Niccc8/rvbl2-riscv-cpu-core/chipinventor/NETLIST.md

# Wiring checklist - Stage 3

GENERATED by `scripts/gen_docs.py` from `ci_top.v` and `blocks/*.v` - do not hand-edit.

Two canvas projects. `rvbl2_soc` is the core, data memory and peripherals, built on a **copy** of the graded Phase 2 project and then placed as IP inside `top`, the chip. `scripts/check_export.py` audits the export of `top` against this document's source, wire by wire.

## Before you start

- **Copy the graded Phase 2 project first** and make every change on the copy. The platform keeps no version history.
- Name the SoC project exactly **`rvbl2_soc`**: the export names its module after the project, and both the checker and the FPGA wrapper expect that name.
- The canvas **cannot slice a bus** and **cannot draw a constant**. That is why `address_decoder` has `periph_chain_o` (a constant zero to start the read-back chain) and why `gpio_bits` exists.
- **Inout Pins: C is the data, D is the enable.** The platform writes `assign pin = D ? C : 1'bZ;`. Wire `gpio_bits.cN_o` to **C**, `gpio_bits.dN_o` to **D**, and the pin's right-hand terminal to `gpio_bits.pN_i`. A swap still compiles, so the checker tests it explicitly.
- `lsu`'s port names still read backwards: `mem_data_o` is an input, `core_data_i` an output.
- `rx_i` must idle high on the real chip; the testbench holds it high.

# Project 1: `rvbl2_soc`

## From the Phase 2 copy, in order

1. Delete the `imem` instance (its 3 wires go with it).
2. Create the new `address_decoder` block (BLOCK_METADATA.md: the Stage 3 Code and all 14 ports, 4 of them new), delete the old `u_decoder` instance (its wires go with it) and place the new block as `u_decoder`. Every wire on it is in the list below.
3. Create the blocks `gpio` and `uart` (BLOCK_METADATA.md) and place one of each. On the `uart` instance set **`CLK_FREQ_HZ = 30303030`**; leave every other parameter blank.
4. Add the pins: `imem_addr_o[31:0]` (output), `imem_oe_o` (output), `imem_rdata_i[31:0]` (input), `gpio_o[7:0]` (output), `gpio_oe[7:0]` (output), `gpio_i[7:0]` (input), `tx_o` (output), `rx_i` (input).
5. Draw the 33 connections below: the Stage 3 wires and every wire on `u_decoder`. Everything else stays as it was.

### The 33 connections to draw

| # | Net | Width | From | To |
|---:|---|---|---|---|
| 1 | `clk_i` | 1 bit | pin `clk_i` | `u_gpio.clk_i` |
| 2 | `clk_i` | 1 bit | pin `clk_i` | `u_uart.clk_i` |
| 3 | `core_address` | [31:0] | `u_muxaddr.z` | pin `imem_addr_o` |
| 4 | `core_address` | [31:0] | `u_muxaddr.z` | `u_decoder.address_i` |
| 5 | `core_address` | [31:0] | `u_muxaddr.z` | `u_gpio.bus_addr_i` |
| 6 | `core_address` | [31:0] | `u_muxaddr.z` | `u_uart.bus_addr_i` |
| 7 | `core_bw` | [3:0] | `u_lsu.byte_write_o` | `u_decoder.bw_i` |
| 8 | `core_oe` | 1 bit | `u_ctrl.oe_o` | `u_decoder.oe_i` |
| 9 | `core_store_data` | [31:0] | `u_lsu.store_data_o` | `u_gpio.bus_wdata_i` |
| 10 | `core_store_data` | [31:0] | `u_lsu.store_data_o` | `u_uart.bus_wdata_i` |
| 11 | `core_we` | 1 bit | `u_ctrl.we_o` | `u_decoder.we_i` |
| 12 | `dmem_bw` | [3:0] | `u_decoder.dmem_bw_o` | `u_dmem.bw_i` |
| 13 | `dmem_oe` | 1 bit | `u_decoder.dmem_oe_o` | `u_dmem.oe_i` |
| 14 | `dmem_rdata` | [31:0] | `u_dmem.data_o` | `u_decoder.dmem_rdata` |
| 15 | `dmem_we` | 1 bit | `u_decoder.dmem_we_o` | `u_dmem.we_i` |
| 16 | `gpio_i` | [7:0] | pin `gpio_i` | `u_gpio.gpio_i` |
| 17 | `gpio_o` | [7:0] | `u_gpio.gpio_o` | pin `gpio_o` |
| 18 | `gpio_oe` | [7:0] | `u_gpio.gpio_oe` | pin `gpio_oe` |
| 19 | `gpio_rdata` | [31:0] | `u_gpio.bus_rdata_o` | `u_uart.bus_rdata_i` |
| 20 | `imem_oe_o` | 1 bit | `u_decoder.imem_oe_o` | pin `imem_oe_o` |
| 21 | `imem_rdata_i` | [31:0] | pin `imem_rdata_i` | `u_decoder.imem_rdata` |
| 22 | `mem_rdata_muxed` | [31:0] | `u_decoder.data_o` | `u_ir.imem_data` |
| 23 | `mem_rdata_muxed` | [31:0] | `u_decoder.data_o` | `u_lsu.mem_data_o` |
| 24 | `periph_bw` | [3:0] | `u_decoder.periph_bw_o` | `u_gpio.bus_bw_i` |
| 25 | `periph_bw` | [3:0] | `u_decoder.periph_bw_o` | `u_uart.bus_bw_i` |
| 26 | `periph_chain_head` | [31:0] | `u_decoder.periph_chain_o` | `u_gpio.bus_rdata_i` |
| 27 | `periph_we` | 1 bit | `u_decoder.periph_we_o` | `u_gpio.bus_we_i` |
| 28 | `periph_we` | 1 bit | `u_decoder.periph_we_o` | `u_uart.bus_we_i` |
| 29 | `rst_i` | 1 bit | pin `rst_i` | `u_gpio.rst_i` |
| 30 | `rst_i` | 1 bit | pin `rst_i` | `u_uart.rst_i` |
| 31 | `rx_i` | 1 bit | pin `rx_i` | `u_uart.rx_i` |
| 32 | `tx_o` | 1 bit | `u_uart.tx_o` | pin `tx_o` |
| 33 | `uart_rdata` | [31:0] | `u_uart.bus_rdata_o` | `u_decoder.periph_rdata_i` |

### The whole project, for checking

## Block instances (21)

| Instance | Block | Parameters on the instance | Role |
|---|---|---|---|
| `u_ctrl` | `control_unit` | - | control FSM |
| `u_pc` | `pc_reg` | - | program counter |
| `u_pcinc` | `pc_incrementer` | - | PC+4 adder |
| `u_ir` | `ir_reg` | - | instruction register |
| `u_irf` | `ir_fields` | - | instruction field extractor |
| `u_imm` | `immediate_generator` | - | immediate generator |
| `u_rf` | `register_file` | - | register file |
| `u_muxa` | `mux2_32` | - | ALU operand A select (rs1 vs PC) |
| `u_muxb` | `mux2_32` | - | ALU operand B select (rs2 vs immediate) |
| `u_alu` | `alu` | - | arithmetic/logic unit |
| `u_bc` | `branch_comparator` | - | branch comparator |
| `u_mul` | `multiplier` | - | multiplier |
| `u_crc` | `crc_unit` | - | CRC unit |
| `u_lsu` | `lsu` | - | load/store unit |
| `u_wbmux` | `wb_mux_32` | - | writeback source select |
| `u_muxaddr` | `mux2_32` | - | memory address select (PC vs ALU result) |
| `u_muxpc` | `mux2_32` | - | next-PC select (PC+4 vs branch/jump target) |
| `u_decoder` | `address_decoder` | - | address decoder |
| `u_dmem` | `dmem` | DMEM_WORDS = 2048 | data memory |
| `u_gpio` | `gpio` (new) | - | GPIO controller, slot 0 (0xF0000000) |
| `u_uart` | `uart` (new) | CLK_FREQ_HZ = 30303030 | UART controller, slot 1 (0xF1000000) |

## Pins (10)

| Pin | Direction | Width |
|---|---|---|
| `clk_i` | input | 1 bit |
| `rst_i` | input | 1 bit |
| `imem_addr_o` | output | [31:0] |
| `imem_oe_o` | output | 1 bit |
| `imem_rdata_i` | input | [31:0] |
| `gpio_o` | output | [7:0] |
| `gpio_oe` | output | [7:0] |
| `gpio_i` | input | [7:0] |
| `tx_o` | output | 1 bit |
| `rx_i` | input | 1 bit |

## Wires (92 connections)

One row per connection: drag from the source to the destination.

| # | Net | Width | From | To |
|---:|---|---|---|---|
| 1 | `addr_src_sel` | 1 bit | `u_ctrl.addr_src_sel` | `u_muxaddr.s` |
| 2 | `alu_a` | [31:0] | `u_muxa.z` | `u_alu.a` |
| 3 | `alu_b` | [31:0] | `u_muxb.z` | `u_alu.b` |
| 4 | `alu_op` | [3:0] | `u_ctrl.alu_op` | `u_alu.alu_op` |
| 5 | `alu_result` | [31:0] | `u_alu.result` | `u_lsu.alu_result` |
| 6 | `alu_result` | [31:0] | `u_alu.result` | `u_muxaddr.b` |
| 7 | `alu_result` | [31:0] | `u_alu.result` | `u_muxpc.b` |
| 8 | `alu_result` | [31:0] | `u_alu.result` | `u_wbmux.alu_result` |
| 9 | `alu_src_a_sel` | 1 bit | `u_ctrl.alu_src_a_sel` | `u_muxa.s` |
| 10 | `alu_src_b_sel` | 1 bit | `u_ctrl.alu_src_b_sel` | `u_muxb.s` |
| 11 | `branch_taken` | 1 bit | `u_bc.branch_taken` | `u_ctrl.branch_taken` |
| 12 | `clk_i` | 1 bit | pin `clk_i` | `u_ctrl.clk_i` |
| 13 | `clk_i` | 1 bit | pin `clk_i` | `u_dmem.clk_i` |
| 14 | `clk_i` | 1 bit | pin `clk_i` | `u_gpio.clk_i` |
| 15 | `clk_i` | 1 bit | pin `clk_i` | `u_ir.clk_i` |
| 16 | `clk_i` | 1 bit | pin `clk_i` | `u_pc.clk_i` |
| 17 | `clk_i` | 1 bit | pin `clk_i` | `u_rf.clk_i` |
| 18 | `clk_i` | 1 bit | pin `clk_i` | `u_uart.clk_i` |
| 19 | `core_address` | [31:0] | `u_muxaddr.z` | pin `imem_addr_o` |
| 20 | `core_address` | [31:0] | `u_muxaddr.z` | `u_decoder.address_i` |
| 21 | `core_address` | [31:0] | `u_muxaddr.z` | `u_dmem.address_i` |
| 22 | `core_address` | [31:0] | `u_muxaddr.z` | `u_gpio.bus_addr_i` |
| 23 | `core_address` | [31:0] | `u_muxaddr.z` | `u_uart.bus_addr_i` |
| 24 | `core_bw` | [3:0] | `u_lsu.byte_write_o` | `u_decoder.bw_i` |
| 25 | `core_oe` | 1 bit | `u_ctrl.oe_o` | `u_decoder.oe_i` |
| 26 | `core_store_data` | [31:0] | `u_lsu.store_data_o` | `u_dmem.data_i` |
| 27 | `core_store_data` | [31:0] | `u_lsu.store_data_o` | `u_gpio.bus_wdata_i` |
| 28 | `core_store_data` | [31:0] | `u_lsu.store_data_o` | `u_uart.bus_wdata_i` |
| 29 | `core_we` | 1 bit | `u_ctrl.we_o` | `u_decoder.we_i` |
| 30 | `crc_result` | [31:0] | `u_crc.result` | `u_wbmux.crc_result` |
| 31 | `dmem_bw` | [3:0] | `u_decoder.dmem_bw_o` | `u_dmem.bw_i` |
| 32 | `dmem_oe` | 1 bit | `u_decoder.dmem_oe_o` | `u_dmem.oe_i` |
| 33 | `dmem_rdata` | [31:0] | `u_dmem.data_o` | `u_decoder.dmem_rdata` |
| 34 | `dmem_we` | 1 bit | `u_decoder.dmem_we_o` | `u_dmem.we_i` |
| 35 | `gpio_i` | [7:0] | pin `gpio_i` | `u_gpio.gpio_i` |
| 36 | `gpio_o` | [7:0] | `u_gpio.gpio_o` | pin `gpio_o` |
| 37 | `gpio_oe` | [7:0] | `u_gpio.gpio_oe` | pin `gpio_oe` |
| 38 | `gpio_rdata` | [31:0] | `u_gpio.bus_rdata_o` | `u_uart.bus_rdata_i` |
| 39 | `imem_oe_o` | 1 bit | `u_decoder.imem_oe_o` | pin `imem_oe_o` |
| 40 | `imem_rdata_i` | [31:0] | pin `imem_rdata_i` | `u_decoder.imem_rdata` |
| 41 | `imm` | [31:0] | `u_imm.imm` | `u_muxb.b` |
| 42 | `ir` | [31:0] | `u_ir.ir` | `u_ctrl.ir` |
| 43 | `ir` | [31:0] | `u_ir.ir` | `u_imm.ir` |
| 44 | `ir` | [31:0] | `u_ir.ir` | `u_irf.ir` |
| 45 | `ir_write` | 1 bit | `u_ctrl.ir_write` | `u_ir.ir_write` |
| 46 | `is_valid_store` | 1 bit | `u_ctrl.is_valid_store` | `u_lsu.is_valid_store` |
| 47 | `lsu_load_data` | [31:0] | `u_lsu.core_data_i` | `u_wbmux.lsu_load_data` |
| 48 | `mem_rdata_muxed` | [31:0] | `u_decoder.data_o` | `u_ir.imem_data` |
| 49 | `mem_rdata_muxed` | [31:0] | `u_decoder.data_o` | `u_lsu.mem_data_o` |
| 50 | `mult_result` | [31:0] | `u_mul.result` | `u_wbmux.mult_result` |
| 51 | `op_size` | [2:0] | `u_ctrl.op_size` | `u_bc.funct3` |
| 52 | `op_size` | [2:0] | `u_ctrl.op_size` | `u_crc.funct3` |
| 53 | `op_size` | [2:0] | `u_ctrl.op_size` | `u_lsu.op_size` |
| 54 | `op_size` | [2:0] | `u_ctrl.op_size` | `u_mul.funct3` |
| 55 | `pc` | [31:0] | `u_pc.pc` | `u_muxa.b` |
| 56 | `pc` | [31:0] | `u_pc.pc` | `u_muxaddr.a` |
| 57 | `pc` | [31:0] | `u_pc.pc` | `u_pcinc.pc` |
| 58 | `pc_next` | [31:0] | `u_muxpc.z` | `u_pc.pc_next` |
| 59 | `pc_plus_4` | [31:0] | `u_pcinc.pc_plus_4` | `u_muxpc.a` |
| 60 | `pc_plus_4` | [31:0] | `u_pcinc.pc_plus_4` | `u_wbmux.pc_plus_4` |
| 61 | `pc_src_sel` | 1 bit | `u_ctrl.pc_src_sel` | `u_muxpc.s` |
| 62 | `pc_write` | 1 bit | `u_ctrl.pc_write` | `u_pc.pc_write` |
| 63 | `periph_bw` | [3:0] | `u_decoder.periph_bw_o` | `u_gpio.bus_bw_i` |
| 64 | `periph_bw` | [3:0] | `u_decoder.periph_bw_o` | `u_uart.bus_bw_i` |
| 65 | `periph_chain_head` | [31:0] | `u_decoder.periph_chain_o` | `u_gpio.bus_rdata_i` |
| 66 | `periph_we` | 1 bit | `u_decoder.periph_we_o` | `u_gpio.bus_we_i` |
| 67 | `periph_we` | 1 bit | `u_decoder.periph_we_o` | `u_uart.bus_we_i` |
| 68 | `rd_addr` | [4:0] | `u_irf.rd_addr` | `u_rf.rd_addr` |
| 69 | `reg_write` | 1 bit | `u_ctrl.reg_write` | `u_rf.reg_write` |
| 70 | `rs1_addr` | [4:0] | `u_irf.rs1_addr` | `u_rf.rs1_addr` |
| 71 | `rs1_data` | [31:0] | `u_rf.rs1_data` | `u_bc.rs1_data` |
| 72 | `rs1_data` | [31:0] | `u_rf.rs1_data` | `u_crc.rs1_data` |
| 73 | `rs1_data` | [31:0] | `u_rf.rs1_data` | `u_mul.rs1_data` |
| 74 | `rs1_data` | [31:0] | `u_rf.rs1_data` | `u_muxa.a` |
| 75 | `rs2_addr` | [4:0] | `u_irf.rs2_addr` | `u_rf.rs2_addr` |
| 76 | `rs2_data` | [31:0] | `u_rf.rs2_data` | `u_bc.rs2_data` |
| 77 | `rs2_data` | [31:0] | `u_rf.rs2_data` | `u_crc.rs2_data` |
| 78 | `rs2_data` | [31:0] | `u_rf.rs2_data` | `u_lsu.rs2_data` |
| 79 | `rs2_data` | [31:0] | `u_rf.rs2_data` | `u_mul.rs2_data` |
| 80 | `rs2_data` | [31:0] | `u_rf.rs2_data` | `u_muxb.a` |
| 81 | `rst_i` | 1 bit | pin `rst_i` | `u_ctrl.rst_i` |
| 82 | `rst_i` | 1 bit | pin `rst_i` | `u_dmem.rst_i` |
| 83 | `rst_i` | 1 bit | pin `rst_i` | `u_gpio.rst_i` |
| 84 | `rst_i` | 1 bit | pin `rst_i` | `u_ir.rst_i` |
| 85 | `rst_i` | 1 bit | pin `rst_i` | `u_pc.rst_i` |
| 86 | `rst_i` | 1 bit | pin `rst_i` | `u_rf.rst_i` |
| 87 | `rst_i` | 1 bit | pin `rst_i` | `u_uart.rst_i` |
| 88 | `rx_i` | 1 bit | pin `rx_i` | `u_uart.rx_i` |
| 89 | `tx_o` | 1 bit | `u_uart.tx_o` | pin `tx_o` |
| 90 | `uart_rdata` | [31:0] | `u_uart.bus_rdata_o` | `u_decoder.periph_rdata_i` |
| 91 | `wb_data` | [31:0] | `u_wbmux.wb_data` | `u_rf.rd_data` |
| 92 | `wb_src_sel` | [2:0] | `u_ctrl.wb_src_sel` | `u_wbmux.wb_src_sel` |

Left unconnected on purpose (read by the testbench through the hierarchy): `u_ctrl.state_o`, `u_ctrl.sys_event_o`.

# Project 2: `top` (the chip)

A new project. Place `rvbl2_soc` (from the IP list), `imem` and `gpio_bits`. Add the pins below; `pins_io_0`..`pins_io_7` are **Inout Pins**, one per GPIO bit.

## Block instances (3)

| Instance | Block | Parameters on the instance | Role |
|---|---|---|---|
| `u_soc` | `rvbl2_soc` | - | the SoC project, placed as IP |
| `u_imem` | `imem` | - | instruction ROM |
| `u_bits` | `gpio_bits` (new) | - | GPIO bus-to-pin splitter |

## Pins (12)

| Pin | Direction | Width |
|---|---|---|
| `clk_i` | input | 1 bit |
| `rst_i` | input | 1 bit |
| `pins_io_0` | inout | 1 bit |
| `pins_io_1` | inout | 1 bit |
| `pins_io_2` | inout | 1 bit |
| `pins_io_3` | inout | 1 bit |
| `pins_io_4` | inout | 1 bit |
| `pins_io_5` | inout | 1 bit |
| `pins_io_6` | inout | 1 bit |
| `pins_io_7` | inout | 1 bit |
| `tx_o` | output | 1 bit |
| `rx_i` | input | 1 bit |

## Wires (34 connections)

One row per connection: drag from the source to the destination.

| # | Net | Width | From | To |
|---:|---|---|---|---|
| 1 | `c0` | 1 bit | `u_bits.c0_o` | pin `pins_io_0` **C** (data) |
| 2 | `c1` | 1 bit | `u_bits.c1_o` | pin `pins_io_1` **C** (data) |
| 3 | `c2` | 1 bit | `u_bits.c2_o` | pin `pins_io_2` **C** (data) |
| 4 | `c3` | 1 bit | `u_bits.c3_o` | pin `pins_io_3` **C** (data) |
| 5 | `c4` | 1 bit | `u_bits.c4_o` | pin `pins_io_4` **C** (data) |
| 6 | `c5` | 1 bit | `u_bits.c5_o` | pin `pins_io_5` **C** (data) |
| 7 | `c6` | 1 bit | `u_bits.c6_o` | pin `pins_io_6` **C** (data) |
| 8 | `c7` | 1 bit | `u_bits.c7_o` | pin `pins_io_7` **C** (data) |
| 9 | `clk_i` | 1 bit | pin `clk_i` | `u_soc.clk_i` |
| 10 | `d0` | 1 bit | `u_bits.d0_o` | pin `pins_io_0` **D** (enable) |
| 11 | `d1` | 1 bit | `u_bits.d1_o` | pin `pins_io_1` **D** (enable) |
| 12 | `d2` | 1 bit | `u_bits.d2_o` | pin `pins_io_2` **D** (enable) |
| 13 | `d3` | 1 bit | `u_bits.d3_o` | pin `pins_io_3` **D** (enable) |
| 14 | `d4` | 1 bit | `u_bits.d4_o` | pin `pins_io_4` **D** (enable) |
| 15 | `d5` | 1 bit | `u_bits.d5_o` | pin `pins_io_5` **D** (enable) |
| 16 | `d6` | 1 bit | `u_bits.d6_o` | pin `pins_io_6` **D** (enable) |
| 17 | `d7` | 1 bit | `u_bits.d7_o` | pin `pins_io_7` **D** (enable) |
| 18 | `gpio_i` | [7:0] | `u_bits.gpio_i` | `u_soc.gpio_i` |
| 19 | `gpio_o` | [7:0] | `u_soc.gpio_o` | `u_bits.gpio_o` |
| 20 | `gpio_oe` | [7:0] | `u_soc.gpio_oe` | `u_bits.gpio_oe` |
| 21 | `imem_addr` | [31:0] | `u_soc.imem_addr_o` | `u_imem.address_i` |
| 22 | `imem_oe` | 1 bit | `u_soc.imem_oe_o` | `u_imem.oe_i` |
| 23 | `imem_rdata` | [31:0] | `u_imem.data_o` | `u_soc.imem_rdata_i` |
| 24 | `pins_io_0` | 1 bit | pin `pins_io_0` | `u_bits.p0_i` |
| 25 | `pins_io_1` | 1 bit | pin `pins_io_1` | `u_bits.p1_i` |
| 26 | `pins_io_2` | 1 bit | pin `pins_io_2` | `u_bits.p2_i` |
| 27 | `pins_io_3` | 1 bit | pin `pins_io_3` | `u_bits.p3_i` |
| 28 | `pins_io_4` | 1 bit | pin `pins_io_4` | `u_bits.p4_i` |
| 29 | `pins_io_5` | 1 bit | pin `pins_io_5` | `u_bits.p5_i` |
| 30 | `pins_io_6` | 1 bit | pin `pins_io_6` | `u_bits.p6_i` |
| 31 | `pins_io_7` | 1 bit | pin `pins_io_7` | `u_bits.p7_i` |
| 32 | `rst_i` | 1 bit | pin `rst_i` | `u_soc.rst_i` |
| 33 | `rx_i` | 1 bit | pin `rx_i` | `u_soc.rx_i` |
| 34 | `tx_o` | 1 bit | `u_soc.tx_o` | pin `tx_o` |

## Totals

| | `rvbl2_soc` | `top` |
|---|---:|---:|
| Block instances | 21 | 3 |
| Pins | 10 | 12 |
| Connections | 92 | 34 |
| To draw in Stage 3 | 33 | 34 |
