Niccc8/rvbl2-riscv-cpu-core/docs/stage4/HANDOFF.md

# Stage 4 state (read this first in a new session)

**Updated 2026-10-15.** Branch `stage4` (local, not pushed). Mission: harden LaneX, build the pitch
intelligence, ship a first-try-correct AWS F2 build. **GATE 1 and 2 passed; GATE 3 verdict GO (re-confirmed
after the 31.25 MHz change: pre-flight GO, full regression green).**
**AWS build done 2026-10-10: `afi-0732c3cb90c96019a` / `agfi-0c12a9e5d082dcac8`** (0 errors; setup WNS −0.112 ns on
the pin-synchroniser crossing only, hold met; `06` §1b). **On the board: bring-up ladder and all 12 emu lines
PASS on the first build (`06` §1c).** Claim earned: "FPGA-validated prototype".
**DE10-Lite desk lane (Tier 1) built 2026-10-11** (`stage4/de10lite/`, start at its README): one HC-SR04
ultrasonic sensor (rescoped from two IR beams: the sensor Nicholas has), USB-UART + LaneX Live dashboard.
Verified in simulation (`06` §1d) and compiled in Quartus 25.1std.0 on Nicholas's laptop (0 errors, timing
met +4.44 ns at 31.25 MHz). **On the board (11 Oct): `Id.56dE` and `PASS12` work**; his flicker report fixed and
the board hardened (`06` §1d round 2: 1,291 simulated checks). Next: his bench procedure,
`stage4/de10lite/lab_brief.html` E1–E10 (also published: https://claude.ai/artifact/1geGwAnsMETUvzNhbt8Chj).
**15 Oct, round 3 (`06` §1d round 3):** at E5 his empty lane made 1.6 cm phantom vehicles (`no tAG`
over and over): the floor ratchet took a stray far echo as the floor. The lane now filters (median of 3),
learns the floor by agreement, arms only after seeing it, ignores lost (farther) echoes; a noisy
HC-SR04 model in `tb_board.v` (`G 1 seed`) reproduces the fault on the old RTL (23 phantoms in 94 s)
and none on the new. Also: GPIO9 = header pin 10 plays a 2.4 kHz tone for a **passive** buzzer (his
unmarked one: green board visible underneath); his TMB12A05 is **active** (pin 8). His USB-UART is a
Cytron UC00C (CH340): switch at 3.3 V, TXO → pin 1, RXI → pin 2, GND → pin 12. The dashboard is
`stage4/de10lite/lanex_live.html`; `dashboard/lanex_live.src.html` is the template (now says so).
**Never run `gen_de10lite.py` without `--check`: it rewrites `lanex.qsf`, which his Quartus has edited**;
write single outputs from `gen_de10lite.outputs()` instead.
**On the board (15 Oct): the whole desk lane works** - vehicle detection with the HC-SR04, the four lamps, the buzzer, and the USB-UART link to LaneX Live, which verifies every record (Nicholas, after round 3).
**Pitch material is local only (git-ignored, never pushed: the repository is public):** the Grand Final
deck `presentation/stage4/LaneX_Final.pptx` (rebuild: `scripts/stage4/pitch/build_all.ps1`), the script and
demo-day plan `docs/stage4/pitch/`, the market and event research `docs/stage4/03_market.md`,
`docs/stage4/research/`, `docs/stage4/roi_model.py`.

## Where everything is

| What | Where |
| --- | --- |
| AWS ground truth (guide PDF, organisers' `top.sv`, `emu.c`) | `01_aws_reference.md` |
| Audit, its approved scope and outcome | `02_audit.md` (§J outcome) |
| Market, event, ROI (local only) | `03_market.md`, `research/A–D`, `roi_model.py` |
| FPGA design (as built) | `04_fpga_plan.md` |
| **Runbook for the AWS session** | **`05_RUNBOOK.md`** |
| Verification evidence | `06_verification.md` |
| DE10-Lite desk lane (Tier 1) | `07_max10_prototype.md` (as built); **`stage4/de10lite/README.md`** (your steps, demo, troubleshooting) |
| Quartus Prime Lite install + programming guide | `08_quartus_setup.md` (installed: `C:\altera_lite\25.1std`, 25.1std.0) |
| Desk-lane generator, checks | `scripts/stage4/gen_de10lite.py` (`--check`), `stage4/de10lite/sim/check_board.py`, `stage4/de10lite/dashboard/test_live.py` |
| Pitch kit (local only) | `pitch/01–05` (Stage 4 planning); **final: `pitch/06_final_script.md`, `pitch/07_demo_day.md`, deck generator `scripts/stage4/pitch/`** |
| AWS run screenshots + recording (for slides) | `stage4/evidence/` (index in its README; the 270 MB recording and the unredacted screenshot are local only, git-excluded) |
| Build files | `stage4/riscv.sv` (31.25 MHz, the build), `riscv_15mhz.sv`, `riscv_bufgce_div.sv` (backups) |
| Generator, gate | `scripts/stage4/gen_riscv_sv.py`, `scripts/stage4/preflight.sh` |
| Organisers' files (not in git) | `stage4/vendor/` (fetch: `stage4/README.md`) |

## Decisions (and why)

- GATE 1: approved B1, B2, C1, C2, C3, C5(a) + all P0 (`02_audit.md`).
- GATE 2: MMCM divider inside `RISCV`, `top.sv` unchanged; build before 13 Oct; the organisers'
  echo test line need not pass on our firmware.
- Clock 31.25 MHz (÷8), Nicholas's preference and the ASIC's own clock; estimated path 11–18 ns of
  32 ns; 15.625 MHz kept as a pre-verified backup.
- DE10-Lite: one ultrasonic sensor over the lane classifies by height (car/lorry, `TALL_MM` 60 in
  `lanex.qsf`); its 5 V Echo goes through a 1k/2k divider. The fabric is test equipment only; the chip is
  generated by the AWS generator's own code (`gen_riscv_sv.chip_modules`, target `de10lite`).
- Firmware: the vehicle detector arms once the lane is seen empty (emu's start-up window floats
  pin 0; without this a pin read as 1 made phantom vehicles).

## Working rules learned the hard way

- Sessions end without warning: keep tool calls < ~5 min; launch long jobs with `nohup … &` on the
  Windows side (they survive); WSL jobs started from a background Git Bash also survive.
- `wsl.exe -- bash -lc "…"` re-parses the command in a shell: pass absolute paths, no `$VARS` meant
  for the inner shell. Git Bash heredocs mangle backslashes: write patch scripts with the Write tool.
- Never edit a running bash script (bash reads it incrementally).
- Commits: author Nicholas only, no co-author line; explicit paths; never push without asking.
- Tools: Windows — iverilog 12, xPack RISC-V GCC 13.2 (`~/tools`, `python3` shim in `~/tools/bin`);
  WSL Ubuntu-24.04 — Verilator 5.020, Yosys 0.33, gcc. **Quartus Prime Lite 25.1std.0 at
  `C:\altera_lite\25.1std`** (compile in a copy under `build/`, never program the board yourself). No Vivado.
- Board simulation: Verilator via `check_board.py` (Icarus is ~370x slower). The testbench's stimulus
  waits for events: start waiting before the event can happen (a missed record = TIMEOUT).

## Key facts not to re-derive

- `top.sv` gives `RISCV` `clk_main_a0` = 250 MHz; wrapper UARTs 2,170 clocks/bit; `riscv_nreset`
  resets to 1. emu: 50 ms before every AXI access; each run sets `-d 0x01`, pulses RST 1/0/1;
  `-d` uninverted (1 = chip output); `-t` polls `0x0C` bit 8 (sticky `o_Tx_Done`); `o_Rx_Done` a
  one-cycle pulse; `-r` reads the circular 8-byte window (the last 8 bytes); exit status inverted.
- Firmware 2,793 words; `I` record CRC `0x56DE`; PC range `0x00400000–0x00402BA4`.
- The ChipInventor platform export still holds the Stage 3 (v3) ROM (`chipinventor/app/imem_app_stage3.v`);
  `run_ci.sh` swaps the v4 ROM in for its tests.
