Niccc8/rvbl2-riscv-cpu-core/chipinventor/BLOCK_METADATA.md

# Block form fields

GENERATED by `scripts/gen_docs.py` from `blocks/*.v` - do not hand-edit.

One section per block, giving exactly what goes in each field of ChipInventor's Add Block
dialog. Paste the matching file from `blocks/` into the Code field; nothing in those files
needs editing or trimming first. Blocks marked **new** or **changed** are the Stage 3 work;
every other block is exactly as in the Phase 2 project.

Author and Icon are yours to set. Leave Validate, Block Width, Block Technology and the
two HDL-Specific fields empty unless the platform asks for them.

## `address_decoder` (changed)

```
Name:               address_decoder
Description:        Routes the memory transaction to IMEM, DMEM or the peripherals
Code:               paste blocks/address_decoder.v
Number of Inputs:   7
Inputs:             address_i[31:0], we_i, oe_i, bw_i[3:0], imem_rdata[31:0], dmem_rdata[31:0], periph_rdata_i[31:0]
Number of Outputs:  8
Outputs:            imem_oe_o, dmem_we_o, dmem_oe_o, dmem_bw_o[3:0], periph_we_o, periph_bw_o[3:0], periph_chain_o[31:0], data_o[31:0]
Number of Inouts:   0
Inouts:             (none)
Parameters:         (none)
```

Placed 1 time.

> **Changed in Stage 3:** four new ports for the peripheral region 0xF0000000-0xFFFFFFFF.
> Make it as a new block with these fields, replace the `u_decoder` instance, and redraw
> all of its wires (NETLIST.md lists them).

## `alu`

```
Name:               alu
Description:        Purely combinational ALU, 11 operations (Table 9)
Code:               paste blocks/alu.v
Number of Inputs:   3
Inputs:             a[31:0], b[31:0], alu_op[3:0]
Number of Outputs:  1
Outputs:            result[31:0]
Number of Inouts:   0
Inouts:             (none)
Parameters:         (none)
```

Placed 1 time.

## `branch_comparator`

```
Name:               branch_comparator
Description:        Evaluates the 6 RV32I branch conditions
Code:               paste blocks/branch_comparator.v
Number of Inputs:   3
Inputs:             rs1_data[31:0], rs2_data[31:0], funct3[2:0]
Number of Outputs:  1
Outputs:            branch_taken
Number of Inouts:   0
Inouts:             (none)
Parameters:         (none)
```

Placed 1 time.

## `control_unit`

```
Name:               control_unit
Description:        6-state FSM and every datapath control signal
Code:               paste blocks/control_unit.v
Number of Inputs:   4
Inputs:             clk_i, rst_i, ir[31:0], branch_taken
Number of Outputs:  15
Outputs:            state_o[2:0], alu_src_a_sel, alu_src_b_sel, alu_op[3:0], addr_src_sel, wb_src_sel[2:0], pc_src_sel, pc_write, reg_write, we_o, oe_o, ir_write, sys_event_o, is_valid_store, op_size[2:0]
Number of Inouts:   0
Inouts:             (none)
Parameters:         (none)
```

Placed 1 time.

## `crc_unit`

```
Name:               crc_unit
Description:        CRC-16/CCITT-FALSE over 8/16/32 bits (Xicrc, Table 11)
Code:               paste blocks/crc_unit.v
Number of Inputs:   3
Inputs:             rs1_data[31:0], rs2_data[31:0], funct3[2:0]
Number of Outputs:  1
Outputs:            result[31:0]
Number of Inouts:   0
Inouts:             (none)
Parameters:         (none)
```

Placed 1 time.

> **Operand order:** `rs1_data` is the **data**, `rs2_data` the **running CRC** - the order
> the official firmware uses. Do not swap the two wires.

## `dmem`

```
Name:               dmem
Description:        Data SRAM, synchronous read and byte-writable write
Code:               paste blocks/dmem.v
Number of Inputs:   7
Inputs:             clk_i, rst_i, address_i[31:0], we_i, oe_i, bw_i[3:0], data_i[31:0]
Number of Outputs:  1
Outputs:            data_o[31:0]
Number of Inouts:   0
Inouts:             (none)
Parameters:         DMEM_WORDS = 2048
```

Placed 1 time.

> `DMEM_WORDS` is the resize knob: 2048 is the full 8 kB. 1024 or 512 work with no other
> change: the block reads 0 and writes nothing above the instantiated array.

## `gpio` (new)

```
Name:               gpio
Description:        GPIO PIN controller: DATAOUT, DATAIN, DATADIR at 0xF0000000
Code:               paste blocks/gpio.v
Number of Inputs:   8
Inputs:             clk_i, rst_i, bus_addr_i[31:0], bus_wdata_i[31:0], bus_we_i, bus_bw_i[3:0], bus_rdata_i[31:0], gpio_i[7:0]
Number of Outputs:  3
Outputs:            bus_rdata_o[31:0], gpio_o[7:0], gpio_oe[7:0]
Number of Inouts:   0
Inouts:             (none)
Parameters:         SLOT = 4'd0, N_PINS = 8
```

Placed 1 time.

> Ports are written `[N_PINS-1:0]` in the code; with the default `N_PINS = 8` they are the
> 8-bit ports listed above. Leave `SLOT` and `N_PINS` blank on the instance.

## `gpio_bits` (new)

```
Name:               gpio_bits
Description:        Splits the GPIO buses into the 8 Inout Pins' C, D and pad bits
Code:               paste blocks/gpio_bits.v
Number of Inputs:   10
Inputs:             gpio_o[7:0], gpio_oe[7:0], p0_i, p1_i, p2_i, p3_i, p4_i, p5_i, p6_i, p7_i
Number of Outputs:  17
Outputs:            gpio_i[7:0], c0_o, d0_o, c1_o, d1_o, c2_o, d2_o, c3_o, d3_o, c4_o, d4_o, c5_o, d5_o, c6_o, d6_o, c7_o, d7_o
Number of Inouts:   0
Inouts:             (none)
Parameters:         (none)
```

Placed 1 time.

> Wiring only. For each pin N: `cN_o` -> the Inout Pin's **C**, `dN_o` -> its **D**,
> and the pin's right-hand terminal -> `pN_i`.

## `imem`

```
Name:               imem
Description:        Instruction/constant ROM, combinational read
Code:               paste blocks/imem.v
Number of Inputs:   2
Inputs:             address_i[31:0], oe_i
Number of Outputs:  1
Outputs:            data_o[31:0]
Number of Inouts:   0
Inouts:             (none)
Parameters:         (none)
```

Placed 1 time.

> Placed in `top`, not in the SoC. **For the OpenLane / P&R run, paste `blocks/imem_mock.v`
> into this same block instead** - same module name and ports, so only the Code field changes.

## `immediate_generator`

```
Name:               immediate_generator
Description:        Extracts and sign-extends I/S/B/U/J immediates
Code:               paste blocks/immediate_generator.v
Number of Inputs:   1
Inputs:             ir[31:0]
Number of Outputs:  1
Outputs:            imm[31:0]
Number of Inouts:   0
Inouts:             (none)
Parameters:         (none)
```

Placed 1 time.

## `ir_fields`

```
Name:               ir_fields
Description:        Extracts rs1/rs2/rd register addresses from the instruction
Code:               paste blocks/ir_fields.v
Number of Inputs:   1
Inputs:             ir[31:0]
Number of Outputs:  3
Outputs:            rs1_addr[4:0], rs2_addr[4:0], rd_addr[4:0]
Number of Inouts:   0
Inouts:             (none)
Parameters:         (none)
```

Placed 1 time.

## `ir_reg`

```
Name:               ir_reg
Description:        Instruction register, loaded once per instruction
Code:               paste blocks/ir_reg.v
Number of Inputs:   4
Inputs:             clk_i, rst_i, ir_write, imem_data[31:0]
Number of Outputs:  1
Outputs:            ir[31:0]
Number of Inouts:   0
Inouts:             (none)
Parameters:         (none)
```

Placed 1 time.

## `lsu`

```
Name:               lsu
Description:        Load/store unit: byte lanes, sign extension, write strobes
Code:               paste blocks/lsu.v
Number of Inputs:   5
Inputs:             alu_result[31:0], rs2_data[31:0], op_size[2:0], is_valid_store, mem_data_o[31:0]
Number of Outputs:  3
Outputs:            core_data_i[31:0], byte_write_o[3:0], store_data_o[31:0]
Number of Inouts:   0
Inouts:             (none)
Parameters:         (none)
```

Placed 1 time.

> **Careful:** `mem_data_o` is an **input** and `core_data_i` is an **output**. The names
> read backwards; the directions above are correct.

## `multiplier`

```
Name:               multiplier
Description:        MUL/MULH/MULHSU/MULHU, combinational (Zmmul, Table 10)
Code:               paste blocks/multiplier.v
Number of Inputs:   3
Inputs:             rs1_data[31:0], rs2_data[31:0], funct3[2:0]
Number of Outputs:  1
Outputs:            result[31:0]
Number of Inouts:   0
Inouts:             (none)
Parameters:         (none)
```

Placed 1 time.

## `mux2_32`

```
Name:               mux2_32
Description:        Generic 2-to-1 32-bit multiplexer
Code:               paste blocks/mux2_32.v
Number of Inputs:   3
Inputs:             a[31:0], b[31:0], s
Number of Outputs:  1
Outputs:            z[31:0]
Number of Inouts:   0
Inouts:             (none)
Parameters:         (none)
```

Placed 4 times.

## `pc_incrementer`

```
Name:               pc_incrementer
Description:        Dedicated PC+4 adder, separate from the ALU
Code:               paste blocks/pc_incrementer.v
Number of Inputs:   1
Inputs:             pc[31:0]
Number of Outputs:  1
Outputs:            pc_plus_4[31:0]
Number of Inouts:   0
Inouts:             (none)
Parameters:         (none)
```

Placed 1 time.

## `pc_reg`

```
Name:               pc_reg
Description:        Program counter, reset vector 0x00400000
Code:               paste blocks/pc_reg.v
Number of Inputs:   4
Inputs:             clk_i, rst_i, pc_write, pc_next[31:0]
Number of Outputs:  1
Outputs:            pc[31:0]
Number of Inouts:   0
Inouts:             (none)
Parameters:         (none)
```

Placed 1 time.

## `register_file`

```
Name:               register_file
Description:        32 x 32-bit GPRs, x0 hardwired zero, async read
Code:               paste blocks/register_file.v
Number of Inputs:   7
Inputs:             clk_i, rst_i, rs1_addr[4:0], rs2_addr[4:0], rd_addr[4:0], rd_data[31:0], reg_write
Number of Outputs:  2
Outputs:            rs1_data[31:0], rs2_data[31:0]
Number of Inouts:   0
Inouts:             (none)
Parameters:         (none)
```

Placed 1 time.

## `uart` (new)

```
Name:               uart
Description:        UART serial controller, 8-N-1, 115200 bps, at 0xF1000000
Code:               paste blocks/uart.v
Number of Inputs:   8
Inputs:             clk_i, rst_i, bus_addr_i[31:0], bus_wdata_i[31:0], bus_we_i, bus_bw_i[3:0], bus_rdata_i[31:0], rx_i
Number of Outputs:  2
Outputs:            bus_rdata_o[31:0], tx_o
Number of Inouts:   0
Inouts:             (none)
Parameters:         SLOT = 4'd1, CLK_FREQ_HZ = 30303030, BAUD_RATE = 115200
```

Placed 1 time.

> Set **`CLK_FREQ_HZ = 30303030`** on the instance (the 33 ns clock); leave `SLOT` and
> `BAUD_RATE` blank. The divisor is round(30303030 / 115200) = 263 clocks per bit.

## `wb_mux_32`

```
Name:               wb_mux_32
Description:        Writeback source multiplexer, 5 inputs
Code:               paste blocks/wb_mux_32.v
Number of Inputs:   6
Inputs:             alu_result[31:0], mult_result[31:0], crc_result[31:0], lsu_load_data[31:0], pc_plus_4[31:0], wb_src_sel[2:0]
Number of Outputs:  1
Outputs:            wb_data[31:0]
Number of Inouts:   0
Inouts:             (none)
Parameters:         (none)
```

Placed 1 time.
