Niccc8/rvbl2-riscv-cpu-core/report-stage2/figures/ci_run.png

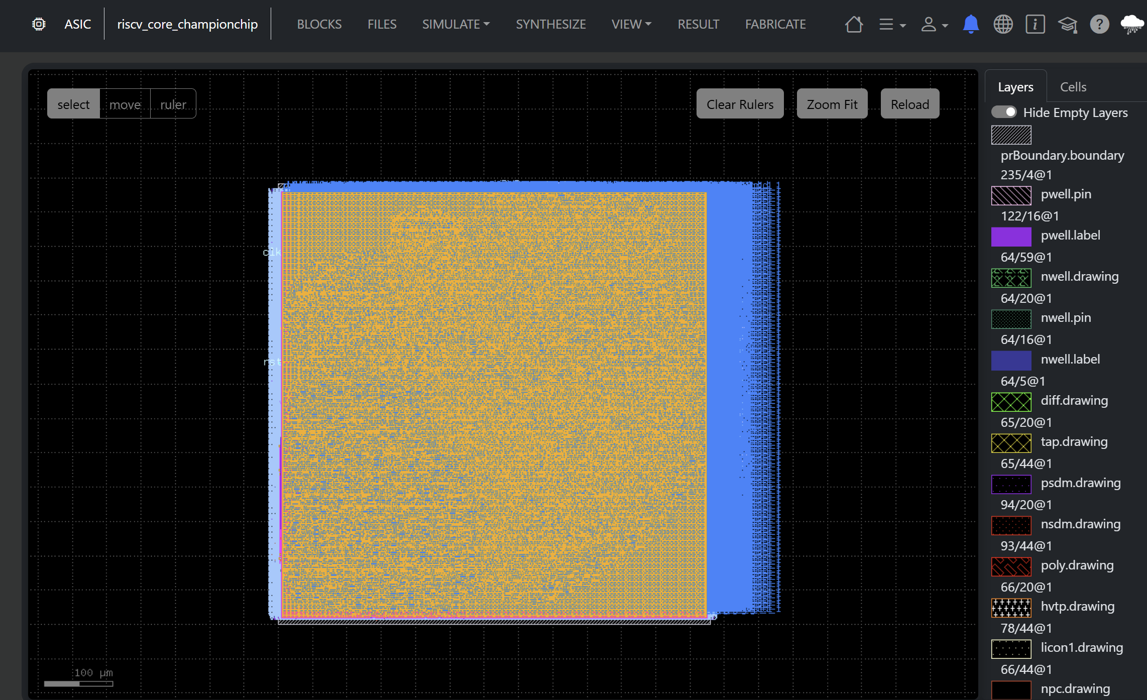
report-stage2/figures/ci_run.png
