Niccc8/rvbl2-riscv-cpu-core/report-stage2/figures/gds_layout.png

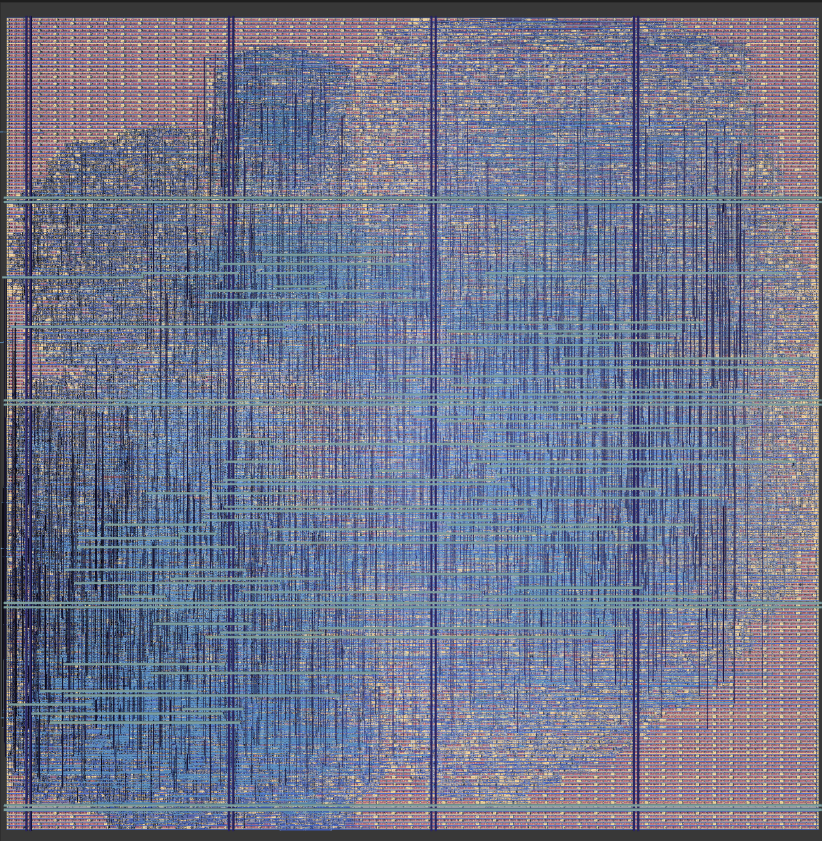
report-stage2/figures/gds_layout.png
