Niccc8/rvbl2-riscv-cpu-core/report-stage2/figures/openroad_heatmap.png

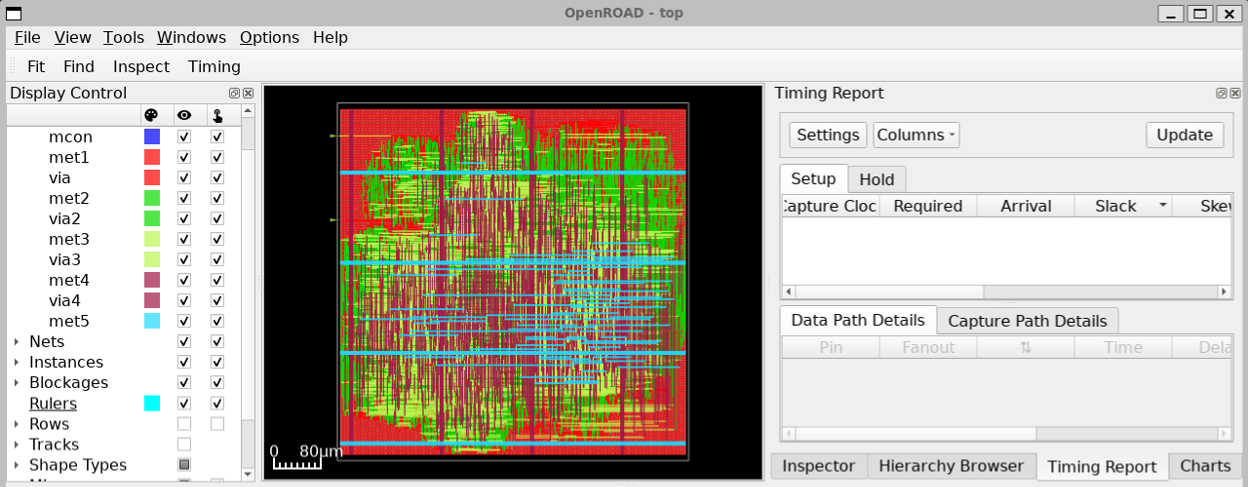
report-stage2/figures/openroad_heatmap.png
