Niccc8/rvbl2-riscv-cpu-core/report-stage2/figures/platform_tb_pass_log.png

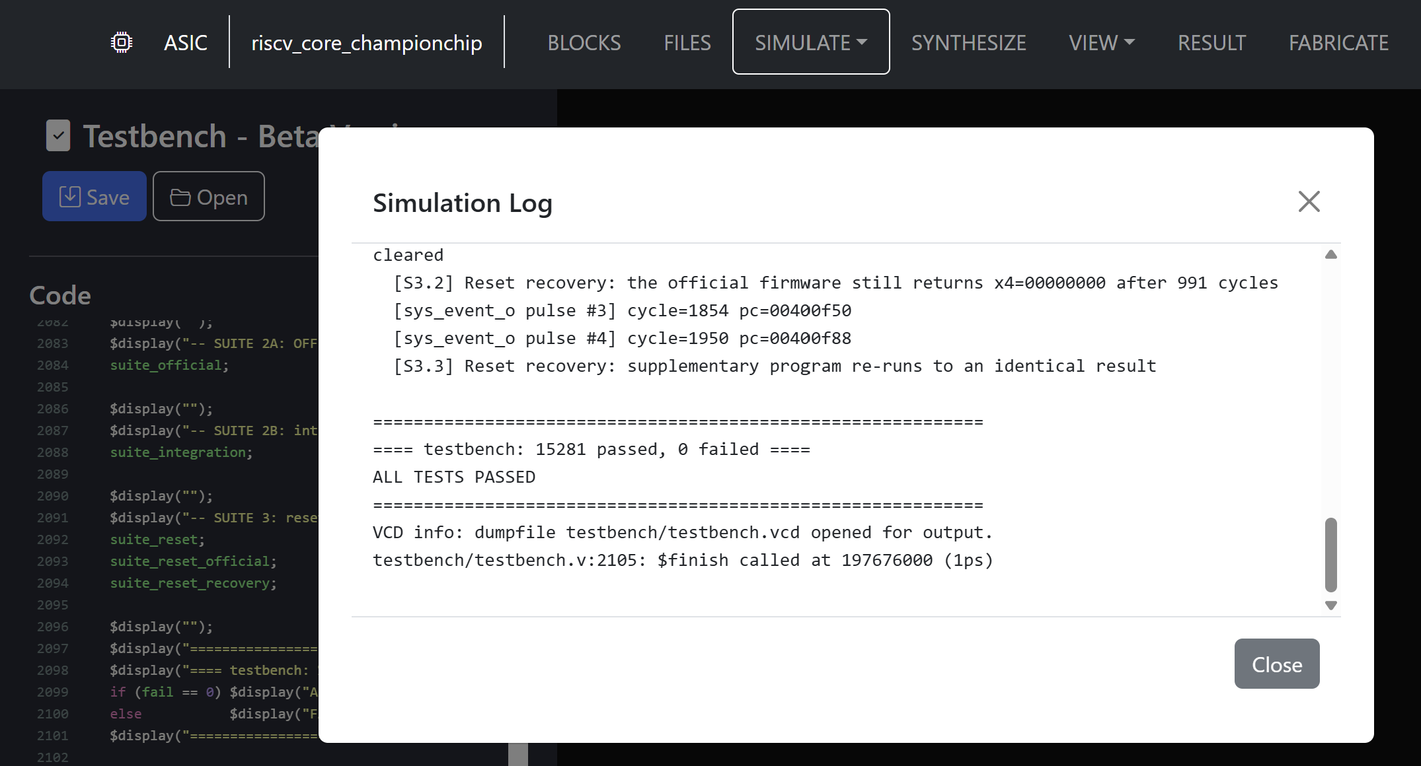
report-stage2/figures/platform_tb_pass_log.png
