Niccc8/rvbl2-riscv-cpu-core/report-stage2/figures/soc-architecture.png

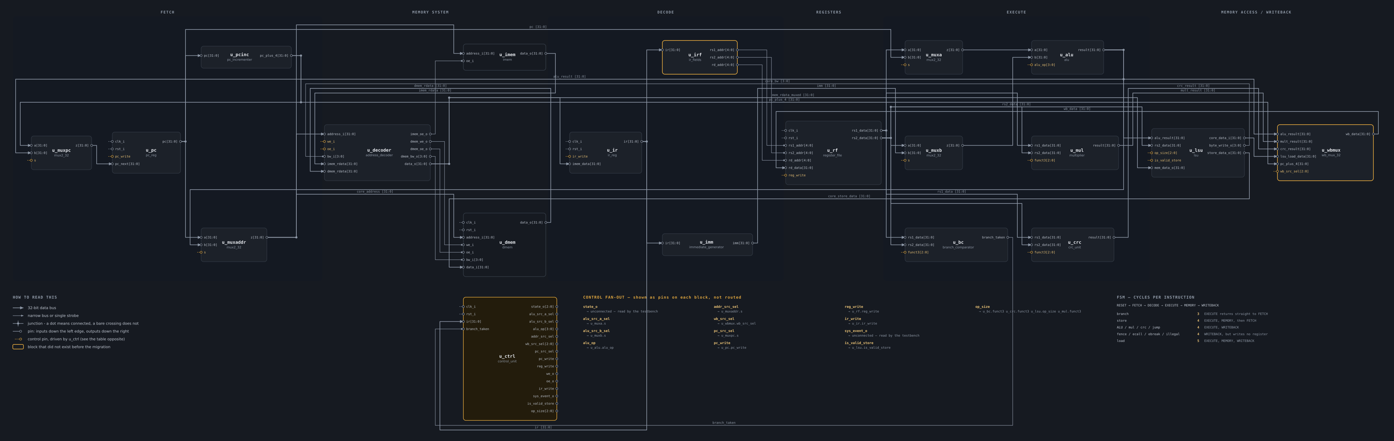
report-stage2/figures/soc-architecture.png
