Niccc8/rvbl2-riscv-cpu-core/report-stage2/figures/wave_firmware.png

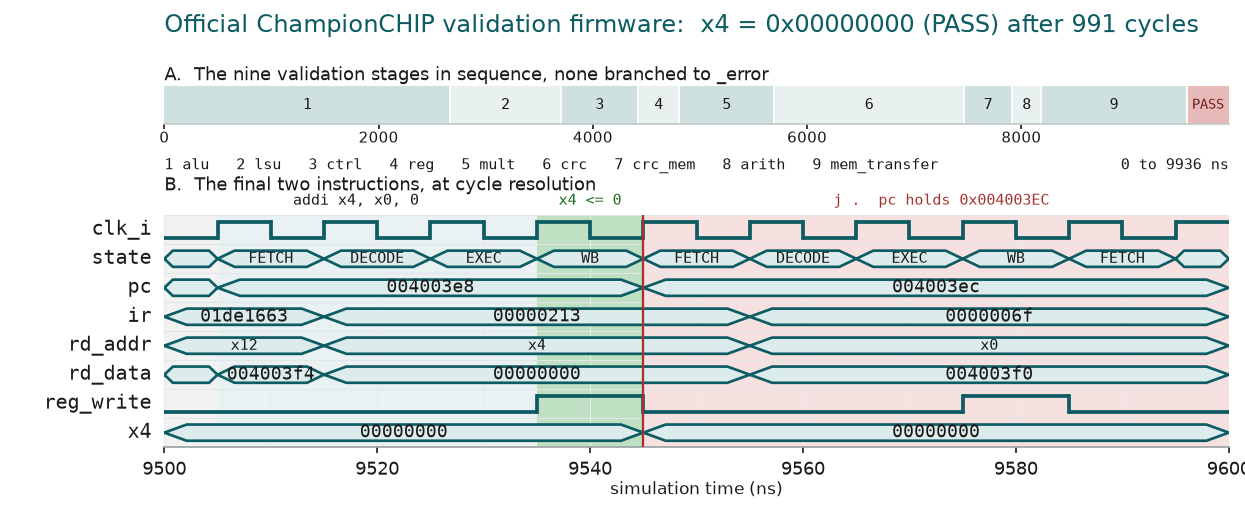
report-stage2/figures/wave_firmware.png
