Niccc8/rvbl2-riscv-cpu-core/report-stage3/figures/architecture/top_architecture.png

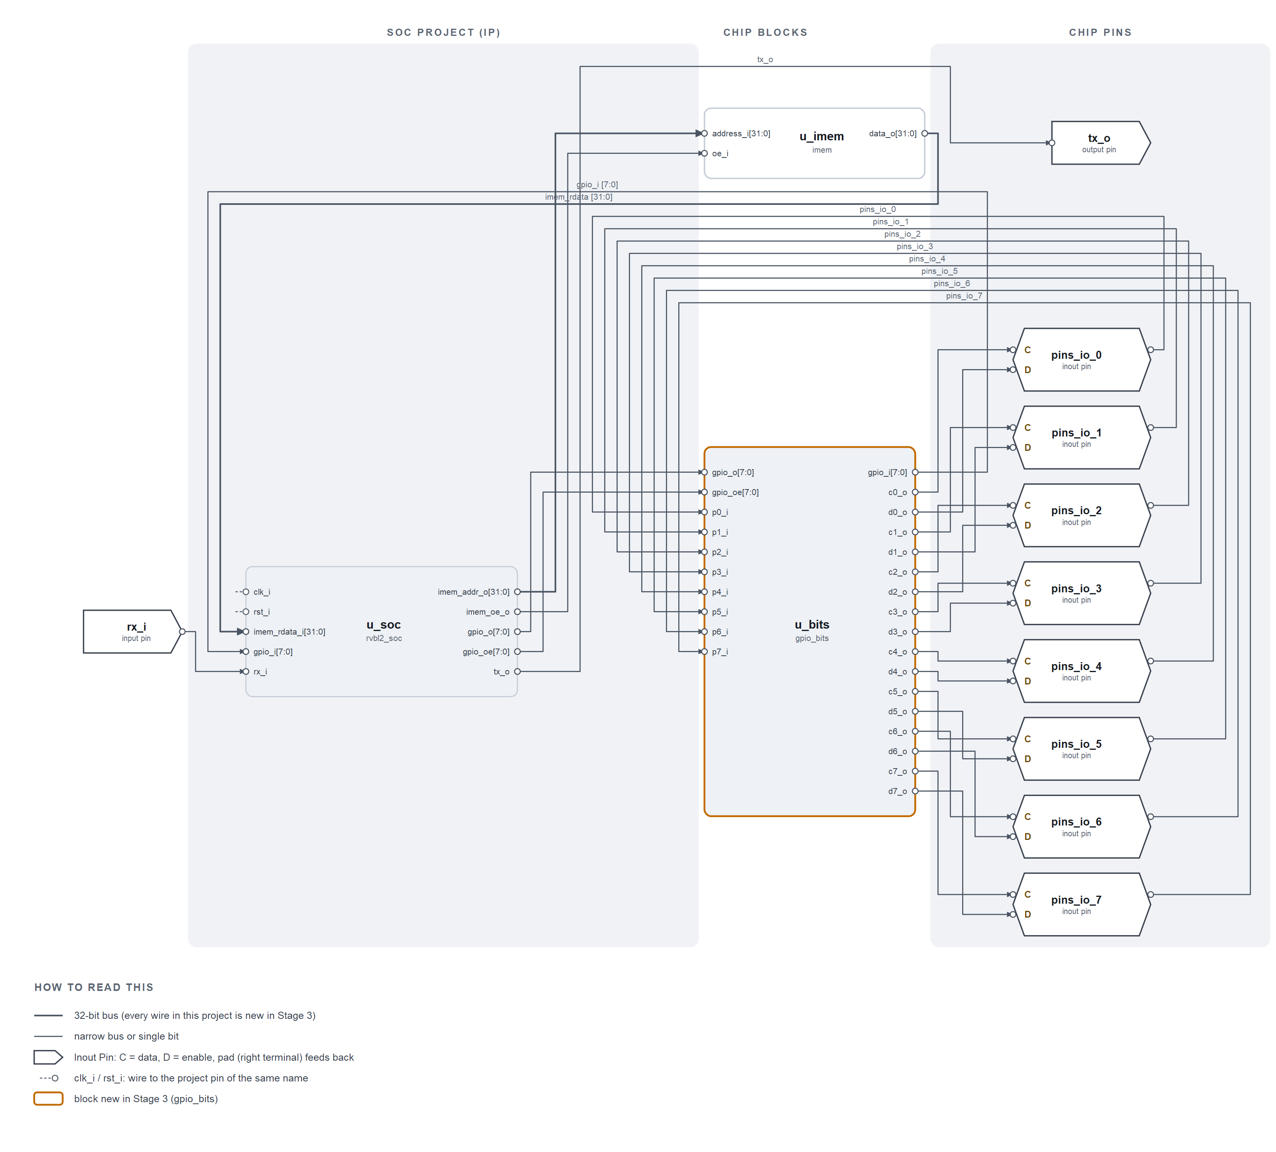
report-stage3/figures/architecture/top_architecture.png
