Niccc8/rvbl2-riscv-cpu-core/report-stage3/figures/ci_soc_blocks.png

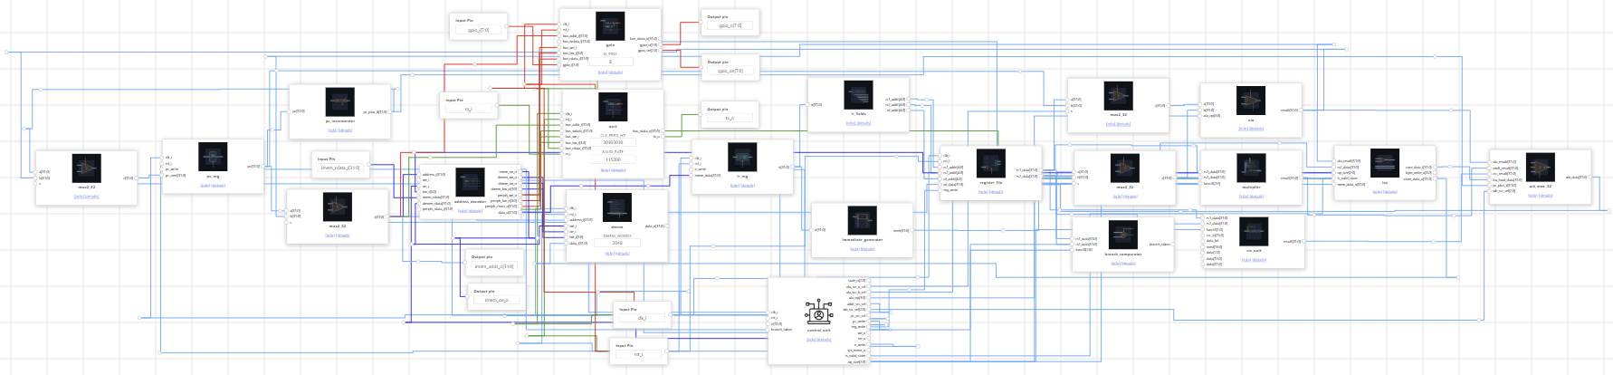
report-stage3/figures/ci_soc_blocks.png
