Niccc8/rvbl2-riscv-cpu-core/report-stage3/figures/ci_top_blocks.png

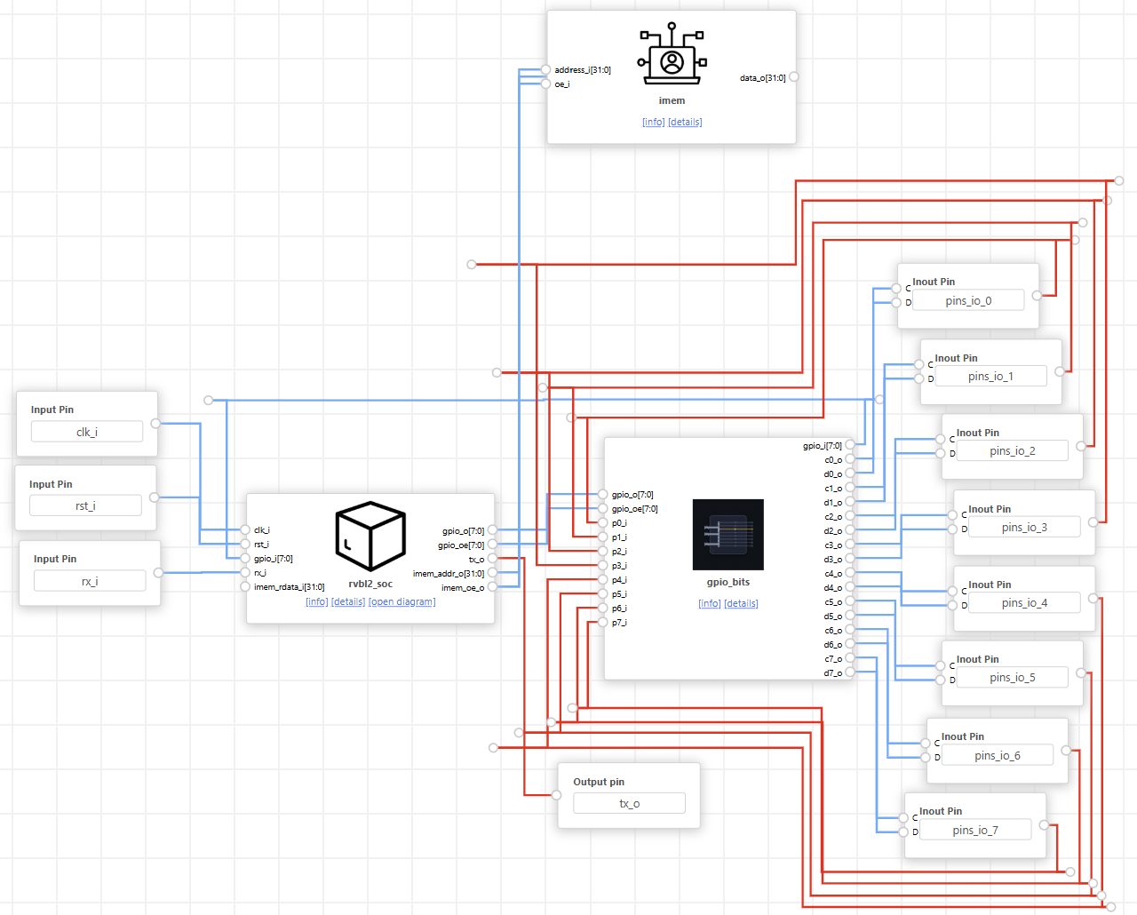
report-stage3/figures/ci_top_blocks.png
