Niccc8/rvbl2-riscv-cpu-core/report-stage3/figures/demo_qr.png

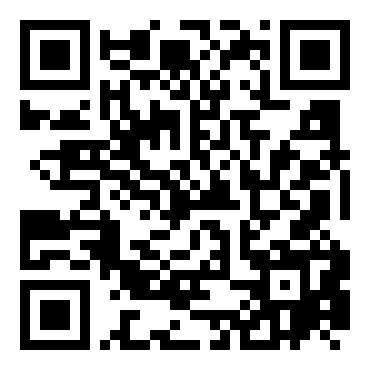
report-stage3/figures/demo_qr.png
