Niccc8/rvbl2-riscv-cpu-core/report-stage3/figures/platform_official_log.png

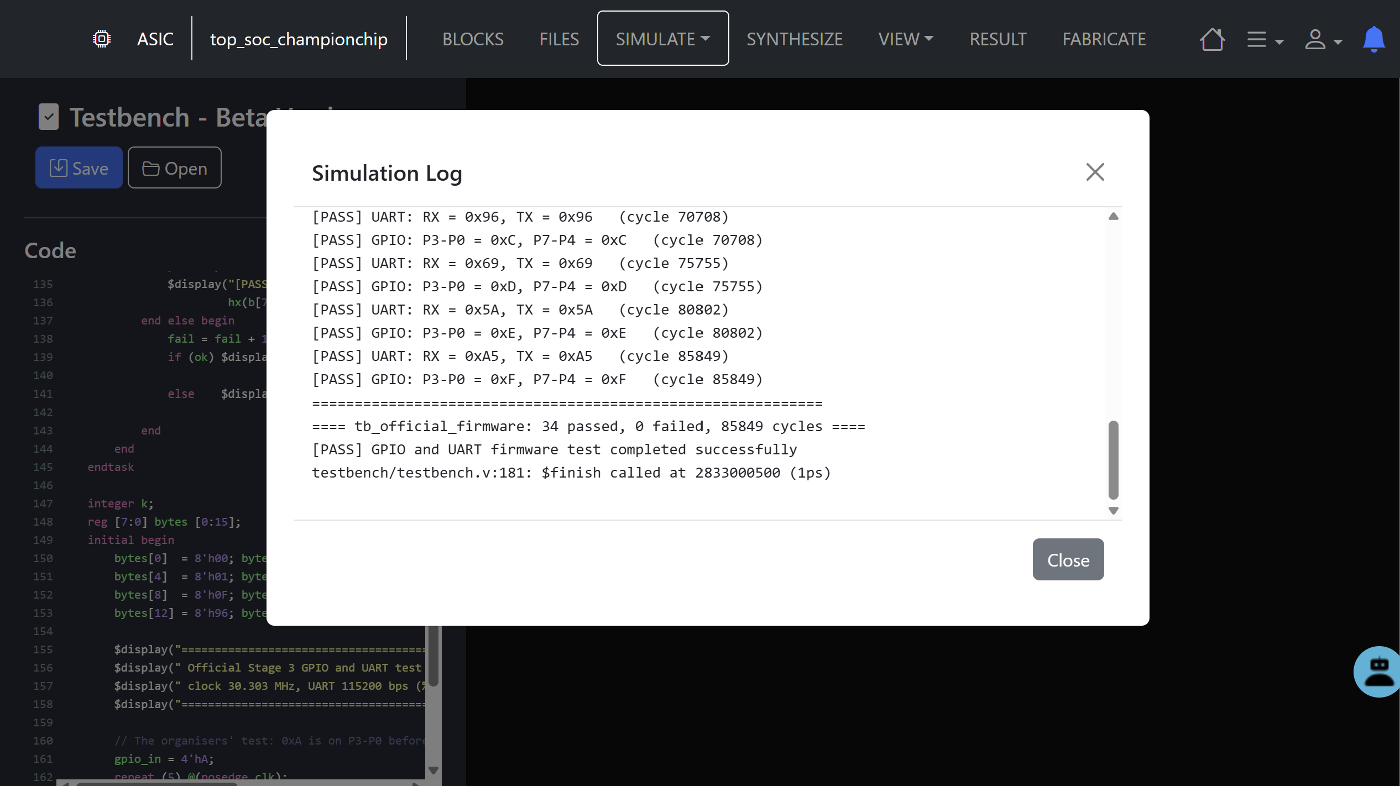
report-stage3/figures/platform_official_log.png
