Niccc8/rvbl2-riscv-cpu-core/report-stage3/figures/wave_app.png

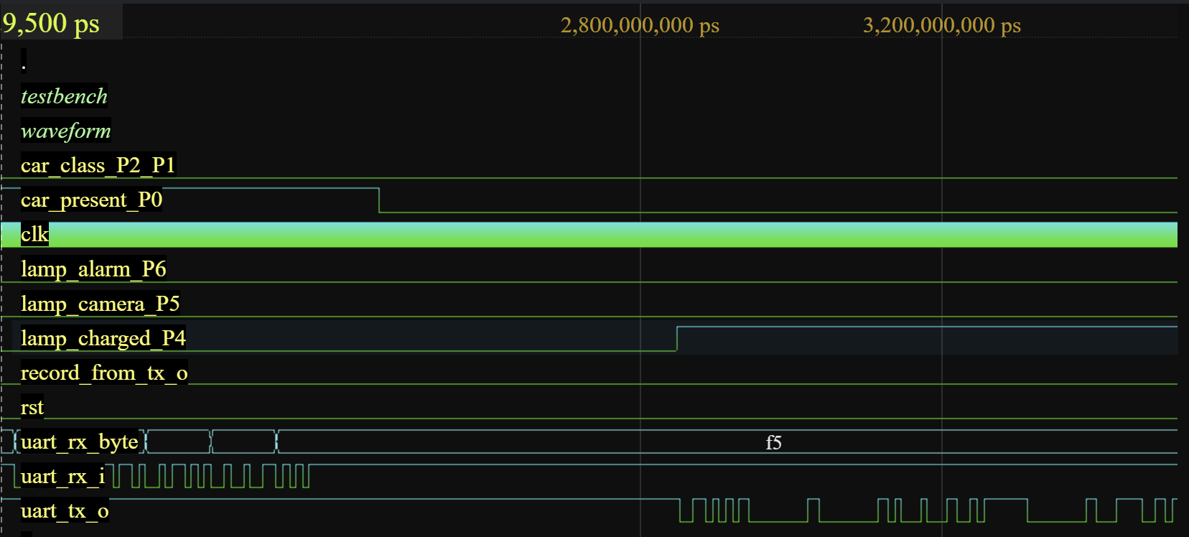
report-stage3/figures/wave_app.png
