Niccc8/rvbl2-riscv-cpu-core/report-stage3/figures/wave_official.png

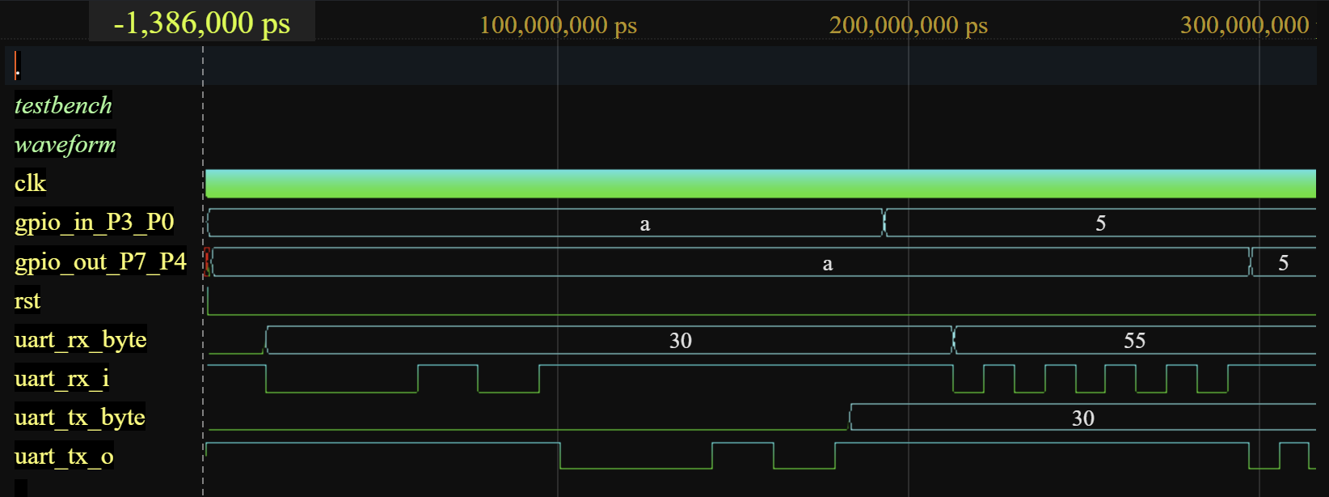
report-stage3/figures/wave_official.png
