Niccc8/rvbl2-riscv-cpu-core/stage4/evidence/Screenshot 2026-10-10 204622 (redacted).png

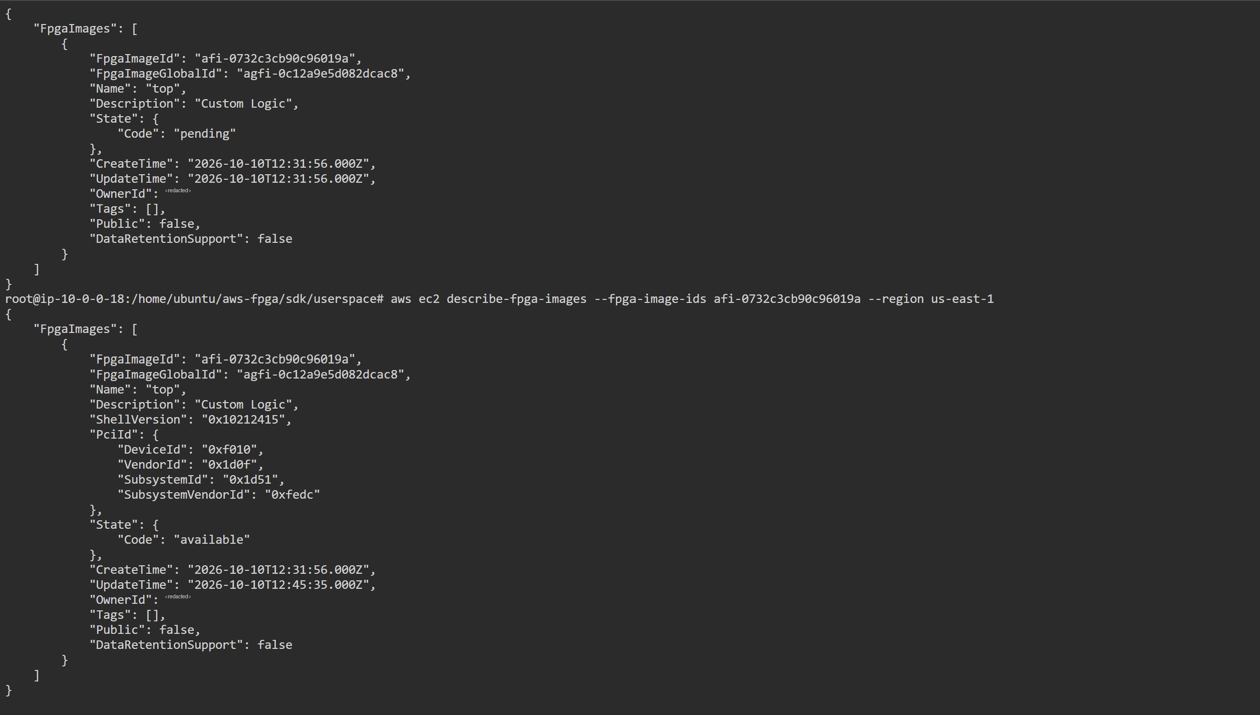
stage4/evidence/Screenshot 2026-10-10 204622 (redacted).png
