Niccc8/rvbl2-riscv-cpu-core/chipinventor/openlane/runs/platform_20260904/reports/metrics.csv

design | design_name | config | flow_status | total_runtime | routed_runtime | (Cell/mm^2)/Core_Util | DIEAREA_mm^2 | CellPer_mm^2 | OpenDP_Util | Final_Util | Peak_Memory_Usage_MB | synth_cell_count | tritonRoute_violations | Short_violations | MetSpc_violations | OffGrid_violations | MinHole_violations | Other_violations | Magic_violations | pin_antenna_violations | net_antenna_violations | lvs_total_errors | klayout_violations | wire_length | vias | wns | pl_wns | optimized_wns | fastroute_wns | spef_wns | tns | pl_tns | optimized_tns | fastroute_tns | spef_tns | HPWL | routing_layer1_pct | routing_layer2_pct | routing_layer3_pct | routing_layer4_pct | routing_layer5_pct | routing_layer6_pct | wires_count | wire_bits | public_wires_count | public_wire_bits | memories_count | memory_bits | processes_count | cells_pre_abc | AND | DFF | NAND | NOR | OR | XOR | XNOR | MUX | inputs
/chipinventor/OpenLane/designs/spm | top | RUN_2026.09.04_06.40.41 | flow completed | 0h54m53s0ms | 0h45m41s0ms | 95571.50278515616 | 0.4038442305 | 47785.75139257808 | -1 | 52.2781 | 1282.1 | 17708 | 0 | 0 | 0 | 0 | 0 | 0 | 0 | 86 | 60 | 0 | 0 | 869840 | 151445 | 0.0 | 0.0 | 0.0 | 0.0 | 0.0 | 0.0 | 0.0 | 0.0 | 0.0 | 0.0 | 643113918.0 | 0.0 | 52.1 | 57.98 | 30.82 | 37.61 | 20.46 | 17830 | 21635 | 302 | 4066 | 0 | 0 | 0 | 19080 | 436 | 9 | 383 | 998 | 2220 | 3064 | 1386 | 2788 | 1391
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
