Niccc8/rvbl2-riscv-cpu-core/chipinventor/openlane/runs/local_rvbl2_c/metrics.csv

design | design_name | config | flow_status | total_runtime | routed_runtime | (Cell/mm^2)/Core_Util | DIEAREA_mm^2 | CellPer_mm^2 | OpenDP_Util | Final_Util | Peak_Memory_Usage_MB | synth_cell_count | tritonRoute_violations | Short_violations | MetSpc_violations | OffGrid_violations | MinHole_violations | Other_violations | Magic_violations | pin_antenna_violations | net_antenna_violations | lvs_total_errors | klayout_violations | wire_length | vias | wns | pl_wns | optimized_wns | fastroute_wns | spef_wns | tns | pl_tns | optimized_tns | fastroute_tns | spef_tns | HPWL | routing_layer1_pct | routing_layer2_pct | routing_layer3_pct | routing_layer4_pct | routing_layer5_pct | routing_layer6_pct | wires_count | wire_bits | public_wires_count | public_wire_bits | memories_count | memory_bits | processes_count | cells_pre_abc | AND | DFF | NAND | NOR | OR | XOR | XNOR | MUX | inputs
/openlane/designs/rvbl2_c | top | rvbl2_c | flow completed | 0h40m39s0ms | 0h29m28s0ms | 94585.97578855672 | 0.362104421025 | 47292.98789427836 | -1 | 52.915800000000004 | 1197.5 | 15524 | 0 | 0 | 0 | 0 | 0 | 0 | 0 | 67 | 39 | 0 | 0 | 759224 | 134123 | 0.0 | 0.0 | 0.0 | 0.0 | 0.0 | 0.0 | 0.0 | 0.0 | 0.0 | 0.0 | 557422621.0 | 0.0 | 51.12 | 56.59 | 30.25 | 37.07 | 14.41 | 15823 | 19628 | 302 | 4066 | 0 | 0 | 0 | 17073 | 301 | 9 | 253 | 802 | 2174 | 2644 | 941 | 2788 | 1391
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
