Niccc8/rvbl2-riscv-cpu-core/stage4/de10lite/gantry/print/print_frame.stl

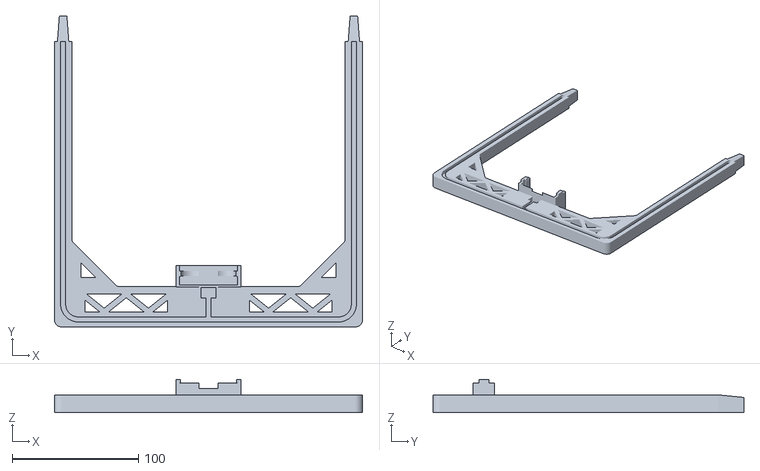
[picture p30: CAD file, 2026-10-12]
stage4/de10lite/gantry/print/print_frame.stl
244.0 x 246.0 x 26.3
