Niccc8/rvbl2-riscv-cpu-core/stage4/de10lite/gantry/print/LaneX_gantry_A1.gcode.3mf

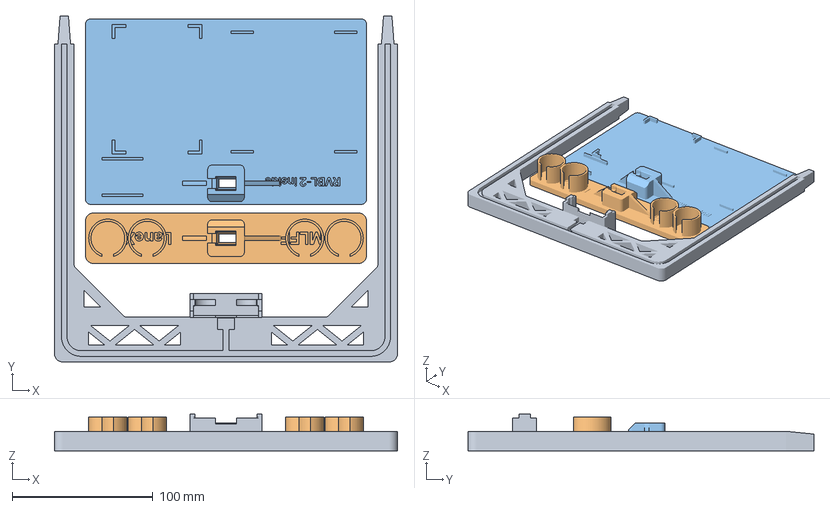
[picture p31: CAD file, 2026-10-12]
stage4/de10lite/gantry/print/LaneX_gantry_A1.gcode.3mf
244.0 x 246.0 x 26.3 mm
frame
footing
tray
