Niccc8/rvbl2-riscv-cpu-core/stage4/de10lite/gantry/print/print_tray.stl

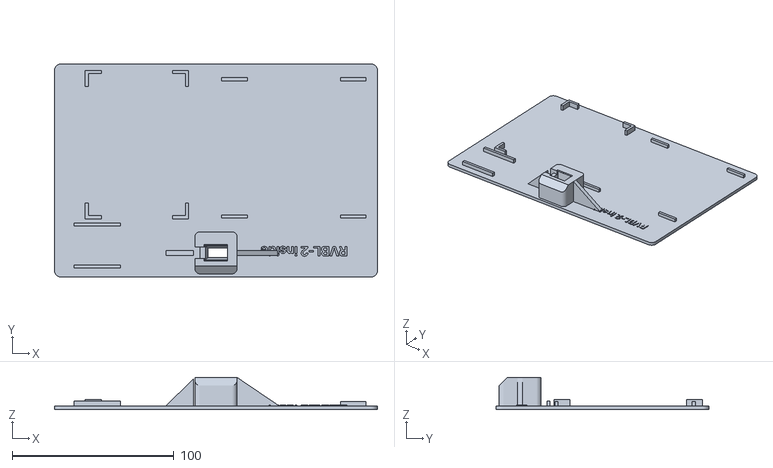
[picture p32: CAD file, 2026-10-12]
stage4/de10lite/gantry/print/print_tray.stl
200.0 x 132.0 x 20.0
