Niccc8/rvbl2-riscv-cpu-core/stage4/de10lite/gantry/print/print_footing.stl

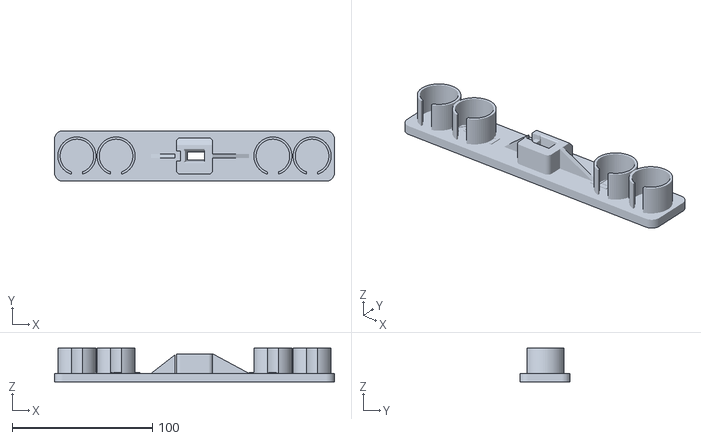
[picture p33: CAD file, 2026-10-12]
stage4/de10lite/gantry/print/print_footing.stl
200.0 x 36.0 x 24.0
