Niccc8/rvbl2-riscv-cpu-core/stage4/de10lite/gantry/print/LaneX_gantry_FIT_TEST_A1.gcode.3mf

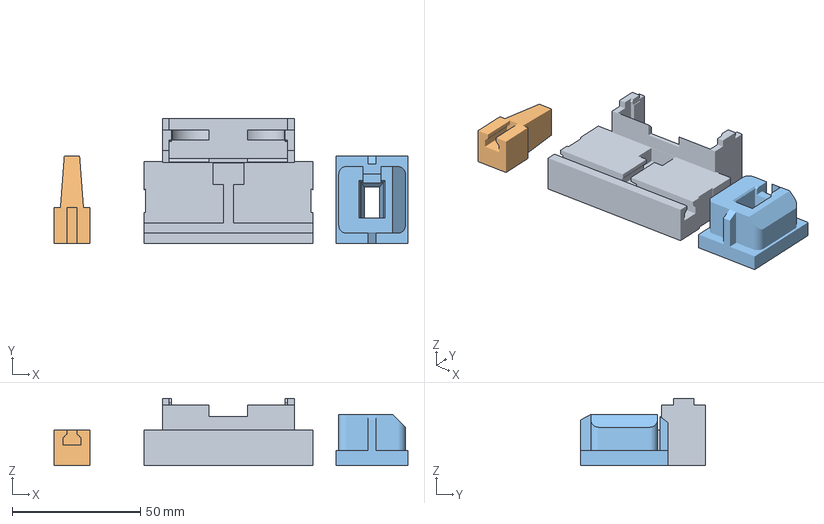
[picture p34: CAD file, 2026-10-12]
stage4/de10lite/gantry/print/LaneX_gantry_FIT_TEST_A1.gcode.3mf
138.0 x 48.7 x 26.3 mm
fit_pod
fit_foot
fit_socket
