Niccc8/rvbl2-riscv-cpu-core/(list of files, cad)

Other CAD files:
stage4/de10lite/gantry/print/LaneX_gantry_BambuStudio_project.3mf
