Niccc8/rvbl2-riscv-cpu-core/tools/rvbl-firmware-builder/src/README.md

Place the assembly source in this directory using the filename `main.s`.
