Niccc8/rvbl2-riscv-cpu-core/stage4/de10lite/wiring_card.html

# LaneX desk lane — wiring card

Terasic DE10-Lite (MAX 10 10M50DAF484C7G) · GPIO header JP1 · pins as in lanex.qsf

Print: A4 landscape. Generated from the same pin table as the FPGA project.

5 V never reaches an FPGA pin.The MAX 10 pins are not 5 V tolerant. Pin 11 (5 V) goes to the ultrasonic VCC only, and its Echo goes through the divider: Echo → 1 kΩ → pin 3, and pin 3 → 2 kΩ → GND.

Measure first.Board on, nothing plugged: multimeter pin 29 → pin 30 = 3.3 V, pin 11 → pin 12 = 5 V. That proves you hold the header the right way round.

Wire with the board unplugged.Then plug the USB in. With nothing wired the board still works: in manual mode (SW8) KEY1 is the vehicle, and the displays run the whole demo.

## Connections

Pin | Signal | FPGA | Dir | Function | Connect to
1 | GPIO_0 | V10 | in | Host link: laptop -> board (FPGA receives) | USB-UART TXD / TXO
2 | GPIO_1 | W10 | out | Host link: board -> laptop (the chip's records) | USB-UART RXD / RXI
3 | GPIO_2 | V9 | in | Ultrasonic Echo (5 V, through the divider) | HC-SR04 Echo via 1 kΩ; 2 kΩ to GND
4 | GPIO_3 | W9 | out | Ultrasonic Trig | HC-SR04 Trig
5 | GPIO_4 | V8 | out | Green lamp: charged | green LED + 330 Ω
6 | GPIO_5 | W8 | out | White lamp: camera flash | white LED + 100 Ω
7 | GPIO_6 | V7 | out | Red lamp: alarm | red LED + 330 Ω
8 | GPIO_7 | W7 | out | Buzzer, a level (active buzzer) | active buzzer + (e.g. TMB12A05), or a module's I/O
9 | GPIO_8 | W6 | out | Lane-closed lamp (optional) | yellow LED + 330 Ω
10 | GPIO_9 | V5 | out | Buzzer, a 2.4 kHz tone (passive buzzer) | 330 Ω, then the passive buzzer
11 | 5 V | – | – | Board 5 V | HC-SR04 VCC only (nothing else)
12 | GND | – | – | Ground | HC-SR04 GND and the USB-UART GND
29 | 3.3 V | – | – | 3.3 V supply | buzzer module VCC
30 | GND | – | – | Ground | breadboard − rail → the 2 kΩ, LEDs, buzzer −

## The gantry

One sensor, 15–25 cm above the table, looking straight down at the lane. At power-up the lane must be empty: the board learns the floor. Push each toy under it at walking pace for a toy: the display shows the height it measured (h 4.5 = 4.5 cm); LEDR1 lights for a lorry (from 6 cm; TALL_MM in lanex.qsf).

## Parts

Part | Qty | Note
Ultrasonic sensor HC-SR04 (4 pins: VCC Trig Echo GND) | 1 | Mounted above the lane, looking down: it measures each vehicle's height. VCC from pin 11 (5 V).
Resistors 1 kΩ and 2 kΩ (or 2 × 1 kΩ in series) | 1 each | The Echo divider: 5 V → 3.3 V. Never wire Echo straight to the board.
LED + resistor: green, red, yellow (330 Ω) and white (100 Ω) | 1 each | Long leg (anode) to the resistor, the resistor to the GPIO pin; short leg to GND. A 3-LED traffic-light module (resistors built in) also works.
Buzzer (one of these) | 1 | Active, sealed underneath (TMB12A05): + leg to pin 8, − to GND. Passive, green board visible underneath: pin 10 → 330 Ω → buzzer → GND, never without the 330 Ω and never on pin 8. A 3-pin module: VCC 29, GND, I/O pin 8; if it sounds while idle, flip SW6.
USB-UART 3.3 V: Cytron UC00C (CH340), or CP2102 / FT232 | 1 | Slide its switch to 3.3 V (it sets the signal level too). TXO/TXD → pin 1, RXI/RXD → pin 2, GND → pin 12. VCC, DTR and CTS stay unconnected.
Mini breadboard (170 points) + female-female and male-female jumpers | 1 + ~20 | The divider sits here; pin 30 (GND) is the rail for the LEDs, the buzzer and the divider.
Toy car, and a toy lorry clearly taller than the car | 1 each | The height difference is the classifier (default: lorry from 6 cm).

## Controls

SW0 | Lane closed (the chip lights P7)
SW2:SW1 | Class: 00 the sensor's height · 01 van · 10 lorry · 11 motorcycle
SW5:SW3 | Tag the next vehicle carries
SW6 | Buzzer module is low-level trigger (pin 8 only)
SW7 | Mute the buzzer
SW8 | Manual: KEY1 is the vehicle (no sensor needed)
SW9 | Tour: replay the 12 AWS tests → PASS12
KEY0 | Hold: reset (lamp test, banner, Id.56dE); the sensor relearns the floor
KEY1 | Manual vehicle (SW8 up), else: fingerprint the ROM

## Tag presets (SW5:SW3)

- 0 nonE
- 1 CAr
- 2 LorrY
- 3 CAb
- 4 StOLEn
- 5 CLOnE
- 6 bAd
- 7 FAr

## Lights

LEDR0 | Something is under the sensor (sensor check)
LEDR1 | That vehicle is tall: a lorry
LEDR2 | The chip sees a vehicle (P0)
LEDR3 | The laptop is sending
LEDR4–7 | The chip's lamps: charged, camera, alarm, closed
LEDR8 | The last record was signed
LEDR9 | Self-check: the ROM fingerprint matches (or PASS12)

## Bring-up

1. Program the .sof: lamp test, banner, Id.56dE, LEDR9.
2. SW9 up: PASS12. SW9 down.
3. SW8 up, tag CAr, press KEY1: CHArGE / 2.50.
4. Wire the sensor + divider (board unplugged); power up with the lane empty; a toy under it: LEDR0.
5. Wire the lamps and buzzer; push the car, then the lorry.
6. USB-UART + lanex_live.html in Chrome.
7. Program the .pof: it boots by itself.
