Niccc8/rvbl2-riscv-cpu-core/stage4/de10lite/gantry/print/preview_pod.png

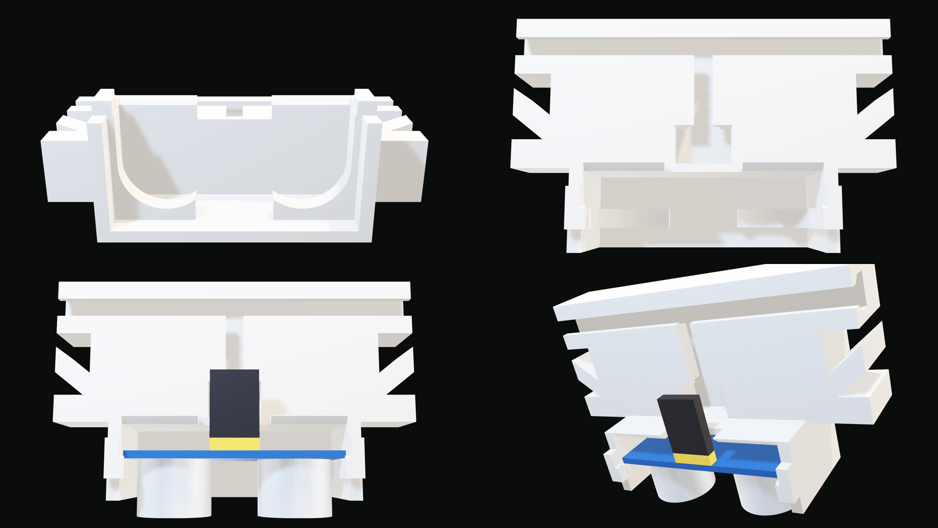
stage4/de10lite/gantry/print/preview_pod.png
