Niccc8/rvbl2-riscv-cpu-core/stage4/de10lite/wiring_card.png

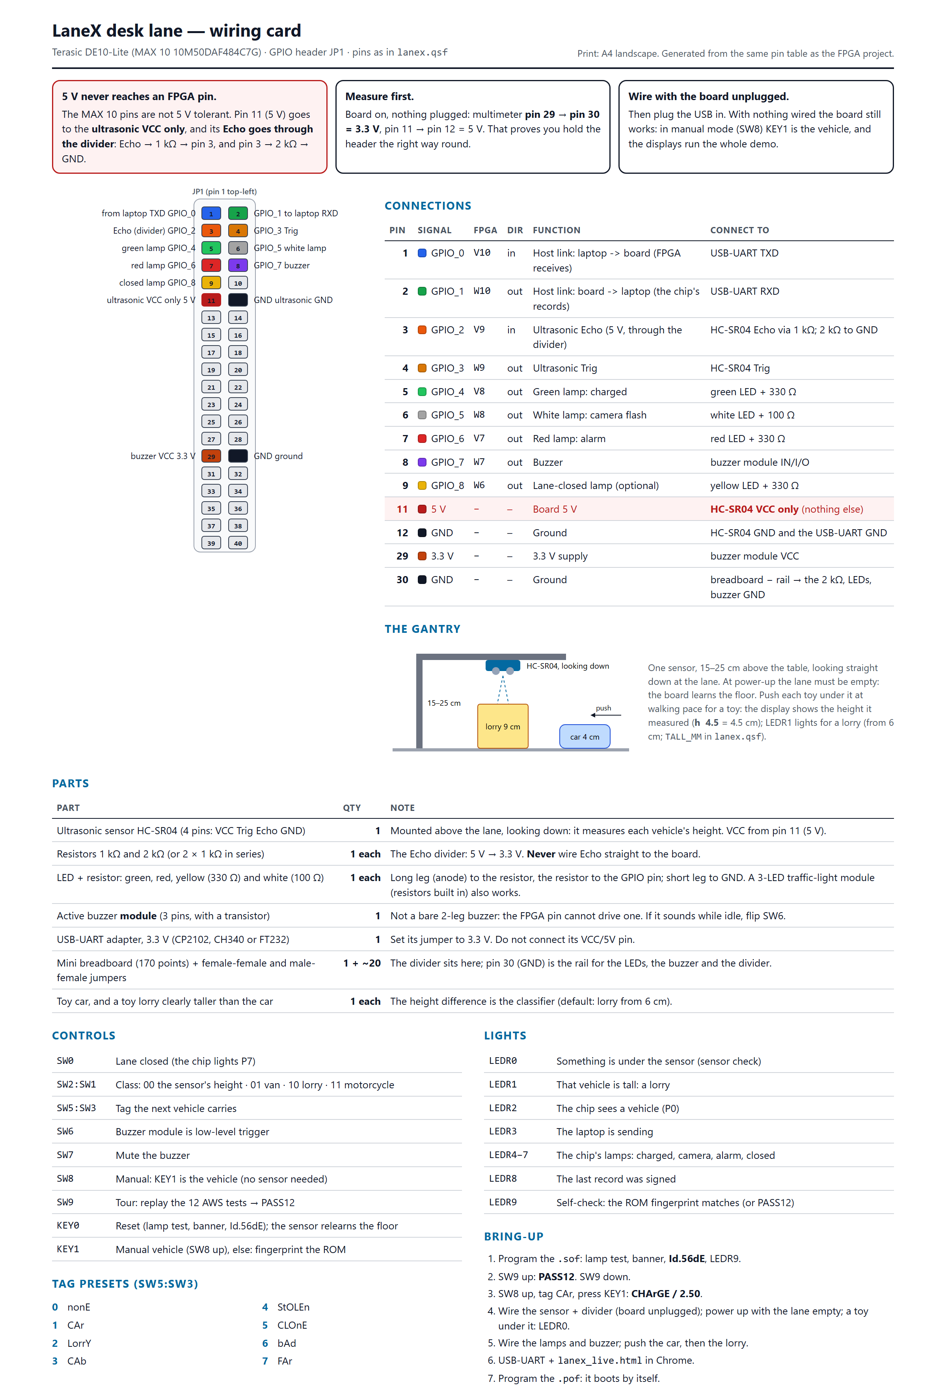
stage4/de10lite/wiring_card.png
