Niccc8/rvbl2-riscv-cpu-core/docs/stage4/evidence/aws_build_log.txt

#-----------------------------------------------------------
# Vivado v2024.1 (64-bit)
# SW Build 5076996 on Wed May 22 18:36:09 MDT 2024
# IP Build 5075265 on Wed May 22 21:45:21 MDT 2024
# SharedData Build 5076995 on Wed May 22 18:29:18 MDT 2024
# Start of session at: Sat Oct 10 12:10:27 2026
# Process ID: 3544
# Current directory: /home/ubuntu/src/aws-fpga/hdk/cl/examples/top/build/scripts
# Command line: vivado -mode batch -source build_all.tcl -log 2026_10_10-121021.vivado.log -tclargs SSI_SpreadLogic_high AggressiveExplore AggressiveExplore A1 B2 C0 H2
# Log file: /home/ubuntu/src/aws-fpga/hdk/cl/examples/top/build/scripts/2026_10_10-121021.vivado.log
# Journal file: /home/ubuntu/src/aws-fpga/hdk/cl/examples/top/build/scripts/vivado.jou
# Running On :ip-10-0-5-224
# Platform :Ubuntu
# Operating System :Ubuntu 20.04.6 LTS
# Processor Detail :Intel(R) Xeon(R) Platinum 8488C
# CPU Frequency :2400.000 MHz
# CPU Physical cores:8
# CPU Logical cores :16
# Host memory :132920 MB
# Swap memory :10737 MB
# Total Virtual :143657 MB
# Available Virtual :142997 MB
#-----------------------------------------------------------
source build_all.tcl
# proc print {message} {
# set prefix "\nAWS FPGA: ([clock format [clock seconds] -format %T]): "
# append output $prefix $message "\n"
# puts $output
# }
# proc check_timing_path { {verbose 1} } {
#
# set setupPaths [get_timing_paths -max_paths 1 -slack_lesser_than 0 -setup]
# set holdPaths [get_timing_paths -max_paths 1 -slack_lesser_than 0 -hold]
#
# if {$verbose>0} {
# print "Checking the negative slack path of the existing design"
# }
#
# if {[llength $setupPaths] == 0 && [llength $holdPaths] == 0} {
# if {$verbose>0} {
# print "SUCCESS: Design has no negative slack path"
# }
# return 0
# } else {
# if {$verbose>0} {
# print "CRITICAL WARNING: Found $setupPaths negative setup slack paths and $holdPaths negative hold slack hold paths"
# }
# return 1
# }
# }
# proc create_dir {name path {verbose 0}} {
#
# # Better to use absolute path
# set cur [pwd]
# # Check if the $path exists
# if {![file isdirectory $path]} {
# error "$path doesn't exist"
# }
# cd $path
# set path_abs [pwd]
#
# cd $cur
# # Check and create the directory if not exists
# if {![file isdirectory $path_abs/$name]} {
# file mkdir $path_abs/$name
# if {$verbose>0} {
# print "Creating new folder $path_abs/$name"
# }
# } elseif {$verbose>0} {
# print "Found existing folder $path_abs/$name. Folder creation skipped"
# }
# return $path_abs/$name
# }
# proc display_proj {} {
# global VIVADO_TOOL_VERSION
# global CL
# global SHELL_MODE
# global BUILD_FLOW
# global PLACE_DIRECT
# global PHY_OPT_DIRECT
# global ROUTE_DIRECT
# global TAG
# global clock_recipe_a
# global clock_recipe_b
# global clock_recipe_c
# global clock_recipe_hbm
#
#
# set rpt "
# ==================================================
# Running CL builds w/ updated build tag
# ==================================================
# vivado_tool : $VIVADO_TOOL_VERSION
# cl : $CL
# mode : $SHELL_MODE
# clock_recipe_a : $clock_recipe_a
# clock_recipe_b : $clock_recipe_b
# clock_recipe_c : $clock_recipe_c
# clock_recipe_hbm : $clock_recipe_hbm
# flow : $BUILD_FLOW
# place_direct : $PLACE_DIRECT
# phy_opt_direct : $PHY_OPT_DIRECT
# route_direct : $ROUTE_DIRECT
# build_tag : $TAG
# ==================================================
# "
# puts "$rpt"
# }
# set PLACE_DIRECT [lindex $argv 0]
# set PHY_OPT_DIRECT [lindex $argv 1]
# set ROUTE_DIRECT [lindex $argv 2]
# set clock_recipe_a [lindex $argv 3]
# set clock_recipe_b [lindex $argv 4]
# set clock_recipe_c [lindex $argv 5]
# set clock_recipe_hbm [lindex $argv 6]
# set DEVICE_TYPE "xcvu47p-fsvh2892-2-e"
# if { [info exists ::env(BUILD_FLOW)] } {
# set BUILD_FLOW $::env(BUILD_FLOW)
# } else {
# set BUILD_FLOW "BuildAll"
# }
# if { [info exists ::env(CL)] } {
# set CL $::env(CL)
# } else {
# set CL "cl_dram_hbm_dma"
# }
# if { [info exists ::env(SHELL_MODE)] } {
# set SHELL_MODE $::env(SHELL_MODE)
# } else {
# set SHELL_MODE "xdma_shell"
# }
# if { [info exists ::env(BUILD_TAG)] } {
# set TAG $::env(BUILD_TAG)
# } else {
# set TAG "00_00_0000-999999"
# }
# if { [info exists ::env(HDK_SHELL_DIR)] } {
# set HDK_SHELL_DIR $::env(HDK_SHELL_DIR)
# } else {
# print "ERROR: HDK_SHELL_DIR not set. Please run hdk_setup.sh to set required env variables."
# exit
# }
# if { [info exists ::env(HDK_SHELL_DESIGN_DIR)] } {
# set HDK_SHELL_DESIGN_DIR $::env(HDK_SHELL_DESIGN_DIR)
# } else {
# print "ERROR: HDK_SHELL_DESIGN_DIR not set. Please run hdk_setup.sh to set required env variables."
# exit
# }
# if { [info exists ::env(HDK_COMMON_DIR)] } {
# set HDK_COMMON_DIR $::env(HDK_COMMON_DIR)
# } else {
# print "ERROR: HDK_COMMON_DIR not set. Please run hdk_setup.sh to set required env variables."
# exit
# }
# if { [info exists ::env(HDK_IP_SRC_DIR)] } {
# set HDK_IP_SRC_DIR $::env(HDK_IP_SRC_DIR)
# } else {
# print "ERROR: HDK_IP_SRC_DIR not set. Please run hdk_setup.sh to set required env variables."
# exit
# }
# if { [info exists ::env(HDK_BD_SRC_DIR)] } {
# set HDK_BD_SRC_DIR $::env(HDK_BD_SRC_DIR)
# } else {
# print "ERROR: HDK_BD_SRC_DIR not set. Please run hdk_setup.sh to set required env variables."
# exit
# }
# if { [info exists ::env(HDK_BD_GEN_DIR)] } {
# set HDK_BD_GEN_DIR $::env(HDK_BD_GEN_DIR)
# } else {
# print "ERROR: HDK_BD_GEN_DIR not set. Please run hdk_setup.sh to set required env variables."
# exit
# }
# if { [info exists ::env(CL_DIR)] } {
# set CL_DIR $::env(CL_DIR)
# } else {
# print "ERROR: CL_DIR not set. Please run hdk_setup.sh to set required env variables."
# exit
# }
# if { [info exists ::env(VIVADO_TOOL_VERSION)] } {
# set VIVADO_TOOL_VERSION $::env(VIVADO_TOOL_VERSION)
# } else {
# print "ERROR: VIVADO_TOOL_VERSION not set. Please run hdk_setup.sh to set required env variables."
# exit
# }
# display_proj

==================================================
Running CL builds w/ updated build tag
==================================================
vivado_tool : 2024.1
cl : top
mode : small_shell
clock_recipe_a : A1
clock_recipe_b : B2
clock_recipe_c : C0
clock_recipe_hbm : H2
flow : BuildAll
place_direct : SSI_SpreadLogic_high
phy_opt_direct : AggressiveExplore
route_direct : AggressiveExplore
build_tag : 2026_10_10-121021
==================================================

# set scripts_dir [pwd]
# set build_dir [file dirname $scripts_dir]
# create_dir "reports" $build_dir
# create_dir "checkpoints" $build_dir
# create_dir "src_post_encryption" $build_dir
# set design_dir "${CL_DIR}/design"
# set constraints_dir "${build_dir}/constraints"
# set reports_dir "${build_dir}/reports"
# set checkpoints_dir "${build_dir}/checkpoints"
# set reports_dir "${build_dir}/reports"
# set src_post_enc_dir "${build_dir}/src_post_encryption"
# cd $scripts_dir
# print "Generating clock contraints for CL source clocks"

AWS FPGA: (12:12:37): Generating clock contraints for CL source clocks

# source $HDK_SHELL_DIR/build/scripts/aws_gen_clk_constraints.tcl
## switch $clock_recipe_a {
## "A0" {
## #NOT SUPPORTED# set clk_main_a0_period 8
## #NOT SUPPORTED# set clk_main_a0_half_period 4
## set clk_main_a0_period 4
## set clk_main_a0_half_period 2
## set clk_extra_a1_period 16
## set clk_extra_a1_half_period 8
## set clk_extra_a2_period 5.333
## set clk_extra_a2_half_period 2.667
## set clk_extra_a3_period 4
## set clk_extra_a3_half_period 2
## }
## "A1" {
## set clk_main_a0_period 4
## set clk_main_a0_half_period 2
## set clk_extra_a1_period 8
## set clk_extra_a1_half_period 4
## set clk_extra_a2_period 2.667
## set clk_extra_a2_half_period 1.333
## set clk_extra_a3_period 2
## set clk_extra_a3_half_period 1
## }
## "A2" {
## #NOT SUPPORTED# set clk_main_a0_period 64
## #NOT SUPPORTED# set clk_main_a0_half_period 32
## set clk_main_a0_period 4
## set clk_main_a0_half_period 2
## set clk_extra_a1_period 128
## set clk_extra_a1_half_period 64
## set clk_extra_a2_period 8
## set clk_extra_a2_half_period 4
## set clk_extra_a3_period 16
## set clk_extra_a3_half_period 8
## }
## default {
## puts "$clock_recipe_a is NOT a valid clock_recipe_a."
## }
## }
## switch $clock_recipe_b {
## "B0" {
## set clk_extra_b0_period 4
## set clk_extra_b0_half_period 2
## set clk_extra_b1_period 8
## set clk_extra_b1_half_period 4
## }
## "B1" {
## set clk_extra_b0_period 8
## set clk_extra_b0_half_period 4
## set clk_extra_b1_period 16
## set clk_extra_b1_half_period 8
## }
## "B2" {
## set clk_extra_b0_period 2.222
## set clk_extra_b0_half_period 1.111
## set clk_extra_b1_period 4.444
## set clk_extra_b1_half_period 2.222
## }
## "B3" {
## set clk_extra_b0_period 4
## set clk_extra_b0_half_period 2
## set clk_extra_b1_period 16
## set clk_extra_b1_half_period 8
## }
## "B4" {
## set clk_extra_b0_period 3.333
## set clk_extra_b0_half_period 1.667
## set clk_extra_b1_period 13.333
## set clk_extra_b1_half_period 6.667
## }
## "B5" {
## set clk_extra_b0_period 2.5
## set clk_extra_b0_half_period 1.25
## set clk_extra_b1_period 10
## set clk_extra_b1_half_period 5
## }
## default {
## puts "$clock_recipe_b is NOT a valid clock_recipe_b."
## }
## }
## switch $clock_recipe_c {
## "C0" {
## set clk_extra_c0_period 3.333
## set clk_extra_c0_half_period 1.667
## set clk_extra_c1_period 2.5
## set clk_extra_c1_half_period 1.25
## }
## "C1" {
## set clk_extra_c0_period 6.667
## set clk_extra_c0_half_period 3.333
## set clk_extra_c1_period 5
## set clk_extra_c1_half_period 2.5
## }
## "C2" {
## set clk_extra_c0_period 13.333
## set clk_extra_c0_half_period 6.667
## set clk_extra_c1_period 10
## set clk_extra_c1_half_period 5
## }
## "C3" {
## set clk_extra_c0_period 5
## set clk_extra_c0_half_period 2.5
## set clk_extra_c1_period 3.75
## set clk_extra_c1_half_period 1.875
## }
## default {
## puts "$clock_recipe_c is NOT a valid clock_recipe_c."
## }
## }
## switch $clock_recipe_hbm {
## "H0" {
## set clk_hbm_axi_period 4
## set clk_hbm_axi_half_period 2
## }
## "H1" {
## set clk_hbm_axi_period 8
## set clk_hbm_axi_half_period 4
## }
## "H2" {
## set clk_hbm_axi_period 2.222
## set clk_hbm_axi_half_period 1.111
## }
## "H3" {
## set clk_hbm_axi_period 3.333
## set clk_hbm_axi_half_period 1.667
## }
## "H4" {
## set clk_hbm_axi_period 2.5
## set clk_hbm_axi_half_period 1.25
## }
## default {
## puts "$clock_recipe_hbm is NOT a valid clock_recipe_hbm."
## }
## }
## set pin_clk_extra_a1 "\[get_pins -of_objects \[get_cells -hierarchical -regexp .*AWS_CLK_GEN/CLK_GRP_A_EN_I.CLK_MMCM_A_I/inst/CLK_CORE_DRP_I/clk_inst/mmcme4_adv_inst\] -filter {NAME=~*CLKOUT0}\]"
## set pin_clk_extra_a2 "\[get_pins -of_objects \[get_cells -hierarchical -regexp .*AWS_CLK_GEN/CLK_GRP_A_EN_I.CLK_MMCM_A_I/inst/CLK_CORE_DRP_I/clk_inst/mmcme4_adv_inst\] -filter {NAME=~*CLKOUT1}\]"
## set pin_clk_extra_a3 "\[get_pins -of_objects \[get_cells -hierarchical -regexp .*AWS_CLK_GEN/CLK_GRP_A_EN_I.CLK_MMCM_A_I/inst/CLK_CORE_DRP_I/clk_inst/mmcme4_adv_inst\] -filter {NAME=~*CLKOUT2}\]"
## set pin_clk_extra_b0 "\[get_pins -of_objects \[get_cells -hierarchical -regexp .*AWS_CLK_GEN/CLK_GRP_B_EN_I.CLK_MMCM_B_I/inst/CLK_CORE_DRP_I/clk_inst/mmcme4_adv_inst\] -filter {NAME=~*CLKOUT0}\]"
## set pin_clk_extra_b1 "\[get_pins -of_objects \[get_cells -hierarchical -regexp .*AWS_CLK_GEN/CLK_GRP_B_EN_I.CLK_MMCM_B_I/inst/CLK_CORE_DRP_I/clk_inst/mmcme4_adv_inst\] -filter {NAME=~*CLKOUT1}\]"
## set pin_clk_extra_c0 "\[get_pins -of_objects \[get_cells -hierarchical -regexp .*AWS_CLK_GEN/CLK_GRP_C_EN_I.CLK_MMCM_C_I/inst/CLK_CORE_DRP_I/clk_inst/mmcme4_adv_inst\] -filter {NAME=~*CLKOUT0}\]"
## set pin_clk_extra_c1 "\[get_pins -of_objects \[get_cells -hierarchical -regexp .*AWS_CLK_GEN/CLK_GRP_C_EN_I.CLK_MMCM_C_I/inst/CLK_CORE_DRP_I/clk_inst/mmcme4_adv_inst\] -filter {NAME=~*CLKOUT1}\]"
## set pin_clk_hbm_axi "\[get_pins -of_objects \[get_cells -hierarchical -regexp .*AWS_CLK_GEN/CLK_HBM_EN_I.CLK_MMCM_HBM_I/inst/CLK_CORE_DRP_I/clk_inst/mmcme4_adv_inst\] -filter {NAME=~*CLKOUT0}\]"
## if { [file exists $CL_DIR/build/constraints/generated_cl_clocks_aws.xdc] } {
## puts "Deleting old CL clocks constraints file since it will be replaced.";
## file delete -force $CL_DIR/build/constraints/generated_cl_clocks_aws.xdc
## }
## set clocks_file [open "$CL_DIR/build/constraints/generated_cl_clocks_aws.xdc" w]
## puts $clocks_file "#-------------------------------------------------------------------------"
## puts $clocks_file "# Do not edit this file! It is auto-generated from $argv0."
## puts $clocks_file "#-------------------------------------------------------------------------"
## puts $clocks_file "############################################################################### "
## puts $clocks_file "# OOC Source Clocks "
## puts $clocks_file "############################################################################### "
## puts $clocks_file "#CL HBM reference clock @100MHz "
## puts $clocks_file "create_clock -period 10.000 -name clk_hbm_ref -waveform {0.000 5.000} \[get_ports clk_hbm_ref\] \n"
## puts $clocks_file "# Group A Clocks"
## puts $clocks_file "create_clock -period $clk_main_a0_period -name clk_main_a0 -waveform {0.000 $clk_main_a0_half_period} \[get_ports clk_main_a0\]"
## close $clocks_file
# print "Encrypting CL source code"

AWS FPGA: (12:12:37): Encrypting CL source code

# source encrypt.tcl
## if {[llength [glob -nocomplain -dir ${src_post_enc_dir} *]] != 0} {
## eval file delete -force [glob ${src_post_enc_dir}/*]
## }
## foreach f [glob -directory ${HDK_SHELL_DESIGN_DIR}/interfaces *.inc] {
## file copy -force $f ${src_post_enc_dir}/
## }
## foreach f [glob -directory ${design_dir} *.{v,sv,vh,svh,inc}] {
## file copy -force $f ${src_post_enc_dir}/
## }
## exec chmod +w {*}[glob ${src_post_enc_dir}/*]
## encrypt -k ${HDK_SHELL_DIR}/build/scripts/vivado_keyfile.txt -lang verilog [glob -nocomplain -- ${src_post_enc_dir}/*.{v,sv,vh,inc}]
## encrypt -k ${HDK_SHELL_DIR}/build/scripts/vivado_vhdl_keyfile.txt -lang vhdl -quiet [ glob -nocomplain -- ${src_post_enc_dir}/*.vhd? ]
# switch $BUILD_FLOW {
# "SynthCL" {
# source ${scripts_dir}/synth_${CL}.tcl
# }
#
# "ImplCL" {
# source ${scripts_dir}/build_level_1_cl.tcl
# }
#
# default {
# source ${scripts_dir}/synth_${CL}.tcl
# source ${scripts_dir}/build_level_1_cl.tcl
# }
# }
## source ${HDK_SHELL_DIR}/build/scripts/synth_cl_header.tcl
### print "Creating in-memory synthesis project"

AWS FPGA: (12:12:38): Creating in-memory synthesis project

### set_param sta.enableAutoGenClkNamePersistence 0
### create_project -in_memory -part $DEVICE_TYPE -force
create_project: Time (s): cpu = 00:00:05 ; elapsed = 00:00:18 . Memory (MB): peak = 1417.680 ; gain = 101.836 ; free physical = 124035 ; free virtual = 136114
### set_property XPM_LIBRARIES {XPM_CDC XPM_MEMORY XPM_FIFO} [current_project]
### print "Reading common AWS components"

AWS FPGA: (12:12:56): Reading common AWS components

### read_verilog -sv [ list \
### ${HDK_SHELL_DESIGN_DIR}/../../lib/interfaces.sv \
### ${HDK_SHELL_DESIGN_DIR}/../../lib/aws_clk_gen.sv \
### ${HDK_SHELL_DESIGN_DIR}/../../lib/aws_clk_regs.sv \
### ${HDK_SHELL_DESIGN_DIR}/../../lib/axil_to_cfg_cnv.sv \
### ${HDK_SHELL_DESIGN_DIR}/../../lib/axis_flop_fifo.sv \
### ${HDK_SHELL_DESIGN_DIR}/../../lib/lib_pipe.sv \
### ${HDK_SHELL_DESIGN_DIR}/../../lib/bram_1w1r.sv \
### ${HDK_SHELL_DESIGN_DIR}/../../lib/bram_2rw.sv \
### ${HDK_SHELL_DESIGN_DIR}/../../lib/xpm_fifo.sv \
### ${HDK_SHELL_DESIGN_DIR}/../../lib/flop_fifo.sv \
### ${HDK_SHELL_DESIGN_DIR}/../../lib/flop_fifo_in.sv \
### ${HDK_SHELL_DESIGN_DIR}/../../lib/cdc_async_fifo.sv \
### ${HDK_SHELL_DESIGN_DIR}/../../lib/cdc_sync.sv \
### ${HDK_SHELL_DESIGN_DIR}/../../lib/ft_fifo_p.v \
### ${HDK_SHELL_DESIGN_DIR}/../../lib/ft_fifo.v \
### ${HDK_SHELL_DESIGN_DIR}/../../lib/ram_fifo_ft.sv \
### ${HDK_SHELL_DESIGN_DIR}/../../lib/rr_arb.sv \
### ${HDK_SHELL_DESIGN_DIR}/sh_ddr/synth/sync.v \
### ${HDK_SHELL_DESIGN_DIR}/sh_ddr/synth/flop_ccf.sv \
### ${HDK_SHELL_DESIGN_DIR}/sh_ddr/synth/ccf_ctl.v \
### ${HDK_SHELL_DESIGN_DIR}/sh_ddr/synth/mgt_acc_axl.sv \
### ${HDK_SHELL_DESIGN_DIR}/sh_ddr/synth/mgt_gen_axl.sv \
### ${HDK_SHELL_DESIGN_DIR}/sh_ddr/synth/sh_ddr.sv \
### ${HDK_SHELL_DESIGN_DIR}/interfaces/cl_ports.vh
### ]
### print "Reading AWS Constraints"

AWS FPGA: (12:12:56): Reading AWS Constraints

### read_xdc ${HDK_SHELL_DIR}/build/constraints/cl_pins.xdc
### read_xdc ${CL_DIR}/build/constraints/generated_cl_clocks_aws.xdc
### read_xdc -ref ${CL} ${HDK_SHELL_DIR}/build/constraints/cl_ddr_timing_aws.xdc
### set_property USED_IN {synthesis implementation OUT_OF_CONTEXT} [get_files generated_cl_clocks_aws.xdc]
### set_property PROCESSING_ORDER EARLY [get_files generated_cl_clocks_aws.xdc]
### set_property USED_IN {synthesis implementation} [get_files cl_ddr_timing_aws.xdc]
### set_property PROCESSING_ORDER LATE [get_files cl_ddr_timing_aws.xdc]
## print "Reading encrypted user source codes"

AWS FPGA: (12:12:56): Reading encrypted user source codes

## read_verilog -sv [glob ${src_post_enc_dir}/*.?v]
## print "Reading CL IP blocks"

AWS FPGA: (12:12:56): Reading CL IP blocks

## print "Reading user constraints"

AWS FPGA: (12:12:56): Reading user constraints

## read_xdc [ list \
## ${constraints_dir}/cl_synth_user.xdc \
## ${constraints_dir}/cl_timing_user.xdc
## ]
## set_property PROCESSING_ORDER LATE [get_files cl_synth_user.xdc]
## set_property PROCESSING_ORDER LATE [get_files cl_timing_user.xdc]
## print "Starting synthesizing customer design ${CL}"

AWS FPGA: (12:12:56): Starting synthesizing customer design top

## update_compile_order -fileset sources_1
## synth_design -mode out_of_context \
## -top ${CL} \
## -verilog_define XSDB_SLV_DIS \
## -part ${DEVICE_TYPE} \
## -keep_equivalent_registers
Command: synth_design -mode out_of_context -top top -verilog_define XSDB_SLV_DIS -part xcvu47p-fsvh2892-2-e -keep_equivalent_registers
Starting synth_design
Attempting to get a license for feature 'Synthesis' and/or device 'xcvu47p'
INFO: [Common 17-349] Got license for feature 'Synthesis' and/or device 'xcvu47p'
INFO: [Device 21-403] Loading part xcvu47p-fsvh2892-2-e
INFO: [Synth 8-7079] Multithreading enabled for synth_design using a maximum of 4 processes.
INFO: [Synth 8-7078] Launching helper process for spawning children vivado processes
INFO: [Synth 8-7075] Helper process launched with PID 4017
---------------------------------------------------------------------------------
Starting RTL Elaboration : Time (s): cpu = 00:00:04 ; elapsed = 00:00:09 . Memory (MB): peak = 3189.988 ; gain = 405.715 ; free physical = 121870 ; free virtual = 134059
---------------------------------------------------------------------------------
WARNING: [Synth 8-11065] parameter 'NUM_LOC' becomes localparam in 'ram_fifo_ft' with formal parameter declaration list [/home/ubuntu/src/aws-fpga/hdk/common/lib/ram_fifo_ft.sv:43]
INFO: [Synth 8-6157] synthesizing module 'MMCME4_BASE' [/opt/Xilinx/Vivado/2024.1/scripts/rt/data/unisim_comp.v:82908]
INFO: [Synth 8-6155] done synthesizing module 'MMCME4_BASE' (0#1) [/opt/Xilinx/Vivado/2024.1/scripts/rt/data/unisim_comp.v:82908]
INFO: [Synth 8-6157] synthesizing module 'BUFG' [/opt/Xilinx/Vivado/2024.1/scripts/rt/data/unisim_comp.v:1951]
INFO: [Synth 8-6155] done synthesizing module 'BUFG' (0#1) [/opt/Xilinx/Vivado/2024.1/scripts/rt/data/unisim_comp.v:1951]
INFO: [Synth 8-6157] synthesizing module 'OBUF' [/opt/Xilinx/Vivado/2024.1/scripts/rt/data/unisim_comp.v:96458]
INFO: [Synth 8-6155] done synthesizing module 'OBUF' (0#1) [/opt/Xilinx/Vivado/2024.1/scripts/rt/data/unisim_comp.v:96458]
INFO: [Synth 8-6157] synthesizing module 'IOBUFE3' [/opt/Xilinx/Vivado/2024.1/scripts/rt/data/unisim_comp.v:78605]
INFO: [Synth 8-6155] done synthesizing module 'IOBUFE3' (0#1) [/opt/Xilinx/Vivado/2024.1/scripts/rt/data/unisim_comp.v:78605]
INFO: [Synth 8-6157] synthesizing module 'IOBUFDS' [/opt/Xilinx/Vivado/2024.1/scripts/rt/data/unisim_comp.v:78226]
INFO: [Synth 8-6155] done synthesizing module 'IOBUFDS' (0#1) [/opt/Xilinx/Vivado/2024.1/scripts/rt/data/unisim_comp.v:78226]
INFO: [Synth 8-6157] synthesizing module 'IBUFDS' [/opt/Xilinx/Vivado/2024.1/scripts/rt/data/unisim_comp.v:73658]
INFO: [Synth 8-6155] done synthesizing module 'IBUFDS' (0#1) [/opt/Xilinx/Vivado/2024.1/scripts/rt/data/unisim_comp.v:73658]
INFO: [Synth 8-6157] synthesizing module 'lib_pipe' [/home/ubuntu/src/aws-fpga/hdk/common/lib/lib_pipe.sv:23]
INFO: [Synth 8-6155] done synthesizing module 'lib_pipe' (0#1) [/home/ubuntu/src/aws-fpga/hdk/common/lib/lib_pipe.sv:23]
WARNING: [Synth 8-3848] Net cl_sh_pcim_awid in module/entity top does not have driver. [/home/ubuntu/src/aws-fpga/hdk/common/shell_stable/design/interfaces/cl_ports.vh:62]
WARNING: [Synth 8-3848] Net cl_sh_pcim_awaddr in module/entity top does not have driver. [/home/ubuntu/src/aws-fpga/hdk/common/shell_stable/design/interfaces/cl_ports.vh:63]
WARNING: [Synth 8-3848] Net cl_sh_pcim_awlen in module/entity top does not have driver. [/home/ubuntu/src/aws-fpga/hdk/common/shell_stable/design/interfaces/cl_ports.vh:64]
WARNING: [Synth 8-3848] Net cl_sh_pcim_awsize in module/entity top does not have driver. [/home/ubuntu/src/aws-fpga/hdk/common/shell_stable/design/interfaces/cl_ports.vh:65]
WARNING: [Synth 8-3848] Net cl_sh_pcim_awburst in module/entity top does not have driver. [/home/ubuntu/src/aws-fpga/hdk/common/shell_stable/design/interfaces/cl_ports.vh:66]
WARNING: [Synth 8-3848] Net cl_sh_pcim_awcache in module/entity top does not have driver. [/home/ubuntu/src/aws-fpga/hdk/common/shell_stable/design/interfaces/cl_ports.vh:67]
WARNING: [Synth 8-3848] Net cl_sh_pcim_awlock in module/entity top does not have driver. [/home/ubuntu/src/aws-fpga/hdk/common/shell_stable/design/interfaces/cl_ports.vh:68]
WARNING: [Synth 8-3848] Net cl_sh_pcim_awprot in module/entity top does not have driver. [/home/ubuntu/src/aws-fpga/hdk/common/shell_stable/design/interfaces/cl_ports.vh:69]
WARNING: [Synth 8-3848] Net cl_sh_pcim_awqos in module/entity top does not have driver. [/home/ubuntu/src/aws-fpga/hdk/common/shell_stable/design/interfaces/cl_ports.vh:70]
WARNING: [Synth 8-3848] Net cl_sh_pcim_awuser in module/entity top does not have driver. [/home/ubuntu/src/aws-fpga/hdk/common/shell_stable/design/interfaces/cl_ports.vh:71]
WARNING: [Synth 8-3848] Net cl_sh_pcim_awvalid in module/entity top does not have driver. [/home/ubuntu/src/aws-fpga/hdk/common/shell_stable/design/interfaces/cl_ports.vh:72]
WARNING: [Synth 8-3848] Net cl_sh_pcim_wid in module/entity top does not have driver. [/home/ubuntu/src/aws-fpga/hdk/common/shell_stable/design/interfaces/cl_ports.vh:75]
WARNING: [Synth 8-3848] Net cl_sh_pcim_wdata in module/entity top does not have driver. [/home/ubuntu/src/aws-fpga/hdk/common/shell_stable/design/interfaces/cl_ports.vh:76]
WARNING: [Synth 8-3848] Net cl_sh_pcim_wstrb in module/entity top does not have driver. [/home/ubuntu/src/aws-fpga/hdk/common/shell_stable/design/interfaces/cl_ports.vh:77]
WARNING: [Synth 8-3848] Net cl_sh_pcim_wlast in module/entity top does not have driver. [/home/ubuntu/src/aws-fpga/hdk/common/shell_stable/design/interfaces/cl_ports.vh:78]
WARNING: [Synth 8-3848] Net cl_sh_pcim_wuser in module/entity top does not have driver. [/home/ubuntu/src/aws-fpga/hdk/common/shell_stable/design/interfaces/cl_ports.vh:79]
WARNING: [Synth 8-3848] Net cl_sh_pcim_wvalid in module/entity top does not have driver. [/home/ubuntu/src/aws-fpga/hdk/common/shell_stable/design/interfaces/cl_ports.vh:80]
WARNING: [Synth 8-3848] Net cl_sh_pcim_bready in module/entity top does not have driver. [/home/ubuntu/src/aws-fpga/hdk/common/shell_stable/design/interfaces/cl_ports.vh:86]
WARNING: [Synth 8-3848] Net cl_sh_pcim_arid in module/entity top does not have driver. [/home/ubuntu/src/aws-fpga/hdk/common/shell_stable/design/interfaces/cl_ports.vh:88]
WARNING: [Synth 8-3848] Net cl_sh_pcim_araddr in module/entity top does not have driver. [/home/ubuntu/src/aws-fpga/hdk/common/shell_stable/design/interfaces/cl_ports.vh:89]
WARNING: [Synth 8-3848] Net cl_sh_pcim_arlen in module/entity top does not have driver. [/home/ubuntu/src/aws-fpga/hdk/common/shell_stable/design/interfaces/cl_ports.vh:90]
WARNING: [Synth 8-3848] Net cl_sh_pcim_arsize in module/entity top does not have driver. [/home/ubuntu/src/aws-fpga/hdk/common/shell_stable/design/interfaces/cl_ports.vh:91]
WARNING: [Synth 8-3848] Net cl_sh_pcim_arburst in module/entity top does not have driver. [/home/ubuntu/src/aws-fpga/hdk/common/shell_stable/design/interfaces/cl_ports.vh:92]
WARNING: [Synth 8-3848] Net cl_sh_pcim_arcache in module/entity top does not have driver. [/home/ubuntu/src/aws-fpga/hdk/common/shell_stable/design/interfaces/cl_ports.vh:93]
WARNING: [Synth 8-3848] Net cl_sh_pcim_arlock in module/entity top does not have driver. [/home/ubuntu/src/aws-fpga/hdk/common/shell_stable/design/interfaces/cl_ports.vh:94]
WARNING: [Synth 8-3848] Net cl_sh_pcim_arprot in module/entity top does not have driver. [/home/ubuntu/src/aws-fpga/hdk/common/shell_stable/design/interfaces/cl_ports.vh:95]
WARNING: [Synth 8-3848] Net cl_sh_pcim_arqos in module/entity top does not have driver. [/home/ubuntu/src/aws-fpga/hdk/common/shell_stable/design/interfaces/cl_ports.vh:96]
WARNING: [Synth 8-3848] Net cl_sh_pcim_aruser in module/entity top does not have driver. [/home/ubuntu/src/aws-fpga/hdk/common/shell_stable/design/interfaces/cl_ports.vh:97]
WARNING: [Synth 8-3848] Net cl_sh_pcim_arvalid in module/entity top does not have driver. [/home/ubuntu/src/aws-fpga/hdk/common/shell_stable/design/interfaces/cl_ports.vh:98]
WARNING: [Synth 8-3848] Net cl_sh_pcim_rready in module/entity top does not have driver. [/home/ubuntu/src/aws-fpga/hdk/common/shell_stable/design/interfaces/cl_ports.vh:107]
WARNING: [Synth 8-3917] design top has port cl_sh_flr_done driven by constant 1
WARNING: [Synth 8-3917] design top has port cl_sh_status0[31] driven by constant 0
WARNING: [Synth 8-3917] design top has port cl_sh_status0[30] driven by constant 0
WARNING: [Synth 8-3917] design top has port cl_sh_status0[29] driven by constant 0
WARNING: [Synth 8-3917] design top has port cl_sh_status0[28] driven by constant 0
WARNING: [Synth 8-3917] design top has port cl_sh_status0[27] driven by constant 0
WARNING: [Synth 8-3917] design top has port cl_sh_status0[26] driven by constant 0
WARNING: [Synth 8-3917] design top has port cl_sh_status0[25] driven by constant 0
WARNING: [Synth 8-3917] design top has port cl_sh_status0[24] driven by constant 0
WARNING: [Synth 8-3917] design top has port cl_sh_status0[23] driven by constant 0
WARNING: [Synth 8-3917] design top has port cl_sh_status0[22] driven by constant 0
WARNING: [Synth 8-3917] design top has port cl_sh_status0[21] driven by constant 0
WARNING: [Synth 8-3917] design top has port cl_sh_status0[20] driven by constant 0
WARNING: [Synth 8-3917] design top has port cl_sh_status0[19] driven by constant 0
WARNING: [Synth 8-3917] design top has port cl_sh_status0[18] driven by constant 0
WARNING: [Synth 8-3917] design top has port cl_sh_status0[17] driven by constant 0
WARNING: [Synth 8-3917] design top has port cl_sh_status0[16] driven by constant 0
WARNING: [Synth 8-3917] design top has port cl_sh_status0[15] driven by constant 0
WARNING: [Synth 8-3917] design top has port cl_sh_status0[14] driven by constant 0
WARNING: [Synth 8-3917] design top has port cl_sh_status0[13] driven by constant 0
WARNING: [Synth 8-3917] design top has port cl_sh_status0[12] driven by constant 0
WARNING: [Synth 8-3917] design top has port cl_sh_status0[11] driven by constant 0
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
WARNING: [Synth 8-7129] Port cl_sh_ddr_axi_rdata[461] in module sh_ddr is either unconnected or has no load
WARNING: [Synth 8-7129] Port cl_sh_ddr_axi_rdata[460] in module sh_ddr is either unconnected or has no load
WARNING: [Synth 8-7129] Port cl_sh_ddr_axi_rdata[459] in module sh_ddr is either unconnected or has no load
WARNING: [Synth 8-7129] Port cl_sh_ddr_axi_rdata[458] in module sh_ddr is either unconnected or has no load
WARNING: [Synth 8-7129] Port cl_sh_ddr_axi_rdata[457] in module sh_ddr is either unconnected or has no load
WARNING: [Synth 8-7129] Port cl_sh_ddr_axi_rdata[456] in module sh_ddr is either unconnected or has no load
WARNING: [Synth 8-7129] Port cl_sh_ddr_axi_rdata[455] in module sh_ddr is either unconnected or has no load
WARNING: [Synth 8-7129] Port cl_sh_ddr_axi_rdata[454] in module sh_ddr is either unconnected or has no load
WARNING: [Synth 8-7129] Port cl_sh_ddr_axi_rdata[453] in module sh_ddr is either unconnected or has no load
WARNING: [Synth 8-7129] Port cl_sh_ddr_axi_rdata[452] in module sh_ddr is either unconnected or has no load
WARNING: [Synth 8-7129] Port cl_sh_ddr_axi_rdata[451] in module sh_ddr is either unconnected or has no load
WARNING: [Synth 8-7129] Port cl_sh_ddr_axi_rdata[450] in module sh_ddr is either unconnected or has no load
INFO: [Common 17-14] Message 'Synth 8-7129' appears 100 times and further instances of the messages will be disabled. Use the Tcl command set_msg_config to change the current settings.
---------------------------------------------------------------------------------
Finished RTL Elaboration : Time (s): cpu = 00:00:05 ; elapsed = 00:00:11 . Memory (MB): peak = 3300.926 ; gain = 516.652 ; free physical = 121720 ; free virtual = 133914
---------------------------------------------------------------------------------
---------------------------------------------------------------------------------
Start Handling Custom Attributes
---------------------------------------------------------------------------------
---------------------------------------------------------------------------------
Finished Handling Custom Attributes : Time (s): cpu = 00:00:05 ; elapsed = 00:00:11 . Memory (MB): peak = 3318.738 ; gain = 534.465 ; free physical = 121720 ; free virtual = 133914
---------------------------------------------------------------------------------
---------------------------------------------------------------------------------
Finished RTL Optimization Phase 1 : Time (s): cpu = 00:00:05 ; elapsed = 00:00:11 . Memory (MB): peak = 3318.738 ; gain = 534.465 ; free physical = 121720 ; free virtual = 133914
---------------------------------------------------------------------------------
Netlist sorting complete. Time (s): cpu = 00:00:00.04 ; elapsed = 00:00:00.04 . Memory (MB): peak = 3324.676 ; gain = 0.000 ; free physical = 121712 ; free virtual = 133905
INFO: [Netlist 29-17] Analyzing 93 Unisim elements for replacement
INFO: [Netlist 29-28] Unisim Transformation completed in 0 CPU seconds
INFO: [Project 1-570] Preparing netlist for logic optimization
Processing XDC Constraints
Initializing timing engine
Parsing XDC File [/home/ubuntu/src/aws-fpga/hdk/cl/examples/top/build/constraints/generated_cl_clocks_aws.xdc]
Finished Parsing XDC File [/home/ubuntu/src/aws-fpga/hdk/cl/examples/top/build/constraints/generated_cl_clocks_aws.xdc]
Parsing XDC File [/home/ubuntu/src/aws-fpga/hdk/common/shell_stable/build/constraints/cl_pins.xdc]
Finished Parsing XDC File [/home/ubuntu/src/aws-fpga/hdk/common/shell_stable/build/constraints/cl_pins.xdc]
INFO: [Project 1-236] Implementation specific constraints were found while reading constraint file [/home/ubuntu/src/aws-fpga/hdk/common/shell_stable/build/constraints/cl_pins.xdc]. These constraints will be ignored for synthesis but will be used in implementation. Impacted constraints are listed in the file [.Xil/top_propImpl.xdc].
Resolution: To avoid this warning, move constraints listed in [.Xil/top_propImpl.xdc] to another XDC file and exclude this new file from synthesis with the used_in_synthesis property (File Properties dialog in GUI) and re-run elaboration/synthesis.
INFO: [Timing 38-2] Deriving generated clocks
Parsing XDC File [/home/ubuntu/src/aws-fpga/hdk/common/shell_stable/build/constraints/cl_ddr_timing_aws.xdc]
WARNING: [Vivado 12-508] No pins matched 'get_pins -of_objects [get_cells -hierarchical -filter { NAME =~ *ram_reg*}] -filter {REF_PIN_NAME == CLK}'. [/home/ubuntu/src/aws-fpga/hdk/common/shell_stable/build/constraints/cl_ddr_timing_aws.xdc:26]
WARNING: [Vivado 12-508] No pins matched '*'. [/home/ubuntu/src/aws-fpga/hdk/common/shell_stable/build/constraints/cl_ddr_timing_aws.xdc:30]
Finished Parsing XDC File [/home/ubuntu/src/aws-fpga/hdk/common/shell_stable/build/constraints/cl_ddr_timing_aws.xdc]
WARNING: [Project 1-498] One or more constraints failed evaluation while reading constraint file [/home/ubuntu/src/aws-fpga/hdk/common/shell_stable/build/constraints/cl_ddr_timing_aws.xdc] and the design contains unresolved black boxes. These constraints will be read post-synthesis (as long as their source constraint file is marked as used_in_implementation) and should be applied correctly then. You should review the constraints listed in the file [.Xil/top_propImpl.xdc] and check the run log file to verify that these constraints were correctly applied.
Parsing XDC File [/home/ubuntu/src/aws-fpga/hdk/cl/examples/top/build/constraints/cl_synth_user.xdc]
Finished Parsing XDC File [/home/ubuntu/src/aws-fpga/hdk/cl/examples/top/build/constraints/cl_synth_user.xdc]
Parsing XDC File [/home/ubuntu/src/aws-fpga/hdk/cl/examples/top/build/constraints/cl_timing_user.xdc]
Finished Parsing XDC File [/home/ubuntu/src/aws-fpga/hdk/cl/examples/top/build/constraints/cl_timing_user.xdc]
Completed Processing XDC Constraints

Netlist sorting complete. Time (s): cpu = 00:00:00 ; elapsed = 00:00:00 . Memory (MB): peak = 3668.348 ; gain = 0.000 ; free physical = 121446 ; free virtual = 133698
INFO: [Project 1-111] Unisim Transformation Summary:
A total of 93 instances were transformed.
BUFG => BUFGCE: 1 instance
IBUFDS => IBUFDS (DIFFINBUF, IBUFCTRL): 1 instance
IOBUFDS => IOBUFDS (DIFFINBUF, IBUFCTRL, INV, OBUFT(x2)): 18 instances
IOBUFE3 => IOBUFE3 (IBUFCTRL, INBUF, OBUFT_DCIEN): 72 instances
MMCME4_BASE => MMCME4_ADV: 1 instance

Constraint Validation Runtime : Time (s): cpu = 00:00:00.01 ; elapsed = 00:00:00.02 . Memory (MB): peak = 3668.348 ; gain = 0.000 ; free physical = 121446 ; free virtual = 133698
---------------------------------------------------------------------------------
Finished Constraint Validation : Time (s): cpu = 00:00:21 ; elapsed = 00:00:40 . Memory (MB): peak = 3668.348 ; gain = 884.074 ; free physical = 121445 ; free virtual = 133697
---------------------------------------------------------------------------------
---------------------------------------------------------------------------------
Start Loading Part and Timing Information
---------------------------------------------------------------------------------
Loading part: xcvu47p-fsvh2892-2-e
INFO: [Synth 8-6742] Reading net delay rules and data
---------------------------------------------------------------------------------
Finished Loading Part and Timing Information : Time (s): cpu = 00:00:21 ; elapsed = 00:00:41 . Memory (MB): peak = 3676.352 ; gain = 892.078 ; free physical = 121445 ; free virtual = 133698
---------------------------------------------------------------------------------
---------------------------------------------------------------------------------
Start Applying 'set_property' XDC Constraints
---------------------------------------------------------------------------------
---------------------------------------------------------------------------------
Finished applying 'set_property' XDC Constraints : Time (s): cpu = 00:00:21 ; elapsed = 00:00:41 . Memory (MB): peak = 3676.352 ; gain = 892.078 ; free physical = 121445 ; free virtual = 133698
---------------------------------------------------------------------------------
INFO: [Synth 8-802] inferred FSM for state register 'state_reg' in module 'rvbl2_control_unit'
INFO: [Synth 8-802] inferred FSM for state register 'tx_state_reg' in module 'rvbl2_uart'
INFO: [Synth 8-802] inferred FSM for state register 'rx_state_reg' in module 'rvbl2_uart'
INFO: [Synth 8-802] inferred FSM for state register 'r_State_reg' in module 'Receiver'
INFO: [Synth 8-802] inferred FSM for state register 'state_write_reg' in module 'top'
INFO: [Synth 8-6159] Found Keep on FSM register 'next_state_reg' in module 'rvbl2_control_unit', re-encoding will not be performed
---------------------------------------------------------------------------------------------------
State | New Encoding | Previous Encoding
---------------------------------------------------------------------------------------------------
*
S_RESET | 000 | 000
S_FETCH | 001 | 001
S_DECODE | 010 | 010
S_EXECUTE | 011 | 011
S_MEMORY | 100 | 100
S_WRITEBACK | 101 | 101
---------------------------------------------------------------------------------------------------
INFO: [Synth 8-6159] Found Keep on FSM register 'state_reg' in module 'rvbl2_control_unit', re-encoding will not be performed
---------------------------------------------------------------------------------------------------
State | New Encoding | Previous Encoding
---------------------------------------------------------------------------------------------------
*
S_RESET | 000 | 000
S_FETCH | 001 | 001
S_DECODE | 010 | 010
S_EXECUTE | 011 | 011
S_MEMORY | 100 | 100
S_WRITEBACK | 101 | 101
---------------------------------------------------------------------------------------------------
---------------------------------------------------------------------------------------------------
State | New Encoding | Previous Encoding
---------------------------------------------------------------------------------------------------
RX_IDLE | 00 | 00
RX_START | 01 | 01
RX_DATA | 10 | 10
RX_STOP | 11 | 11
---------------------------------------------------------------------------------------------------
INFO: [Synth 8-3354] encoded FSM with state register 'rx_state_reg' using encoding 'sequential' in module 'rvbl2_uart'
---------------------------------------------------------------------------------------------------
State | New Encoding | Previous Encoding
---------------------------------------------------------------------------------------------------
TX_IDLE | 00 | 00
TX_START | 01 | 01
TX_DATA | 10 | 10
TX_STOP | 11 | 11
---------------------------------------------------------------------------------------------------
INFO: [Synth 8-3354] encoded FSM with state register 'tx_state_reg' using encoding 'sequential' in module 'rvbl2_uart'
---------------------------------------------------------------------------------------------------
State | New Encoding | Previous Encoding
---------------------------------------------------------------------------------------------------
S_IDLE | 00 | 00
S_START | 01 | 01
S_DATA | 10 | 10
iSTATE | 11 | 11
*
---------------------------------------------------------------------------------------------------
INFO: [Synth 8-3354] encoded FSM with state register 'r_State_reg' using encoding 'sequential' in module 'Receiver'
---------------------------------------------------------------------------------------------------
State | New Encoding | Previous Encoding
---------------------------------------------------------------------------------------------------
W_IDLE | 00 | 00
W_WAIT | 01 | 01
W_WRITE | 10 | 10
W_SEND_RESP | 11 | 11
---------------------------------------------------------------------------------------------------
INFO: [Synth 8-3354] encoded FSM with state register 'state_write_reg' using encoding 'sequential' in module 'top'
---------------------------------------------------------------------------------
Finished RTL Optimization Phase 2 : Time (s): cpu = 00:00:22 ; elapsed = 00:00:42 . Memory (MB): peak = 3676.352 ; gain = 892.078 ; free physical = 121444 ; free virtual = 133698
---------------------------------------------------------------------------------
---------------------------------------------------------------------------------
Start RTL Component Statistics
---------------------------------------------------------------------------------
Detailed RTL Component Info :
+---Adders :
4 Input 64 Bit Adders := 1
2 Input 32 Bit Adders := 2
3 Input 32 Bit Adders := 1
2 Input 12 Bit Adders := 2
2 Input 9 Bit Adders := 2
2 Input 6 Bit Adders := 1
2 Input 4 Bit Adders := 2
2 Input 3 Bit Adders := 3
2 Input 2 Bit Adders := 4
3 Input 2 Bit Adders := 2
3 Input 1 Bit Adders := 4
+---XORs :
2 Input 32 Bit XORs := 1
2 Input 16 Bit XORs := 56
2 Input 2 Bit XORs := 4
2 Input 1 Bit XORs := 60
+---Registers :
64 Bit Registers := 1
42 Bit Registers := 3
32 Bit Registers := 42
12 Bit Registers := 2
9 Bit Registers := 2
8 Bit Registers := 17
6 Bit Registers := 1
4 Bit Registers := 2
3 Bit Registers := 3
2 Bit Registers := 19
1 Bit Registers := 47
+---RAMs :
64K Bit (2048 X 32 bit) RAMs := 1
+---Muxes :
2 Input 64 Bit Muxes := 4
2 Input 42 Bit Muxes := 1
2 Input 32 Bit Muxes := 28
3 Input 32 Bit Muxes := 2
4 Input 32 Bit Muxes := 6
8 Input 32 Bit Muxes := 1
4 Input 16 Bit Muxes := 1
4 Input 12 Bit Muxes := 1
2 Input 9 Bit Muxes := 2
4 Input 9 Bit Muxes := 2
2 Input 8 Bit Muxes := 3
4 Input 8 Bit Muxes := 2
2 Input 6 Bit Muxes := 1
2 Input 4 Bit Muxes := 1
7 Input 3 Bit Muxes := 1
2 Input 3 Bit Muxes := 3
5 Input 3 Bit Muxes := 1
10 Input 3 Bit Muxes := 1
4 Input 3 Bit Muxes := 3
2 Input 2 Bit Muxes := 6
4 Input 2 Bit Muxes := 4
2 Input 1 Bit Muxes := 36
4 Input 1 Bit Muxes := 34
---------------------------------------------------------------------------------
Finished RTL Component Statistics
---------------------------------------------------------------------------------
---------------------------------------------------------------------------------
Start Part Resource Summary
---------------------------------------------------------------------------------
Part Resources:
DSPs: 9024 (col length:94)
BRAMs: 4032 (col length: RAMB18 288 RAMB36 144)
---------------------------------------------------------------------------------
Finished Part Resource Summary
---------------------------------------------------------------------------------
---------------------------------------------------------------------------------
Start Cross Boundary and Area Optimization
---------------------------------------------------------------------------------
WARNING: [Synth 8-7080] Parallel synthesis criteria is not met
DSP Report: Generating DSP product_full, operation Mode is: A*B.
DSP Report: operator product_full is absorbed into DSP product_full.
DSP Report: operator product_full is absorbed into DSP product_full.
DSP Report: Generating DSP product_full, operation Mode is: PCIN+A*B.
DSP Report: operator product_full is absorbed into DSP product_full.
DSP Report: operator product_full is absorbed into DSP product_full.
DSP Report: Generating DSP product_full, operation Mode is: A*B.
DSP Report: operator product_full is absorbed into DSP product_full.
DSP Report: operator product_full is absorbed into DSP product_full.
DSP Report: Generating DSP product_full, operation Mode is: PCIN+A*B.
DSP Report: operator product_full is absorbed into DSP product_full.
DSP Report: operator product_full is absorbed into DSP product_full.
DSP Report: Generating DSP product_full, operation Mode is: (PCIN>>17)+A*B.
DSP Report: operator product_full is absorbed into DSP product_full.
DSP Report: operator product_full is absorbed into DSP product_full.
DSP Report: Generating DSP product_full, operation Mode is: PCIN+A*B.
DSP Report: operator product_full is absorbed into DSP product_full.
DSP Report: operator product_full is absorbed into DSP product_full.
DSP Report: Generating DSP product_full, operation Mode is: A*B.
DSP Report: operator product_full is absorbed into DSP product_full.
DSP Report: operator product_full is absorbed into DSP product_full.
DSP Report: Generating DSP product_full, operation Mode is: (PCIN>>17)+A*B.
DSP Report: operator product_full is absorbed into DSP product_full.
DSP Report: operator product_full is absorbed into DSP product_full.
DSP Report: Generating DSP product_full, operation Mode is: PCIN+A*B.
DSP Report: operator product_full is absorbed into DSP product_full.
DSP Report: operator product_full is absorbed into DSP product_full.
DSP Report: Generating DSP product_full, operation Mode is: (PCIN>>17)+A*B.
DSP Report: operator product_full is absorbed into DSP product_full.
DSP Report: operator product_full is absorbed into DSP product_full.
INFO: [Synth 8-7124] RAM ("riscvtop/e_PROCESSOR/u_dmem/mem_reg") is implemented using BRAM instead of URAM. Memory would be severely underutilized if URAMs are used
---------------------------------------------------------------------------------
Finished Cross Boundary and Area Optimization : Time (s): cpu = 00:00:48 ; elapsed = 00:01:07 . Memory (MB): peak = 3676.352 ; gain = 892.078 ; free physical = 121402 ; free virtual = 133658
---------------------------------------------------------------------------------
Sort Area is product_full_0 : 0 0 : 2701 10690 : Used 1 time 0
Sort Area is product_full_0 : 0 1 : 2710 10690 : Used 1 time 0
Sort Area is product_full_0 : 0 2 : 2712 10690 : Used 1 time 0
Sort Area is product_full_0 : 0 3 : 2567 10690 : Used 1 time 0
Sort Area is product_full_5 : 0 0 : 2701 8023 : Used 1 time 0
Sort Area is product_full_5 : 0 1 : 2712 8023 : Used 1 time 0
Sort Area is product_full_5 : 0 2 : 1305 8023 : Used 1 time 0
Sort Area is product_full_5 : 0 3 : 1305 8023 : Used 1 time 0
Sort Area is product_full_8 : 0 0 : 2701 4742 : Used 1 time 0
Sort Area is product_full_8 : 0 1 : 2041 4742 : Used 1 time 0
---------------------------------------------------------------------------------
Start ROM, RAM, DSP, Shift Register and Retiming Reporting
---------------------------------------------------------------------------------

ROM: Preliminary Mapping Report
+------------+------------+---------------+----------------+
|Module Name | RTL Object | Depth x Width | Implemented As |
+------------+------------+---------------+----------------+
|rvbl2_imem | rom_word | 4096x32 | LUT |
|rvbl2_imem | rom_word | 4096x32 | LUT |
+------------+------------+---------------+----------------+

Block RAM: Preliminary Mapping Report (see note below)
+------------+----------------------------+------------------------+---+---+------------------------+---+---+------------------+--------+--------+-----------------+
|Module Name | RTL Object | PORT A (Depth x Width) | W | R | PORT B (Depth x Width) | W | R | Ports driving FF | RAMB18 | RAMB36 | Cascade Heights |
+------------+----------------------------+------------------------+---+---+------------------------+---+---+------------------+--------+--------+-----------------+
|riscvtop | e_PROCESSOR/u_dmem/mem_reg | 2 K x 32(READ_FIRST) | W | | 2 K x 32(WRITE_FIRST) | | R | Port A and B | 0 | 2 | |
+------------+----------------------------+------------------------+---+---+------------------------+---+---+------------------+--------+--------+-----------------+

Note: The table above is a preliminary report that shows the Block RAMs at the current stage of the synthesis flow. Some Block RAMs may be reimplemented as non Block RAM primitives later in the synthesis flow. Multiple instantiated Block RAMs are reported only once.

DSP: Preliminary Mapping Report (see note below. The ' indicates corresponding REG is set)
+-----------------+----------------+--------+--------+--------+--------+--------+------+------+------+------+-------+------+------+
|Module Name | DSP Mapping | A Size | B Size | C Size | D Size | P Size | AREG | BREG | CREG | DREG | ADREG | MREG | PREG |
+-----------------+----------------+--------+--------+--------+--------+--------+------+------+------+------+-------+------+------+
|rvbl2_multiplier | A*B | 18 | 18 | - | - | 48 | 0 | 0 | - | - | - | 0 | 0 |
|rvbl2_multiplier | PCIN+A*B | 18 | 14 | - | - | 48 | 0 | 0 | - | - | - | 0 | 0 |
|rvbl2_multiplier | A*B | 18 | 18 | - | - | 48 | 0 | 0 | - | - | - | 0 | 0 |
|rvbl2_multiplier | PCIN+A*B | 18 | 18 | - | - | 48 | 0 | 0 | - | - | - | 0 | 0 |
|rvbl2_multiplier | (PCIN>>17)+A*B | 13 | 13 | - | - | 13 | 0 | 0 | - | - | - | 0 | 0 |
|rvbl2_multiplier | PCIN+A*B | 13 | 13 | - | - | 13 | 0 | 0 | - | - | - | 0 | 0 |
|rvbl2_multiplier | A*B | 18 | 18 | - | - | 48 | 0 | 0 | - | - | - | 0 | 0 |
|rvbl2_multiplier | (PCIN>>17)+A*B | 18 | 18 | - | - | 48 | 0 | 0 | - | - | - | 0 | 0 |
|rvbl2_multiplier | PCIN+A*B | 18 | 18 | - | - | 48 | 0 | 0 | - | - | - | 0 | 0 |
|rvbl2_multiplier | (PCIN>>17)+A*B | 18 | 18 | - | - | 30 | 0 | 0 | - | - | - | 0 | 0 |
+-----------------+----------------+--------+--------+--------+--------+--------+------+------+------+------+-------+------+------+

Note: The table above is a preliminary report that shows the DSPs inferred at the current stage of the synthesis flow. Some DSP may be reimplemented as non DSP primitives later in the synthesis flow. Multiple instantiated DSPs are reported only once.
---------------------------------------------------------------------------------
Finished ROM, RAM, DSP, Shift Register and Retiming Reporting
---------------------------------------------------------------------------------
---------------------------------------------------------------------------------
Start Applying XDC Timing Constraints
---------------------------------------------------------------------------------
---------------------------------------------------------------------------------
Finished Applying XDC Timing Constraints : Time (s): cpu = 00:00:54 ; elapsed = 00:01:20 . Memory (MB): peak = 3747.852 ; gain = 963.578 ; free physical = 121270 ; free virtual = 133544
---------------------------------------------------------------------------------
---------------------------------------------------------------------------------
Start Timing Optimization
---------------------------------------------------------------------------------
---------------------------------------------------------------------------------
Finished Timing Optimization : Time (s): cpu = 00:00:55 ; elapsed = 00:01:21 . Memory (MB): peak = 3777.898 ; gain = 993.625 ; free physical = 121255 ; free virtual = 133528
---------------------------------------------------------------------------------
---------------------------------------------------------------------------------
Start ROM, RAM, DSP, Shift Register and Retiming Reporting
---------------------------------------------------------------------------------

Block RAM: Final Mapping Report
+------------+----------------------------+------------------------+---+---+------------------------+---+---+------------------+--------+--------+-----------------+
|Module Name | RTL Object | PORT A (Depth x Width) | W | R | PORT B (Depth x Width) | W | R | Ports driving FF | RAMB18 | RAMB36 | Cascade Heights |
+------------+----------------------------+------------------------+---+---+------------------------+---+---+------------------+--------+--------+-----------------+
|riscvtop | e_PROCESSOR/u_dmem/mem_reg | 2 K x 32(READ_FIRST) | W | | 2 K x 32(WRITE_FIRST) | | R | Port A and B | 0 | 2 | |
+------------+----------------------------+------------------------+---+---+------------------------+---+---+------------------+--------+--------+-----------------+

---------------------------------------------------------------------------------
Finished ROM, RAM, DSP, Shift Register and Retiming Reporting
---------------------------------------------------------------------------------
---------------------------------------------------------------------------------
Start Technology Mapping
---------------------------------------------------------------------------------
INFO: [Synth 8-7052] The timing for the instance riscvtop/e_PROCESSOR/u_dmem/mem_reg_0 (implemented as a Block RAM) might be sub-optimal as no optional output register could be merged into the ram block. Providing additional output register may help in improving timing.
INFO: [Synth 8-7052] The timing for the instance riscvtop/e_PROCESSOR/u_dmem/mem_reg_1 (implemented as a Block RAM) might be sub-optimal as no optional output register could be merged into the ram block. Providing additional output register may help in improving timing.
---------------------------------------------------------------------------------
Finished Technology Mapping : Time (s): cpu = 00:00:57 ; elapsed = 00:01:23 . Memory (MB): peak = 3894.898 ; gain = 1110.625 ; free physical = 121139 ; free virtual = 133413
---------------------------------------------------------------------------------
---------------------------------------------------------------------------------
Start IO Insertion
---------------------------------------------------------------------------------
---------------------------------------------------------------------------------
Start Flattening Before IO Insertion
---------------------------------------------------------------------------------
---------------------------------------------------------------------------------
Finished Flattening Before IO Insertion
---------------------------------------------------------------------------------
---------------------------------------------------------------------------------
Start Final Netlist Cleanup
---------------------------------------------------------------------------------
---------------------------------------------------------------------------------
Finished Final Netlist Cleanup
---------------------------------------------------------------------------------
CRITICAL WARNING: [Synth 8-5799] Converted tricell instance 'i_47' to logic
CRITICAL WARNING: [Synth 8-5799] Converted tricell instance 'i_49' to logic
CRITICAL WARNING: [Synth 8-5799] Converted tricell instance 'i_51' to logic
CRITICAL WARNING: [Synth 8-5799] Converted tricell instance 'i_53' to logic
CRITICAL WARNING: [Synth 8-5799] Converted tricell instance 'i_55' to logic
CRITICAL WARNING: [Synth 8-5799] Converted tricell instance 'i_57' to logic
CRITICAL WARNING: [Synth 8-5799] Converted tricell instance 'i_59' to logic
CRITICAL WARNING: [Synth 8-5799] Converted tricell instance 'i_61' to logic
CRITICAL WARNING: [Synth 8-5799] Converted tricell instance 'i_21' to logic
CRITICAL WARNING: [Synth 8-5799] Converted tricell instance 'i_22' to logic
CRITICAL WARNING: [Synth 8-5799] Converted tricell instance 'i_23' to logic
CRITICAL WARNING: [Synth 8-5799] Converted tricell instance 'i_24' to logic
CRITICAL WARNING: [Synth 8-5799] Converted tricell instance 'i_25' to logic
CRITICAL WARNING: [Synth 8-5799] Converted tricell instance 'i_26' to logic
CRITICAL WARNING: [Synth 8-5799] Converted tricell instance 'i_27' to logic
CRITICAL WARNING: [Synth 8-5799] Converted tricell instance 'i_28' to logic
---------------------------------------------------------------------------------
Finished IO Insertion : Time (s): cpu = 00:01:00 ; elapsed = 00:01:26 . Memory (MB): peak = 3894.898 ; gain = 1110.625 ; free physical = 121153 ; free virtual = 133427
---------------------------------------------------------------------------------
---------------------------------------------------------------------------------
Start Renaming Generated Instances
---------------------------------------------------------------------------------
---------------------------------------------------------------------------------
Finished Renaming Generated Instances : Time (s): cpu = 00:01:00 ; elapsed = 00:01:26 . Memory (MB): peak = 3894.898 ; gain = 1110.625 ; free physical = 121153 ; free virtual = 133427
---------------------------------------------------------------------------------
---------------------------------------------------------------------------------
Start Rebuilding User Hierarchy
---------------------------------------------------------------------------------
---------------------------------------------------------------------------------
Finished Rebuilding User Hierarchy : Time (s): cpu = 00:01:01 ; elapsed = 00:01:27 . Memory (MB): peak = 3894.898 ; gain = 1110.625 ; free physical = 121174 ; free virtual = 133447
---------------------------------------------------------------------------------
---------------------------------------------------------------------------------
Start Renaming Generated Ports
---------------------------------------------------------------------------------
---------------------------------------------------------------------------------
Finished Renaming Generated Ports : Time (s): cpu = 00:01:01 ; elapsed = 00:01:27 . Memory (MB): peak = 3894.898 ; gain = 1110.625 ; free physical = 121174 ; free virtual = 133447
---------------------------------------------------------------------------------
---------------------------------------------------------------------------------
Start Handling Custom Attributes
---------------------------------------------------------------------------------
---------------------------------------------------------------------------------
Finished Handling Custom Attributes : Time (s): cpu = 00:01:01 ; elapsed = 00:01:27 . Memory (MB): peak = 3894.898 ; gain = 1110.625 ; free physical = 121174 ; free virtual = 133447
---------------------------------------------------------------------------------
---------------------------------------------------------------------------------
Start Renaming Generated Nets
---------------------------------------------------------------------------------
---------------------------------------------------------------------------------
Finished Renaming Generated Nets : Time (s): cpu = 00:01:01 ; elapsed = 00:01:27 . Memory (MB): peak = 3894.898 ; gain = 1110.625 ; free physical = 121174 ; free virtual = 133447
---------------------------------------------------------------------------------
---------------------------------------------------------------------------------
Start Writing Synthesis Report
---------------------------------------------------------------------------------

DSP Final Report (the ' indicates corresponding REG is set)
+-----------------+--------------+--------+--------+--------+--------+--------+------+------+------+------+-------+------+------+
|Module Name | DSP Mapping | A Size | B Size | C Size | D Size | P Size | AREG | BREG | CREG | DREG | ADREG | MREG | PREG |
+-----------------+--------------+--------+--------+--------+--------+--------+------+------+------+------+-------+------+------+
|rvbl2_multiplier | A*B | 17 | 17 | - | - | 48 | 0 | 0 | - | - | - | 0 | 0 |
|rvbl2_multiplier | PCIN+A*B | 17 | 13 | - | - | 48 | 0 | 0 | - | - | - | 0 | 0 |
|rvbl2_multiplier | A*B | 17 | 17 | - | - | 48 | 0 | 0 | - | - | - | 0 | 0 |
|rvbl2_multiplier | PCIN+A*B | 17 | 17 | - | - | 48 | 0 | 0 | - | - | - | 0 | 0 |
|rvbl2_multiplier | PCIN>>17+A*B | 30 | 13 | - | - | 13 | 0 | 0 | - | - | - | 0 | 0 |
|rvbl2_multiplier | PCIN+A*B | 13 | 13 | - | - | 13 | 0 | 0 | - | - | - | 0 | 0 |
|rvbl2_multiplier | A*B | 17 | 17 | - | - | 48 | 0 | 0 | - | - | - | 0 | 0 |
|rvbl2_multiplier | PCIN>>17+A*B | 17 | 17 | - | - | 48 | 0 | 0 | - | - | - | 0 | 0 |
|rvbl2_multiplier | PCIN+A*B | 17 | 17 | - | - | 48 | 0 | 0 | - | - | - | 0 | 0 |
|rvbl2_multiplier | PCIN>>17+A*B | 17 | 17 | - | - | 30 | 0 | 0 | - | - | - | 0 | 0 |
+-----------------+--------------+--------+--------+--------+--------+--------+------+------+------+------+-------+------+------+

Report BlackBoxes:
+-+--------------+----------+
| |BlackBox name |Instances |
+-+--------------+----------+
+-+--------------+----------+

Report Cell Usage:
+------+----------------+------+
| |Cell |Count |
+------+----------------+------+
|1 |BUFG | 1|
|2 |CARRY8 | 32|
|3 |DSP_ALU | 10|
|4 |DSP_A_B_DATA | 10|
|5 |DSP_C_DATA | 10|
|6 |DSP_MULTIPLIER | 10|
|7 |DSP_M_DATA | 10|
|8 |DSP_OUTPUT | 10|
|9 |DSP_PREADD | 10|
|10 |DSP_PREADD_DATA | 10|
|11 |LUT1 | 15|
|12 |LUT2 | 274|
|13 |LUT3 | 472|
|14 |LUT4 | 402|
|15 |LUT5 | 515|
|16 |LUT6 | 3404|
|17 |MMCME4_BASE | 1|
|18 |MUXF7 | 720|
|19 |MUXF8 | 224|
|20 |RAMB36E2 | 2|
|21 |FDCE | 192|
|22 |FDPE | 11|
|23 |FDRE | 1256|
|24 |FDSE | 13|
|25 |IBUFDS | 1|
|26 |IOBUFDS | 18|
|27 |IOBUFE3 | 72|
|28 |OBUF | 35|
+------+----------------+------+
---------------------------------------------------------------------------------
Finished Writing Synthesis Report : Time (s): cpu = 00:01:01 ; elapsed = 00:01:27 . Memory (MB): peak = 3894.898 ; gain = 1110.625 ; free physical = 121174 ; free virtual = 133447
---------------------------------------------------------------------------------
Synthesis finished with 0 errors, 16 critical warnings and 5707 warnings.
Synthesis Optimization Runtime : Time (s): cpu = 00:00:49 ; elapsed = 00:01:02 . Memory (MB): peak = 3894.898 ; gain = 761.016 ; free physical = 121173 ; free virtual = 133447
Synthesis Optimization Complete : Time (s): cpu = 00:01:01 ; elapsed = 00:01:27 . Memory (MB): peak = 3894.898 ; gain = 1110.625 ; free physical = 121173 ; free virtual = 133447
INFO: [Project 1-571] Translating synthesized netlist
Netlist sorting complete. Time (s): cpu = 00:00:00.05 ; elapsed = 00:00:00.05 . Memory (MB): peak = 3894.898 ; gain = 0.000 ; free physical = 121464 ; free virtual = 133741
INFO: [Netlist 29-17] Analyzing 1079 Unisim elements for replacement
INFO: [Netlist 29-28] Unisim Transformation completed in 0 CPU seconds
INFO: [Project 1-570] Preparing netlist for logic optimization
Parsing XDC File [/home/ubuntu/src/aws-fpga/hdk/cl/examples/top/build/constraints/generated_cl_clocks_aws.xdc]
Finished Parsing XDC File [/home/ubuntu/src/aws-fpga/hdk/cl/examples/top/build/constraints/generated_cl_clocks_aws.xdc]
Parsing XDC File [/home/ubuntu/src/aws-fpga/hdk/common/shell_stable/build/constraints/cl_pins.xdc]
CRITICAL WARNING: [Vivado 12-1815] Setting property 'IOSTANDARD' is not allowed for GT terminals. [/home/ubuntu/src/aws-fpga/hdk/common/shell_stable/build/constraints/cl_pins.xdc:205]
CRITICAL WARNING: [Vivado 12-1815] Setting property 'IOSTANDARD' is not allowed for GT terminals. [/home/ubuntu/src/aws-fpga/hdk/common/shell_stable/build/constraints/cl_pins.xdc:223]
Finished Parsing XDC File [/home/ubuntu/src/aws-fpga/hdk/common/shell_stable/build/constraints/cl_pins.xdc]
Parsing XDC File [/home/ubuntu/src/aws-fpga/hdk/common/shell_stable/build/constraints/cl_ddr_timing_aws.xdc]
WARNING: [Vivado 12-180] No cells matched '*'. [/home/ubuntu/src/aws-fpga/hdk/common/shell_stable/build/constraints/cl_ddr_timing_aws.xdc:26]
WARNING: [Vivado 12-508] No pins matched 'get_pins -of_objects [get_cells -hierarchical -filter { NAME =~ *ram_reg*}] -filter {REF_PIN_NAME == CLK}'. [/home/ubuntu/src/aws-fpga/hdk/common/shell_stable/build/constraints/cl_ddr_timing_aws.xdc:26]
WARNING: [Vivado 12-180] No cells matched '*'. [/home/ubuntu/src/aws-fpga/hdk/common/shell_stable/build/constraints/cl_ddr_timing_aws.xdc:26]
CRITICAL WARNING: [Vivado 12-4739] set_false_path:No valid object(s) found for '-from [get_pins -of_objects [get_cells -hierarchical -filter { NAME =~ *ram_reg*}] -filter {REF_PIN_NAME == CLK}]'. [/home/ubuntu/src/aws-fpga/hdk/common/shell_stable/build/constraints/cl_ddr_timing_aws.xdc:26]
Resolution: Check if the specified object(s) exists in the current design. If it does, ensure that the correct design hierarchy was specified for the object. If you are working with clocks, make sure create_clock was used to create the clock object before it is referenced.
WARNING: [Vivado 12-508] No pins matched '*'. [/home/ubuntu/src/aws-fpga/hdk/common/shell_stable/build/constraints/cl_ddr_timing_aws.xdc:30]
INFO: [Timing 38-35] Done setting XDC timing constraints. [/home/ubuntu/src/aws-fpga/hdk/common/shell_stable/build/constraints/cl_ddr_timing_aws.xdc:30]
INFO: [Timing 38-2] Deriving generated clocks [/home/ubuntu/src/aws-fpga/hdk/common/shell_stable/build/constraints/cl_ddr_timing_aws.xdc:30]
WARNING: [Vivado 12-1008] No clocks found for command 'get_clocks -of_objects [get_pins -hierarchical -filter NAME=~*SH_DDR/genblk1.IS_DDR_PRESENT.DDR4_0/inst/u_ddr4_infrastructure/gen_mmcme4.u_mmcme_adv_inst/CLKOUT0]'. [/home/ubuntu/src/aws-fpga/hdk/common/shell_stable/build/constraints/cl_ddr_timing_aws.xdc:30]
Resolution: Verify the create_clock command was called to create the clock object before it is referenced.
INFO: [Vivado 12-626] No clocks found. Please use 'create_clock' or 'create_generated_clock' command to create clocks. [/home/ubuntu/src/aws-fpga/hdk/common/shell_stable/build/constraints/cl_ddr_timing_aws.xdc:30]
CRITICAL WARNING: [Vivado 12-4739] set_clock_groups:No valid object(s) found for '-group [get_clocks -of_objects [get_pins -hierarchical -filter NAME=~*SH_DDR/genblk1.IS_DDR_PRESENT.DDR4_0/inst/u_ddr4_infrastructure/gen_mmcme4.u_mmcme_adv_inst/CLKOUT0]]'. [/home/ubuntu/src/aws-fpga/hdk/common/shell_stable/build/constraints/cl_ddr_timing_aws.xdc:30]
Resolution: Check if the specified object(s) exists in the current design. If it does, ensure that the correct design hierarchy was specified for the object. If you are working with clocks, make sure create_clock was used to create the clock object before it is referenced.
CRITICAL WARNING: [Vivado 12-4739] set_clock_groups:No valid object(s) found for '-group '. [/home/ubuntu/src/aws-fpga/hdk/common/shell_stable/build/constraints/cl_ddr_timing_aws.xdc:30]
Resolution: Check if the specified object(s) exists in the current design. If it does, ensure that the correct design hierarchy was specified for the object. If you are working with clocks, make sure create_clock was used to create the clock object before it is referenced.
CRITICAL WARNING: [Vivado 12-5201] set_clock_groups: cannot set the clock group when only one non-empty group remains. [/home/ubuntu/src/aws-fpga/hdk/common/shell_stable/build/constraints/cl_ddr_timing_aws.xdc:30]
Finished Parsing XDC File [/home/ubuntu/src/aws-fpga/hdk/common/shell_stable/build/constraints/cl_ddr_timing_aws.xdc]
Parsing XDC File [/home/ubuntu/src/aws-fpga/hdk/cl/examples/top/build/constraints/cl_synth_user.xdc]
Finished Parsing XDC File [/home/ubuntu/src/aws-fpga/hdk/cl/examples/top/build/constraints/cl_synth_user.xdc]
Parsing XDC File [/home/ubuntu/src/aws-fpga/hdk/cl/examples/top/build/constraints/cl_timing_user.xdc]
Finished Parsing XDC File [/home/ubuntu/src/aws-fpga/hdk/cl/examples/top/build/constraints/cl_timing_user.xdc]
INFO: [Opt 31-138] Pushed 0 inverter(s) to 0 load pin(s).
INFO: [Opt 31-326] The CLKFBOUT to CLKFBIN net for instance riscvtop/u_mmcm with COMPENSATION=INTERNAL is optimized away to aid design routability
Netlist sorting complete. Time (s): cpu = 00:00:00 ; elapsed = 00:00:00 . Memory (MB): peak = 4131.613 ; gain = 0.000 ; free physical = 121366 ; free virtual = 133645
INFO: [Project 1-111] Unisim Transformation Summary:
A total of 103 instances were transformed.
BUFG => BUFGCE: 1 instance
DSP48E2 => DSP48E2 (DSP_ALU, DSP_A_B_DATA, DSP_C_DATA, DSP_MULTIPLIER, DSP_M_DATA, DSP_OUTPUT, DSP_PREADD, DSP_PREADD_DATA): 10 instances
IBUFDS => IBUFDS (DIFFINBUF, IBUFCTRL): 1 instance
IOBUFDS => IOBUFDS (DIFFINBUF, IBUFCTRL, INV, OBUFT(x2)): 18 instances
IOBUFE3 => IOBUFE3 (IBUFCTRL, INBUF, OBUFT_DCIEN): 72 instances
MMCME4_BASE => MMCME4_ADV: 1 instance

Synth Design complete | Checksum: aebe8f44
INFO: [Common 17-83] Releasing license: Synthesis
53 Infos, 240 Warnings, 22 Critical Warnings and 0 Errors encountered.
synth_design completed successfully
synth_design: Time (s): cpu = 00:01:28 ; elapsed = 00:02:14 . Memory (MB): peak = 4131.613 ; gain = 2713.898 ; free physical = 121355 ; free virtual = 133634
INFO: [Common 17-2834] synth_design peak Physical Memory [PSS] (MB): overall = 3437.658; main = 3374.606; forked = 452.596
INFO: [Common 17-2834] synth_design peak Virtual Memory [VSS] (MB): overall = 4769.652; main = 4131.617; forked = 1021.797
## print "Connecting debug network"

AWS FPGA: (12:15:15): Connecting debug network

## source ${HDK_SHELL_DIR}/build/scripts/synth_cl_footer.tcl
### print "Writing post-synth design checkpoint"

AWS FPGA: (12:15:15): Writing post-synth design checkpoint

### write_checkpoint -force ${checkpoints_dir}/${CL}.${TAG}.post_synth.dcp
INFO: [Timing 38-35] Done setting XDC timing constraints.
INFO: [Timing 38-480] Writing timing data to binary archive.
Write ShapeDB Complete: Time (s): cpu = 00:00:00.04 ; elapsed = 00:00:00.01 . Memory (MB): peak = 4163.629 ; gain = 0.000 ; free physical = 121383 ; free virtual = 133662
Wrote PlaceDB: Time (s): cpu = 00:00:00.05 ; elapsed = 00:00:00.01 . Memory (MB): peak = 4163.629 ; gain = 0.000 ; free physical = 121383 ; free virtual = 133662
Wrote PulsedLatchDB: Time (s): cpu = 00:00:00 ; elapsed = 00:00:00 . Memory (MB): peak = 4163.629 ; gain = 0.000 ; free physical = 121383 ; free virtual = 133662
Writing XDEF routing.
Writing XDEF routing logical nets.
Writing XDEF routing special nets.
Wrote RouteStorage: Time (s): cpu = 00:00:00.11 ; elapsed = 00:00:00.03 . Memory (MB): peak = 4163.629 ; gain = 0.000 ; free physical = 121381 ; free virtual = 133662
Wrote Netlist Cache: Time (s): cpu = 00:00:00 ; elapsed = 00:00:00 . Memory (MB): peak = 4163.629 ; gain = 0.000 ; free physical = 121381 ; free virtual = 133662
Wrote Device Cache: Time (s): cpu = 00:00:00.05 ; elapsed = 00:00:00.01 . Memory (MB): peak = 4163.629 ; gain = 0.000 ; free physical = 121377 ; free virtual = 133661
Write Physdb Complete: Time (s): cpu = 00:00:00.23 ; elapsed = 00:00:00.06 . Memory (MB): peak = 4163.629 ; gain = 0.000 ; free physical = 121377 ; free virtual = 133661
INFO: [Common 17-1381] The checkpoint '/home/ubuntu/src/aws-fpga/hdk/cl/examples/top/build/checkpoints/top.2026_10_10-121021.post_synth.dcp' has been generated.
### source ${HDK_SHELL_DIR}/build/scripts/check_ddr_bram.tcl
#### print "Checking if MiG BRAM is initialized"

AWS FPGA: (12:15:17): Checking if MiG BRAM is initialized

WARNING: [Vivado 12-180] No cells matched '*'.
#### set ram_inst [get_cells -hierarchical -filter \
#### {NAME=~*mcs0/inst/lmb_bram_I/U0/inst_blk_mem_gen/gnbram.gnative_mem_map_bmg.native_mem_map_blk_mem_gen/valid.cstr/ramloop[0].ram.r/prim_noinit.ram/DEVICE_8SERIES.WITH_BMM_INFO.TRUE_DP.SIMPLE_PRIM36.SERIES8_TDP_SP36_NO_ECC_ATTR.ram}
#### ]
#### if {$ram_inst != ""} {
#### set bram_value_0 "256'h0000000000000000000000000000000000000000000000000000000000000000"
#### set bram_init_value [get_property INIT_2C $ram_inst]
####
#### if {$bram_init_value == $bram_value_0} {
#### print "CRITICAL WARNING: MiG BRAM is not populated with ELF file. This results in Calibration Failure!!"
#### } else {
#### print "MiG BRAM is initialized. INIT_2C = $bram_init_value"
#### }
####
#### } else {
#### print "Skip DDR calibration check"
#### }

AWS FPGA: (12:15:17): Skip DDR calibration check

### close_project
### set_param sta.enableAutoGenClkNamePersistence 1
## set AWS_DCP_DIR "${HDK_SHELL_DIR}/build/checkpoints/from_aws/"
## print "Start linking customer design ${CL}"

AWS FPGA: (12:15:17): Start linking customer design top

## add_files ${AWS_DCP_DIR}/cl_bb_routed.${SHELL_MODE}.dcp
## add_files ${checkpoints_dir}/${CL}.${TAG}.post_synth.dcp
## set_property SCOPED_TO_CELLS {WRAPPER/CL} \
## [get_files ${checkpoints_dir}/${CL}.${TAG}.post_synth.dcp]
## link_design -mode default \
## -reconfig_partitions {WRAPPER/CL} \
## -top top
Command: link_design -mode default -reconfig_partitions WRAPPER/CL -top top
Design is defaulting to srcset: sources_1
Design is defaulting to constrset: constrs_1
Design is defaulting to dcp part: xcvu47p-fsvh2892-2-e
INFO: [Project 1-454] Reading design checkpoint '/home/ubuntu/src/aws-fpga/hdk/cl/examples/top/build/checkpoints/top.2026_10_10-121021.post_synth.dcp' for cell 'WRAPPER/CL'
Netlist sorting complete. Time (s): cpu = 00:00:00.21 ; elapsed = 00:00:00.21 . Memory (MB): peak = 4163.629 ; gain = 0.000 ; free physical = 121351 ; free virtual = 133631
INFO: [Netlist 29-17] Analyzing 1243 Unisim elements for replacement
INFO: [Netlist 29-28] Unisim Transformation completed in 0 CPU seconds
INFO: [Project 1-479] Netlist was created with Vivado 2024.1
INFO: [Project 1-570] Preparing netlist for logic optimization
WARNING: [Constraints 18-550] Could not create 'DRIVE' constraint because net 'WRAPPER/IO_SHIM/rst_dimm_en' is not directly connected to top level port. 'DRIVE' is ignored for synthesis but preserved for implementation.
WARNING: [Constraints 18-550] Could not create 'SLEW' constraint because net 'WRAPPER/IO_SHIM/rst_dimm_en' is not directly connected to top level port. 'SLEW' is ignored for synthesis but preserved for implementation.
WARNING: [Constraints 18-550] Could not create 'IBUF_LOW_PWR' constraint because net 'WRAPPER/IO_SHIM/spi_cs_n' is not directly connected to top level port. 'IBUF_LOW_PWR' is ignored for synthesis but preserved for implementation.
WARNING: [Constraints 18-550] Could not create 'DRIVE' constraint because net 'WRAPPER/IO_SHIM/spi_miso' is not directly connected to top level port. 'DRIVE' is ignored for synthesis but preserved for implementation.
WARNING: [Constraints 18-550] Could not create 'SLEW' constraint because net 'WRAPPER/IO_SHIM/spi_miso' is not directly connected to top level port. 'SLEW' is ignored for synthesis but preserved for implementation.
WARNING: [Constraints 18-550] Could not create 'DRIVE' constraint because net 'WRAPPER/IO_SHIM/spi_miso_ts' is not directly connected to top level port. 'DRIVE' is ignored for synthesis but preserved for implementation.
WARNING: [Constraints 18-550] Could not create 'SLEW' constraint because net 'WRAPPER/IO_SHIM/spi_miso_ts' is not directly connected to top level port. 'SLEW' is ignored for synthesis but preserved for implementation.
WARNING: [Constraints 18-550] Could not create 'IBUF_LOW_PWR' constraint because net 'WRAPPER/IO_SHIM/spi_mosi' is not directly connected to top level port. 'IBUF_LOW_PWR' is ignored for synthesis but preserved for implementation.
WARNING: [Constraints 18-550] Could not create 'IBUF_LOW_PWR' constraint because net 'WRAPPER/IO_SHIM/spi_sck' is not directly connected to top level port. 'IBUF_LOW_PWR' is ignored for synthesis but preserved for implementation.
WARNING: [Constraints 18-550] Could not create 'IBUF_LOW_PWR' constraint because net 'WRAPPER/IO_SHIM/uc_pcie_perst_n' is not directly connected to top level port. 'IBUF_LOW_PWR' is ignored for synthesis but preserved for implementation.
WARNING: [Constraints 18-550] Could not create 'IBUF_LOW_PWR' constraint because net 'WRAPPER/IO_SHIM/vr_alert_n' is not directly connected to top level port. 'IBUF_LOW_PWR' is ignored for synthesis but preserved for implementation.
Parsing XDC File [/home/ubuntu/src/aws-fpga/hdk/common/shell_stable/build/checkpoints/from_aws/cl_bb_routed.small_shell/top_board.xdc]
Finished Parsing XDC File [/home/ubuntu/src/aws-fpga/hdk/common/shell_stable/build/checkpoints/from_aws/cl_bb_routed.small_shell/top_board.xdc]
Parsing XDC File [/home/ubuntu/src/aws-fpga/hdk/common/shell_stable/build/checkpoints/from_aws/cl_bb_routed.small_shell/top_early.xdc]
WARNING: [Constraints 18-619] A clock with name 'CLK_DIMM_DP' already exists, overwriting the previous clock with the same name. [/proj/chiron/zhcz/F2/2024_1/f2/design/ip/cl_ip/cl_ip.gen/sources_1/ip/cl_ddr4/par/cl_ddr4.xdc:7]
Finished Parsing XDC File [/home/ubuntu/src/aws-fpga/hdk/common/shell_stable/build/checkpoints/from_aws/cl_bb_routed.small_shell/top_early.xdc]
Parsing XDC File [/home/ubuntu/src/aws-fpga/hdk/cl/examples/top/build/checkpoints/top.2026_10_10-121021.post_synth/top_early.xdc] for cell 'WRAPPER/CL'
Finished Parsing XDC File [/home/ubuntu/src/aws-fpga/hdk/cl/examples/top/build/checkpoints/top.2026_10_10-121021.post_synth/top_early.xdc] for cell 'WRAPPER/CL'
Parsing XDC File [/home/ubuntu/src/aws-fpga/hdk/common/shell_stable/build/checkpoints/from_aws/cl_bb_routed.small_shell/top.xdc]
INFO: [Constraints 18-4422] SNAPPING_MODE is set so implementation will use the DERIVED_RANGES which may be different then the GRID_RANGES. [/proj/chiron/zhcz/scratch/F2_BUILD_2024_Vivado_2024-10-21-15-03-11299/build/hpr_AltSpreadLogic_low_AggressiveExplore/constraints/floorplan/small_shell/level_1_fp_cl.xdc:18]
INFO: [Constraints 18-4421] A LAGUNA range, without usable sites, was added to DERIVED_RANGES for purposes of keeping the Programmable Unit together within the reconfigurable pblock. [/proj/chiron/zhcz/scratch/F2_BUILD_2024_Vivado_2024-10-21-15-03-11299/build/hpr_AltSpreadLogic_low_AggressiveExplore/constraints/floorplan/small_shell/level_1_fp_cl.xdc:18]
Finished Parsing XDC File [/home/ubuntu/src/aws-fpga/hdk/common/shell_stable/build/checkpoints/from_aws/cl_bb_routed.small_shell/top.xdc]
Parsing XDC File [/home/ubuntu/src/aws-fpga/hdk/cl/examples/top/build/checkpoints/top.2026_10_10-121021.post_synth/top.xdc] for cell 'WRAPPER/CL'
Finished Parsing XDC File [/home/ubuntu/src/aws-fpga/hdk/cl/examples/top/build/checkpoints/top.2026_10_10-121021.post_synth/top.xdc] for cell 'WRAPPER/CL'
Parsing XDC File [/home/ubuntu/src/aws-fpga/hdk/common/shell_stable/build/checkpoints/from_aws/cl_bb_routed.small_shell/top_late.xdc]
INFO: [Vivado 12-24630] Instance: 'WRAPPER/CL' is a DFX HD.RECONFIGURABLE module.
INFO: [Timing 38-35] Done setting XDC timing constraints. [/proj/chiron/zhcz/scratch/F2_BUILD_2024_Vivado_2024-10-21-15-03-11299/build/hpr_AltSpreadLogic_low_AggressiveExplore/constraints/timing/io_timing.xdc:20]
INFO: [Timing 38-2] Deriving generated clocks [/proj/chiron/zhcz/scratch/F2_BUILD_2024_Vivado_2024-10-21-15-03-11299/build/hpr_AltSpreadLogic_low_AggressiveExplore/constraints/timing/io_timing.xdc:20]
WARNING: [Vivado 12-627] No clocks matched 'mmcm_clkout0'. [/proj/chiron/zhcz/scratch/F2_BUILD_2024_Vivado_2024-10-21-15-03-11299/build/hpr_AltSpreadLogic_low_AggressiveExplore/constraints/timing/io_timing.xdc:20]
WARNING: [Vivado 12-627] No clocks matched 'mmcm_clkout1'. [/proj/chiron/zhcz/scratch/F2_BUILD_2024_Vivado_2024-10-21-15-03-11299/build/hpr_AltSpreadLogic_low_AggressiveExplore/constraints/timing/io_timing.xdc:20]
WARNING: [Vivado 12-627] No clocks matched 'mmcm_clkout2'. [/proj/chiron/zhcz/scratch/F2_BUILD_2024_Vivado_2024-10-21-15-03-11299/build/hpr_AltSpreadLogic_low_AggressiveExplore/constraints/timing/io_timing.xdc:20]
WARNING: [Vivado 12-627] No clocks matched 'mmcm_clkout3'. [/proj/chiron/zhcz/scratch/F2_BUILD_2024_Vivado_2024-10-21-15-03-11299/build/hpr_AltSpreadLogic_low_AggressiveExplore/constraints/timing/io_timing.xdc:20]
WARNING: [Vivado 12-627] No clocks matched 'mmcm_clkout4'. [/proj/chiron/zhcz/scratch/F2_BUILD_2024_Vivado_2024-10-21-15-03-11299/build/hpr_AltSpreadLogic_low_AggressiveExplore/constraints/timing/io_timing.xdc:20]
WARNING: [Vivado 12-627] No clocks matched 'mmcm_clkout5'. [/proj/chiron/zhcz/scratch/F2_BUILD_2024_Vivado_2024-10-21-15-03-11299/build/hpr_AltSpreadLogic_low_AggressiveExplore/constraints/timing/io_timing.xdc:20]
WARNING: [Vivado 12-627] No clocks matched 'mmcm_clkout6'. [/proj/chiron/zhcz/scratch/F2_BUILD_2024_Vivado_2024-10-21-15-03-11299/build/hpr_AltSpreadLogic_low_AggressiveExplore/constraints/timing/io_timing.xdc:20]
WARNING: [Vivado 12-627] No clocks matched 'pll_clk[0]'. [/proj/chiron/zhcz/scratch/F2_BUILD_2024_Vivado_2024-10-21-15-03-11299/build/hpr_AltSpreadLogic_low_AggressiveExplore/constraints/timing/io_timing.xdc:20]
WARNING: [Vivado 12-627] No clocks matched 'pll_clk[1]'. [/proj/chiron/zhcz/scratch/F2_BUILD_2024_Vivado_2024-10-21-15-03-11299/build/hpr_AltSpreadLogic_low_AggressiveExplore/constraints/timing/io_timing.xdc:20]
WARNING: [Vivado 12-627] No clocks matched 'pll_clk[2]'. [/proj/chiron/zhcz/scratch/F2_BUILD_2024_Vivado_2024-10-21-15-03-11299/build/hpr_AltSpreadLogic_low_AggressiveExplore/constraints/timing/io_timing.xdc:20]
WARNING: [Vivado 12-627] No clocks matched 'pll_clk[0]_DIV'. [/proj/chiron/zhcz/scratch/F2_BUILD_2024_Vivado_2024-10-21-15-03-11299/build/hpr_AltSpreadLogic_low_AggressiveExplore/constraints/timing/io_timing.xdc:20]
WARNING: [Vivado 12-627] No clocks matched 'pll_clk[2]_DIV'. [/proj/chiron/zhcz/scratch/F2_BUILD_2024_Vivado_2024-10-21-15-03-11299/build/hpr_AltSpreadLogic_low_AggressiveExplore/constraints/timing/io_timing.xdc:20]
WARNING: [Vivado 12-627] No clocks matched 'pll_clk[1]_DIV'. [/proj/chiron/zhcz/scratch/F2_BUILD_2024_Vivado_2024-10-21-15-03-11299/build/hpr_AltSpreadLogic_low_AggressiveExplore/constraints/timing/io_timing.xdc:20]
WARNING: [Vivado 12-627] No clocks matched 'mmcm_clkout0'. [/proj/chiron/zhcz/scratch/F2_BUILD_2024_Vivado_2024-10-21-15-03-11299/build/hpr_AltSpreadLogic_low_AggressiveExplore/constraints/timing/io_timing.xdc:21]
WARNING: [Vivado 12-627] No clocks matched 'mmcm_clkout1'. [/proj/chiron/zhcz/scratch/F2_BUILD_2024_Vivado_2024-10-21-15-03-11299/build/hpr_AltSpreadLogic_low_AggressiveExplore/constraints/timing/io_timing.xdc:21]
WARNING: [Vivado 12-627] No clocks matched 'mmcm_clkout2'. [/proj/chiron/zhcz/scratch/F2_BUILD_2024_Vivado_2024-10-21-15-03-11299/build/hpr_AltSpreadLogic_low_AggressiveExplore/constraints/timing/io_timing.xdc:21]
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
WARNING: [Vivado 12-627] No clocks matched 'mmcm_clkout2'. [/proj/chiron/zhcz/scratch/F2_BUILD_2024_Vivado_2024-10-21-15-03-11299/build/hpr_AltSpreadLogic_low_AggressiveExplore/constraints/timing/io_timing.xdc:51]
WARNING: [Vivado 12-627] No clocks matched 'mmcm_clkout3'. [/proj/chiron/zhcz/scratch/F2_BUILD_2024_Vivado_2024-10-21-15-03-11299/build/hpr_AltSpreadLogic_low_AggressiveExplore/constraints/timing/io_timing.xdc:51]
WARNING: [Vivado 12-627] No clocks matched 'mmcm_clkout4'. [/proj/chiron/zhcz/scratch/F2_BUILD_2024_Vivado_2024-10-21-15-03-11299/build/hpr_AltSpreadLogic_low_AggressiveExplore/constraints/timing/io_timing.xdc:51]
WARNING: [Vivado 12-627] No clocks matched 'mmcm_clkout5'. [/proj/chiron/zhcz/scratch/F2_BUILD_2024_Vivado_2024-10-21-15-03-11299/build/hpr_AltSpreadLogic_low_AggressiveExplore/constraints/timing/io_timing.xdc:51]
WARNING: [Vivado 12-627] No clocks matched 'mmcm_clkout6'. [/proj/chiron/zhcz/scratch/F2_BUILD_2024_Vivado_2024-10-21-15-03-11299/build/hpr_AltSpreadLogic_low_AggressiveExplore/constraints/timing/io_timing.xdc:51]
WARNING: [Vivado 12-627] No clocks matched 'pll_clk[0]'. [/proj/chiron/zhcz/scratch/F2_BUILD_2024_Vivado_2024-10-21-15-03-11299/build/hpr_AltSpreadLogic_low_AggressiveExplore/constraints/timing/io_timing.xdc:51]
WARNING: [Vivado 12-627] No clocks matched 'pll_clk[1]'. [/proj/chiron/zhcz/scratch/F2_BUILD_2024_Vivado_2024-10-21-15-03-11299/build/hpr_AltSpreadLogic_low_AggressiveExplore/constraints/timing/io_timing.xdc:51]
INFO: [Common 17-14] Message 'Vivado 12-627' appears 100 times and further instances of the messages will be disabled. Use the Tcl command set_msg_config to change the current settings. [/proj/chiron/zhcz/scratch/F2_BUILD_2024_Vivado_2024-10-21-15-03-11299/build/hpr_AltSpreadLogic_low_AggressiveExplore/constraints/timing/io_timing.xdc:51]
Finished Parsing XDC File [/home/ubuntu/src/aws-fpga/hdk/common/shell_stable/build/checkpoints/from_aws/cl_bb_routed.small_shell/top_late.xdc]
INFO: [Designutils 20-5722] Start Reading Physical Databases.
Reading placement.
Read Netlist Cache: Time (s): cpu = 00:00:00.01 ; elapsed = 00:00:00.01 . Memory (MB): peak = 4239.223 ; gain = 0.000 ; free physical = 121291 ; free virtual = 133573
Reading placer database...
Read Device Cache: Time (s): cpu = 00:00:00.02 ; elapsed = 00:00:00.02 . Memory (MB): peak = 4243.223 ; gain = 4.000 ; free physical = 121285 ; free virtual = 133567
Read PlaceDB: Time (s): cpu = 00:00:00.28 ; elapsed = 00:00:00.29 . Memory (MB): peak = 4253.605 ; gain = 8.000 ; free physical = 121274 ; free virtual = 133557
Read PulsedLatchDB: Time (s): cpu = 00:00:00 ; elapsed = 00:00:00 . Memory (MB): peak = 4254.605 ; gain = 0.000 ; free physical = 121274 ; free virtual = 133556
Reading routing.
Read RouteStorage: Time (s): cpu = 00:00:00.16 ; elapsed = 00:00:00.17 . Memory (MB): peak = 4262.988 ; gain = 8.383 ; free physical = 121266 ; free virtual = 133548
Read Physdb Files: Time (s): cpu = 00:00:00.51 ; elapsed = 00:00:00.53 . Memory (MB): peak = 4262.988 ; gain = 23.766 ; free physical = 121266 ; free virtual = 133548
Restored from archive | CPU: 0.740000 secs | Memory: 16.967819 MB |
Finished XDEF File Restore: Time (s): cpu = 00:00:00.72 ; elapsed = 00:00:00.74 . Memory (MB): peak = 4262.988 ; gain = 23.766 ; free physical = 121265 ; free virtual = 133547
WARNING: [Constraints 18-4434] Global Clock Buffer 'SL/UC_PCIE4_BRIDGE/inst/pcie4_ip_i/inst/bufg_gt_sysclk' is LOCed to site 'BUFG_GT_X1Y120'. Using a LOC constraint to assign the placement of a Global Clock Buffer can result in sub-optimal placement results.
Resolution: Remove the LOC constraint and use the CLOCK_REGION constraint to assign a Global Clock Buffer to a CLOCK_REGION.
WARNING: [Constraints 18-4434] Global Clock Buffer 'WRAPPER/IO_SHIM/BUFG_CLK_125' is LOCed to site 'BUFGCE_X0Y122'. Using a LOC constraint to assign the placement of a Global Clock Buffer can result in sub-optimal placement results.
Resolution: Remove the LOC constraint and use the CLOCK_REGION constraint to assign a Global Clock Buffer to a CLOCK_REGION.
WARNING: [Constraints 18-4434] Global Clock Buffer 'WRAPPER/IO_SHIM/BUFG_CLK_HBM_EXT' is LOCed to site 'BUFGCE_X0Y70'. Using a LOC constraint to assign the placement of a Global Clock Buffer can result in sub-optimal placement results.
Resolution: Remove the LOC constraint and use the CLOCK_REGION constraint to assign a Global Clock Buffer to a CLOCK_REGION.
WARNING: [Constraints 18-4434] Global Clock Buffer 'WRAPPER/IO_SHIM/BUFG_CLK_HBM_INT' is LOCed to site 'BUFGCE_X0Y65'. Using a LOC constraint to assign the placement of a Global Clock Buffer can result in sub-optimal placement results.
Resolution: Remove the LOC constraint and use the CLOCK_REGION constraint to assign a Global Clock Buffer to a CLOCK_REGION.
WARNING: [Constraints 18-4434] Global Clock Buffer 'WRAPPER/IO_SHIM/PLL_CLK_CORE/inst/clkout1_buf' is LOCed to site 'BUFGCE_X0Y56'. Using a LOC constraint to assign the placement of a Global Clock Buffer can result in sub-optimal placement results.
Resolution: Remove the LOC constraint and use the CLOCK_REGION constraint to assign a Global Clock Buffer to a CLOCK_REGION.
WARNING: [Constraints 18-4434] Global Clock Buffer 'WRAPPER/IO_SHIM/PLL_CLK_CORE/inst/clkout2_buf' is LOCed to site 'BUFGCE_X0Y58'. Using a LOC constraint to assign the placement of a Global Clock Buffer can result in sub-optimal placement results.
Resolution: Remove the LOC constraint and use the CLOCK_REGION constraint to assign a Global Clock Buffer to a CLOCK_REGION.
WARNING: [Constraints 18-4434] Global Clock Buffer 'WRAPPER/IO_SHIM/RL_CLKS/BUFG_CLK_A_EXT' is LOCed to site 'BUFGCE_X0Y135'. Using a LOC constraint to assign the placement of a Global Clock Buffer can result in sub-optimal placement results.
Resolution: Remove the LOC constraint and use the CLOCK_REGION constraint to assign a Global Clock Buffer to a CLOCK_REGION.
WARNING: [Constraints 18-4434] Global Clock Buffer 'WRAPPER/IO_SHIM/RL_CLKS/BUFG_CLK_A_INT' is LOCed to site 'BUFGCE_X0Y136'. Using a LOC constraint to assign the placement of a Global Clock Buffer can result in sub-optimal placement results.
Resolution: Remove the LOC constraint and use the CLOCK_REGION constraint to assign a Global Clock Buffer to a CLOCK_REGION.
WARNING: [Constraints 18-4434] Global Clock Buffer 'WRAPPER/RL/HOST_PCIE4C/inst/bufg_gt_sysclk' is LOCed to site 'BUFG_GT_X1Y78'. Using a LOC constraint to assign the placement of a Global Clock Buffer can result in sub-optimal placement results.
Resolution: Remove the LOC constraint and use the CLOCK_REGION constraint to assign a Global Clock Buffer to a CLOCK_REGION.
Parsing XDC File [/home/ubuntu/src/aws-fpga/hdk/cl/examples/top/build/checkpoints/top.2026_10_10-121021.post_synth/top_late.xdc] for cell 'WRAPPER/CL'
Finished Parsing XDC File [/home/ubuntu/src/aws-fpga/hdk/cl/examples/top/build/checkpoints/top.2026_10_10-121021.post_synth/top_late.xdc] for cell 'WRAPPER/CL'
INFO: [Designutils 20-5722] Start Reading Physical Databases.
Reading placement.
Read Netlist Cache: Time (s): cpu = 00:00:00 ; elapsed = 00:00:00 . Memory (MB): peak = 4282.988 ; gain = 0.000 ; free physical = 121245 ; free virtual = 133527
Reading placer database...
Read Device Cache: Time (s): cpu = 00:00:00.02 ; elapsed = 00:00:00.03 . Memory (MB): peak = 4290.824 ; gain = 7.836 ; free physical = 121237 ; free virtual = 133519
CRITICAL WARNING: [Constraints 18-4866] Site IOB_X0Y207 had a top level port PCIE_RP_PERSTN on sitetype net OUTBUF_O which was overwritten!
CRITICAL WARNING: [Constraints 18-4866] Site IOB_X0Y207 had a top level port PCIE_RP_PERSTN on sitetype net PULL_PAD which was overwritten!
CRITICAL WARNING: [Constraints 18-4866] Site IOB_X0Y207 had a top level port PCIE_RP_PERSTN on sitetype net IO which was overwritten!
CRITICAL WARNING: [Constraints 18-4866] Site IOB_X0Y181 had a top level port PCIE_EP_PERSTN on sitetype net OUTBUF_O which was overwritten!
CRITICAL WARNING: [Constraints 18-4866] Site IOB_X0Y181 had a top level port PCIE_EP_PERSTN on sitetype net PULL_PAD which was overwritten!
CRITICAL WARNING: [Constraints 18-4866] Site IOB_X0Y181 had a top level port PCIE_EP_PERSTN on sitetype net IO which was overwritten!
Read PlaceDB: Time (s): cpu = 00:00:00.01 ; elapsed = 00:00:00.01 . Memory (MB): peak = 4291.824 ; gain = 1.000 ; free physical = 121237 ; free virtual = 133519
Read PulsedLatchDB: Time (s): cpu = 00:00:00 ; elapsed = 00:00:00 . Memory (MB): peak = 4291.824 ; gain = 0.000 ; free physical = 121237 ; free virtual = 133519
Reading routing.
Read RouteStorage: Time (s): cpu = 00:00:00 ; elapsed = 00:00:00 . Memory (MB): peak = 4291.824 ; gain = 0.000 ; free physical = 121236 ; free virtual = 133518
Read Physdb Files: Time (s): cpu = 00:00:00.04 ; elapsed = 00:00:00.06 . Memory (MB): peak = 4291.824 ; gain = 8.836 ; free physical = 121236 ; free virtual = 133518
Restored from archive | CPU: 0.060000 secs | Memory: 0.004349 MB |
Finished XDEF File Restore: Time (s): cpu = 00:00:00.05 ; elapsed = 00:00:00.06 . Memory (MB): peak = 4291.824 ; gain = 8.836 ; free physical = 121236 ; free virtual = 133518
Netlist sorting complete. Time (s): cpu = 00:00:00.03 ; elapsed = 00:00:00.02 . Memory (MB): peak = 4334.723 ; gain = 0.000 ; free physical = 121188 ; free virtual = 133470
INFO: [Project 1-111] Unisim Transformation Summary:
A total of 110 instances were transformed.
DSP48E2 => DSP48E2 (DSP_ALU, DSP_A_B_DATA, DSP_C_DATA, DSP_MULTIPLIER, DSP_M_DATA, DSP_OUTPUT, DSP_PREADD, DSP_PREADD_DATA): 10 instances
IBUF => IBUF (IBUFCTRL, INBUF): 6 instances
IBUFDS => IBUFDS (DIFFINBUF, IBUFCTRL): 2 instances
IOBUF => IOBUF (IBUFCTRL, INBUF, OBUFT): 2 instances
IOBUFDS => IOBUFDS (DIFFINBUF, IBUFCTRL, INV, OBUFT(x2)): 18 instances
IOBUFE3 => IOBUFE3 (IBUFCTRL, INBUF, OBUFT_DCIEN): 72 instances

14 Infos, 121 Warnings, 6 Critical Warnings and 0 Errors encountered.
link_design completed successfully
link_design: Time (s): cpu = 00:00:56 ; elapsed = 00:00:56 . Memory (MB): peak = 4334.723 ; gain = 171.094 ; free physical = 121188 ; free virtual = 133470
## print "Writing post-link design checkpoint"

AWS FPGA: (12:16:13): Writing post-link design checkpoint

## write_checkpoint -force ${checkpoints_dir}/${CL}.${TAG}.post_link.dcp
INFO: [Timing 38-480] Writing timing data to binary archive.
Write ShapeDB Complete: Time (s): cpu = 00:00:00.04 ; elapsed = 00:00:00.01 . Memory (MB): peak = 4367.000 ; gain = 15.367 ; free physical = 121181 ; free virtual = 133471
Wrote PlaceDB: Time (s): cpu = 00:00:01 ; elapsed = 00:00:00.38 . Memory (MB): peak = 4382.492 ; gain = 30.859 ; free physical = 121145 ; free virtual = 133458
Wrote PulsedLatchDB: Time (s): cpu = 00:00:00 ; elapsed = 00:00:00 . Memory (MB): peak = 4382.492 ; gain = 0.000 ; free physical = 121143 ; free virtual = 133458
Writing XDEF routing.
Writing XDEF routing logical nets.
Writing XDEF routing special nets.
Wrote RouteStorage: Time (s): cpu = 00:00:00.46 ; elapsed = 00:00:00.1 . Memory (MB): peak = 4384.492 ; gain = 2.000 ; free physical = 121135 ; free virtual = 133455
Wrote Netlist Cache: Time (s): cpu = 00:00:00.04 ; elapsed = 00:00:00.01 . Memory (MB): peak = 4384.492 ; gain = 0.000 ; free physical = 121134 ; free virtual = 133455
Wrote Device Cache: Time (s): cpu = 00:00:00.03 ; elapsed = 00:00:00.01 . Memory (MB): peak = 4384.492 ; gain = 0.000 ; free physical = 121132 ; free virtual = 133455
Write Physdb Complete: Time (s): cpu = 00:00:02 ; elapsed = 00:00:00.52 . Memory (MB): peak = 4384.492 ; gain = 32.859 ; free physical = 121132 ; free virtual = 133455
INFO: [Common 17-1381] The checkpoint '/home/ubuntu/src/aws-fpga/hdk/cl/examples/top/build/checkpoints/top.2026_10_10-121021.post_link.dcp' has been generated.
## source $HDK_SHELL_DIR/build/scripts/aws_clock_properties.tcl
### proc proc_set_mmcm {mmcm_cell clkfbout_mult_f divclk_divide clkout0_divide_f {clkout1_divide 1} {clkout2_divide 1}} {
### set cell_name [get_cells -quiet $mmcm_cell]
### if {$cell_name != ""} {
### set_property CLKFBOUT_MULT_F $clkfbout_mult_f $cell_name
### set_property DIVCLK_DIVIDE $divclk_divide $cell_name
### set_property CLKOUT0_DIVIDE_F $clkout0_divide_f $cell_name
### set_property CLKOUT1_DIVIDE $clkout1_divide $cell_name
### set_property CLKOUT2_DIVIDE $clkout2_divide $cell_name
### } else {
### puts "\nCRITICAL WARNING: $mmcm_cell cell not found. Clock recipe for this MMCM not applied.\n"
### }
### }
### set RL_A0_MMCM "WRAPPER/IO_SHIM/RL_CLKS/MMCM_CLK_MAIN_A/inst/CLK_CORE_DRP_I/clk_inst/mmcme4_adv_inst"
### set GRP_A_MMCM "WRAPPER/CL/AWS_CLK_GEN/CLK_GRP_A_EN_I.CLK_MMCM_A_I/inst/CLK_CORE_DRP_I/clk_inst/mmcme4_adv_inst"
### set GRP_B_MMCM "WRAPPER/CL/AWS_CLK_GEN/CLK_GRP_B_EN_I.CLK_MMCM_B_I/inst/CLK_CORE_DRP_I/clk_inst/mmcme4_adv_inst"
### set GRP_C_MMCM "WRAPPER/CL/AWS_CLK_GEN/CLK_GRP_C_EN_I.CLK_MMCM_C_I/inst/CLK_CORE_DRP_I/clk_inst/mmcme4_adv_inst"
### set GRP_H_MMCM "WRAPPER/CL/AWS_CLK_GEN/CLK_HBM_EN_I.CLK_MMCM_HBM_I/inst/CLK_CORE_DRP_I/clk_inst/mmcme4_adv_inst"
### if {[string compare $clock_recipe_a "A1"] == 0} {
### #
### # clk_main_a0
### #
### set CLKFBOUT_MULT_F 9.5
### set DIVCLK_DIVIDE 1
### set CLKOUT0_DIVIDE_F 4.750
### proc_set_mmcm $RL_A0_MMCM $CLKFBOUT_MULT_F $DIVCLK_DIVIDE $CLKOUT0_DIVIDE_F
###
### #
### # clk_extra_a1, clk_extra_a2, clk_extra_a3
### #
### set CLKFBOUT_MULT_F 15
### set DIVCLK_DIVIDE 1
### set CLKOUT0_DIVIDE_F 12
### set CLKOUT1_DIVIDE 4
### set CLKOUT2_DIVIDE 3
### proc_set_mmcm $GRP_A_MMCM $CLKFBOUT_MULT_F $DIVCLK_DIVIDE $CLKOUT0_DIVIDE_F $CLKOUT1_DIVIDE $CLKOUT2_DIVIDE
###
### } elseif {[string compare $clock_recipe_a "A2"] == 0} {
### #
### # clk_main_a0
### #
### #NOT SUPPORTED# set CLKFBOUT_MULT_F 63.625
### #NOT SUPPORTED# set DIVCLK_DIVIDE 8
### #NOT SUPPORTED# set CLKOUT0_DIVIDE_F 63.625
### set CLKFBOUT_MULT_F 9.5
### set DIVCLK_DIVIDE 1
### set CLKOUT0_DIVIDE_F 4.750
### proc_set_mmcm $RL_A0_MMCM $CLKFBOUT_MULT_F $DIVCLK_DIVIDE $CLKOUT0_DIVIDE_F
###
### #
### # clk_extra_a1, clk_extra_a2, clk_extra_a3
### #
### set CLKFBOUT_MULT_F 12.500
### set DIVCLK_DIVIDE 1
### set CLKOUT0_DIVIDE_F 80
### set CLKOUT1_DIVIDE 10
### set CLKOUT2_DIVIDE 20
### proc_set_mmcm $GRP_A_MMCM $CLKFBOUT_MULT_F $DIVCLK_DIVIDE $CLKOUT0_DIVIDE_F $CLKOUT1_DIVIDE $CLKOUT2_DIVIDE
###
### } else { #A0
### #
### # clk_main_a0
### #
### #NOT SUPPORTED# set CLKFBOUT_MULT_F 9.625
### #NOT SUPPORTED# set DIVCLK_DIVIDE 1
### #NOT SUPPORTED# set CLKOUT0_DIVIDE_F 9.625
### set CLKFBOUT_MULT_F 9.5
### set DIVCLK_DIVIDE 1
### set CLKOUT0_DIVIDE_F 4.750
### proc_set_mmcm $RL_A0_MMCM $CLKFBOUT_MULT_F $DIVCLK_DIVIDE $CLKOUT0_DIVIDE_F
###
### #
### # clk_extra_a1, clk_extra_a2, clk_extra_a3
### #
### set CLKFBOUT_MULT_F 15
### set DIVCLK_DIVIDE 1
### set CLKOUT0_DIVIDE_F 24
### set CLKOUT1_DIVIDE 8
### set CLKOUT2_DIVIDE 6
### proc_set_mmcm $GRP_A_MMCM $CLKFBOUT_MULT_F $DIVCLK_DIVIDE $CLKOUT0_DIVIDE_F $CLKOUT1_DIVIDE $CLKOUT2_DIVIDE
### }

CRITICAL WARNING: WRAPPER/CL/AWS_CLK_GEN/CLK_GRP_A_EN_I.CLK_MMCM_A_I/inst/CLK_CORE_DRP_I/clk_inst/mmcme4_adv_inst cell not found. Clock recipe for this MMCM not applied.

### if {[string compare $clock_recipe_b "B1"] == 0} {
### set CLKFBOUT_MULT_F 11.875
### set DIVCLK_DIVIDE 1
### set CLKOUT0_DIVIDE_F 9.5
### set CLKOUT1_DIVIDE 19
### } elseif {[string compare $clock_recipe_b "B2"] == 0} {
### set CLKFBOUT_MULT_F 11.250
### set DIVCLK_DIVIDE 1
### set CLKOUT0_DIVIDE_F 2.5
### set CLKOUT1_DIVIDE 5
### } elseif {[string compare $clock_recipe_b "B3"] == 0} {
### set CLKFBOUT_MULT_F 11.875
### set DIVCLK_DIVIDE 1
### set CLKOUT0_DIVIDE_F 4.750
### set CLKOUT1_DIVIDE 19
### } elseif {[string compare $clock_recipe_b "B4"] == 0} {
### set CLKFBOUT_MULT_F 12
### set DIVCLK_DIVIDE 1
### set CLKOUT0_DIVIDE_F 4
### set CLKOUT1_DIVIDE 16
### } elseif {[string compare $clock_recipe_b "B5"] == 0} {
### set CLKFBOUT_MULT_F 12
### set DIVCLK_DIVIDE 1
### set CLKOUT0_DIVIDE_F 3
### set CLKOUT1_DIVIDE 12
### } else { #B0
### set CLKFBOUT_MULT_F 12.5
### set DIVCLK_DIVIDE 1
### set CLKOUT0_DIVIDE_F 5
### set CLKOUT1_DIVIDE 10
### }
### proc_set_mmcm $GRP_B_MMCM $CLKFBOUT_MULT_F $DIVCLK_DIVIDE $CLKOUT0_DIVIDE_F $CLKOUT1_DIVIDE

CRITICAL WARNING: WRAPPER/CL/AWS_CLK_GEN/CLK_GRP_B_EN_I.CLK_MMCM_B_I/inst/CLK_CORE_DRP_I/clk_inst/mmcme4_adv_inst cell not found. Clock recipe for this MMCM not applied.

### if {[string compare $clock_recipe_c "C1"] == 0} {
### set CLKFBOUT_MULT_F 12
### set DIVCLK_DIVIDE 1
### set CLKOUT0_DIVIDE_F 8
### set CLKOUT1_DIVIDE 6
### } elseif {[string compare $clock_recipe_c "C2"] == 0} {
### set CLKFBOUT_MULT_F 12
### set DIVCLK_DIVIDE 1
### set CLKOUT0_DIVIDE_F 16
### set CLKOUT1_DIVIDE 12
### } elseif {[string compare $clock_recipe_c "C3"] == 0} {
### set CLKFBOUT_MULT_F 8
### set DIVCLK_DIVIDE 1
### set CLKOUT0_DIVIDE_F 4
### set CLKOUT1_DIVIDE 3
### } else { #C0
### set CLKFBOUT_MULT_F 12
### set DIVCLK_DIVIDE 1
### set CLKOUT0_DIVIDE_F 4
### set CLKOUT1_DIVIDE 3
### }
### proc_set_mmcm $GRP_C_MMCM $CLKFBOUT_MULT_F $DIVCLK_DIVIDE $CLKOUT0_DIVIDE_F $CLKOUT1_DIVIDE

CRITICAL WARNING: WRAPPER/CL/AWS_CLK_GEN/CLK_GRP_C_EN_I.CLK_MMCM_C_I/inst/CLK_CORE_DRP_I/clk_inst/mmcme4_adv_inst cell not found. Clock recipe for this MMCM not applied.

### if {[string compare $clock_recipe_hbm "H1"] == 0} {
### set CLKFBOUT_MULT_F 11.875
### set DIVCLK_DIVIDE 1
### set CLKOUT0_DIVIDE_F 9.5
### } elseif {[string compare $clock_recipe_hbm "H2"] == 0} {
### set CLKFBOUT_MULT_F 11.250
### set DIVCLK_DIVIDE 1
### set CLKOUT0_DIVIDE_F 2.5
### } elseif {[string compare $clock_recipe_hbm "H3"] == 0} {
### set CLKFBOUT_MULT_F 12
### set DIVCLK_DIVIDE 1
### set CLKOUT0_DIVIDE_F 4
### } elseif {[string compare $clock_recipe_hbm "H4"] == 0} {
### set CLKFBOUT_MULT_F 12
### set DIVCLK_DIVIDE 1
### set CLKOUT0_DIVIDE_F 3
### } else { #H0
### set CLKFBOUT_MULT_F 12.5
### set DIVCLK_DIVIDE 1
### set CLKOUT0_DIVIDE_F 5
### }
### proc_set_mmcm $GRP_H_MMCM $CLKFBOUT_MULT_F $DIVCLK_DIVIDE $CLKOUT0_DIVIDE_F $CLKOUT1_DIVIDE

CRITICAL WARNING: WRAPPER/CL/AWS_CLK_GEN/CLK_HBM_EN_I.CLK_MMCM_HBM_I/inst/CLK_CORE_DRP_I/clk_inst/mmcme4_adv_inst cell not found. Clock recipe for this MMCM not applied.

### puts "INFO: aws_clock_properties.tcl successfully applied clock recipes to MMCMs"
INFO: aws_clock_properties.tcl successfully applied clock recipes to MMCMs
## read_xdc ${HDK_SHELL_DIR}/build/constraints/${SHELL_MODE}_level_1_fp_cl.xdc
Parsing XDC File [/home/ubuntu/src/aws-fpga/hdk/common/shell_stable/build/constraints/small_shell_level_1_fp_cl.xdc]
CRITICAL WARNING: [Vivado 12-795] Pblock 'pblock_CL' already exists. [/home/ubuntu/src/aws-fpga/hdk/common/shell_stable/build/constraints/small_shell_level_1_fp_cl.xdc:28]
Finished Parsing XDC File [/home/ubuntu/src/aws-fpga/hdk/common/shell_stable/build/constraints/small_shell_level_1_fp_cl.xdc]
read_xdc: Time (s): cpu = 00:01:39 ; elapsed = 00:01:40 . Memory (MB): peak = 4400.500 ; gain = 0.000 ; free physical = 121074 ; free virtual = 133368
## read_xdc ${constraints_dir}/${SHELL_MODE}_cl_pnr_user.xdc
Parsing XDC File [/home/ubuntu/src/aws-fpga/hdk/cl/examples/top/build/constraints/small_shell_cl_pnr_user.xdc]
Finished Parsing XDC File [/home/ubuntu/src/aws-fpga/hdk/cl/examples/top/build/constraints/small_shell_cl_pnr_user.xdc]
## source ${HDK_SHELL_DIR}/build/scripts/ddr_io_train.tcl
WARNING: [Vivado 12-180] No cells matched 'WRAPPER/CL/SH_DDR/genblk1.IS_DDR_PRESENT.DDR4_0'.
### set DDR_CELL [get_cells WRAPPER/CL/SH_DDR/genblk1.IS_DDR_PRESENT.DDR4_0]
### if {$DDR_CELL != ""} {
### set_property MIG_FLOORPLAN_MODE FULL [get_cells WRAPPER/CL/SH_DDR/genblk1.IS_DDR_PRESENT.DDR4_0]
### } else {
### print "Skipped ddr_io_train.tcl. No DDR Core in the design"
### }

AWS FPGA: (12:17:56): Skipped ddr_io_train.tcl. No DDR Core in the design

## print "Start optimizing customer design ${CL}"

AWS FPGA: (12:17:56): Start optimizing customer design top

## opt_design
Command: opt_design
Attempting to get a license for feature 'Implementation' and/or device 'xcvu47p'
INFO: [Common 17-349] Got license for feature 'Implementation' and/or device 'xcvu47p'
Running DRC as a precondition to command opt_design

Starting DRC Task
INFO: [DRC 23-27] Running DRC with 8 threads
INFO: [Project 1-461] DRC finished with 0 Errors
INFO: [Project 1-462] Please refer to the DRC report (report_drc) for more information.

Time (s): cpu = 00:00:07 ; elapsed = 00:00:05 . Memory (MB): peak = 4545.660 ; gain = 145.160 ; free physical = 120952 ; free virtual = 133256

Starting Cache Timing Information Task
Ending Cache Timing Information Task | Checksum: 1ef1b848d

Time (s): cpu = 00:00:00.57 ; elapsed = 00:00:00.19 . Memory (MB): peak = 4545.660 ; gain = 0.000 ; free physical = 120952 ; free virtual = 133256

Starting Logic Optimization Task

Phase 1 Initialization

Phase 1.1 Core Generation And Design Setup
Phase 1.1 Core Generation And Design Setup | Checksum: 1ef1b848d

Time (s): cpu = 00:00:00.51 ; elapsed = 00:00:00.49 . Memory (MB): peak = 4657.520 ; gain = 0.000 ; free physical = 120798 ; free virtual = 133103

Phase 1.2 Setup Constraints And Sort Netlist
Phase 1.2 Setup Constraints And Sort Netlist | Checksum: 1ef1b848d

Time (s): cpu = 00:00:00.58 ; elapsed = 00:00:00.55 . Memory (MB): peak = 4657.520 ; gain = 0.000 ; free physical = 120795 ; free virtual = 133100
Phase 1 Initialization | Checksum: 1ef1b848d

Time (s): cpu = 00:00:00.63 ; elapsed = 00:00:00.59 . Memory (MB): peak = 4657.520 ; gain = 0.000 ; free physical = 120789 ; free virtual = 133094

Phase 2 Timer Update And Timing Data Collection

Phase 2.1 Timer Update
Phase 2.1 Timer Update | Checksum: 1ef1b848d

Time (s): cpu = 00:00:01 ; elapsed = 00:00:00.85 . Memory (MB): peak = 4657.520 ; gain = 0.000 ; free physical = 120770 ; free virtual = 133074

Phase 2.2 Timing Data Collection
Phase 2.2 Timing Data Collection | Checksum: 1ef1b848d

Time (s): cpu = 00:00:01 ; elapsed = 00:00:00.92 . Memory (MB): peak = 4657.520 ; gain = 0.000 ; free physical = 120793 ; free virtual = 133097
Phase 2 Timer Update And Timing Data Collection | Checksum: 1ef1b848d

Time (s): cpu = 00:00:02 ; elapsed = 00:00:00.96 . Memory (MB): peak = 4657.520 ; gain = 0.000 ; free physical = 120793 ; free virtual = 133097

Phase 3 Retarget
INFO: [Opt 31-1834] Total Chains To Be Transformed Were: 0 AND Number of Transformed insts Created are: 0
INFO: [Opt 31-1566] Pulled 1 inverters resulting in an inversion of 9 pins
INFO: [Opt 31-138] Pushed 6 inverter(s) to 211 load pin(s).
INFO: [Opt 31-49] Retargeted 0 cell(s).
Phase 3 Retarget | Checksum: 2c4e16196

Time (s): cpu = 00:00:02 ; elapsed = 00:00:01 . Memory (MB): peak = 4657.520 ; gain = 0.000 ; free physical = 120793 ; free virtual = 133098
Retarget | Checksum: 2c4e16196
INFO: [Opt 31-389] Phase Retarget created 2 cells and removed 8 cells
INFO: [Opt 31-1021] In phase Retarget, 2223 netlist objects are constrained preventing optimization. Please run opt_design with -debug_log to get more detail.

Phase 4 Constant propagation
INFO: [Opt 31-138] Pushed 0 inverter(s) to 0 load pin(s).
Phase 4 Constant propagation | Checksum: 1e3165c25

Time (s): cpu = 00:00:02 ; elapsed = 00:00:02 . Memory (MB): peak = 4657.520 ; gain = 0.000 ; free physical = 120793 ; free virtual = 133098
Constant propagation | Checksum: 1e3165c25
INFO: [Opt 31-389] Phase Constant propagation created 10 cells and removed 12 cells
INFO: [Opt 31-1021] In phase Constant propagation, 5328 netlist objects are constrained preventing optimization. Please run opt_design with -debug_log to get more detail.

Phase 5 Sweep
Phase 5 Sweep | Checksum: 240aa80f4

Time (s): cpu = 00:00:03 ; elapsed = 00:00:02 . Memory (MB): peak = 4657.520 ; gain = 0.000 ; free physical = 120793 ; free virtual = 133098
Sweep | Checksum: 240aa80f4
INFO: [Opt 31-389] Phase Sweep created 0 cells and removed 121 cells
INFO: [Opt 31-1021] In phase Sweep, 80152 netlist objects are constrained preventing optimization. Please run opt_design with -debug_log to get more detail.

Phase 6 BUFG optimization
INFO: [Opt 31-1077] Phase BUFG optimization inserted 0 global clock buffer(s) for CLOCK_LOW_FANOUT.
Phase 6 BUFG optimization | Checksum: 240aa80f4

Time (s): cpu = 00:00:03 ; elapsed = 00:00:02 . Memory (MB): peak = 4657.520 ; gain = 0.000 ; free physical = 120793 ; free virtual = 133097
BUFG optimization | Checksum: 240aa80f4
INFO: [Opt 31-662] Phase BUFG optimization created 0 cells of which 0 are BUFGs and removed 0 cells.
INFO: [Opt 31-1021] In phase BUFG optimization, 27 netlist objects are constrained preventing optimization. Please run opt_design with -debug_log to get more detail.

Phase 7 Shift Register Optimization
INFO: [Opt 31-1064] SRL Remap converted 0 SRLs to 0 registers and converted 0 registers of register chains to 0 SRLs
Phase 7 Shift Register Optimization | Checksum: 240aa80f4

Time (s): cpu = 00:00:03 ; elapsed = 00:00:02 . Memory (MB): peak = 4657.520 ; gain = 0.000 ; free physical = 120793 ; free virtual = 133097
Shift Register Optimization | Checksum: 240aa80f4
INFO: [Opt 31-389] Phase Shift Register Optimization created 0 cells and removed 0 cells

Phase 8 Post Processing Netlist
Phase 8 Post Processing Netlist | Checksum: 240aa80f4

Time (s): cpu = 00:00:04 ; elapsed = 00:00:03 . Memory (MB): peak = 4657.520 ; gain = 0.000 ; free physical = 120793 ; free virtual = 133097
Post Processing Netlist | Checksum: 240aa80f4
INFO: [Opt 31-389] Phase Post Processing Netlist created 0 cells and removed 0 cells
INFO: [Opt 31-1021] In phase Post Processing Netlist, 3578 netlist objects are constrained preventing optimization. Please run opt_design with -debug_log to get more detail.

Phase 9 Finalization

Phase 9.1 Finalizing Design Cores and Updating Shapes
Phase 9.1 Finalizing Design Cores and Updating Shapes | Checksum: 18a9c40b0

Time (s): cpu = 00:00:04 ; elapsed = 00:00:03 . Memory (MB): peak = 4657.520 ; gain = 0.000 ; free physical = 120793 ; free virtual = 133097

Phase 9.2 Verifying Netlist Connectivity

Starting Connectivity Check Task

Time (s): cpu = 00:00:00.03 ; elapsed = 00:00:00.03 . Memory (MB): peak = 4657.520 ; gain = 0.000 ; free physical = 120793 ; free virtual = 133097
Phase 9.2 Verifying Netlist Connectivity | Checksum: 18a9c40b0

Time (s): cpu = 00:00:05 ; elapsed = 00:00:04 . Memory (MB): peak = 4657.520 ; gain = 0.000 ; free physical = 120793 ; free virtual = 133097
Phase 9 Finalization | Checksum: 18a9c40b0

Time (s): cpu = 00:00:05 ; elapsed = 00:00:04 . Memory (MB): peak = 4657.520 ; gain = 0.000 ; free physical = 120793 ; free virtual = 133097
Opt_design Change Summary
=========================

-------------------------------------------------------------------------------------------------------------------------
| Phase | #Cells created | #Cells Removed | #Constrained objects preventing optimizations |
-------------------------------------------------------------------------------------------------------------------------
| Retarget | 2 | 8 | 2223 |
| Constant propagation | 10 | 12 | 5328 |
| Sweep | 0 | 121 | 80152 |
| BUFG optimization | 0 | 0 | 27 |
| Shift Register Optimization | 0 | 0 | 0 |
| Post Processing Netlist | 0 | 0 | 3578 |
-------------------------------------------------------------------------------------------------------------------------

Ending Logic Optimization Task | Checksum: 18a9c40b0

Time (s): cpu = 00:00:05 ; elapsed = 00:00:04 . Memory (MB): peak = 4657.520 ; gain = 0.000 ; free physical = 120793 ; free virtual = 133097

Starting Power Optimization Task
INFO: [Pwropt 34-132] Skipping clock gating for clocks with a period < 2.00 ns.
INFO: [Pwropt 34-232] Skipping BRAM gating because all BRAMs are in high frequency (i.e. period < 3.12 ns) clock domains.
INFO: [Pwropt 34-162] WRITE_MODE attribute of 0 BRAM(s) out of a total of 2 has been updated to save power. Run report_power_opt to get a complete listing of the BRAMs updated.
Ending Power Optimization Task | Checksum: 18a9c40b0

Time (s): cpu = 00:00:00.32 ; elapsed = 00:00:01 . Memory (MB): peak = 4721.520 ; gain = 64.000 ; free physical = 120754 ; free virtual = 133062

Starting Final Cleanup Task
Ending Final Cleanup Task | Checksum: 18a9c40b0

Time (s): cpu = 00:00:00.05 ; elapsed = 00:00:00.04 . Memory (MB): peak = 4721.520 ; gain = 0.000 ; free physical = 120754 ; free virtual = 133062

Starting Netlist Obfuscation Task
Netlist sorting complete. Time (s): cpu = 00:00:00.02 ; elapsed = 00:00:00.02 . Memory (MB): peak = 4721.520 ; gain = 0.000 ; free physical = 120754 ; free virtual = 133062
Ending Netlist Obfuscation Task | Checksum: 18a9c40b0

Time (s): cpu = 00:00:00.06 ; elapsed = 00:00:00.05 . Memory (MB): peak = 4721.520 ; gain = 0.000 ; free physical = 120754 ; free virtual = 133062
INFO: [Common 17-83] Releasing license: Implementation
26 Infos, 0 Warnings, 0 Critical Warnings and 0 Errors encountered.
opt_design completed successfully
opt_design: Time (s): cpu = 00:00:14 ; elapsed = 00:00:12 . Memory (MB): peak = 4721.520 ; gain = 321.020 ; free physical = 120754 ; free virtual = 133062
## if {[llength [get_cells -quiet WRAPPER/CL/CL_HBM/HBM_PRESENT_EQ_1.HBM_WRAPPER_I/HBM_CORE_I/inst]] > 0} {
## puts "INFO: HBM found, setting DONT_TOUCH to 0"
## set_property DONT_TOUCH 0 [get_cells WRAPPER/CL/CL_HBM/HBM_PRESENT_EQ_1.HBM_WRAPPER_I/HBM_CORE_I/inst]
## }
## print "Writing post-opt design checkpoint and report"

AWS FPGA: (12:18:08): Writing post-opt design checkpoint and report

## write_checkpoint -force ${checkpoints_dir}/${CL}.${TAG}.post_opt.dcp
INFO: [Timing 38-480] Writing timing data to binary archive.
Write ShapeDB Complete: Time (s): cpu = 00:00:00.04 ; elapsed = 00:00:00.01 . Memory (MB): peak = 4729.523 ; gain = 0.000 ; free physical = 120748 ; free virtual = 133065
Wrote PlaceDB: Time (s): cpu = 00:00:01 ; elapsed = 00:00:00.38 . Memory (MB): peak = 4729.523 ; gain = 0.000 ; free physical = 120744 ; free virtual = 133081
Wrote PulsedLatchDB: Time (s): cpu = 00:00:00 ; elapsed = 00:00:00 . Memory (MB): peak = 4729.523 ; gain = 0.000 ; free physical = 120744 ; free virtual = 133081
Writing XDEF routing.
Writing XDEF routing logical nets.
Writing XDEF routing special nets.
Wrote RouteStorage: Time (s): cpu = 00:00:00.5 ; elapsed = 00:00:00.12 . Memory (MB): peak = 4729.523 ; gain = 0.000 ; free physical = 120739 ; free virtual = 133081
Wrote Netlist Cache: Time (s): cpu = 00:00:00.04 ; elapsed = 00:00:00.01 . Memory (MB): peak = 4729.523 ; gain = 0.000 ; free physical = 120738 ; free virtual = 133082
Wrote Device Cache: Time (s): cpu = 00:00:00.04 ; elapsed = 00:00:00.01 . Memory (MB): peak = 4729.523 ; gain = 0.000 ; free physical = 120737 ; free virtual = 133083
Write Physdb Complete: Time (s): cpu = 00:00:02 ; elapsed = 00:00:00.53 . Memory (MB): peak = 4729.523 ; gain = 0.000 ; free physical = 120737 ; free virtual = 133083
INFO: [Common 17-1381] The checkpoint '/home/ubuntu/src/aws-fpga/hdk/cl/examples/top/build/checkpoints/top.2026_10_10-121021.post_opt.dcp' has been generated.
## report_timing -delay_type max \
## -path_type full_clock_expanded \
## -max_paths 10 \
## -nworst 1 \
## -input_pins \
## -slice_pins \
## -sort_by group \
## -significant_digits 3 \
## -file ${reports_dir}/${CL}.${TAG}.post_opt_timing.rpt
INFO: [Timing 38-91] UpdateTimingParams: Speed grade: -2, Temperature grade: E, Delay Type: max.
INFO: [Timing 38-191] Multithreading enabled for timing update using a maximum of 8 CPUs
INFO: [Timing 38-35] Done setting XDC timing constraints.
INFO: [Timing 38-78] ReportTimingParams: -max_paths 10 -nworst 1 -delay_type max -sort_by group.
report_timing: Time (s): cpu = 00:00:24 ; elapsed = 00:00:45 . Memory (MB): peak = 5231.777 ; gain = 486.246 ; free physical = 120102 ; free virtual = 132555
## print "Start placing customer design ${CL}"

AWS FPGA: (12:18:56): Start placing customer design top

## place_design -directive $PLACE_DIRECT -no_bufg_opt
Command: place_design -directive SSI_SpreadLogic_high -no_bufg_opt
Attempting to get a license for feature 'Implementation' and/or device 'xcvu47p'
INFO: [Common 17-349] Got license for feature 'Implementation' and/or device 'xcvu47p'
INFO: [Common 17-83] Releasing license: Implementation
INFO: [DRC 23-27] Running DRC with 8 threads
INFO: [Vivado_Tcl 4-198] DRC finished with 0 Errors
INFO: [Vivado_Tcl 4-199] Please refer to the DRC report (report_drc) for more information.
INFO: [Vivado_Tcl 4-2302] The placer was invoked with the 'SSI_SpreadLogic_high' directive.
Running DRC as a precondition to command place_design
INFO: [DRC 23-27] Running DRC with 8 threads
INFO: [Vivado_Tcl 4-198] DRC finished with 0 Errors
INFO: [Vivado_Tcl 4-199] Please refer to the DRC report (report_drc) for more information.
INFO: [Place 30-611] Multithreading enabled for place_design using a maximum of 8 CPUs

Starting Placer Task

Phase 1 Placer Initialization

Phase 1.1 Placer Initialization Netlist Sorting
Netlist sorting complete. Time (s): cpu = 00:00:00.02 ; elapsed = 00:00:00.02 . Memory (MB): peak = 5263.793 ; gain = 0.000 ; free physical = 120083 ; free virtual = 132538
Phase 1.1 Placer Initialization Netlist Sorting | Checksum: 183453516

Time (s): cpu = 00:00:00.13 ; elapsed = 00:00:00.13 . Memory (MB): peak = 5263.793 ; gain = 0.000 ; free physical = 120083 ; free virtual = 132538
Netlist sorting complete. Time (s): cpu = 00:00:00.02 ; elapsed = 00:00:00.02 . Memory (MB): peak = 5263.793 ; gain = 0.000 ; free physical = 120083 ; free virtual = 132538
WARNING: [Constraints 18-5648] For reconfigurable module WRAPPER/CL, the top/bottom edges of its PBLOCK pblock_CL are aligned with clock regions. With this type of floorplan, it has limited routability at PBLOCK top/bottom edges due to routing containment requirement. The edge tiles (only listed 10) are CLEM_X112Y480 CLEL_R_X112Y480 CLEL_R_X113Y480 CLEM_X114Y480 CLEM_X115Y480 CLEL_R_X115Y480 CLEM_X117Y480 CLEL_R_X118Y480 CLEM_X119Y480 CLEM_X120Y480 : . Tool will infer PROHIBIT on those tiles to enhancement routability at the edges of PBLOCK. You may also make the PBLOCK not aligned to clock region at top/bottom edges as a solution. Please refer 'Design Consideration' in UG909 for guidelines.
INFO: [Constraints 18-12184] Site SLICE_X176Y480 is prohibited due to Sites belong to FSR edge tile CLEM_X112Y480 of Pblock pblock_CL
INFO: [Constraints 18-12184] Site SLICE_X177Y480 is prohibited due to Sites belong to FSR edge tile CLEL_R_X112Y480 of Pblock pblock_CL
INFO: [Constraints 18-12184] Site SLICE_X178Y480 is prohibited due to Sites belong to FSR edge tile CLEL_R_X113Y480 of Pblock pblock_CL
INFO: [Constraints 18-12184] Site SLICE_X179Y480 is prohibited due to Sites belong to FSR edge tile CLEM_X114Y480 of Pblock pblock_CL
INFO: [Constraints 18-12184] Site SLICE_X180Y480 is prohibited due to Sites belong to FSR edge tile CLEM_X115Y480 of Pblock pblock_CL
INFO: [Constraints 18-12184] Site SLICE_X181Y480 is prohibited due to Sites belong to FSR edge tile CLEL_R_X115Y480 of Pblock pblock_CL
INFO: [Constraints 18-12184] Site SLICE_X184Y480 is prohibited due to Sites belong to FSR edge tile CLEM_X117Y480 of Pblock pblock_CL
INFO: [Constraints 18-12184] Site SLICE_X185Y480 is prohibited due to Sites belong to FSR edge tile CLEL_R_X118Y480 of Pblock pblock_CL
INFO: [Constraints 18-12184] Site SLICE_X186Y480 is prohibited due to Sites belong to FSR edge tile CLEM_X119Y480 of Pblock pblock_CL
INFO: [Constraints 18-12184] Site SLICE_X187Y480 is prohibited due to Sites belong to FSR edge tile CLEM_X120Y480 of Pblock pblock_CL
INFO: [Constraints 18-12184] Site SLICE_X188Y480 is prohibited due to Sites belong to FSR edge tile CLEL_R_X120Y480 of Pblock pblock_CL
INFO: [Constraints 18-12184] Site SLICE_X189Y480 is prohibited due to Sites belong to FSR edge tile CLEL_L_X121Y480 of Pblock pblock_CL
INFO: [Constraints 18-12184] Site SLICE_X190Y480 is prohibited due to Sites belong to FSR edge tile CLEL_R_X121Y480 of Pblock pblock_CL
INFO: [Constraints 18-12184] Site SLICE_X191Y480 is prohibited due to Sites belong to FSR edge tile CLEM_X122Y480 of Pblock pblock_CL
INFO: [Constraints 18-12184] Site SLICE_X192Y480 is prohibited due to Sites belong to FSR edge tile CLEM_X123Y480 of Pblock pblock_CL
INFO: [Constraints 18-12184] Site SLICE_X193Y480 is prohibited due to Sites belong to FSR edge tile CLEL_R_X123Y480 of Pblock pblock_CL
INFO: [Constraints 18-12184] Site SLICE_X196Y480 is prohibited due to Sites belong to FSR edge tile CLEM_X125Y480 of Pblock pblock_CL
INFO: [Constraints 18-12184] Site SLICE_X197Y480 is prohibited due to Sites belong to FSR edge tile CLEM_X126Y480 of Pblock pblock_CL
INFO: [Constraints 18-12184] Site SLICE_X198Y480 is prohibited due to Sites belong to FSR edge tile CLEL_R_X126Y480 of Pblock pblock_CL
INFO: [Constraints 18-12184] Site SLICE_X199Y480 is prohibited due to Sites belong to FSR edge tile CLEL_L_X127Y480 of Pblock pblock_CL
INFO: [Constraints 18-12184] Site SLICE_X200Y480 is prohibited due to Sites belong to FSR edge tile CLEL_R_X127Y480 of Pblock pblock_CL
INFO: [Constraints 18-12184] Site SLICE_X201Y480 is prohibited due to Sites belong to FSR edge tile CLEM_X128Y480 of Pblock pblock_CL
INFO: [Constraints 18-12184] Site SLICE_X202Y480 is prohibited due to Sites belong to FSR edge tile CLEL_R_X128Y480 of Pblock pblock_CL
INFO: [Constraints 18-12184] Site SLICE_X203Y480 is prohibited due to Sites belong to FSR edge tile CLEL_L_X129Y480 of Pblock pblock_CL
INFO: [Constraints 18-12184] Site SLICE_X204Y480 is prohibited due to Sites belong to FSR edge tile CLEL_R_X129Y480 of Pblock pblock_CL
INFO: [Constraints 18-12184] Site SLICE_X205Y480 is prohibited due to Sites belong to FSR edge tile CLEM_X130Y480 of Pblock pblock_CL
INFO: [Constraints 18-12184] Site SLICE_X206Y480 is prohibited due to Sites belong to FSR edge tile CLEM_X131Y480 of Pblock pblock_CL
INFO: [Constraints 18-12184] Site SLICE_X207Y480 is prohibited due to Sites belong to FSR edge tile CLEL_R_X131Y480 of Pblock pblock_CL
INFO: [Constraints 18-12184] Site SLICE_X208Y480 is prohibited due to Sites belong to FSR edge tile CLEM_X132Y480 of Pblock pblock_CL
INFO: [Constraints 18-12184] Site SLICE_X209Y480 is prohibited due to Sites belong to FSR edge tile CLEL_R_X132Y480 of Pblock pblock_CL
INFO: [Constraints 18-12184] Site SLICE_X210Y480 is prohibited due to Sites belong to FSR edge tile CLEM_X133Y480 of Pblock pblock_CL
INFO: [Constraints 18-12184] Site SLICE_X211Y480 is prohibited due to Sites belong to FSR edge tile CLEL_R_X133Y480 of Pblock pblock_CL
INFO: [Constraints 18-12184] Site SLICE_X212Y480 is prohibited due to Sites belong to FSR edge tile CLEM_X134Y480 of Pblock pblock_CL
INFO: [Constraints 18-12184] Site SLICE_X213Y480 is prohibited due to Sites belong to FSR edge tile CLEL_R_X134Y480 of Pblock pblock_CL
INFO: [Constraints 18-12184] Site SLICE_X216Y480 is prohibited due to Sites belong to FSR edge tile CLEM_X136Y480 of Pblock pblock_CL
INFO: [Constraints 18-12184] Site SLICE_X217Y480 is prohibited due to Sites belong to FSR edge tile CLEM_X137Y480 of Pblock pblock_CL
INFO: [Constraints 18-12184] Site SLICE_X218Y480 is prohibited due to Sites belong to FSR edge tile CLEL_R_X137Y480 of Pblock pblock_CL
INFO: [Constraints 18-12184] Site SLICE_X219Y480 is prohibited due to Sites belong to FSR edge tile CLEL_R_X138Y480 of Pblock pblock_CL
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
INFO: [Constraints 18-12184] Site SLICE_X218Y119 is prohibited due to Sites belong to FSR edge tile CLEL_R_X137Y119 of Pblock pblock_CL
INFO: [Constraints 18-12184] Site SLICE_X219Y119 is prohibited due to Sites belong to FSR edge tile CLEL_R_X138Y119 of Pblock pblock_CL
INFO: [Constraints 18-12184] Site SLICE_X221Y119 is prohibited due to Sites belong to FSR edge tile CLEL_R_X140Y119 of Pblock pblock_CL
INFO: [Constraints 18-12184] Site SLICE_X222Y119 is prohibited due to Sites belong to FSR edge tile CLEM_R_X141Y119 of Pblock pblock_CL
INFO: [Constraints 18-12184] Site SLICE_X223Y119 is prohibited due to Sites belong to FSR edge tile CLEL_R_X141Y119 of Pblock pblock_CL
INFO: [Constraints 18-12184] Site SLICE_X224Y119 is prohibited due to Sites belong to FSR edge tile CLEL_R_X142Y119 of Pblock pblock_CL
INFO: [Constraints 18-12184] Site SLICE_X225Y119 is prohibited due to Sites belong to FSR edge tile CLEM_R_X143Y119 of Pblock pblock_CL
INFO: [Constraints 18-12184] Site SLICE_X226Y119 is prohibited due to Sites belong to FSR edge tile CLEL_R_X143Y119 of Pblock pblock_CL
INFO: [Constraints 18-12184] Site SLICE_X227Y119 is prohibited due to Sites belong to FSR edge tile CLEM_R_X144Y119 of Pblock pblock_CL
INFO: [Common 17-14] Message 'Constraints 18-12184' appears 100 times and further instances of the messages will be disabled. Use the Tcl command set_msg_config to change the current settings.

Phase 1.2 IO Placement/ Clock Placement/ Build Placer Device
Phase 1.2 IO Placement/ Clock Placement/ Build Placer Device | Checksum: 254747221

Time (s): cpu = 00:01:41 ; elapsed = 00:01:41 . Memory (MB): peak = 5263.793 ; gain = 0.000 ; free physical = 120099 ; free virtual = 132559

Phase 1.3 Build Placer Netlist Model
Phase 1.3 Build Placer Netlist Model | Checksum: 28f03de90

Time (s): cpu = 00:01:51 ; elapsed = 00:01:48 . Memory (MB): peak = 5660.641 ; gain = 396.848 ; free physical = 119656 ; free virtual = 132118

Phase 1.4 Constrain Clocks/Macros
Phase 1.4 Constrain Clocks/Macros | Checksum: 28f03de90

Time (s): cpu = 00:01:51 ; elapsed = 00:01:48 . Memory (MB): peak = 5660.641 ; gain = 396.848 ; free physical = 119656 ; free virtual = 132118
Phase 1 Placer Initialization | Checksum: 28f03de90

Time (s): cpu = 00:01:52 ; elapsed = 00:01:49 . Memory (MB): peak = 5660.641 ; gain = 396.848 ; free physical = 119656 ; free virtual = 132118

Phase 2 Global Placement

Phase 2.1 Floorplanning

Phase 2.1.1 Partition Driven Placement

Phase 2.1.1.1 PBP: Partition Driven Placement
Phase 2.1.1.1 PBP: Partition Driven Placement | Checksum: 3059ea8d1

Time (s): cpu = 00:01:56 ; elapsed = 00:01:51 . Memory (MB): peak = 5660.641 ; gain = 396.848 ; free physical = 119647 ; free virtual = 132111

Phase 2.1.1.2 PBP: Clock Region Placement
Phase 2.1.1.2 PBP: Clock Region Placement | Checksum: 264d1c467

Time (s): cpu = 00:02:06 ; elapsed = 00:02:02 . Memory (MB): peak = 5660.641 ; gain = 396.848 ; free physical = 119619 ; free virtual = 132083

Phase 2.1.1.3 PBP: Compute Congestion
Phase 2.1.1.3 PBP: Compute Congestion | Checksum: 264d1c467

Time (s): cpu = 00:02:27 ; elapsed = 00:02:31 . Memory (MB): peak = 6053.625 ; gain = 789.832 ; free physical = 118763 ; free virtual = 131655

Phase 2.1.1.4 PBP: UpdateTiming
Phase 2.1.1.4 PBP: UpdateTiming | Checksum: 2126ead93

Time (s): cpu = 00:02:28 ; elapsed = 00:02:31 . Memory (MB): peak = 6085.641 ; gain = 821.848 ; free physical = 118790 ; free virtual = 131682

Phase 2.1.1.5 PBP: Add part constraints
Phase 2.1.1.5 PBP: Add part constraints | Checksum: 2126ead93

Time (s): cpu = 00:02:28 ; elapsed = 00:02:31 . Memory (MB): peak = 6085.641 ; gain = 821.848 ; free physical = 118790 ; free virtual = 131682
Phase 2.1.1 Partition Driven Placement | Checksum: 2126ead93

Time (s): cpu = 00:02:28 ; elapsed = 00:02:31 . Memory (MB): peak = 6085.641 ; gain = 821.848 ; free physical = 118790 ; free virtual = 131682
Phase 2.1 Floorplanning | Checksum: 2bb21388b

Time (s): cpu = 00:02:28 ; elapsed = 00:02:31 . Memory (MB): peak = 6085.641 ; gain = 821.848 ; free physical = 118790 ; free virtual = 131682

Phase 2.2 Physical Synthesis After Floorplan
INFO: [Physopt 32-775] End 1 Pass. Optimized 0 net or cell. Created 0 new cell, deleted 0 existing cell and moved 0 existing cell
Netlist sorting complete. Time (s): cpu = 00:00:00.02 ; elapsed = 00:00:00.02 . Memory (MB): peak = 6085.641 ; gain = 0.000 ; free physical = 118789 ; free virtual = 131682

Summary of Physical Synthesis Optimizations
============================================

-----------------------------------------------------------------------------------------------------------------------------------------------
| Optimization | Added Cells | Removed Cells | Optimized Cells/Nets | Dont Touch | Iterations | Elapsed |
-----------------------------------------------------------------------------------------------------------------------------------------------
| PSIP Post Floorplan SLR Replication | 0 | 0 | 0 | 0 | 1 | 00:00:00 |
| Total | 0 | 0 | 0 | 0 | 1 | 00:00:00 |
-----------------------------------------------------------------------------------------------------------------------------------------------

Phase 2.2 Physical Synthesis After Floorplan | Checksum: 2bb21388b

Time (s): cpu = 00:02:28 ; elapsed = 00:02:32 . Memory (MB): peak = 6085.641 ; gain = 821.848 ; free physical = 118789 ; free virtual = 131682

Phase 2.3 Update Timing before SLR Path Opt
Phase 2.3 Update Timing before SLR Path Opt | Checksum: 26f6c9dea

Time (s): cpu = 00:02:28 ; elapsed = 00:02:32 . Memory (MB): peak = 6085.641 ; gain = 821.848 ; free physical = 118788 ; free virtual = 131682

Phase 2.4 Post-Processing in Floorplanning
Phase 2.4 Post-Processing in Floorplanning | Checksum: 2ba8913d6

Time (s): cpu = 00:02:28 ; elapsed = 00:02:32 . Memory (MB): peak = 6085.641 ; gain = 821.848 ; free physical = 118788 ; free virtual = 131682

Phase 2.5 Global Placement Core
Phase 2.5.1 UpdateTiming Before Physical Synthesis
Phase 2.5.1 UpdateTiming Before Physical Synthesis | Checksum: 2732e2808

Time (s): cpu = 00:05:06 ; elapsed = 00:03:33 . Memory (MB): peak = 6649.680 ; gain = 1385.887 ; free physical = 118263 ; free virtual = 131157

Phase 2.5.2 Physical Synthesis In Placer
INFO: [Physopt 32-1035] Found 41 LUTNM shape to break, 238 LUT instances to create LUTNM shape
INFO: [Physopt 32-1044] Break lutnm for timing: one critical 0, two critical 41, total 40, new lutff created 0
INFO: [Physopt 32-1138] End 1 Pass. Optimized 148 nets or LUTs. Breaked 40 LUTs, combined 108 existing LUTs and moved 0 existing LUT
INFO: [Physopt 32-1030] Pass 1. Identified 12 candidate driver sets for equivalent driver rewiring.
INFO: [Physopt 32-661] Optimized 0 net. Re-placed 0 instance.
INFO: [Physopt 32-775] End 1 Pass. Optimized 0 net or cell. Created 0 new cell, deleted 0 existing cell and moved 0 existing cell
INFO: [Physopt 32-65] No nets found for high-fanout optimization.
INFO: [Physopt 32-232] Optimized 0 net. Created 0 new instance.
INFO: [Physopt 32-775] End 1 Pass. Optimized 0 net or cell. Created 0 new cell, deleted 0 existing cell and moved 0 existing cell
INFO: [Physopt 32-456] No candidate cells for DSP register optimization found in the design.
INFO: [Physopt 32-775] End 2 Pass. Optimized 0 net or cell. Created 0 new cell, deleted 0 existing cell and moved 0 existing cell
INFO: [Physopt 32-1123] No candidate cells found for Shift Register to Pipeline optimization
INFO: [Physopt 32-775] End 2 Pass. Optimized 0 net or cell. Created 0 new cell, deleted 0 existing cell and moved 0 existing cell
INFO: [Physopt 32-1401] No candidate cells found for Shift Register optimization.
INFO: [Physopt 32-677] No candidate cells for Shift Register optimization found in the design
INFO: [Physopt 32-775] End 1 Pass. Optimized 0 net or cell. Created 0 new cell, deleted 0 existing cell and moved 0 existing cell
INFO: [Physopt 32-526] No candidate cells for BRAM register optimization found in the design
INFO: [Physopt 32-775] End 1 Pass. Optimized 0 net or cell. Created 0 new cell, deleted 0 existing cell and moved 0 existing cell
INFO: [Physopt 32-846] No candidate cells for URAM register optimization found in the design
INFO: [Physopt 32-775] End 1 Pass. Optimized 0 net or cell. Created 0 new cell, deleted 0 existing cell and moved 0 existing cell
INFO: [Physopt 32-846] No candidate cells for URAM register optimization found in the design
INFO: [Physopt 32-775] End 1 Pass. Optimized 0 net or cell. Created 0 new cell, deleted 0 existing cell and moved 0 existing cell
INFO: [Physopt 32-949] No candidate nets found for dynamic/static region interface net replication
INFO: [Physopt 32-775] End 1 Pass. Optimized 0 net or cell. Created 0 new cell, deleted 0 existing cell and moved 0 existing cell
Netlist sorting complete. Time (s): cpu = 00:00:00.02 ; elapsed = 00:00:00.02 . Memory (MB): peak = 6649.680 ; gain = 0.000 ; free physical = 118263 ; free virtual = 131157

Summary of Physical Synthesis Optimizations
============================================

-----------------------------------------------------------------------------------------------------------------------------------------------------------
| Optimization | Added Cells | Removed Cells | Optimized Cells/Nets | Dont Touch | Iterations | Elapsed |
-----------------------------------------------------------------------------------------------------------------------------------------------------------
| LUT Combining | 40 | 108 | 148 | 0 | 1 | 00:00:00 |
| Retime | 0 | 0 | 0 | 0 | 1 | 00:00:00 |
| Equivalent Driver Rewiring | 0 | 0 | 0 | 0 | 1 | 00:00:00 |
| Very High Fanout | 0 | 0 | 0 | 0 | 1 | 00:00:00 |
| DSP Register | 0 | 0 | 0 | 0 | 1 | 00:00:00 |
| Shift Register to Pipeline | 0 | 0 | 0 | 0 | 1 | 00:00:00 |
| Shift Register | 0 | 0 | 0 | 0 | 1 | 00:00:00 |
| BRAM Register | 0 | 0 | 0 | 0 | 1 | 00:00:00 |
| URAM Register | 0 | 0 | 0 | 0 | 1 | 00:00:00 |
| Dynamic/Static Region Interface Net Replication | 0 | 0 | 0 | 0 | 1 | 00:00:00 |
| Total | 40 | 108 | 148 | 0 | 10 | 00:00:01 |
-----------------------------------------------------------------------------------------------------------------------------------------------------------

Phase 2.5.2 Physical Synthesis In Placer | Checksum: 2e2286ec3

Time (s): cpu = 00:05:08 ; elapsed = 00:03:34 . Memory (MB): peak = 6649.680 ; gain = 1385.887 ; free physical = 118262 ; free virtual = 131157
Phase 2.5 Global Placement Core | Checksum: 2e76aed24

Time (s): cpu = 00:05:59 ; elapsed = 00:03:51 . Memory (MB): peak = 6649.680 ; gain = 1385.887 ; free physical = 118288 ; free virtual = 131182
Phase 2 Global Placement | Checksum: 2e76aed24

Time (s): cpu = 00:05:59 ; elapsed = 00:03:51 . Memory (MB): peak = 6649.680 ; gain = 1385.887 ; free physical = 118288 ; free virtual = 131182
Phase 3 Detail Placement

Phase 3.1 Commit Multi Column Macros
Phase 3.1 Commit Multi Column Macros | Checksum: 2daf734de

Time (s): cpu = 00:06:23 ; elapsed = 00:03:58 . Memory (MB): peak = 6649.680 ; gain = 1385.887 ; free physical = 118295 ; free virtual = 131190

Phase 3.2 Commit Most Macros & LUTRAMs
Phase 3.2 Commit Most Macros & LUTRAMs | Checksum: 2cec43a5e

Time (s): cpu = 00:06:24 ; elapsed = 00:03:59 . Memory (MB): peak = 6649.680 ; gain = 1385.887 ; free physical = 118295 ; free virtual = 131190

Phase 3.3 Small Shape DP

Phase 3.3.1 Small Shape Clustering
Phase 3.3.1 Small Shape Clustering | Checksum: 1f8c5f24b

Time (s): cpu = 00:06:54 ; elapsed = 00:04:09 . Memory (MB): peak = 6649.680 ; gain = 1385.887 ; free physical = 118271 ; free virtual = 131166

Phase 3.3.2 Slice Area Swap

Phase 3.3.2.1 Slice Area Swap Initial
Phase 3.3.2.1 Slice Area Swap Initial | Checksum: 220c2a719

Time (s): cpu = 00:06:55 ; elapsed = 00:04:10 . Memory (MB): peak = 6649.680 ; gain = 1385.887 ; free physical = 118311 ; free virtual = 131206
Phase 3.3.2 Slice Area Swap | Checksum: 1f58fb6f2

Time (s): cpu = 00:06:57 ; elapsed = 00:04:12 . Memory (MB): peak = 6649.680 ; gain = 1385.887 ; free physical = 118311 ; free virtual = 131206
Phase 3.3 Small Shape DP | Checksum: 303cd8cd3

Time (s): cpu = 00:06:58 ; elapsed = 00:04:12 . Memory (MB): peak = 6649.680 ; gain = 1385.887 ; free physical = 118311 ; free virtual = 131206

Phase 3.4 Re-assign LUT pins
Phase 3.4 Re-assign LUT pins | Checksum: 29b172b65

Time (s): cpu = 00:06:59 ; elapsed = 00:04:13 . Memory (MB): peak = 6649.680 ; gain = 1385.887 ; free physical = 118273 ; free virtual = 131169

Phase 3.5 Pipeline Register Optimization
Phase 3.5 Pipeline Register Optimization | Checksum: 29b172b65

Time (s): cpu = 00:07:00 ; elapsed = 00:04:13 . Memory (MB): peak = 6649.680 ; gain = 1385.887 ; free physical = 118302 ; free virtual = 131197

Phase 3.6 Fast Optimization
Phase 3.6 Fast Optimization | Checksum: 2cbee68e1

Time (s): cpu = 00:07:10 ; elapsed = 00:04:21 . Memory (MB): peak = 6649.680 ; gain = 1385.887 ; free physical = 118297 ; free virtual = 131192
Phase 3 Detail Placement | Checksum: 2cbee68e1

Time (s): cpu = 00:07:10 ; elapsed = 00:04:21 . Memory (MB): peak = 6649.680 ; gain = 1385.887 ; free physical = 118297 ; free virtual = 131192
Phase 4 Post Placement Optimization and Clean-Up

Phase 4.1 Post Commit Optimization
INFO: [Timing 38-35] Done setting XDC timing constraints.

Phase 4.1.1 Post Placement Optimization

Phase 4.1.1.1 BUFG Replication
INFO: [Place 46-63] BUFG replication identified 0 candidate nets: Replicated nets: 0, Replicated BUFGs: 0, Replicated BUFG Driver: 0, moved BUFGs: 0, Skipped due to Placement / Routing Conflict: 0, Skipped due to Timing: 0, Skipped due to constraints: 0
Phase 4.1.1.1 BUFG Replication | Checksum: 3793796f2

Time (s): cpu = 00:07:41 ; elapsed = 00:04:32 . Memory (MB): peak = 6649.680 ; gain = 1385.887 ; free physical = 118280 ; free virtual = 131175

Phase 4.1.1.2 Post Placement Timing Optimization
INFO: [Place 30-746] Post Placement Timing Summary WNS=0.138. For the most accurate timing information please run report_timing.
Phase 4.1.1.2 Post Placement Timing Optimization | Checksum: 2b86c8e5a

Time (s): cpu = 00:08:00 ; elapsed = 00:04:51 . Memory (MB): peak = 6649.680 ; gain = 1385.887 ; free physical = 118279 ; free virtual = 131174

Phase 4.1.1.3 Replication
INFO: [Place 46-19] Post Replication Timing Summary WNS=0.138. For the most accurate timing information please run report_timing.
Phase 4.1.1.3 Replication | Checksum: 2b86c8e5a

Time (s): cpu = 00:08:01 ; elapsed = 00:04:51 . Memory (MB): peak = 6649.680 ; gain = 1385.887 ; free physical = 118279 ; free virtual = 131174

Time (s): cpu = 00:08:01 ; elapsed = 00:04:51 . Memory (MB): peak = 6649.680 ; gain = 1385.887 ; free physical = 118279 ; free virtual = 131174
Phase 4.1 Post Commit Optimization | Checksum: 2b86c8e5a

Time (s): cpu = 00:08:01 ; elapsed = 00:04:52 . Memory (MB): peak = 6649.680 ; gain = 1385.887 ; free physical = 118279 ; free virtual = 131174
Netlist sorting complete. Time (s): cpu = 00:00:00.02 ; elapsed = 00:00:00.02 . Memory (MB): peak = 6730.895 ; gain = 0.000 ; free physical = 118171 ; free virtual = 131067

Phase 4.2 Post Placement Cleanup
Phase 4.2 Post Placement Cleanup | Checksum: 219679b44

Time (s): cpu = 00:08:43 ; elapsed = 00:05:17 . Memory (MB): peak = 6730.895 ; gain = 1467.102 ; free physical = 118199 ; free virtual = 131095

Phase 4.3 Placer Reporting

Phase 4.3.1 Print Estimated Congestion
INFO: [Place 30-612] Post-Placement Estimated Congestion
________________________________________________________________________
| | Global Congestion | Long Congestion | Short Congestion |
| Direction | Region Size | Region Size | Region Size |
|___________|___________________|___________________|___________________|
| North| 1x1| 1x1| 1x1|
|___________|___________________|___________________|___________________|
| South| 1x1| 1x1| 1x1|
|___________|___________________|___________________|___________________|
| East| 1x1| 1x1| 4x4|
|___________|___________________|___________________|___________________|
| West| 1x1| 1x1| 1x1|
|___________|___________________|___________________|___________________|

SLR0:
________________________________________________________________________
| | Global Congestion | Long Congestion | Short Congestion |
| Direction | Region Size | Region Size | Region Size |
|___________|___________________|___________________|___________________|
| North| 1x1| 1x1| 1x1|
|___________|___________________|___________________|___________________|
| South| 1x1| 1x1| 1x1|
|___________|___________________|___________________|___________________|
| East| 1x1| 1x1| 1x1|
|___________|___________________|___________________|___________________|
| West| 1x1| 1x1| 1x1|
|___________|___________________|___________________|___________________|

SLR1:
________________________________________________________________________
| | Global Congestion | Long Congestion | Short Congestion |
| Direction | Region Size | Region Size | Region Size |
|___________|___________________|___________________|___________________|
| North| 1x1| 1x1| 1x1|
|___________|___________________|___________________|___________________|
| South| 1x1| 1x1| 1x1|
|___________|___________________|___________________|___________________|
| East| 1x1| 1x1| 4x4|
|___________|___________________|___________________|___________________|
| West| 1x1| 1x1| 1x1|
|___________|___________________|___________________|___________________|

SLR2:
________________________________________________________________________
| | Global Congestion | Long Congestion | Short Congestion |
| Direction | Region Size | Region Size | Region Size |
|___________|___________________|___________________|___________________|
| North| 1x1| 1x1| 1x1|
|___________|___________________|___________________|___________________|
| South| 1x1| 1x1| 1x1|
|___________|___________________|___________________|___________________|
| East| 1x1| 1x1| 1x1|
|___________|___________________|___________________|___________________|
| West| 1x1| 1x1| 1x1|
|___________|___________________|___________________|___________________|

Phase 4.3.1 Print Estimated Congestion | Checksum: 219679b44

Time (s): cpu = 00:08:43 ; elapsed = 00:05:17 . Memory (MB): peak = 6730.895 ; gain = 1467.102 ; free physical = 118199 ; free virtual = 131095
Phase 4.3 Placer Reporting | Checksum: 219679b44

Time (s): cpu = 00:08:43 ; elapsed = 00:05:17 . Memory (MB): peak = 6730.895 ; gain = 1467.102 ; free physical = 118199 ; free virtual = 131095

Phase 4.4 Final Placement Cleanup
Netlist sorting complete. Time (s): cpu = 00:00:00.02 ; elapsed = 00:00:00.02 . Memory (MB): peak = 6730.895 ; gain = 0.000 ; free physical = 118199 ; free virtual = 131095

Time (s): cpu = 00:08:43 ; elapsed = 00:05:17 . Memory (MB): peak = 6730.895 ; gain = 1467.102 ; free physical = 118199 ; free virtual = 131095
Phase 4 Post Placement Optimization and Clean-Up | Checksum: 16623efdb

Time (s): cpu = 00:08:43 ; elapsed = 00:05:17 . Memory (MB): peak = 6730.895 ; gain = 1467.102 ; free physical = 118199 ; free virtual = 131095
Ending Placer Task | Checksum: 1127fa8de

Time (s): cpu = 00:08:43 ; elapsed = 00:05:17 . Memory (MB): peak = 6730.895 ; gain = 1467.102 ; free physical = 118199 ; free virtual = 131095
141 Infos, 1 Warnings, 0 Critical Warnings and 0 Errors encountered.
place_design completed successfully
place_design: Time (s): cpu = 00:08:56 ; elapsed = 00:05:24 . Memory (MB): peak = 6730.895 ; gain = 1499.117 ; free physical = 118199 ; free virtual = 131095
## print "Writing post-place design checkpoint and report"

AWS FPGA: (12:24:20): Writing post-place design checkpoint and report

## write_checkpoint -force ${checkpoints_dir}/${CL}.${TAG}.post_place.dcp
INFO: [Timing 38-480] Writing timing data to binary archive.
Write ShapeDB Complete: Time (s): cpu = 00:00:00.06 ; elapsed = 00:00:00.02 . Memory (MB): peak = 6730.895 ; gain = 0.000 ; free physical = 118195 ; free virtual = 131100
Wrote PlaceDB: Time (s): cpu = 00:00:03 ; elapsed = 00:00:00.86 . Memory (MB): peak = 6730.895 ; gain = 0.000 ; free physical = 118163 ; free virtual = 131108
Wrote PulsedLatchDB: Time (s): cpu = 00:00:00 ; elapsed = 00:00:00 . Memory (MB): peak = 6730.895 ; gain = 0.000 ; free physical = 118163 ; free virtual = 131108
Writing XDEF routing.
Writing XDEF routing logical nets.
Writing XDEF routing special nets.
Wrote RouteStorage: Time (s): cpu = 00:00:00.4 ; elapsed = 00:00:00.11 . Memory (MB): peak = 6730.895 ; gain = 0.000 ; free physical = 118162 ; free virtual = 131109
Wrote Netlist Cache: Time (s): cpu = 00:00:00.07 ; elapsed = 00:00:00.03 . Memory (MB): peak = 6730.895 ; gain = 0.000 ; free physical = 118159 ; free virtual = 131109
Wrote Device Cache: Time (s): cpu = 00:00:00.04 ; elapsed = 00:00:00.01 . Memory (MB): peak = 6730.895 ; gain = 0.000 ; free physical = 118157 ; free virtual = 131109
Write Physdb Complete: Time (s): cpu = 00:00:04 ; elapsed = 00:00:01 . Memory (MB): peak = 6730.895 ; gain = 0.000 ; free physical = 118157 ; free virtual = 131109
INFO: [Common 17-1381] The checkpoint '/home/ubuntu/src/aws-fpga/hdk/cl/examples/top/build/checkpoints/top.2026_10_10-121021.post_place.dcp' has been generated.
## report_timing -delay_type max \
## -path_type full_clock_expanded \
## -max_paths 10 \
## -nworst 1 \
## -input_pins \
## -slice_pins \
## -sort_by group \
## -significant_digits 3 \
## -file $reports_dir/${CL}.${TAG}.post_place_timing.rpt
INFO: [Timing 38-91] UpdateTimingParams: Speed grade: -2, Temperature grade: E, Delay Type: max.
INFO: [Timing 38-191] Multithreading enabled for timing update using a maximum of 8 CPUs
INFO: [Timing 38-78] ReportTimingParams: -max_paths 10 -nworst 1 -delay_type max -sort_by group.
## print "Start physical-optimizing customer design ${CL}"

AWS FPGA: (12:24:24): Start physical-optimizing customer design top

## phys_opt_design -directive $PHY_OPT_DIRECT
Command: phys_opt_design -directive AggressiveExplore
Attempting to get a license for feature 'Implementation' and/or device 'xcvu47p'
INFO: [Common 17-349] Got license for feature 'Implementation' and/or device 'xcvu47p'
INFO: [Vivado_Tcl 4-137] Directive used for phys_opt_design is: AggressiveExplore
INFO: [Vivado_Tcl 4-2280] Estimated Timing Summary | WNS= 0.138 | TNS= 0.000 | WHS= -3.125 |
INFO: [Vivado_Tcl 4-383] Design worst setup slack (WNS) is greater than or equal to 0.000 ns. All physical synthesis setup optimizations will be skipped.
INFO: [Vivado_Tcl 4-1435] PhysOpt_Tcl_Interface Runtime Before Starting Physical Synthesis Task | CPU: 0.62s | WALL: 0.21s
Netlist sorting complete. Time (s): cpu = 00:00:00.03 ; elapsed = 00:00:00.02 . Memory (MB): peak = 6730.895 ; gain = 0.000 ; free physical = 118188 ; free virtual = 131096

Starting Physical Synthesis Task

Phase 1 Physical Synthesis Initialization
INFO: [Physopt 32-245] Routed nets are present in the design. phys_opt_design will optimize unrouted part of the design.
INFO: [Physopt 32-721] Multithreading enabled for phys_opt_design using a maximum of 8 CPUs
INFO: [Physopt 32-619] Estimated Timing Summary | WNS=0.138 | TNS=0.000 |
Phase 1 Physical Synthesis Initialization | Checksum: 1667b2a64

Time (s): cpu = 00:01:40 ; elapsed = 00:01:37 . Memory (MB): peak = 6730.895 ; gain = 0.000 ; free physical = 118162 ; free virtual = 131071
INFO: [Physopt 32-245] Routed nets are present in the design. phys_opt_design will optimize unrouted part of the design.

Phase 2 Hold Fix Optimization
INFO: [Physopt 32-668] Estimated Timing Summary | WNS=0.138 | TNS=0.000 | WHS=-3.125 | THS=-32.141 |
INFO: [Physopt 32-45] Identified 7 candidate nets for hold slack optimization.
INFO: [Physopt 32-234] Optimized 2 nets. Inserted 0 new ZHOLD_DELAYs. Calibrated 0 existing ZHOLD_DELAYs. Inserted 2 buffers.

Netlist sorting complete. Time (s): cpu = 00:00:00.03 ; elapsed = 00:00:00.03 . Memory (MB): peak = 6730.895 ; gain = 0.000 ; free physical = 118161 ; free virtual = 131070
INFO: [Physopt 32-668] Estimated Timing Summary | WNS=0.138 | TNS=0.000 | WHS=-3.054 | THS=-23.871 |
Phase 2 Hold Fix Optimization | Checksum: 153147622

Time (s): cpu = 00:01:46 ; elapsed = 00:01:40 . Memory (MB): peak = 6730.895 ; gain = 0.000 ; free physical = 118161 ; free virtual = 131070
Netlist sorting complete. Time (s): cpu = 00:00:00.02 ; elapsed = 00:00:00.02 . Memory (MB): peak = 6730.895 ; gain = 0.000 ; free physical = 118161 ; free virtual = 131070
INFO: [Physopt 32-669] Post Physical Optimization Timing Summary | WNS=0.138 | TNS=0.000 | WHS=-3.054 | THS=-23.871 |

Summary of Physical Synthesis Optimizations
============================================

----------------------------------------------------------------------------------------------------------------------------------------------------------------------
| Optimization | WNS Gain (ns) | TNS Gain (ns) | Added Cells | Removed Cells | Optimized Cells/Nets | Dont Touch | Iterations | Elapsed |
----------------------------------------------------------------------------------------------------------------------------------------------------------------------
| Fanout | 0.000 | 0.000 | 0 | 0 | 0 | 0 | 0 | 00:00:00 |
| Single Cell Placement | 0.000 | 0.000 | 0 | 0 | 0 | 0 | 0 | 00:00:00 |
| Multi Cell Placement | 0.000 | 0.000 | 0 | 0 | 0 | 0 | 0 | 00:00:00 |
| Rewire | 0.000 | 0.000 | 0 | 0 | 0 | 0 | 0 | 00:00:00 |
| Critical Cell | 0.000 | 0.000 | 0 | 0 | 0 | 0 | 0 | 00:00:00 |
| SLR Crossing | 0.000 | 0.000 | 0 | 0 | 0 | 0 | 0 | 00:00:00 |
| DSP Register | 0.000 | 0.000 | 0 | 0 | 0 | 0 | 0 | 00:00:00 |
| BRAM Register | 0.000 | 0.000 | 0 | 0 | 0 | 0 | 0 | 00:00:00 |
| URAM Register | 0.000 | 0.000 | 0 | 0 | 0 | 0 | 0 | 00:00:00 |
| Shift Register | 0.000 | 0.000 | 0 | 0 | 0 | 0 | 0 | 00:00:00 |
| Critical Pin | 0.000 | 0.000 | 0 | 0 | 0 | 0 | 0 | 00:00:00 |
| Very High Fanout | 0.000 | 0.000 | 0 | 0 | 0 | 0 | 0 | 00:00:00 |
| Total | 0.000 | 0.000 | 0 | 0 | 0 | 0 | 0 | 00:00:00 |
----------------------------------------------------------------------------------------------------------------------------------------------------------------------

Summary of Hold Fix Optimizations
=================================

--------------------------------------------------------------------------------------------------------------------------------------------------------------
| Optimization | WHS Gain (ns) | THS Gain (ns) | Added LUTs | Added FFs | Optimized Nets | Dont Touch | Iterations | Elapsed |
--------------------------------------------------------------------------------------------------------------------------------------------------------------
| LUT1 and ZHOLD Insertion | 0.071 | 8.271 | 2 | 0 | 2 | 0 | 1 | 00:00:01 |
| Total | 0.071 | 8.271 | 2 | 0 | 2 | 0 | 1 | 00:00:01 |
--------------------------------------------------------------------------------------------------------------------------------------------------------------

Netlist sorting complete. Time (s): cpu = 00:00:00.02 ; elapsed = 00:00:00.02 . Memory (MB): peak = 6730.895 ; gain = 0.000 ; free physical = 118161 ; free virtual = 131070
Ending Physical Synthesis Task | Checksum: 11d301dab

Time (s): cpu = 00:01:46 ; elapsed = 00:01:41 . Memory (MB): peak = 6730.895 ; gain = 0.000 ; free physical = 118161 ; free virtual = 131070
INFO: [Common 17-83] Releasing license: Implementation
15 Infos, 0 Warnings, 0 Critical Warnings and 0 Errors encountered.
phys_opt_design completed successfully
phys_opt_design: Time (s): cpu = 00:01:47 ; elapsed = 00:01:41 . Memory (MB): peak = 6730.895 ; gain = 0.000 ; free physical = 118161 ; free virtual = 131070
## print "Writing post-phy_opt design checkpoint and report"

AWS FPGA: (12:26:05): Writing post-phy_opt design checkpoint and report

## write_checkpoint -force ${checkpoints_dir}/${CL}.${TAG}.post_phys_opt.dcp
INFO: [Timing 38-480] Writing timing data to binary archive.
Write ShapeDB Complete: Time (s): cpu = 00:00:00.11 ; elapsed = 00:00:00.02 . Memory (MB): peak = 6730.895 ; gain = 0.000 ; free physical = 118155 ; free virtual = 131075
Wrote PlaceDB: Time (s): cpu = 00:00:03 ; elapsed = 00:00:00.86 . Memory (MB): peak = 6730.895 ; gain = 0.000 ; free physical = 118134 ; free virtual = 131092
Wrote PulsedLatchDB: Time (s): cpu = 00:00:00 ; elapsed = 00:00:00 . Memory (MB): peak = 6730.895 ; gain = 0.000 ; free physical = 118134 ; free virtual = 131092
Writing XDEF routing.
Writing XDEF routing logical nets.
Writing XDEF routing special nets.
Wrote RouteStorage: Time (s): cpu = 00:00:00.38 ; elapsed = 00:00:00.12 . Memory (MB): peak = 6730.895 ; gain = 0.000 ; free physical = 118132 ; free virtual = 131092
Wrote Netlist Cache: Time (s): cpu = 00:00:00.08 ; elapsed = 00:00:00.02 . Memory (MB): peak = 6730.895 ; gain = 0.000 ; free physical = 118130 ; free virtual = 131091
Wrote Device Cache: Time (s): cpu = 00:00:00.04 ; elapsed = 00:00:00.02 . Memory (MB): peak = 6730.895 ; gain = 0.000 ; free physical = 118128 ; free virtual = 131091
Write Physdb Complete: Time (s): cpu = 00:00:04 ; elapsed = 00:00:01 . Memory (MB): peak = 6730.895 ; gain = 0.000 ; free physical = 118128 ; free virtual = 131092
INFO: [Common 17-1381] The checkpoint '/home/ubuntu/src/aws-fpga/hdk/cl/examples/top/build/checkpoints/top.2026_10_10-121021.post_phys_opt.dcp' has been generated.
## report_timing -delay_type max \
## -path_type full_clock_expanded \
## -max_paths 10 \
## -nworst 1 \
## -input_pins \
## -slice_pins \
## -sort_by group \
## -significant_digits 3 \
## -file $reports_dir/${CL}.${TAG}.post_phy_opt_timing.rpt
INFO: [Timing 38-91] UpdateTimingParams: Speed grade: -2, Temperature grade: E, Delay Type: max.
INFO: [Timing 38-191] Multithreading enabled for timing update using a maximum of 8 CPUs
INFO: [Timing 38-78] ReportTimingParams: -max_paths 10 -nworst 1 -delay_type max -sort_by group.
## print "Start routing customer design ${CL}"

AWS FPGA: (12:26:10): Start routing customer design top

## route_design -directive $ROUTE_DIRECT -tns_cleanup
Command: route_design -directive AggressiveExplore -tns_cleanup
Attempting to get a license for feature 'Implementation' and/or device 'xcvu47p'
INFO: [Common 17-349] Got license for feature 'Implementation' and/or device 'xcvu47p'
INFO: [DRC 23-27] Running DRC with 8 threads
INFO: [Vivado_Tcl 4-198] DRC finished with 0 Errors
INFO: [Vivado_Tcl 4-199] Please refer to the DRC report (report_drc) for more information.
Running DRC as a precondition to command route_design
INFO: [DRC 23-27] Running DRC with 8 threads
INFO: [Vivado_Tcl 4-198] DRC finished with 0 Errors
INFO: [Vivado_Tcl 4-199] Please refer to the DRC report (report_drc) for more information.

Starting Routing Task
INFO: [Route 35-270] Using Router directive 'AggressiveExplore'.
INFO: [Route 35-254] Multithreading enabled for route_design using a maximum of 8 CPUs

Phase 1 Build RT Design
Checksum: PlaceDB: 285afa6a ConstDB: 0 ShapeSum: 513ebfd3 RouteDB: 5178a534
Nodegraph reading from file. Time (s): cpu = 00:00:02 ; elapsed = 00:00:03 . Memory (MB): peak = 6738.898 ; gain = 0.000 ; free physical = 118155 ; free virtual = 131085
INFO: [Route 35-375] Restored and blocked 360 bleed over nodes.
Post Restoration Checksum: NetGraph: 5bc79ec4 | NumContArr: 9cfc4ce1 | Constraints: 342cf22d | Timing: c2a8fa9d
Phase 1 Build RT Design | Checksum: 1ef99d86f

Time (s): cpu = 00:00:16 ; elapsed = 00:00:12 . Memory (MB): peak = 6738.898 ; gain = 0.000 ; free physical = 118149 ; free virtual = 131080

Phase 2 Router Initialization

Phase 2.1 Fix Topology Constraints
Phase 2.1 Fix Topology Constraints | Checksum: 1ef99d86f

Time (s): cpu = 00:00:16 ; elapsed = 00:00:12 . Memory (MB): peak = 6738.898 ; gain = 0.000 ; free physical = 118149 ; free virtual = 131080

Phase 2.2 Pre Route Cleanup
Phase 2.2 Pre Route Cleanup | Checksum: 1ef99d86f

Time (s): cpu = 00:00:17 ; elapsed = 00:00:12 . Memory (MB): peak = 6738.898 ; gain = 0.000 ; free physical = 118149 ; free virtual = 131080

Phase 2.3 Global Clock Net Routing
Number of Nodes with overlaps = 0
Phase 2.3 Global Clock Net Routing | Checksum: 177bc7b65

Time (s): cpu = 00:00:24 ; elapsed = 00:00:14 . Memory (MB): peak = 7142.766 ; gain = 403.867 ; free physical = 117712 ; free virtual = 130645

Phase 2.4 Update Timing
Phase 2.4 Update Timing | Checksum: 12509b59d

Time (s): cpu = 00:00:28 ; elapsed = 00:00:15 . Memory (MB): peak = 7142.766 ; gain = 403.867 ; free physical = 117712 ; free virtual = 130645
INFO: [Route 35-416] Intermediate Timing Summary | WNS=0.089 | TNS=0.000 | WHS=-2.037 | THS=-15.297|

Router Utilization Summary
Global Vertical Routing Utilization = 0 %
Global Horizontal Routing Utilization = 0 %
Routable Net Status*
*Does not include unroutable nets such as driverless and loadless.
Run report_route_status for detailed report.
Number of Failed Nets = 8355
(Failed Nets is the sum of unrouted and partially routed nets)
Number of Unrouted Nets = 5202
Number of Partially Routed Nets = 3153
Number of Node Overlaps = 0

Phase 2 Router Initialization | Checksum: 8f9ca0a7

Time (s): cpu = 00:00:40 ; elapsed = 00:00:19 . Memory (MB): peak = 7208.516 ; gain = 469.617 ; free physical = 117635 ; free virtual = 130569

Phase 3 Global Routing
Phase 3 Global Routing | Checksum: 8f9ca0a7

Time (s): cpu = 00:00:41 ; elapsed = 00:00:19 . Memory (MB): peak = 7208.516 ; gain = 469.617 ; free physical = 117635 ; free virtual = 130569

Phase 4 Initial Routing

Phase 4.1 Initial Net Routing Pass
Phase 4.1 Initial Net Routing Pass | Checksum: 1fbb39720

Time (s): cpu = 00:00:52 ; elapsed = 00:00:22 . Memory (MB): peak = 7208.516 ; gain = 469.617 ; free physical = 117651 ; free virtual = 130585
Phase 4 Initial Routing | Checksum: 25294f651

Time (s): cpu = 00:00:53 ; elapsed = 00:00:22 . Memory (MB): peak = 7208.516 ; gain = 469.617 ; free physical = 117651 ; free virtual = 130585
INFO: [Route 35-580] Design has 9 pins with tight setup and hold constraints.

The top 5 pins with tight setup and hold constraints:

+====================+===================+==================================================+
| Launch Setup Clock | Launch Hold Clock | Pin |
+====================+===================+==================================================+
| clk_main_a0 | clk_main_a0 | WRAPPER/CL/riscvtop/e_PROCESSOR/pins_s1_reg[4]/D |
| clk_main_a0 | clk_main_a0 | WRAPPER/CL/riscvtop/e_PROCESSOR/pins_s1_reg[7]/D |
| clk_main_a0 | clk_main_a0 | WRAPPER/CL/riscvtop/e_PROCESSOR/pins_s1_reg[3]/D |
| clk_main_a0 | clk_main_a0 | WRAPPER/CL/riscvtop/e_PROCESSOR/pins_s1_reg[5]/D |
| clk_main_a0 | clk_main_a0 | WRAPPER/CL/riscvtop/e_PROCESSOR/pins_s1_reg[1]/D |
+--------------------+-------------------+--------------------------------------------------+

File with complete list of pins: tight_setup_hold_pins.txt

Phase 5 Rip-up And Reroute

Phase 5.1 Global Iteration 0
Number of Nodes with overlaps = 1515
Number of Nodes with overlaps = 69
Number of Nodes with overlaps = 8
Number of Nodes with overlaps = 0
INFO: [Route 35-416] Intermediate Timing Summary | WNS=-0.092 | TNS=-0.092 | WHS=-0.704 | THS=-4.883 |
Phase 5.1 Global Iteration 0 | Checksum: 2138876fd

Time (s): cpu = 00:03:10 ; elapsed = 00:01:04 . Memory (MB): peak = 7454.516 ; gain = 715.617 ; free physical = 117444 ; free virtual = 130378

Phase 5.2 Global Iteration 1
Number of Nodes with overlaps = 26
Number of Nodes with overlaps = 1
Number of Nodes with overlaps = 1
Number of Nodes with overlaps = 0
INFO: [Route 35-416] Intermediate Timing Summary | WNS=-0.378 | TNS=-1.552 | WHS=N/A | THS=N/A |
Phase 5.2 Global Iteration 1 | Checksum: 284fdd440

Time (s): cpu = 00:05:08 ; elapsed = 00:01:43 . Memory (MB): peak = 7454.516 ; gain = 715.617 ; free physical = 117425 ; free virtual = 130359

Phase 5.3 Global Iteration 2
Number of Nodes with overlaps = 17
Number of Nodes with overlaps = 0
INFO: [Route 35-416] Intermediate Timing Summary | WNS=-0.370 | TNS=-1.271 | WHS=N/A | THS=N/A |
<html>
<head><title>502 Bad Gateway</title></head>
<body>
<center><h1>502 Bad Gateway</h1></center>
</body>
</html>
<!-- a padding to disable MSIE and Chrome friendly error page -->
<!-- a padding to disable MSIE and Chrome friendly error page -->
<!-- a padding to disable MSIE and Chrome friendly error page -->
<!-- a padding to disable MSIE and Chrome friendly error page -->
<!-- a padding to disable MSIE and Chrome friendly error page -->
<!-- a padding to disable MSIE and Chrome friendly error page -->
#-----------------------------------------------------------
# Vivado v2024.1 (64-bit)
# SW Build 5076996 on Wed May 22 18:36:09 MDT 2024
# IP Build 5075265 on Wed May 22 21:45:21 MDT 2024
# SharedData Build 5076995 on Wed May 22 18:29:18 MDT 2024
# Start of session at: Sat Oct 10 12:10:27 2026
# Process ID: 3544
# Current directory: /home/ubuntu/src/aws-fpga/hdk/cl/examples/top/build/scripts
# Command line: vivado -mode batch -source build_all.tcl -log 2026_10_10-121021.vivado.log -tclargs SSI_SpreadLogic_high AggressiveExplore AggressiveExplore A1 B2 C0 H2
# Log file: /home/ubuntu/src/aws-fpga/hdk/cl/examples/top/build/scripts/2026_10_10-121021.vivado.log
# Journal file: /home/ubuntu/src/aws-fpga/hdk/cl/examples/top/build/scripts/vivado.jou
# Running On :ip-10-0-5-224
# Platform :Ubuntu
# Operating System :Ubuntu 20.04.6 LTS
# Processor Detail :Intel(R) Xeon(R) Platinum 8488C
# CPU Frequency :2400.000 MHz
# CPU Physical cores:8
# CPU Logical cores :16
# Host memory :132920 MB
# Swap memory :10737 MB
# Total Virtual :143657 MB
# Available Virtual :142997 MB
#-----------------------------------------------------------
source build_all.tcl
# proc print {message} {
# set prefix "\nAWS FPGA: ([clock format [clock seconds] -format %T]): "
# append output $prefix $message "\n"
# puts $output
# }
# proc check_timing_path { {verbose 1} } {
#
# set setupPaths [get_timing_paths -max_paths 1 -slack_lesser_than 0 -setup]
# set holdPaths [get_timing_paths -max_paths 1 -slack_lesser_than 0 -hold]
#
# if {$verbose>0} {
# print "Checking the negative slack path of the existing design"
# }
#
# if {[llength $setupPaths] == 0 && [llength $holdPaths] == 0} {
# if {$verbose>0} {
# print "SUCCESS: Design has no negative slack path"
# }
# return 0
# } else {
# if {$verbose>0} {
# print "CRITICAL WARNING: Found $setupPaths negative setup slack paths and $holdPaths negative hold slack hold paths"
# }
# return 1
# }
# }
# proc create_dir {name path {verbose 0}} {
#
# # Better to use absolute path
# set cur [pwd]
# # Check if the $path exists
# if {![file isdirectory $path]} {
# error "$path doesn't exist"
# }
# cd $path
# set path_abs [pwd]
#
# cd $cur
# # Check and create the directory if not exists
# if {![file isdirectory $path_abs/$name]} {
# file mkdir $path_abs/$name
# if {$verbose>0} {
# print "Creating new folder $path_abs/$name"
# }
# } elseif {$verbose>0} {
# print "Found existing folder $path_abs/$name. Folder creation skipped"
# }
# return $path_abs/$name
# }
# proc display_proj {} {
# global VIVADO_TOOL_VERSION
# global CL
# global SHELL_MODE
# global BUILD_FLOW
# global PLACE_DIRECT
# global PHY_OPT_DIRECT
# global ROUTE_DIRECT
# global TAG
# global clock_recipe_a
# global clock_recipe_b
# global clock_recipe_c
# global clock_recipe_hbm
#
#
# set rpt "
# ==================================================
# Running CL builds w/ updated build tag
# ==================================================
# vivado_tool : $VIVADO_TOOL_VERSION
# cl : $CL
# mode : $SHELL_MODE
# clock_recipe_a : $clock_recipe_a
# clock_recipe_b : $clock_recipe_b
# clock_recipe_c : $clock_recipe_c
# clock_recipe_hbm : $clock_recipe_hbm
# flow : $BUILD_FLOW
# place_direct : $PLACE_DIRECT
# phy_opt_direct : $PHY_OPT_DIRECT
# route_direct : $ROUTE_DIRECT
# build_tag : $TAG
# ==================================================
# "
# puts "$rpt"
# }
# set PLACE_DIRECT [lindex $argv 0]
# set PHY_OPT_DIRECT [lindex $argv 1]
# set ROUTE_DIRECT [lindex $argv 2]
# set clock_recipe_a [lindex $argv 3]
# set clock_recipe_b [lindex $argv 4]
# set clock_recipe_c [lindex $argv 5]
# set clock_recipe_hbm [lindex $argv 6]
# set DEVICE_TYPE "xcvu47p-fsvh2892-2-e"
# if { [info exists ::env(BUILD_FLOW)] } {
# set BUILD_FLOW $::env(BUILD_FLOW)
# } else {
# set BUILD_FLOW "BuildAll"
# }
# if { [info exists ::env(CL)] } {
# set CL $::env(CL)
# } else {
# set CL "cl_dram_hbm_dma"
# }
# if { [info exists ::env(SHELL_MODE)] } {
# set SHELL_MODE $::env(SHELL_MODE)
# } else {
# set SHELL_MODE "xdma_shell"
# }
# if { [info exists ::env(BUILD_TAG)] } {
# set TAG $::env(BUILD_TAG)
# } else {
# set TAG "00_00_0000-999999"
# }
# if { [info exists ::env(HDK_SHELL_DIR)] } {
# set HDK_SHELL_DIR $::env(HDK_SHELL_DIR)
# } else {
# print "ERROR: HDK_SHELL_DIR not set. Please run hdk_setup.sh to set required env variables."
# exit
# }
# if { [info exists ::env(HDK_SHELL_DESIGN_DIR)] } {
# set HDK_SHELL_DESIGN_DIR $::env(HDK_SHELL_DESIGN_DIR)
# } else {
# print "ERROR: HDK_SHELL_DESIGN_DIR not set. Please run hdk_setup.sh to set required env variables."
# exit
# }
# if { [info exists ::env(HDK_COMMON_DIR)] } {
# set HDK_COMMON_DIR $::env(HDK_COMMON_DIR)
# } else {
# print "ERROR: HDK_COMMON_DIR not set. Please run hdk_setup.sh to set required env variables."
# exit
# }
# if { [info exists ::env(HDK_IP_SRC_DIR)] } {
# set HDK_IP_SRC_DIR $::env(HDK_IP_SRC_DIR)
# } else {
# print "ERROR: HDK_IP_SRC_DIR not set. Please run hdk_setup.sh to set required env variables."
# exit
# }
# if { [info exists ::env(HDK_BD_SRC_DIR)] } {
# set HDK_BD_SRC_DIR $::env(HDK_BD_SRC_DIR)
# } else {
# print "ERROR: HDK_BD_SRC_DIR not set. Please run hdk_setup.sh to set required env variables."
# exit
# }
# if { [info exists ::env(HDK_BD_GEN_DIR)] } {
# set HDK_BD_GEN_DIR $::env(HDK_BD_GEN_DIR)
# } else {
# print "ERROR: HDK_BD_GEN_DIR not set. Please run hdk_setup.sh to set required env variables."
# exit
# }
# if { [info exists ::env(CL_DIR)] } {
# set CL_DIR $::env(CL_DIR)
# } else {
# print "ERROR: CL_DIR not set. Please run hdk_setup.sh to set required env variables."
# exit
# }
# if { [info exists ::env(VIVADO_TOOL_VERSION)] } {
# set VIVADO_TOOL_VERSION $::env(VIVADO_TOOL_VERSION)
# } else {
# print "ERROR: VIVADO_TOOL_VERSION not set. Please run hdk_setup.sh to set required env variables."
# exit
# }
# display_proj

==================================================
Running CL builds w/ updated build tag
==================================================
vivado_tool : 2024.1
cl : top
mode : small_shell
clock_recipe_a : A1
clock_recipe_b : B2
clock_recipe_c : C0
clock_recipe_hbm : H2
flow : BuildAll
place_direct : SSI_SpreadLogic_high
phy_opt_direct : AggressiveExplore
route_direct : AggressiveExplore
build_tag : 2026_10_10-121021
==================================================

# set scripts_dir [pwd]
# set build_dir [file dirname $scripts_dir]
# create_dir "reports" $build_dir
# create_dir "checkpoints" $build_dir
# create_dir "src_post_encryption" $build_dir
# set design_dir "${CL_DIR}/design"
# set constraints_dir "${build_dir}/constraints"
# set reports_dir "${build_dir}/reports"
# set checkpoints_dir "${build_dir}/checkpoints"
# set reports_dir "${build_dir}/reports"
# set src_post_enc_dir "${build_dir}/src_post_encryption"
# cd $scripts_dir
# print "Generating clock contraints for CL source clocks"

AWS FPGA: (12:12:37): Generating clock contraints for CL source clocks

# source $HDK_SHELL_DIR/build/scripts/aws_gen_clk_constraints.tcl
## switch $clock_recipe_a {
## "A0" {
## #NOT SUPPORTED# set clk_main_a0_period 8
## #NOT SUPPORTED# set clk_main_a0_half_period 4
## set clk_main_a0_period 4
## set clk_main_a0_half_period 2
## set clk_extra_a1_period 16
## set clk_extra_a1_half_period 8
## set clk_extra_a2_period 5.333
## set clk_extra_a2_half_period 2.667
## set clk_extra_a3_period 4
## set clk_extra_a3_half_period 2
## }
## "A1" {
## set clk_main_a0_period 4
## set clk_main_a0_half_period 2
## set clk_extra_a1_period 8
## set clk_extra_a1_half_period 4
## set clk_extra_a2_period 2.667
## set clk_extra_a2_half_period 1.333
## set clk_extra_a3_period 2
## set clk_extra_a3_half_period 1
## }
## "A2" {
## #NOT SUPPORTED# set clk_main_a0_period 64
## #NOT SUPPORTED# set clk_main_a0_half_period 32
## set clk_main_a0_period 4
## set clk_main_a0_half_period 2
## set clk_extra_a1_period 128
## set clk_extra_a1_half_period 64
## set clk_extra_a2_period 8
## set clk_extra_a2_half_period 4
## set clk_extra_a3_period 16
## set clk_extra_a3_half_period 8
## }
## default {
## puts "$clock_recipe_a is NOT a valid clock_recipe_a."
## }
## }
## switch $clock_recipe_b {
## "B0" {
## set clk_extra_b0_period 4
## set clk_extra_b0_half_period 2
## set clk_extra_b1_period 8
## set clk_extra_b1_half_period 4
## }
## "B1" {
## set clk_extra_b0_period 8
## set clk_extra_b0_half_period 4
## set clk_extra_b1_period 16
## set clk_extra_b1_half_period 8
## }
## "B2" {
## set clk_extra_b0_period 2.222
## set clk_extra_b0_half_period 1.111
## set clk_extra_b1_period 4.444
## set clk_extra_b1_half_period 2.222
## }
## "B3" {
## set clk_extra_b0_period 4
## set clk_extra_b0_half_period 2
## set clk_extra_b1_period 16
## set clk_extra_b1_half_period 8
## }
## "B4" {
## set clk_extra_b0_period 3.333
## set clk_extra_b0_half_period 1.667
## set clk_extra_b1_period 13.333
## set clk_extra_b1_half_period 6.667
## }
## "B5" {
## set clk_extra_b0_period 2.5
## set clk_extra_b0_half_period 1.25
## set clk_extra_b1_period 10
## set clk_extra_b1_half_period 5
## }
## default {
## puts "$clock_recipe_b is NOT a valid clock_recipe_b."
## }
## }
## switch $clock_recipe_c {
## "C0" {
## set clk_extra_c0_period 3.333
## set clk_extra_c0_half_period 1.667
## set clk_extra_c1_period 2.5
## set clk_extra_c1_half_period 1.25
## }
## "C1" {
## set clk_extra_c0_period 6.667
## set clk_extra_c0_half_period 3.333
## set clk_extra_c1_period 5
## set clk_extra_c1_half_period 2.5
## }
## "C2" {
## set clk_extra_c0_period 13.333
## set clk_extra_c0_half_period 6.667
## set clk_extra_c1_period 10
## set clk_extra_c1_half_period 5
## }
## "C3" {
## set clk_extra_c0_period 5
## set clk_extra_c0_half_period 2.5
## set clk_extra_c1_period 3.75
## set clk_extra_c1_half_period 1.875
## }
## default {
## puts "$clock_recipe_c is NOT a valid clock_recipe_c."
## }
## }
## switch $clock_recipe_hbm {
## "H0" {
## set clk_hbm_axi_period 4
## set clk_hbm_axi_half_period 2
## }
## "H1" {
## set clk_hbm_axi_period 8
## set clk_hbm_axi_half_period 4
## }
## "H2" {
## set clk_hbm_axi_period 2.222
## set clk_hbm_axi_half_period 1.111
## }
## "H3" {
## set clk_hbm_axi_period 3.333
## set clk_hbm_axi_half_period 1.667
## }
## "H4" {
## set clk_hbm_axi_period 2.5
## set clk_hbm_axi_half_period 1.25
## }
## default {
## puts "$clock_recipe_hbm is NOT a valid clock_recipe_hbm."
## }
## }
## set pin_clk_extra_a1 "\[get_pins -of_objects \[get_cells -hierarchical -regexp .*AWS_CLK_GEN/CLK_GRP_A_EN_I.CLK_MMCM_A_I/inst/CLK_CORE_DRP_I/clk_inst/mmcme4_adv_inst\] -filter {NAME=~*CLKOUT0}\]"
## set pin_clk_extra_a2 "\[get_pins -of_objects \[get_cells -hierarchical -regexp .*AWS_CLK_GEN/CLK_GRP_A_EN_I.CLK_MMCM_A_I/inst/CLK_CORE_DRP_I/clk_inst/mmcme4_adv_inst\] -filter {NAME=~*CLKOUT1}\]"
## set pin_clk_extra_a3 "\[get_pins -of_objects \[get_cells -hierarchical -regexp .*AWS_CLK_GEN/CLK_GRP_A_EN_I.CLK_MMCM_A_I/inst/CLK_CORE_DRP_I/clk_inst/mmcme4_adv_inst\] -filter {NAME=~*CLKOUT2}\]"
## set pin_clk_extra_b0 "\[get_pins -of_objects \[get_cells -hierarchical -regexp .*AWS_CLK_GEN/CLK_GRP_B_EN_I.CLK_MMCM_B_I/inst/CLK_CORE_DRP_I/clk_inst/mmcme4_adv_inst\] -filter {NAME=~*CLKOUT0}\]"
## set pin_clk_extra_b1 "\[get_pins -of_objects \[get_cells -hierarchical -regexp .*AWS_CLK_GEN/CLK_GRP_B_EN_I.CLK_MMCM_B_I/inst/CLK_CORE_DRP_I/clk_inst/mmcme4_adv_inst\] -filter {NAME=~*CLKOUT1}\]"
## set pin_clk_extra_c0 "\[get_pins -of_objects \[get_cells -hierarchical -regexp .*AWS_CLK_GEN/CLK_GRP_C_EN_I.CLK_MMCM_C_I/inst/CLK_CORE_DRP_I/clk_inst/mmcme4_adv_inst\] -filter {NAME=~*CLKOUT0}\]"
## set pin_clk_extra_c1 "\[get_pins -of_objects \[get_cells -hierarchical -regexp .*AWS_CLK_GEN/CLK_GRP_C_EN_I.CLK_MMCM_C_I/inst/CLK_CORE_DRP_I/clk_inst/mmcme4_adv_inst\] -filter {NAME=~*CLKOUT1}\]"
## set pin_clk_hbm_axi "\[get_pins -of_objects \[get_cells -hierarchical -regexp .*AWS_CLK_GEN/CLK_HBM_EN_I.CLK_MMCM_HBM_I/inst/CLK_CORE_DRP_I/clk_inst/mmcme4_adv_inst\] -filter {NAME=~*CLKOUT0}\]"
## if { [file exists $CL_DIR/build/constraints/generated_cl_clocks_aws.xdc] } {
## puts "Deleting old CL clocks constraints file since it will be replaced.";
## file delete -force $CL_DIR/build/constraints/generated_cl_clocks_aws.xdc
## }
## set clocks_file [open "$CL_DIR/build/constraints/generated_cl_clocks_aws.xdc" w]
## puts $clocks_file "#-------------------------------------------------------------------------"
## puts $clocks_file "# Do not edit this file! It is auto-generated from $argv0."
## puts $clocks_file "#-------------------------------------------------------------------------"
## puts $clocks_file "############################################################################### "
## puts $clocks_file "# OOC Source Clocks "
## puts $clocks_file "############################################################################### "
## puts $clocks_file "#CL HBM reference clock @100MHz "
## puts $clocks_file "create_clock -period 10.000 -name clk_hbm_ref -waveform {0.000 5.000} \[get_ports clk_hbm_ref\] \n"
## puts $clocks_file "# Group A Clocks"
## puts $clocks_file "create_clock -period $clk_main_a0_period -name clk_main_a0 -waveform {0.000 $clk_main_a0_half_period} \[get_ports clk_main_a0\]"
## close $clocks_file
# print "Encrypting CL source code"

AWS FPGA: (12:12:37): Encrypting CL source code

# source encrypt.tcl
## if {[llength [glob -nocomplain -dir ${src_post_enc_dir} *]] != 0} {
## eval file delete -force [glob ${src_post_enc_dir}/*]
## }
## foreach f [glob -directory ${HDK_SHELL_DESIGN_DIR}/interfaces *.inc] {
## file copy -force $f ${src_post_enc_dir}/
## }
## foreach f [glob -directory ${design_dir} *.{v,sv,vh,svh,inc}] {
## file copy -force $f ${src_post_enc_dir}/
## }
## exec chmod +w {*}[glob ${src_post_enc_dir}/*]
## encrypt -k ${HDK_SHELL_DIR}/build/scripts/vivado_keyfile.txt -lang verilog [glob -nocomplain -- ${src_post_enc_dir}/*.{v,sv,vh,inc}]
## encrypt -k ${HDK_SHELL_DIR}/build/scripts/vivado_vhdl_keyfile.txt -lang vhdl -quiet [ glob -nocomplain -- ${src_post_enc_dir}/*.vhd? ]
# switch $BUILD_FLOW {
# "SynthCL" {
# source ${scripts_dir}/synth_${CL}.tcl
# }
#
# "ImplCL" {
# source ${scripts_dir}/build_level_1_cl.tcl
# }
#
# default {
# source ${scripts_dir}/synth_${CL}.tcl
# source ${scripts_dir}/build_level_1_cl.tcl
# }
# }
## source ${HDK_SHELL_DIR}/build/scripts/synth_cl_header.tcl
### print "Creating in-memory synthesis project"

AWS FPGA: (12:12:38): Creating in-memory synthesis project

### set_param sta.enableAutoGenClkNamePersistence 0
### create_project -in_memory -part $DEVICE_TYPE -force
create_project: Time (s): cpu = 00:00:05 ; elapsed = 00:00:18 . Memory (MB): peak = 1417.680 ; gain = 101.836 ; free physical = 124035 ; free virtual = 136114
### set_property XPM_LIBRARIES {XPM_CDC XPM_MEMORY XPM_FIFO} [current_project]
### print "Reading common AWS components"

AWS FPGA: (12:12:56): Reading common AWS components

### read_verilog -sv [ list \
### ${HDK_SHELL_DESIGN_DIR}/../../lib/interfaces.sv \
### ${HDK_SHELL_DESIGN_DIR}/../../lib/aws_clk_gen.sv \
### ${HDK_SHELL_DESIGN_DIR}/../../lib/aws_clk_regs.sv \
### ${HDK_SHELL_DESIGN_DIR}/../../lib/axil_to_cfg_cnv.sv \
### ${HDK_SHELL_DESIGN_DIR}/../../lib/axis_flop_fifo.sv \
### ${HDK_SHELL_DESIGN_DIR}/../../lib/lib_pipe.sv \
### ${HDK_SHELL_DESIGN_DIR}/../../lib/bram_1w1r.sv \
### ${HDK_SHELL_DESIGN_DIR}/../../lib/bram_2rw.sv \
### ${HDK_SHELL_DESIGN_DIR}/../../lib/xpm_fifo.sv \
### ${HDK_SHELL_DESIGN_DIR}/../../lib/flop_fifo.sv \
### ${HDK_SHELL_DESIGN_DIR}/../../lib/flop_fifo_in.sv \
### ${HDK_SHELL_DESIGN_DIR}/../../lib/cdc_async_fifo.sv \
### ${HDK_SHELL_DESIGN_DIR}/../../lib/cdc_sync.sv \
### ${HDK_SHELL_DESIGN_DIR}/../../lib/ft_fifo_p.v \
### ${HDK_SHELL_DESIGN_DIR}/../../lib/ft_fifo.v \
### ${HDK_SHELL_DESIGN_DIR}/../../lib/ram_fifo_ft.sv \
### ${HDK_SHELL_DESIGN_DIR}/../../lib/rr_arb.sv \
### ${HDK_SHELL_DESIGN_DIR}/sh_ddr/synth/sync.v \
### ${HDK_SHELL_DESIGN_DIR}/sh_ddr/synth/flop_ccf.sv \
### ${HDK_SHELL_DESIGN_DIR}/sh_ddr/synth/ccf_ctl.v \
### ${HDK_SHELL_DESIGN_DIR}/sh_ddr/synth/mgt_acc_axl.sv \
### ${HDK_SHELL_DESIGN_DIR}/sh_ddr/synth/mgt_gen_axl.sv \
### ${HDK_SHELL_DESIGN_DIR}/sh_ddr/synth/sh_ddr.sv \
### ${HDK_SHELL_DESIGN_DIR}/interfaces/cl_ports.vh
### ]
### print "Reading AWS Constraints"

AWS FPGA: (12:12:56): Reading AWS Constraints

### read_xdc ${HDK_SHELL_DIR}/build/constraints/cl_pins.xdc
### read_xdc ${CL_DIR}/build/constraints/generated_cl_clocks_aws.xdc
### read_xdc -ref ${CL} ${HDK_SHELL_DIR}/build/constraints/cl_ddr_timing_aws.xdc
### set_property USED_IN {synthesis implementation OUT_OF_CONTEXT} [get_files generated_cl_clocks_aws.xdc]
### set_property PROCESSING_ORDER EARLY [get_files generated_cl_clocks_aws.xdc]
### set_property USED_IN {synthesis implementation} [get_files cl_ddr_timing_aws.xdc]
### set_property PROCESSING_ORDER LATE [get_files cl_ddr_timing_aws.xdc]
## print "Reading encrypted user source codes"

AWS FPGA: (12:12:56): Reading encrypted user source codes

## read_verilog -sv [glob ${src_post_enc_dir}/*.?v]
## print "Reading CL IP blocks"

AWS FPGA: (12:12:56): Reading CL IP blocks

## print "Reading user constraints"

AWS FPGA: (12:12:56): Reading user constraints

## read_xdc [ list \
## ${constraints_dir}/cl_synth_user.xdc \
## ${constraints_dir}/cl_timing_user.xdc
## ]
## set_property PROCESSING_ORDER LATE [get_files cl_synth_user.xdc]
## set_property PROCESSING_ORDER LATE [get_files cl_timing_user.xdc]
## print "Starting synthesizing customer design ${CL}"

AWS FPGA: (12:12:56): Starting synthesizing customer design top

## update_compile_order -fileset sources_1
## synth_design -mode out_of_context \
## -top ${CL} \
## -verilog_define XSDB_SLV_DIS \
## -part ${DEVICE_TYPE} \
## -keep_equivalent_registers
Command: synth_design -mode out_of_context -top top -verilog_define XSDB_SLV_DIS -part xcvu47p-fsvh2892-2-e -keep_equivalent_registers
Starting synth_design
Attempting to get a license for feature 'Synthesis' and/or device 'xcvu47p'
INFO: [Common 17-349] Got license for feature 'Synthesis' and/or device 'xcvu47p'
INFO: [Device 21-403] Loading part xcvu47p-fsvh2892-2-e
INFO: [Synth 8-7079] Multithreading enabled for synth_design using a maximum of 4 processes.
INFO: [Synth 8-7078] Launching helper process for spawning children vivado processes
INFO: [Synth 8-7075] Helper process launched with PID 4017
---------------------------------------------------------------------------------
Starting RTL Elaboration : Time (s): cpu = 00:00:04 ; elapsed = 00:00:09 . Memory (MB): peak = 3189.988 ; gain = 405.715 ; free physical = 121870 ; free virtual = 134059
---------------------------------------------------------------------------------
WARNING: [Synth 8-11065] parameter 'NUM_LOC' becomes localparam in 'ram_fifo_ft' with formal parameter declaration list [/home/ubuntu/src/aws-fpga/hdk/common/lib/ram_fifo_ft.sv:43]
INFO: [Synth 8-6157] synthesizing module 'MMCME4_BASE' [/opt/Xilinx/Vivado/2024.1/scripts/rt/data/unisim_comp.v:82908]
INFO: [Synth 8-6155] done synthesizing module 'MMCME4_BASE' (0#1) [/opt/Xilinx/Vivado/2024.1/scripts/rt/data/unisim_comp.v:82908]
INFO: [Synth 8-6157] synthesizing module 'BUFG' [/opt/Xilinx/Vivado/2024.1/scripts/rt/data/unisim_comp.v:1951]
INFO: [Synth 8-6155] done synthesizing module 'BUFG' (0#1) [/opt/Xilinx/Vivado/2024.1/scripts/rt/data/unisim_comp.v:1951]
INFO: [Synth 8-6157] synthesizing module 'OBUF' [/opt/Xilinx/Vivado/2024.1/scripts/rt/data/unisim_comp.v:96458]
INFO: [Synth 8-6155] done synthesizing module 'OBUF' (0#1) [/opt/Xilinx/Vivado/2024.1/scripts/rt/data/unisim_comp.v:96458]
INFO: [Synth 8-6157] synthesizing module 'IOBUFE3' [/opt/Xilinx/Vivado/2024.1/scripts/rt/data/unisim_comp.v:78605]
INFO: [Synth 8-6155] done synthesizing module 'IOBUFE3' (0#1) [/opt/Xilinx/Vivado/2024.1/scripts/rt/data/unisim_comp.v:78605]
INFO: [Synth 8-6157] synthesizing module 'IOBUFDS' [/opt/Xilinx/Vivado/2024.1/scripts/rt/data/unisim_comp.v:78226]
INFO: [Synth 8-6155] done synthesizing module 'IOBUFDS' (0#1) [/opt/Xilinx/Vivado/2024.1/scripts/rt/data/unisim_comp.v:78226]
INFO: [Synth 8-6157] synthesizing module 'IBUFDS' [/opt/Xilinx/Vivado/2024.1/scripts/rt/data/unisim_comp.v:73658]
INFO: [Synth 8-6155] done synthesizing module 'IBUFDS' (0#1) [/opt/Xilinx/Vivado/2024.1/scripts/rt/data/unisim_comp.v:73658]
INFO: [Synth 8-6157] synthesizing module 'lib_pipe' [/home/ubuntu/src/aws-fpga/hdk/common/lib/lib_pipe.sv:23]
INFO: [Synth 8-6155] done synthesizing module 'lib_pipe' (0#1) [/home/ubuntu/src/aws-fpga/hdk/common/lib/lib_pipe.sv:23]
WARNING: [Synth 8-3848] Net cl_sh_pcim_awid in module/entity top does not have driver. [/home/ubuntu/src/aws-fpga/hdk/common/shell_stable/design/interfaces/cl_ports.vh:62]
WARNING: [Synth 8-3848] Net cl_sh_pcim_awaddr in module/entity top does not have driver. [/home/ubuntu/src/aws-fpga/hdk/common/shell_stable/design/interfaces/cl_ports.vh:63]
WARNING: [Synth 8-3848] Net cl_sh_pcim_awlen in module/entity top does not have driver. [/home/ubuntu/src/aws-fpga/hdk/common/shell_stable/design/interfaces/cl_ports.vh:64]
WARNING: [Synth 8-3848] Net cl_sh_pcim_awsize in module/entity top does not have driver. [/home/ubuntu/src/aws-fpga/hdk/common/shell_stable/design/interfaces/cl_ports.vh:65]
WARNING: [Synth 8-3848] Net cl_sh_pcim_awburst in module/entity top does not have driver. [/home/ubuntu/src/aws-fpga/hdk/common/shell_stable/design/interfaces/cl_ports.vh:66]
WARNING: [Synth 8-3848] Net cl_sh_pcim_awcache in module/entity top does not have driver. [/home/ubuntu/src/aws-fpga/hdk/common/shell_stable/design/interfaces/cl_ports.vh:67]
WARNING: [Synth 8-3848] Net cl_sh_pcim_awlock in module/entity top does not have driver. [/home/ubuntu/src/aws-fpga/hdk/common/shell_stable/design/interfaces/cl_ports.vh:68]
WARNING: [Synth 8-3848] Net cl_sh_pcim_awprot in module/entity top does not have driver. [/home/ubuntu/src/aws-fpga/hdk/common/shell_stable/design/interfaces/cl_ports.vh:69]
WARNING: [Synth 8-3848] Net cl_sh_pcim_awqos in module/entity top does not have driver. [/home/ubuntu/src/aws-fpga/hdk/common/shell_stable/design/interfaces/cl_ports.vh:70]
WARNING: [Synth 8-3848] Net cl_sh_pcim_awuser in module/entity top does not have driver. [/home/ubuntu/src/aws-fpga/hdk/common/shell_stable/design/interfaces/cl_ports.vh:71]
WARNING: [Synth 8-3848] Net cl_sh_pcim_awvalid in module/entity top does not have driver. [/home/ubuntu/src/aws-fpga/hdk/common/shell_stable/design/interfaces/cl_ports.vh:72]
WARNING: [Synth 8-3848] Net cl_sh_pcim_wid in module/entity top does not have driver. [/home/ubuntu/src/aws-fpga/hdk/common/shell_stable/design/interfaces/cl_ports.vh:75]
WARNING: [Synth 8-3848] Net cl_sh_pcim_wdata in module/entity top does not have driver. [/home/ubuntu/src/aws-fpga/hdk/common/shell_stable/design/interfaces/cl_ports.vh:76]
WARNING: [Synth 8-3848] Net cl_sh_pcim_wstrb in module/entity top does not have driver. [/home/ubuntu/src/aws-fpga/hdk/common/shell_stable/design/interfaces/cl_ports.vh:77]
WARNING: [Synth 8-3848] Net cl_sh_pcim_wlast in module/entity top does not have driver. [/home/ubuntu/src/aws-fpga/hdk/common/shell_stable/design/interfaces/cl_ports.vh:78]
WARNING: [Synth 8-3848] Net cl_sh_pcim_wuser in module/entity top does not have driver. [/home/ubuntu/src/aws-fpga/hdk/common/shell_stable/design/interfaces/cl_ports.vh:79]
WARNING: [Synth 8-3848] Net cl_sh_pcim_wvalid in module/entity top does not have driver. [/home/ubuntu/src/aws-fpga/hdk/common/shell_stable/design/interfaces/cl_ports.vh:80]
WARNING: [Synth 8-3848] Net cl_sh_pcim_bready in module/entity top does not have driver. [/home/ubuntu/src/aws-fpga/hdk/common/shell_stable/design/interfaces/cl_ports.vh:86]
WARNING: [Synth 8-3848] Net cl_sh_pcim_arid in module/entity top does not have driver. [/home/ubuntu/src/aws-fpga/hdk/common/shell_stable/design/interfaces/cl_ports.vh:88]
WARNING: [Synth 8-3848] Net cl_sh_pcim_araddr in module/entity top does not have driver. [/home/ubuntu/src/aws-fpga/hdk/common/shell_stable/design/interfaces/cl_ports.vh:89]
WARNING: [Synth 8-3848] Net cl_sh_pcim_arlen in module/entity top does not have driver. [/home/ubuntu/src/aws-fpga/hdk/common/shell_stable/design/interfaces/cl_ports.vh:90]
WARNING: [Synth 8-3848] Net cl_sh_pcim_arsize in module/entity top does not have driver. [/home/ubuntu/src/aws-fpga/hdk/common/shell_stable/design/interfaces/cl_ports.vh:91]
WARNING: [Synth 8-3848] Net cl_sh_pcim_arburst in module/entity top does not have driver. [/home/ubuntu/src/aws-fpga/hdk/common/shell_stable/design/interfaces/cl_ports.vh:92]
WARNING: [Synth 8-3848] Net cl_sh_pcim_arcache in module/entity top does not have driver. [/home/ubuntu/src/aws-fpga/hdk/common/shell_stable/design/interfaces/cl_ports.vh:93]
WARNING: [Synth 8-3848] Net cl_sh_pcim_arlock in module/entity top does not have driver. [/home/ubuntu/src/aws-fpga/hdk/common/shell_stable/design/interfaces/cl_ports.vh:94]
WARNING: [Synth 8-3848] Net cl_sh_pcim_arprot in module/entity top does not have driver. [/home/ubuntu/src/aws-fpga/hdk/common/shell_stable/design/interfaces/cl_ports.vh:95]
WARNING: [Synth 8-3848] Net cl_sh_pcim_arqos in module/entity top does not have driver. [/home/ubuntu/src/aws-fpga/hdk/common/shell_stable/design/interfaces/cl_ports.vh:96]
WARNING: [Synth 8-3848] Net cl_sh_pcim_aruser in module/entity top does not have driver. [/home/ubuntu/src/aws-fpga/hdk/common/shell_stable/design/interfaces/cl_ports.vh:97]
WARNING: [Synth 8-3848] Net cl_sh_pcim_arvalid in module/entity top does not have driver. [/home/ubuntu/src/aws-fpga/hdk/common/shell_stable/design/interfaces/cl_ports.vh:98]
WARNING: [Synth 8-3848] Net cl_sh_pcim_rready in module/entity top does not have driver. [/home/ubuntu/src/aws-fpga/hdk/common/shell_stable/design/interfaces/cl_ports.vh:107]
WARNING: [Synth 8-3917] design top has port cl_sh_flr_done driven by constant 1
WARNING: [Synth 8-3917] design top has port cl_sh_status0[31] driven by constant 0
WARNING: [Synth 8-3917] design top has port cl_sh_status0[30] driven by constant 0
WARNING: [Synth 8-3917] design top has port cl_sh_status0[29] driven by constant 0
WARNING: [Synth 8-3917] design top has port cl_sh_status0[28] driven by constant 0
WARNING: [Synth 8-3917] design top has port cl_sh_status0[27] driven by constant 0
WARNING: [Synth 8-3917] design top has port cl_sh_status0[26] driven by constant 0
WARNING: [Synth 8-3917] design top has port cl_sh_status0[25] driven by constant 0
WARNING: [Synth 8-3917] design top has port cl_sh_status0[24] driven by constant 0
WARNING: [Synth 8-3917] design top has port cl_sh_status0[23] driven by constant 0
WARNING: [Synth 8-3917] design top has port cl_sh_status0[22] driven by constant 0
WARNING: [Synth 8-3917] design top has port cl_sh_status0[21] driven by constant 0
WARNING: [Synth 8-3917] design top has port cl_sh_status0[20] driven by constant 0
WARNING: [Synth 8-3917] design top has port cl_sh_status0[19] driven by constant 0
WARNING: [Synth 8-3917] design top has port cl_sh_status0[18] driven by constant 0
WARNING: [Synth 8-3917] design top has port cl_sh_status0[17] driven by constant 0
WARNING: [Synth 8-3917] design top has port cl_sh_status0[16] driven by constant 0
WARNING: [Synth 8-3917] design top has port cl_sh_status0[15] driven by constant 0
WARNING: [Synth 8-3917] design top has port cl_sh_status0[14] driven by constant 0
WARNING: [Synth 8-3917] design top has port cl_sh_status0[13] driven by constant 0
WARNING: [Synth 8-3917] design top has port cl_sh_status0[12] driven by constant 0
WARNING: [Synth 8-3917] design top has port cl_sh_status0[11] driven by constant 0
WARNING: [Synth 8-3917] design top has port cl_sh_status0[10] driven by constant 0
WARNING: [Synth 8-3917] design top has port cl_sh_status0[9] driven by constant 0
WARNING: [Synth 8-3917] design top has port cl_sh_status0[8] driven by constant 0
WARNING: [Synth 8-3917] design top has port cl_sh_status0[7] driven by constant 0
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
WARNING: [Synth 8-7129] Port cl_sh_ddr_axi_rdata[458] in module sh_ddr is either unconnected or has no load
WARNING: [Synth 8-7129] Port cl_sh_ddr_axi_rdata[457] in module sh_ddr is either unconnected or has no load
WARNING: [Synth 8-7129] Port cl_sh_ddr_axi_rdata[456] in module sh_ddr is either unconnected or has no load
WARNING: [Synth 8-7129] Port cl_sh_ddr_axi_rdata[455] in module sh_ddr is either unconnected or has no load
WARNING: [Synth 8-7129] Port cl_sh_ddr_axi_rdata[454] in module sh_ddr is either unconnected or has no load
WARNING: [Synth 8-7129] Port cl_sh_ddr_axi_rdata[453] in module sh_ddr is either unconnected or has no load
WARNING: [Synth 8-7129] Port cl_sh_ddr_axi_rdata[452] in module sh_ddr is either unconnected or has no load
WARNING: [Synth 8-7129] Port cl_sh_ddr_axi_rdata[451] in module sh_ddr is either unconnected or has no load
WARNING: [Synth 8-7129] Port cl_sh_ddr_axi_rdata[450] in module sh_ddr is either unconnected or has no load
INFO: [Common 17-14] Message 'Synth 8-7129' appears 100 times and further instances of the messages will be disabled. Use the Tcl command set_msg_config to change the current settings.
---------------------------------------------------------------------------------
Finished RTL Elaboration : Time (s): cpu = 00:00:05 ; elapsed = 00:00:11 . Memory (MB): peak = 3300.926 ; gain = 516.652 ; free physical = 121720 ; free virtual = 133914
---------------------------------------------------------------------------------
---------------------------------------------------------------------------------
Start Handling Custom Attributes
---------------------------------------------------------------------------------
---------------------------------------------------------------------------------
Finished Handling Custom Attributes : Time (s): cpu = 00:00:05 ; elapsed = 00:00:11 . Memory (MB): peak = 3318.738 ; gain = 534.465 ; free physical = 121720 ; free virtual = 133914
---------------------------------------------------------------------------------
---------------------------------------------------------------------------------
Finished RTL Optimization Phase 1 : Time (s): cpu = 00:00:05 ; elapsed = 00:00:11 . Memory (MB): peak = 3318.738 ; gain = 534.465 ; free physical = 121720 ; free virtual = 133914
---------------------------------------------------------------------------------
Netlist sorting complete. Time (s): cpu = 00:00:00.04 ; elapsed = 00:00:00.04 . Memory (MB): peak = 3324.676 ; gain = 0.000 ; free physical = 121712 ; free virtual = 133905
INFO: [Netlist 29-17] Analyzing 93 Unisim elements for replacement
INFO: [Netlist 29-28] Unisim Transformation completed in 0 CPU seconds
INFO: [Project 1-570] Preparing netlist for logic optimization

Processing XDC Constraints
Initializing timing engine
Parsing XDC File [/home/ubuntu/src/aws-fpga/hdk/cl/examples/top/build/constraints/generated_cl_clocks_aws.xdc]
Finished Parsing XDC File [/home/ubuntu/src/aws-fpga/hdk/cl/examples/top/build/constraints/generated_cl_clocks_aws.xdc]
Parsing XDC File [/home/ubuntu/src/aws-fpga/hdk/common/shell_stable/build/constraints/cl_pins.xdc]
Finished Parsing XDC File [/home/ubuntu/src/aws-fpga/hdk/common/shell_stable/build/constraints/cl_pins.xdc]
INFO: [Project 1-236] Implementation specific constraints were found while reading constraint file [/home/ubuntu/src/aws-fpga/hdk/common/shell_stable/build/constraints/cl_pins.xdc]. These constraints will be ignored for synthesis but will be used in implementation. Impacted constraints are listed in the file [.Xil/top_propImpl.xdc].
Resolution: To avoid this warning, move constraints listed in [.Xil/top_propImpl.xdc] to another XDC file and exclude this new file from synthesis with the used_in_synthesis property (File Properties dialog in GUI) and re-run elaboration/synthesis.
INFO: [Timing 38-2] Deriving generated clocks
Parsing XDC File [/home/ubuntu/src/aws-fpga/hdk/common/shell_stable/build/constraints/cl_ddr_timing_aws.xdc]
WARNING: [Vivado 12-508] No pins matched 'get_pins -of_objects [get_cells -hierarchical -filter { NAME =~ *ram_reg*}] -filter {REF_PIN_NAME == CLK}'. [/home/ubuntu/src/aws-fpga/hdk/common/shell_stable/build/constraints/cl_ddr_timing_aws.xdc:26]
WARNING: [Vivado 12-508] No pins matched '*'. [/home/ubuntu/src/aws-fpga/hdk/common/shell_stable/build/constraints/cl_ddr_timing_aws.xdc:30]
Finished Parsing XDC File [/home/ubuntu/src/aws-fpga/hdk/common/shell_stable/build/constraints/cl_ddr_timing_aws.xdc]
WARNING: [Project 1-498] One or more constraints failed evaluation while reading constraint file [/home/ubuntu/src/aws-fpga/hdk/common/shell_stable/build/constraints/cl_ddr_timing_aws.xdc] and the design contains unresolved black boxes. These constraints will be read post-synthesis (as long as their source constraint file is marked as used_in_implementation) and should be applied correctly then. You should review the constraints listed in the file [.Xil/top_propImpl.xdc] and check the run log file to verify that these constraints were correctly applied.
Parsing XDC File [/home/ubuntu/src/aws-fpga/hdk/cl/examples/top/build/constraints/cl_synth_user.xdc]
Finished Parsing XDC File [/home/ubuntu/src/aws-fpga/hdk/cl/examples/top/build/constraints/cl_synth_user.xdc]
Parsing XDC File [/home/ubuntu/src/aws-fpga/hdk/cl/examples/top/build/constraints/cl_timing_user.xdc]
Finished Parsing XDC File [/home/ubuntu/src/aws-fpga/hdk/cl/examples/top/build/constraints/cl_timing_user.xdc]
Completed Processing XDC Constraints

Netlist sorting complete. Time (s): cpu = 00:00:00 ; elapsed = 00:00:00 . Memory (MB): peak = 3668.348 ; gain = 0.000 ; free physical = 121446 ; free virtual = 133698
INFO: [Project 1-111] Unisim Transformation Summary:
A total of 93 instances were transformed.
BUFG => BUFGCE: 1 instance
IBUFDS => IBUFDS (DIFFINBUF, IBUFCTRL): 1 instance
IOBUFDS => IOBUFDS (DIFFINBUF, IBUFCTRL, INV, OBUFT(x2)): 18 instances
IOBUFE3 => IOBUFE3 (IBUFCTRL, INBUF, OBUFT_DCIEN): 72 instances
MMCME4_BASE => MMCME4_ADV: 1 instance

Constraint Validation Runtime : Time (s): cpu = 00:00:00.01 ; elapsed = 00:00:00.02 . Memory (MB): peak = 3668.348 ; gain = 0.000 ; free physical = 121446 ; free virtual = 133698
---------------------------------------------------------------------------------
Finished Constraint Validation : Time (s): cpu = 00:00:21 ; elapsed = 00:00:40 . Memory (MB): peak = 3668.348 ; gain = 884.074 ; free physical = 121445 ; free virtual = 133697
---------------------------------------------------------------------------------
---------------------------------------------------------------------------------
Start Loading Part and Timing Information
---------------------------------------------------------------------------------
Loading part: xcvu47p-fsvh2892-2-e
INFO: [Synth 8-6742] Reading net delay rules and data
---------------------------------------------------------------------------------
Finished Loading Part and Timing Information : Time (s): cpu = 00:00:21 ; elapsed = 00:00:41 . Memory (MB): peak = 3676.352 ; gain = 892.078 ; free physical = 121445 ; free virtual = 133698
---------------------------------------------------------------------------------
---------------------------------------------------------------------------------
Start Applying 'set_property' XDC Constraints
---------------------------------------------------------------------------------
---------------------------------------------------------------------------------
Finished applying 'set_property' XDC Constraints : Time (s): cpu = 00:00:21 ; elapsed = 00:00:41 . Memory (MB): peak = 3676.352 ; gain = 892.078 ; free physical = 121445 ; free virtual = 133698
---------------------------------------------------------------------------------
INFO: [Synth 8-802] inferred FSM for state register 'state_reg' in module 'rvbl2_control_unit'
INFO: [Synth 8-802] inferred FSM for state register 'tx_state_reg' in module 'rvbl2_uart'
INFO: [Synth 8-802] inferred FSM for state register 'rx_state_reg' in module 'rvbl2_uart'
INFO: [Synth 8-802] inferred FSM for state register 'r_State_reg' in module 'Receiver'
INFO: [Synth 8-802] inferred FSM for state register 'state_write_reg' in module 'top'
INFO: [Synth 8-6159] Found Keep on FSM register 'next_state_reg' in module 'rvbl2_control_unit', re-encoding will not be performed
---------------------------------------------------------------------------------------------------
State | New Encoding | Previous Encoding
---------------------------------------------------------------------------------------------------
*
S_RESET | 000 | 000
S_FETCH | 001 | 001
S_DECODE | 010 | 010
S_EXECUTE | 011 | 011
S_MEMORY | 100 | 100
S_WRITEBACK | 101 | 101
---------------------------------------------------------------------------------------------------
INFO: [Synth 8-6159] Found Keep on FSM register 'state_reg' in module 'rvbl2_control_unit', re-encoding will not be performed
---------------------------------------------------------------------------------------------------
State | New Encoding | Previous Encoding
---------------------------------------------------------------------------------------------------
*
S_RESET | 000 | 000
S_FETCH | 001 | 001
S_DECODE | 010 | 010
S_EXECUTE | 011 | 011
S_MEMORY | 100 | 100
S_WRITEBACK | 101 | 101
---------------------------------------------------------------------------------------------------
---------------------------------------------------------------------------------------------------
State | New Encoding | Previous Encoding
---------------------------------------------------------------------------------------------------
RX_IDLE | 00 | 00
RX_START | 01 | 01
RX_DATA | 10 | 10
RX_STOP | 11 | 11
---------------------------------------------------------------------------------------------------
INFO: [Synth 8-3354] encoded FSM with state register 'rx_state_reg' using encoding 'sequential' in module 'rvbl2_uart'
---------------------------------------------------------------------------------------------------
State | New Encoding | Previous Encoding
---------------------------------------------------------------------------------------------------
TX_IDLE | 00 | 00
TX_START | 01 | 01
TX_DATA | 10 | 10
TX_STOP | 11 | 11
---------------------------------------------------------------------------------------------------
INFO: [Synth 8-3354] encoded FSM with state register 'tx_state_reg' using encoding 'sequential' in module 'rvbl2_uart'
---------------------------------------------------------------------------------------------------
State | New Encoding | Previous Encoding
---------------------------------------------------------------------------------------------------
S_IDLE | 00 | 00
S_START | 01 | 01
S_DATA | 10 | 10
iSTATE | 11 | 11
*
---------------------------------------------------------------------------------------------------
INFO: [Synth 8-3354] encoded FSM with state register 'r_State_reg' using encoding 'sequential' in module 'Receiver'
---------------------------------------------------------------------------------------------------
State | New Encoding | Previous Encoding
---------------------------------------------------------------------------------------------------
W_IDLE | 00 | 00
W_WAIT | 01 | 01
W_WRITE | 10 | 10
W_SEND_RESP | 11 | 11
---------------------------------------------------------------------------------------------------
INFO: [Synth 8-3354] encoded FSM with state register 'state_write_reg' using encoding 'sequential' in module 'top'
---------------------------------------------------------------------------------
Finished RTL Optimization Phase 2 : Time (s): cpu = 00:00:22 ; elapsed = 00:00:42 . Memory (MB): peak = 3676.352 ; gain = 892.078 ; free physical = 121444 ; free virtual = 133698
---------------------------------------------------------------------------------
---------------------------------------------------------------------------------
Start RTL Component Statistics
---------------------------------------------------------------------------------
Detailed RTL Component Info :
+---Adders :
4 Input 64 Bit Adders := 1
2 Input 32 Bit Adders := 2
3 Input 32 Bit Adders := 1
2 Input 12 Bit Adders := 2
2 Input 9 Bit Adders := 2
2 Input 6 Bit Adders := 1
2 Input 4 Bit Adders := 2
2 Input 3 Bit Adders := 3
2 Input 2 Bit Adders := 4
3 Input 2 Bit Adders := 2
3 Input 1 Bit Adders := 4
+---XORs :
2 Input 32 Bit XORs := 1
2 Input 16 Bit XORs := 56
2 Input 2 Bit XORs := 4
2 Input 1 Bit XORs := 60
+---Registers :
64 Bit Registers := 1
42 Bit Registers := 3
32 Bit Registers := 42
12 Bit Registers := 2
9 Bit Registers := 2
8 Bit Registers := 17
6 Bit Registers := 1
4 Bit Registers := 2
3 Bit Registers := 3
2 Bit Registers := 19
1 Bit Registers := 47
+---RAMs :
64K Bit (2048 X 32 bit) RAMs := 1
+---Muxes :
2 Input 64 Bit Muxes := 4
2 Input 42 Bit Muxes := 1
2 Input 32 Bit Muxes := 28
3 Input 32 Bit Muxes := 2
4 Input 32 Bit Muxes := 6
8 Input 32 Bit Muxes := 1
4 Input 16 Bit Muxes := 1
4 Input 12 Bit Muxes := 1
2 Input 9 Bit Muxes := 2
4 Input 9 Bit Muxes := 2
2 Input 8 Bit Muxes := 3
4 Input 8 Bit Muxes := 2
2 Input 6 Bit Muxes := 1
2 Input 4 Bit Muxes := 1
7 Input 3 Bit Muxes := 1
2 Input 3 Bit Muxes := 3
5 Input 3 Bit Muxes := 1
10 Input 3 Bit Muxes := 1
4 Input 3 Bit Muxes := 3
2 Input 2 Bit Muxes := 6
4 Input 2 Bit Muxes := 4
2 Input 1 Bit Muxes := 36
4 Input 1 Bit Muxes := 34
---------------------------------------------------------------------------------
Finished RTL Component Statistics
---------------------------------------------------------------------------------
---------------------------------------------------------------------------------
Start Part Resource Summary
---------------------------------------------------------------------------------
Part Resources:
DSPs: 9024 (col length:94)
BRAMs: 4032 (col length: RAMB18 288 RAMB36 144)
---------------------------------------------------------------------------------
Finished Part Resource Summary
---------------------------------------------------------------------------------
---------------------------------------------------------------------------------
Start Cross Boundary and Area Optimization
---------------------------------------------------------------------------------
WARNING: [Synth 8-7080] Parallel synthesis criteria is not met
DSP Report: Generating DSP product_full, operation Mode is: A*B.
DSP Report: operator product_full is absorbed into DSP product_full.
DSP Report: operator product_full is absorbed into DSP product_full.
DSP Report: Generating DSP product_full, operation Mode is: PCIN+A*B.
DSP Report: operator product_full is absorbed into DSP product_full.
DSP Report: operator product_full is absorbed into DSP product_full.
DSP Report: Generating DSP product_full, operation Mode is: A*B.
DSP Report: operator product_full is absorbed into DSP product_full.
DSP Report: operator product_full is absorbed into DSP product_full.
DSP Report: Generating DSP product_full, operation Mode is: PCIN+A*B.
DSP Report: operator product_full is absorbed into DSP product_full.
DSP Report: operator product_full is absorbed into DSP product_full.
DSP Report: Generating DSP product_full, operation Mode is: (PCIN>>17)+A*B.
DSP Report: operator product_full is absorbed into DSP product_full.
DSP Report: operator product_full is absorbed into DSP product_full.
DSP Report: Generating DSP product_full, operation Mode is: PCIN+A*B.
DSP Report: operator product_full is absorbed into DSP product_full.
DSP Report: operator product_full is absorbed into DSP product_full.
DSP Report: Generating DSP product_full, operation Mode is: A*B.
DSP Report: operator product_full is absorbed into DSP product_full.
DSP Report: operator product_full is absorbed into DSP product_full.
DSP Report: Generating DSP product_full, operation Mode is: (PCIN>>17)+A*B.
DSP Report: operator product_full is absorbed into DSP product_full.
DSP Report: operator product_full is absorbed into DSP product_full.
DSP Report: Generating DSP product_full, operation Mode is: PCIN+A*B.
DSP Report: operator product_full is absorbed into DSP product_full.
DSP Report: operator product_full is absorbed into DSP product_full.
DSP Report: Generating DSP product_full, operation Mode is: (PCIN>>17)+A*B.
DSP Report: operator product_full is absorbed into DSP product_full.
DSP Report: operator product_full is absorbed into DSP product_full.
INFO: [Synth 8-7124] RAM ("riscvtop/e_PROCESSOR/u_dmem/mem_reg") is implemented using BRAM instead of URAM. Memory would be severely underutilized if URAMs are used
---------------------------------------------------------------------------------
Finished Cross Boundary and Area Optimization : Time (s): cpu = 00:00:48 ; elapsed = 00:01:07 . Memory (MB): peak = 3676.352 ; gain = 892.078 ; free physical = 121402 ; free virtual = 133658
---------------------------------------------------------------------------------
Sort Area is product_full_0 : 0 0 : 2701 10690 : Used 1 time 0
Sort Area is product_full_0 : 0 1 : 2710 10690 : Used 1 time 0
Sort Area is product_full_0 : 0 2 : 2712 10690 : Used 1 time 0
Sort Area is product_full_0 : 0 3 : 2567 10690 : Used 1 time 0
Sort Area is product_full_5 : 0 0 : 2701 8023 : Used 1 time 0
Sort Area is product_full_5 : 0 1 : 2712 8023 : Used 1 time 0
Sort Area is product_full_5 : 0 2 : 1305 8023 : Used 1 time 0
Sort Area is product_full_5 : 0 3 : 1305 8023 : Used 1 time 0
Sort Area is product_full_8 : 0 0 : 2701 4742 : Used 1 time 0
Sort Area is product_full_8 : 0 1 : 2041 4742 : Used 1 time 0
---------------------------------------------------------------------------------
Start ROM, RAM, DSP, Shift Register and Retiming Reporting
---------------------------------------------------------------------------------

ROM: Preliminary Mapping Report
+------------+------------+---------------+----------------+
|Module Name | RTL Object | Depth x Width | Implemented As |
+------------+------------+---------------+----------------+
|rvbl2_imem | rom_word | 4096x32 | LUT |
|rvbl2_imem | rom_word | 4096x32 | LUT |
+------------+------------+---------------+----------------+

Block RAM: Preliminary Mapping Report (see note below)
+------------+----------------------------+------------------------+---+---+------------------------+---+---+------------------+--------+--------+-----------------+
|Module Name | RTL Object | PORT A (Depth x Width) | W | R | PORT B (Depth x Width) | W | R | Ports driving FF | RAMB18 | RAMB36 | Cascade Heights |
+------------+----------------------------+------------------------+---+---+------------------------+---+---+------------------+--------+--------+-----------------+
|riscvtop | e_PROCESSOR/u_dmem/mem_reg | 2 K x 32(READ_FIRST) | W | | 2 K x 32(WRITE_FIRST) | | R | Port A and B | 0 | 2 | |
+------------+----------------------------+------------------------+---+---+------------------------+---+---+------------------+--------+--------+-----------------+

Note: The table above is a preliminary report that shows the Block RAMs at the current stage of the synthesis flow. Some Block RAMs may be reimplemented as non Block RAM primitives later in the synthesis flow. Multiple instantiated Block RAMs are reported only once.

DSP: Preliminary Mapping Report (see note below. The ' indicates corresponding REG is set)
+-----------------+----------------+--------+--------+--------+--------+--------+------+------+------+------+-------+------+------+
|Module Name | DSP Mapping | A Size | B Size | C Size | D Size | P Size | AREG | BREG | CREG | DREG | ADREG | MREG | PREG |
+-----------------+----------------+--------+--------+--------+--------+--------+------+------+------+------+-------+------+------+
|rvbl2_multiplier | A*B | 18 | 18 | - | - | 48 | 0 | 0 | - | - | - | 0 | 0 |
|rvbl2_multiplier | PCIN+A*B | 18 | 14 | - | - | 48 | 0 | 0 | - | - | - | 0 | 0 |
|rvbl2_multiplier | A*B | 18 | 18 | - | - | 48 | 0 | 0 | - | - | - | 0 | 0 |
|rvbl2_multiplier | PCIN+A*B | 18 | 18 | - | - | 48 | 0 | 0 | - | - | - | 0 | 0 |
|rvbl2_multiplier | (PCIN>>17)+A*B | 13 | 13 | - | - | 13 | 0 | 0 | - | - | - | 0 | 0 |
|rvbl2_multiplier | PCIN+A*B | 13 | 13 | - | - | 13 | 0 | 0 | - | - | - | 0 | 0 |
|rvbl2_multiplier | A*B | 18 | 18 | - | - | 48 | 0 | 0 | - | - | - | 0 | 0 |
|rvbl2_multiplier | (PCIN>>17)+A*B | 18 | 18 | - | - | 48 | 0 | 0 | - | - | - | 0 | 0 |
|rvbl2_multiplier | PCIN+A*B | 18 | 18 | - | - | 48 | 0 | 0 | - | - | - | 0 | 0 |
|rvbl2_multiplier | (PCIN>>17)+A*B | 18 | 18 | - | - | 30 | 0 | 0 | - | - | - | 0 | 0 |
+-----------------+----------------+--------+--------+--------+--------+--------+------+------+------+------+-------+------+------+

Note: The table above is a preliminary report that shows the DSPs inferred at the current stage of the synthesis flow. Some DSP may be reimplemented as non DSP primitives later in the synthesis flow. Multiple instantiated DSPs are reported only once.
---------------------------------------------------------------------------------
Finished ROM, RAM, DSP, Shift Register and Retiming Reporting
---------------------------------------------------------------------------------
---------------------------------------------------------------------------------
Start Applying XDC Timing Constraints
---------------------------------------------------------------------------------
---------------------------------------------------------------------------------
Finished Applying XDC Timing Constraints : Time (s): cpu = 00:00:54 ; elapsed = 00:01:20 . Memory (MB): peak = 3747.852 ; gain = 963.578 ; free physical = 121270 ; free virtual = 133544
---------------------------------------------------------------------------------
---------------------------------------------------------------------------------
Start Timing Optimization
---------------------------------------------------------------------------------
---------------------------------------------------------------------------------
Finished Timing Optimization : Time (s): cpu = 00:00:55 ; elapsed = 00:01:21 . Memory (MB): peak = 3777.898 ; gain = 993.625 ; free physical = 121255 ; free virtual = 133528
---------------------------------------------------------------------------------
---------------------------------------------------------------------------------
Start ROM, RAM, DSP, Shift Register and Retiming Reporting
---------------------------------------------------------------------------------

Block RAM: Final Mapping Report
+------------+----------------------------+------------------------+---+---+------------------------+---+---+------------------+--------+--------+-----------------+
|Module Name | RTL Object | PORT A (Depth x Width) | W | R | PORT B (Depth x Width) | W | R | Ports driving FF | RAMB18 | RAMB36 | Cascade Heights |
+------------+----------------------------+------------------------+---+---+------------------------+---+---+------------------+--------+--------+-----------------+
|riscvtop | e_PROCESSOR/u_dmem/mem_reg | 2 K x 32(READ_FIRST) | W | | 2 K x 32(WRITE_FIRST) | | R | Port A and B | 0 | 2 | |
+------------+----------------------------+------------------------+---+---+------------------------+---+---+------------------+--------+--------+-----------------+

---------------------------------------------------------------------------------
Finished ROM, RAM, DSP, Shift Register and Retiming Reporting
---------------------------------------------------------------------------------
---------------------------------------------------------------------------------
Start Technology Mapping
---------------------------------------------------------------------------------
INFO: [Synth 8-7052] The timing for the instance riscvtop/e_PROCESSOR/u_dmem/mem_reg_0 (implemented as a Block RAM) might be sub-optimal as no optional output register could be merged into the ram block. Providing additional output register may help in improving timing.
INFO: [Synth 8-7052] The timing for the instance riscvtop/e_PROCESSOR/u_dmem/mem_reg_1 (implemented as a Block RAM) might be sub-optimal as no optional output register could be merged into the ram block. Providing additional output register may help in improving timing.
---------------------------------------------------------------------------------
Finished Technology Mapping : Time (s): cpu = 00:00:57 ; elapsed = 00:01:23 . Memory (MB): peak = 3894.898 ; gain = 1110.625 ; free physical = 121139 ; free virtual = 133413
---------------------------------------------------------------------------------
---------------------------------------------------------------------------------
Start IO Insertion
---------------------------------------------------------------------------------
---------------------------------------------------------------------------------
Start Flattening Before IO Insertion
---------------------------------------------------------------------------------
---------------------------------------------------------------------------------
Finished Flattening Before IO Insertion
---------------------------------------------------------------------------------
---------------------------------------------------------------------------------
Start Final Netlist Cleanup
---------------------------------------------------------------------------------
---------------------------------------------------------------------------------
Finished Final Netlist Cleanup
---------------------------------------------------------------------------------
CRITICAL WARNING: [Synth 8-5799] Converted tricell instance 'i_47' to logic
CRITICAL WARNING: [Synth 8-5799] Converted tricell instance 'i_49' to logic
CRITICAL WARNING: [Synth 8-5799] Converted tricell instance 'i_51' to logic
CRITICAL WARNING: [Synth 8-5799] Converted tricell instance 'i_53' to logic
CRITICAL WARNING: [Synth 8-5799] Converted tricell instance 'i_55' to logic
CRITICAL WARNING: [Synth 8-5799] Converted tricell instance 'i_57' to logic
CRITICAL WARNING: [Synth 8-5799] Converted tricell instance 'i_59' to logic
CRITICAL WARNING: [Synth 8-5799] Converted tricell instance 'i_61' to logic
CRITICAL WARNING: [Synth 8-5799] Converted tricell instance 'i_21' to logic
CRITICAL WARNING: [Synth 8-5799] Converted tricell instance 'i_22' to logic
CRITICAL WARNING: [Synth 8-5799] Converted tricell instance 'i_23' to logic
CRITICAL WARNING: [Synth 8-5799] Converted tricell instance 'i_24' to logic
CRITICAL WARNING: [Synth 8-5799] Converted tricell instance 'i_25' to logic
CRITICAL WARNING: [Synth 8-5799] Converted tricell instance 'i_26' to logic
CRITICAL WARNING: [Synth 8-5799] Converted tricell instance 'i_27' to logic
CRITICAL WARNING: [Synth 8-5799] Converted tricell instance 'i_28' to logic
---------------------------------------------------------------------------------
Finished IO Insertion : Time (s): cpu = 00:01:00 ; elapsed = 00:01:26 . Memory (MB): peak = 3894.898 ; gain = 1110.625 ; free physical = 121153 ; free virtual = 133427
---------------------------------------------------------------------------------
---------------------------------------------------------------------------------
Start Renaming Generated Instances
---------------------------------------------------------------------------------
---------------------------------------------------------------------------------
Finished Renaming Generated Instances : Time (s): cpu = 00:01:00 ; elapsed = 00:01:26 . Memory (MB): peak = 3894.898 ; gain = 1110.625 ; free physical = 121153 ; free virtual = 133427
---------------------------------------------------------------------------------
---------------------------------------------------------------------------------
Start Rebuilding User Hierarchy
---------------------------------------------------------------------------------
---------------------------------------------------------------------------------
Finished Rebuilding User Hierarchy : Time (s): cpu = 00:01:01 ; elapsed = 00:01:27 . Memory (MB): peak = 3894.898 ; gain = 1110.625 ; free physical = 121174 ; free virtual = 133447
---------------------------------------------------------------------------------
---------------------------------------------------------------------------------
Start Renaming Generated Ports
---------------------------------------------------------------------------------
---------------------------------------------------------------------------------
Finished Renaming Generated Ports : Time (s): cpu = 00:01:01 ; elapsed = 00:01:27 . Memory (MB): peak = 3894.898 ; gain = 1110.625 ; free physical = 121174 ; free virtual = 133447
---------------------------------------------------------------------------------
---------------------------------------------------------------------------------
Start Handling Custom Attributes
---------------------------------------------------------------------------------
---------------------------------------------------------------------------------
Finished Handling Custom Attributes : Time (s): cpu = 00:01:01 ; elapsed = 00:01:27 . Memory (MB): peak = 3894.898 ; gain = 1110.625 ; free physical = 121174 ; free virtual = 133447
---------------------------------------------------------------------------------
---------------------------------------------------------------------------------
Start Renaming Generated Nets
---------------------------------------------------------------------------------
---------------------------------------------------------------------------------
Finished Renaming Generated Nets : Time (s): cpu = 00:01:01 ; elapsed = 00:01:27 . Memory (MB): peak = 3894.898 ; gain = 1110.625 ; free physical = 121174 ; free virtual = 133447
---------------------------------------------------------------------------------
---------------------------------------------------------------------------------
Start Writing Synthesis Report
---------------------------------------------------------------------------------

DSP Final Report (the ' indicates corresponding REG is set)
+-----------------+--------------+--------+--------+--------+--------+--------+------+------+------+------+-------+------+------+
|Module Name | DSP Mapping | A Size | B Size | C Size | D Size | P Size | AREG | BREG | CREG | DREG | ADREG | MREG | PREG |
+-----------------+--------------+--------+--------+--------+--------+--------+------+------+------+------+-------+------+------+
|rvbl2_multiplier | A*B | 17 | 17 | - | - | 48 | 0 | 0 | - | - | - | 0 | 0 |
|rvbl2_multiplier | PCIN+A*B | 17 | 13 | - | - | 48 | 0 | 0 | - | - | - | 0 | 0 |
|rvbl2_multiplier | A*B | 17 | 17 | - | - | 48 | 0 | 0 | - | - | - | 0 | 0 |
|rvbl2_multiplier | PCIN+A*B | 17 | 17 | - | - | 48 | 0 | 0 | - | - | - | 0 | 0 |
|rvbl2_multiplier | PCIN>>17+A*B | 30 | 13 | - | - | 13 | 0 | 0 | - | - | - | 0 | 0 |
|rvbl2_multiplier | PCIN+A*B | 13 | 13 | - | - | 13 | 0 | 0 | - | - | - | 0 | 0 |
|rvbl2_multiplier | A*B | 17 | 17 | - | - | 48 | 0 | 0 | - | - | - | 0 | 0 |
|rvbl2_multiplier | PCIN>>17+A*B | 17 | 17 | - | - | 48 | 0 | 0 | - | - | - | 0 | 0 |
|rvbl2_multiplier | PCIN+A*B | 17 | 17 | - | - | 48 | 0 | 0 | - | - | - | 0 | 0 |
|rvbl2_multiplier | PCIN>>17+A*B | 17 | 17 | - | - | 30 | 0 | 0 | - | - | - | 0 | 0 |
+-----------------+--------------+--------+--------+--------+--------+--------+------+------+------+------+-------+------+------+

Report BlackBoxes:
+-+--------------+----------+
| |BlackBox name |Instances |
+-+--------------+----------+
+-+--------------+----------+

Report Cell Usage:
+------+----------------+------+
| |Cell |Count |
+------+----------------+------+
|1 |BUFG | 1|
|2 |CARRY8 | 32|
|3 |DSP_ALU | 10|
|4 |DSP_A_B_DATA | 10|
|5 |DSP_C_DATA | 10|
|6 |DSP_MULTIPLIER | 10|
|7 |DSP_M_DATA | 10|
|8 |DSP_OUTPUT | 10|
|9 |DSP_PREADD | 10|
|10 |DSP_PREADD_DATA | 10|
|11 |LUT1 | 15|
|12 |LUT2 | 274|
|13 |LUT3 | 472|
|14 |LUT4 | 402|
|15 |LUT5 | 515|
|16 |LUT6 | 3404|
|17 |MMCME4_BASE | 1|
|18 |MUXF7 | 720|
|19 |MUXF8 | 224|
|20 |RAMB36E2 | 2|
|21 |FDCE | 192|
|22 |FDPE | 11|
|23 |FDRE | 1256|
|24 |FDSE | 13|
|25 |IBUFDS | 1|
|26 |IOBUFDS | 18|
|27 |IOBUFE3 | 72|
|28 |OBUF | 35|
+------+----------------+------+
---------------------------------------------------------------------------------
Finished Writing Synthesis Report : Time (s): cpu = 00:01:01 ; elapsed = 00:01:27 . Memory (MB): peak = 3894.898 ; gain = 1110.625 ; free physical = 121174 ; free virtual = 133447
---------------------------------------------------------------------------------
Synthesis finished with 0 errors, 16 critical warnings and 5707 warnings.
Synthesis Optimization Runtime : Time (s): cpu = 00:00:49 ; elapsed = 00:01:02 . Memory (MB): peak = 3894.898 ; gain = 761.016 ; free physical = 121173 ; free virtual = 133447
Synthesis Optimization Complete : Time (s): cpu = 00:01:01 ; elapsed = 00:01:27 . Memory (MB): peak = 3894.898 ; gain = 1110.625 ; free physical = 121173 ; free virtual = 133447
INFO: [Project 1-571] Translating synthesized netlist
Netlist sorting complete. Time (s): cpu = 00:00:00.05 ; elapsed = 00:00:00.05 . Memory (MB): peak = 3894.898 ; gain = 0.000 ; free physical = 121464 ; free virtual = 133741
INFO: [Netlist 29-17] Analyzing 1079 Unisim elements for replacement
INFO: [Netlist 29-28] Unisim Transformation completed in 0 CPU seconds
INFO: [Project 1-570] Preparing netlist for logic optimization
Parsing XDC File [/home/ubuntu/src/aws-fpga/hdk/cl/examples/top/build/constraints/generated_cl_clocks_aws.xdc]
Finished Parsing XDC File [/home/ubuntu/src/aws-fpga/hdk/cl/examples/top/build/constraints/generated_cl_clocks_aws.xdc]
Parsing XDC File [/home/ubuntu/src/aws-fpga/hdk/common/shell_stable/build/constraints/cl_pins.xdc]
CRITICAL WARNING: [Vivado 12-1815] Setting property 'IOSTANDARD' is not allowed for GT terminals. [/home/ubuntu/src/aws-fpga/hdk/common/shell_stable/build/constraints/cl_pins.xdc:205]
CRITICAL WARNING: [Vivado 12-1815] Setting property 'IOSTANDARD' is not allowed for GT terminals. [/home/ubuntu/src/aws-fpga/hdk/common/shell_stable/build/constraints/cl_pins.xdc:223]
Finished Parsing XDC File [/home/ubuntu/src/aws-fpga/hdk/common/shell_stable/build/constraints/cl_pins.xdc]
Parsing XDC File [/home/ubuntu/src/aws-fpga/hdk/common/shell_stable/build/constraints/cl_ddr_timing_aws.xdc]
WARNING: [Vivado 12-180] No cells matched '*'. [/home/ubuntu/src/aws-fpga/hdk/common/shell_stable/build/constraints/cl_ddr_timing_aws.xdc:26]
WARNING: [Vivado 12-508] No pins matched 'get_pins -of_objects [get_cells -hierarchical -filter { NAME =~ *ram_reg*}] -filter {REF_PIN_NAME == CLK}'. [/home/ubuntu/src/aws-fpga/hdk/common/shell_stable/build/constraints/cl_ddr_timing_aws.xdc:26]
WARNING: [Vivado 12-180] No cells matched '*'. [/home/ubuntu/src/aws-fpga/hdk/common/shell_stable/build/constraints/cl_ddr_timing_aws.xdc:26]
CRITICAL WARNING: [Vivado 12-4739] set_false_path:No valid object(s) found for '-from [get_pins -of_objects [get_cells -hierarchical -filter { NAME =~ *ram_reg*}] -filter {REF_PIN_NAME == CLK}]'. [/home/ubuntu/src/aws-fpga/hdk/common/shell_stable/build/constraints/cl_ddr_timing_aws.xdc:26]
Resolution: Check if the specified object(s) exists in the current design. If it does, ensure that the correct design hierarchy was specified for the object. If you are working with clocks, make sure create_clock was used to create the clock object before it is referenced.
WARNING: [Vivado 12-508] No pins matched '*'. [/home/ubuntu/src/aws-fpga/hdk/common/shell_stable/build/constraints/cl_ddr_timing_aws.xdc:30]
INFO: [Timing 38-35] Done setting XDC timing constraints. [/home/ubuntu/src/aws-fpga/hdk/common/shell_stable/build/constraints/cl_ddr_timing_aws.xdc:30]
INFO: [Timing 38-2] Deriving generated clocks [/home/ubuntu/src/aws-fpga/hdk/common/shell_stable/build/constraints/cl_ddr_timing_aws.xdc:30]
WARNING: [Vivado 12-1008] No clocks found for command 'get_clocks -of_objects [get_pins -hierarchical -filter NAME=~*SH_DDR/genblk1.IS_DDR_PRESENT.DDR4_0/inst/u_ddr4_infrastructure/gen_mmcme4.u_mmcme_adv_inst/CLKOUT0]'. [/home/ubuntu/src/aws-fpga/hdk/common/shell_stable/build/constraints/cl_ddr_timing_aws.xdc:30]
Resolution: Verify the create_clock command was called to create the clock object before it is referenced.
INFO: [Vivado 12-626] No clocks found. Please use 'create_clock' or 'create_generated_clock' command to create clocks. [/home/ubuntu/src/aws-fpga/hdk/common/shell_stable/build/constraints/cl_ddr_timing_aws.xdc:30]
CRITICAL WARNING: [Vivado 12-4739] set_clock_groups:No valid object(s) found for '-group [get_clocks -of_objects [get_pins -hierarchical -filter NAME=~*SH_DDR/genblk1.IS_DDR_PRESENT.DDR4_0/inst/u_ddr4_infrastructure/gen_mmcme4.u_mmcme_adv_inst/CLKOUT0]]'. [/home/ubuntu/src/aws-fpga/hdk/common/shell_stable/build/constraints/cl_ddr_timing_aws.xdc:30]
Resolution: Check if the specified object(s) exists in the current design. If it does, ensure that the correct design hierarchy was specified for the object. If you are working with clocks, make sure create_clock was used to create the clock object before it is referenced.
CRITICAL WARNING: [Vivado 12-4739] set_clock_groups:No valid object(s) found for '-group '. [/home/ubuntu/src/aws-fpga/hdk/common/shell_stable/build/constraints/cl_ddr_timing_aws.xdc:30]
Resolution: Check if the specified object(s) exists in the current design. If it does, ensure that the correct design hierarchy was specified for the object. If you are working with clocks, make sure create_clock was used to create the clock object before it is referenced.
CRITICAL WARNING: [Vivado 12-5201] set_clock_groups: cannot set the clock group when only one non-empty group remains. [/home/ubuntu/src/aws-fpga/hdk/common/shell_stable/build/constraints/cl_ddr_timing_aws.xdc:30]
Finished Parsing XDC File [/home/ubuntu/src/aws-fpga/hdk/common/shell_stable/build/constraints/cl_ddr_timing_aws.xdc]
Parsing XDC File [/home/ubuntu/src/aws-fpga/hdk/cl/examples/top/build/constraints/cl_synth_user.xdc]
Finished Parsing XDC File [/home/ubuntu/src/aws-fpga/hdk/cl/examples/top/build/constraints/cl_synth_user.xdc]
Parsing XDC File [/home/ubuntu/src/aws-fpga/hdk/cl/examples/top/build/constraints/cl_timing_user.xdc]
Finished Parsing XDC File [/home/ubuntu/src/aws-fpga/hdk/cl/examples/top/build/constraints/cl_timing_user.xdc]
INFO: [Opt 31-138] Pushed 0 inverter(s) to 0 load pin(s).
INFO: [Opt 31-326] The CLKFBOUT to CLKFBIN net for instance riscvtop/u_mmcm with COMPENSATION=INTERNAL is optimized away to aid design routability
Netlist sorting complete. Time (s): cpu = 00:00:00 ; elapsed = 00:00:00 . Memory (MB): peak = 4131.613 ; gain = 0.000 ; free physical = 121366 ; free virtual = 133645
INFO: [Project 1-111] Unisim Transformation Summary:
A total of 103 instances were transformed.
BUFG => BUFGCE: 1 instance
DSP48E2 => DSP48E2 (DSP_ALU, DSP_A_B_DATA, DSP_C_DATA, DSP_MULTIPLIER, DSP_M_DATA, DSP_OUTPUT, DSP_PREADD, DSP_PREADD_DATA): 10 instances
IBUFDS => IBUFDS (DIFFINBUF, IBUFCTRL): 1 instance
IOBUFDS => IOBUFDS (DIFFINBUF, IBUFCTRL, INV, OBUFT(x2)): 18 instances
IOBUFE3 => IOBUFE3 (IBUFCTRL, INBUF, OBUFT_DCIEN): 72 instances
MMCME4_BASE => MMCME4_ADV: 1 instance

Synth Design complete | Checksum: aebe8f44
INFO: [Common 17-83] Releasing license: Synthesis
53 Infos, 240 Warnings, 22 Critical Warnings and 0 Errors encountered.
synth_design completed successfully
synth_design: Time (s): cpu = 00:01:28 ; elapsed = 00:02:14 . Memory (MB): peak = 4131.613 ; gain = 2713.898 ; free physical = 121355 ; free virtual = 133634
INFO: [Common 17-2834] synth_design peak Physical Memory [PSS] (MB): overall = 3437.658; main = 3374.606; forked = 452.596
INFO: [Common 17-2834] synth_design peak Virtual Memory [VSS] (MB): overall = 4769.652; main = 4131.617; forked = 1021.797
## print "Connecting debug network"

AWS FPGA: (12:15:15): Connecting debug network

## source ${HDK_SHELL_DIR}/build/scripts/synth_cl_footer.tcl
### print "Writing post-synth design checkpoint"

AWS FPGA: (12:15:15): Writing post-synth design checkpoint

### write_checkpoint -force ${checkpoints_dir}/${CL}.${TAG}.post_synth.dcp
INFO: [Timing 38-35] Done setting XDC timing constraints.
INFO: [Timing 38-480] Writing timing data to binary archive.
Write ShapeDB Complete: Time (s): cpu = 00:00:00.04 ; elapsed = 00:00:00.01 . Memory (MB): peak = 4163.629 ; gain = 0.000 ; free physical = 121383 ; free virtual = 133662
Wrote PlaceDB: Time (s): cpu = 00:00:00.05 ; elapsed = 00:00:00.01 . Memory (MB): peak = 4163.629 ; gain = 0.000 ; free physical = 121383 ; free virtual = 133662
Wrote PulsedLatchDB: Time (s): cpu = 00:00:00 ; elapsed = 00:00:00 . Memory (MB): peak = 4163.629 ; gain = 0.000 ; free physical = 121383 ; free virtual = 133662
Writing XDEF routing.
Writing XDEF routing logical nets.
Writing XDEF routing special nets.
Wrote RouteStorage: Time (s): cpu = 00:00:00.11 ; elapsed = 00:00:00.03 . Memory (MB): peak = 4163.629 ; gain = 0.000 ; free physical = 121381 ; free virtual = 133662
Wrote Netlist Cache: Time (s): cpu = 00:00:00 ; elapsed = 00:00:00 . Memory (MB): peak = 4163.629 ; gain = 0.000 ; free physical = 121381 ; free virtual = 133662
Wrote Device Cache: Time (s): cpu = 00:00:00.05 ; elapsed = 00:00:00.01 . Memory (MB): peak = 4163.629 ; gain = 0.000 ; free physical = 121377 ; free virtual = 133661
Write Physdb Complete: Time (s): cpu = 00:00:00.23 ; elapsed = 00:00:00.06 . Memory (MB): peak = 4163.629 ; gain = 0.000 ; free physical = 121377 ; free virtual = 133661
INFO: [Common 17-1381] The checkpoint '/home/ubuntu/src/aws-fpga/hdk/cl/examples/top/build/checkpoints/top.2026_10_10-121021.post_synth.dcp' has been generated.
### source ${HDK_SHELL_DIR}/build/scripts/check_ddr_bram.tcl
#### print "Checking if MiG BRAM is initialized"

AWS FPGA: (12:15:17): Checking if MiG BRAM is initialized

WARNING: [Vivado 12-180] No cells matched '*'.
#### set ram_inst [get_cells -hierarchical -filter \
#### {NAME=~*mcs0/inst/lmb_bram_I/U0/inst_blk_mem_gen/gnbram.gnative_mem_map_bmg.native_mem_map_blk_mem_gen/valid.cstr/ramloop[0].ram.r/prim_noinit.ram/DEVICE_8SERIES.WITH_BMM_INFO.TRUE_DP.SIMPLE_PRIM36.SERIES8_TDP_SP36_NO_ECC_ATTR.ram}
#### ]
#### if {$ram_inst != ""} {
#### set bram_value_0 "256'h0000000000000000000000000000000000000000000000000000000000000000"
#### set bram_init_value [get_property INIT_2C $ram_inst]
####
#### if {$bram_init_value == $bram_value_0} {
#### print "CRITICAL WARNING: MiG BRAM is not populated with ELF file. This results in Calibration Failure!!"
#### } else {
#### print "MiG BRAM is initialized. INIT_2C = $bram_init_value"
#### }
####
#### } else {
#### print "Skip DDR calibration check"
#### }

AWS FPGA: (12:15:17): Skip DDR calibration check

### close_project
### set_param sta.enableAutoGenClkNamePersistence 1
## set AWS_DCP_DIR "${HDK_SHELL_DIR}/build/checkpoints/from_aws/"
## print "Start linking customer design ${CL}"

AWS FPGA: (12:15:17): Start linking customer design top

## add_files ${AWS_DCP_DIR}/cl_bb_routed.${SHELL_MODE}.dcp
## add_files ${checkpoints_dir}/${CL}.${TAG}.post_synth.dcp
## set_property SCOPED_TO_CELLS {WRAPPER/CL} \
## [get_files ${checkpoints_dir}/${CL}.${TAG}.post_synth.dcp]
## link_design -mode default \
## -reconfig_partitions {WRAPPER/CL} \
## -top top
Command: link_design -mode default -reconfig_partitions WRAPPER/CL -top top
Design is defaulting to srcset: sources_1
Design is defaulting to constrset: constrs_1
Design is defaulting to dcp part: xcvu47p-fsvh2892-2-e
INFO: [Project 1-454] Reading design checkpoint '/home/ubuntu/src/aws-fpga/hdk/cl/examples/top/build/checkpoints/top.2026_10_10-121021.post_synth.dcp' for cell 'WRAPPER/CL'
Netlist sorting complete. Time (s): cpu = 00:00:00.21 ; elapsed = 00:00:00.21 . Memory (MB): peak = 4163.629 ; gain = 0.000 ; free physical = 121351 ; free virtual = 133631
INFO: [Netlist 29-17] Analyzing 1243 Unisim elements for replacement
INFO: [Netlist 29-28] Unisim Transformation completed in 0 CPU seconds
INFO: [Project 1-479] Netlist was created with Vivado 2024.1
INFO: [Project 1-570] Preparing netlist for logic optimization
WARNING: [Constraints 18-550] Could not create 'DRIVE' constraint because net 'WRAPPER/IO_SHIM/rst_dimm_en' is not directly connected to top level port. 'DRIVE' is ignored for synthesis but preserved for implementation.
WARNING: [Constraints 18-550] Could not create 'SLEW' constraint because net 'WRAPPER/IO_SHIM/rst_dimm_en' is not directly connected to top level port. 'SLEW' is ignored for synthesis but preserved for implementation.
WARNING: [Constraints 18-550] Could not create 'IBUF_LOW_PWR' constraint because net 'WRAPPER/IO_SHIM/spi_cs_n' is not directly connected to top level port. 'IBUF_LOW_PWR' is ignored for synthesis but preserved for implementation.
WARNING: [Constraints 18-550] Could not create 'DRIVE' constraint because net 'WRAPPER/IO_SHIM/spi_miso' is not directly connected to top level port. 'DRIVE' is ignored for synthesis but preserved for implementation.
WARNING: [Constraints 18-550] Could not create 'SLEW' constraint because net 'WRAPPER/IO_SHIM/spi_miso' is not directly connected to top level port. 'SLEW' is ignored for synthesis but preserved for implementation.
WARNING: [Constraints 18-550] Could not create 'DRIVE' constraint because net 'WRAPPER/IO_SHIM/spi_miso_ts' is not directly connected to top level port. 'DRIVE' is ignored for synthesis but preserved for implementation.
WARNING: [Constraints 18-550] Could not create 'SLEW' constraint because net 'WRAPPER/IO_SHIM/spi_miso_ts' is not directly connected to top level port. 'SLEW' is ignored for synthesis but preserved for implementation.
WARNING: [Constraints 18-550] Could not create 'IBUF_LOW_PWR' constraint because net 'WRAPPER/IO_SHIM/spi_mosi' is not directly connected to top level port. 'IBUF_LOW_PWR' is ignored for synthesis but preserved for implementation.
WARNING: [Constraints 18-550] Could not create 'IBUF_LOW_PWR' constraint because net 'WRAPPER/IO_SHIM/spi_sck' is not directly connected to top level port. 'IBUF_LOW_PWR' is ignored for synthesis but preserved for implementation.
WARNING: [Constraints 18-550] Could not create 'IBUF_LOW_PWR' constraint because net 'WRAPPER/IO_SHIM/uc_pcie_perst_n' is not directly connected to top level port. 'IBUF_LOW_PWR' is ignored for synthesis but preserved for implementation.
WARNING: [Constraints 18-550] Could not create 'IBUF_LOW_PWR' constraint because net 'WRAPPER/IO_SHIM/vr_alert_n' is not directly connected to top level port. 'IBUF_LOW_PWR' is ignored for synthesis but preserved for implementation.
Parsing XDC File [/home/ubuntu/src/aws-fpga/hdk/common/shell_stable/build/checkpoints/from_aws/cl_bb_routed.small_shell/top_board.xdc]
Finished Parsing XDC File [/home/ubuntu/src/aws-fpga/hdk/common/shell_stable/build/checkpoints/from_aws/cl_bb_routed.small_shell/top_board.xdc]
Parsing XDC File [/home/ubuntu/src/aws-fpga/hdk/common/shell_stable/build/checkpoints/from_aws/cl_bb_routed.small_shell/top_early.xdc]
WARNING: [Constraints 18-619] A clock with name 'CLK_DIMM_DP' already exists, overwriting the previous clock with the same name. [/proj/chiron/zhcz/F2/2024_1/f2/design/ip/cl_ip/cl_ip.gen/sources_1/ip/cl_ddr4/par/cl_ddr4.xdc:7]
Finished Parsing XDC File [/home/ubuntu/src/aws-fpga/hdk/common/shell_stable/build/checkpoints/from_aws/cl_bb_routed.small_shell/top_early.xdc]
Parsing XDC File [/home/ubuntu/src/aws-fpga/hdk/cl/examples/top/build/checkpoints/top.2026_10_10-121021.post_synth/top_early.xdc] for cell 'WRAPPER/CL'
Finished Parsing XDC File [/home/ubuntu/src/aws-fpga/hdk/cl/examples/top/build/checkpoints/top.2026_10_10-121021.post_synth/top_early.xdc] for cell 'WRAPPER/CL'
Parsing XDC File [/home/ubuntu/src/aws-fpga/hdk/common/shell_stable/build/checkpoints/from_aws/cl_bb_routed.small_shell/top.xdc]
INFO: [Constraints 18-4422] SNAPPING_MODE is set so implementation will use the DERIVED_RANGES which may be different then the GRID_RANGES. [/proj/chiron/zhcz/scratch/F2_BUILD_2024_Vivado_2024-10-21-15-03-11299/build/hpr_AltSpreadLogic_low_AggressiveExplore/constraints/floorplan/small_shell/level_1_fp_cl.xdc:18]
INFO: [Constraints 18-4421] A LAGUNA range, without usable sites, was added to DERIVED_RANGES for purposes of keeping the Programmable Unit together within the reconfigurable pblock. [/proj/chiron/zhcz/scratch/F2_BUILD_2024_Vivado_2024-10-21-15-03-11299/build/hpr_AltSpreadLogic_low_AggressiveExplore/constraints/floorplan/small_shell/level_1_fp_cl.xdc:18]
Finished Parsing XDC File [/home/ubuntu/src/aws-fpga/hdk/common/shell_stable/build/checkpoints/from_aws/cl_bb_routed.small_shell/top.xdc]
Parsing XDC File [/home/ubuntu/src/aws-fpga/hdk/cl/examples/top/build/checkpoints/top.2026_10_10-121021.post_synth/top.xdc] for cell 'WRAPPER/CL'
Finished Parsing XDC File [/home/ubuntu/src/aws-fpga/hdk/cl/examples/top/build/checkpoints/top.2026_10_10-121021.post_synth/top.xdc] for cell 'WRAPPER/CL'
Parsing XDC File [/home/ubuntu/src/aws-fpga/hdk/common/shell_stable/build/checkpoints/from_aws/cl_bb_routed.small_shell/top_late.xdc]
INFO: [Vivado 12-24630] Instance: 'WRAPPER/CL' is a DFX HD.RECONFIGURABLE module.
INFO: [Timing 38-35] Done setting XDC timing constraints. [/proj/chiron/zhcz/scratch/F2_BUILD_2024_Vivado_2024-10-21-15-03-11299/build/hpr_AltSpreadLogic_low_AggressiveExplore/constraints/timing/io_timing.xdc:20]
INFO: [Timing 38-2] Deriving generated clocks [/proj/chiron/zhcz/scratch/F2_BUILD_2024_Vivado_2024-10-21-15-03-11299/build/hpr_AltSpreadLogic_low_AggressiveExplore/constraints/timing/io_timing.xdc:20]
WARNING: [Vivado 12-627] No clocks matched 'mmcm_clkout0'. [/proj/chiron/zhcz/scratch/F2_BUILD_2024_Vivado_2024-10-21-15-03-11299/build/hpr_AltSpreadLogic_low_AggressiveExplore/constraints/timing/io_timing.xdc:20]
WARNING: [Vivado 12-627] No clocks matched 'mmcm_clkout1'. [/proj/chiron/zhcz/scratch/F2_BUILD_2024_Vivado_2024-10-21-15-03-11299/build/hpr_AltSpreadLogic_low_AggressiveExplore/constraints/timing/io_timing.xdc:20]
WARNING: [Vivado 12-627] No clocks matched 'mmcm_clkout2'. [/proj/chiron/zhcz/scratch/F2_BUILD_2024_Vivado_2024-10-21-15-03-11299/build/hpr_AltSpreadLogic_low_AggressiveExplore/constraints/timing/io_timing.xdc:20]
WARNING: [Vivado 12-627] No clocks matched 'mmcm_clkout3'. [/proj/chiron/zhcz/scratch/F2_BUILD_2024_Vivado_2024-10-21-15-03-11299/build/hpr_AltSpreadLogic_low_AggressiveExplore/constraints/timing/io_timing.xdc:20]
WARNING: [Vivado 12-627] No clocks matched 'mmcm_clkout4'. [/proj/chiron/zhcz/scratch/F2_BUILD_2024_Vivado_2024-10-21-15-03-11299/build/hpr_AltSpreadLogic_low_AggressiveExplore/constraints/timing/io_timing.xdc:20]
WARNING: [Vivado 12-627] No clocks matched 'mmcm_clkout5'. [/proj/chiron/zhcz/scratch/F2_BUILD_2024_Vivado_2024-10-21-15-03-11299/build/hpr_AltSpreadLogic_low_AggressiveExplore/constraints/timing/io_timing.xdc:20]
WARNING: [Vivado 12-627] No clocks matched 'mmcm_clkout6'. [/proj/chiron/zhcz/scratch/F2_BUILD_2024_Vivado_2024-10-21-15-03-11299/build/hpr_AltSpreadLogic_low_AggressiveExplore/constraints/timing/io_timing.xdc:20]
WARNING: [Vivado 12-627] No clocks matched 'pll_clk[0]'. [/proj/chiron/zhcz/scratch/F2_BUILD_2024_Vivado_2024-10-21-15-03-11299/build/hpr_AltSpreadLogic_low_AggressiveExplore/constraints/timing/io_timing.xdc:20]
WARNING: [Vivado 12-627] No clocks matched 'pll_clk[1]'. [/proj/chiron/zhcz/scratch/F2_BUILD_2024_Vivado_2024-10-21-15-03-11299/build/hpr_AltSpreadLogic_low_AggressiveExplore/constraints/timing/io_timing.xdc:20]
WARNING: [Vivado 12-627] No clocks matched 'pll_clk[2]'. [/proj/chiron/zhcz/scratch/F2_BUILD_2024_Vivado_2024-10-21-15-03-11299/build/hpr_AltSpreadLogic_low_AggressiveExplore/constraints/timing/io_timing.xdc:20]
WARNING: [Vivado 12-627] No clocks matched 'pll_clk[0]_DIV'. [/proj/chiron/zhcz/scratch/F2_BUILD_2024_Vivado_2024-10-21-15-03-11299/build/hpr_AltSpreadLogic_low_AggressiveExplore/constraints/timing/io_timing.xdc:20]
WARNING: [Vivado 12-627] No clocks matched 'pll_clk[2]_DIV'. [/proj/chiron/zhcz/scratch/F2_BUILD_2024_Vivado_2024-10-21-15-03-11299/build/hpr_AltSpreadLogic_low_AggressiveExplore/constraints/timing/io_timing.xdc:20]
WARNING: [Vivado 12-627] No clocks matched 'pll_clk[1]_DIV'. [/proj/chiron/zhcz/scratch/F2_BUILD_2024_Vivado_2024-10-21-15-03-11299/build/hpr_AltSpreadLogic_low_AggressiveExplore/constraints/timing/io_timing.xdc:20]
WARNING: [Vivado 12-627] No clocks matched 'mmcm_clkout0'. [/proj/chiron/zhcz/scratch/F2_BUILD_2024_Vivado_2024-10-21-15-03-11299/build/hpr_AltSpreadLogic_low_AggressiveExplore/constraints/timing/io_timing.xdc:21]
WARNING: [Vivado 12-627] No clocks matched 'mmcm_clkout1'. [/proj/chiron/zhcz/scratch/F2_BUILD_2024_Vivado_2024-10-21-15-03-11299/build/hpr_AltSpreadLogic_low_AggressiveExplore/constraints/timing/io_timing.xdc:21]
WARNING: [Vivado 12-627] No clocks matched 'mmcm_clkout2'. [/proj/chiron/zhcz/scratch/F2_BUILD_2024_Vivado_2024-10-21-15-03-11299/build/hpr_AltSpreadLogic_low_AggressiveExplore/constraints/timing/io_timing.xdc:21]
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
WARNING: [Vivado 12-627] No clocks matched 'mmcm_clkout2'. [/proj/chiron/zhcz/scratch/F2_BUILD_2024_Vivado_2024-10-21-15-03-11299/build/hpr_AltSpreadLogic_low_AggressiveExplore/constraints/timing/io_timing.xdc:51]
WARNING: [Vivado 12-627] No clocks matched 'mmcm_clkout3'. [/proj/chiron/zhcz/scratch/F2_BUILD_2024_Vivado_2024-10-21-15-03-11299/build/hpr_AltSpreadLogic_low_AggressiveExplore/constraints/timing/io_timing.xdc:51]
WARNING: [Vivado 12-627] No clocks matched 'mmcm_clkout4'. [/proj/chiron/zhcz/scratch/F2_BUILD_2024_Vivado_2024-10-21-15-03-11299/build/hpr_AltSpreadLogic_low_AggressiveExplore/constraints/timing/io_timing.xdc:51]
WARNING: [Vivado 12-627] No clocks matched 'mmcm_clkout5'. [/proj/chiron/zhcz/scratch/F2_BUILD_2024_Vivado_2024-10-21-15-03-11299/build/hpr_AltSpreadLogic_low_AggressiveExplore/constraints/timing/io_timing.xdc:51]
WARNING: [Vivado 12-627] No clocks matched 'mmcm_clkout6'. [/proj/chiron/zhcz/scratch/F2_BUILD_2024_Vivado_2024-10-21-15-03-11299/build/hpr_AltSpreadLogic_low_AggressiveExplore/constraints/timing/io_timing.xdc:51]
WARNING: [Vivado 12-627] No clocks matched 'pll_clk[0]'. [/proj/chiron/zhcz/scratch/F2_BUILD_2024_Vivado_2024-10-21-15-03-11299/build/hpr_AltSpreadLogic_low_AggressiveExplore/constraints/timing/io_timing.xdc:51]
WARNING: [Vivado 12-627] No clocks matched 'pll_clk[1]'. [/proj/chiron/zhcz/scratch/F2_BUILD_2024_Vivado_2024-10-21-15-03-11299/build/hpr_AltSpreadLogic_low_AggressiveExplore/constraints/timing/io_timing.xdc:51]
INFO: [Common 17-14] Message 'Vivado 12-627' appears 100 times and further instances of the messages will be disabled. Use the Tcl command set_msg_config to change the current settings. [/proj/chiron/zhcz/scratch/F2_BUILD_2024_Vivado_2024-10-21-15-03-11299/build/hpr_AltSpreadLogic_low_AggressiveExplore/constraints/timing/io_timing.xdc:51]
Finished Parsing XDC File [/home/ubuntu/src/aws-fpga/hdk/common/shell_stable/build/checkpoints/from_aws/cl_bb_routed.small_shell/top_late.xdc]
INFO: [Designutils 20-5722] Start Reading Physical Databases.
Reading placement.
Read Netlist Cache: Time (s): cpu = 00:00:00.01 ; elapsed = 00:00:00.01 . Memory (MB): peak = 4239.223 ; gain = 0.000 ; free physical = 121291 ; free virtual = 133573
Reading placer database...
Read Device Cache: Time (s): cpu = 00:00:00.02 ; elapsed = 00:00:00.02 . Memory (MB): peak = 4243.223 ; gain = 4.000 ; free physical = 121285 ; free virtual = 133567
Read PlaceDB: Time (s): cpu = 00:00:00.28 ; elapsed = 00:00:00.29 . Memory (MB): peak = 4253.605 ; gain = 8.000 ; free physical = 121274 ; free virtual = 133557
Read PulsedLatchDB: Time (s): cpu = 00:00:00 ; elapsed = 00:00:00 . Memory (MB): peak = 4254.605 ; gain = 0.000 ; free physical = 121274 ; free virtual = 133556
Reading routing.
Read RouteStorage: Time (s): cpu = 00:00:00.16 ; elapsed = 00:00:00.17 . Memory (MB): peak = 4262.988 ; gain = 8.383 ; free physical = 121266 ; free virtual = 133548
Read Physdb Files: Time (s): cpu = 00:00:00.51 ; elapsed = 00:00:00.53 . Memory (MB): peak = 4262.988 ; gain = 23.766 ; free physical = 121266 ; free virtual = 133548
Restored from archive | CPU: 0.740000 secs | Memory: 16.967819 MB |
Finished XDEF File Restore: Time (s): cpu = 00:00:00.72 ; elapsed = 00:00:00.74 . Memory (MB): peak = 4262.988 ; gain = 23.766 ; free physical = 121265 ; free virtual = 133547
WARNING: [Constraints 18-4434] Global Clock Buffer 'SL/UC_PCIE4_BRIDGE/inst/pcie4_ip_i/inst/bufg_gt_sysclk' is LOCed to site 'BUFG_GT_X1Y120'. Using a LOC constraint to assign the placement of a Global Clock Buffer can result in sub-optimal placement results.
Resolution: Remove the LOC constraint and use the CLOCK_REGION constraint to assign a Global Clock Buffer to a CLOCK_REGION.
WARNING: [Constraints 18-4434] Global Clock Buffer 'WRAPPER/IO_SHIM/BUFG_CLK_125' is LOCed to site 'BUFGCE_X0Y122'. Using a LOC constraint to assign the placement of a Global Clock Buffer can result in sub-optimal placement results.
Resolution: Remove the LOC constraint and use the CLOCK_REGION constraint to assign a Global Clock Buffer to a CLOCK_REGION.
WARNING: [Constraints 18-4434] Global Clock Buffer 'WRAPPER/IO_SHIM/BUFG_CLK_HBM_EXT' is LOCed to site 'BUFGCE_X0Y70'. Using a LOC constraint to assign the placement of a Global Clock Buffer can result in sub-optimal placement results.
Resolution: Remove the LOC constraint and use the CLOCK_REGION constraint to assign a Global Clock Buffer to a CLOCK_REGION.
WARNING: [Constraints 18-4434] Global Clock Buffer 'WRAPPER/IO_SHIM/BUFG_CLK_HBM_INT' is LOCed to site 'BUFGCE_X0Y65'. Using a LOC constraint to assign the placement of a Global Clock Buffer can result in sub-optimal placement results.
Resolution: Remove the LOC constraint and use the CLOCK_REGION constraint to assign a Global Clock Buffer to a CLOCK_REGION.
WARNING: [Constraints 18-4434] Global Clock Buffer 'WRAPPER/IO_SHIM/PLL_CLK_CORE/inst/clkout1_buf' is LOCed to site 'BUFGCE_X0Y56'. Using a LOC constraint to assign the placement of a Global Clock Buffer can result in sub-optimal placement results.
Resolution: Remove the LOC constraint and use the CLOCK_REGION constraint to assign a Global Clock Buffer to a CLOCK_REGION.
WARNING: [Constraints 18-4434] Global Clock Buffer 'WRAPPER/IO_SHIM/PLL_CLK_CORE/inst/clkout2_buf' is LOCed to site 'BUFGCE_X0Y58'. Using a LOC constraint to assign the placement of a Global Clock Buffer can result in sub-optimal placement results.
Resolution: Remove the LOC constraint and use the CLOCK_REGION constraint to assign a Global Clock Buffer to a CLOCK_REGION.
WARNING: [Constraints 18-4434] Global Clock Buffer 'WRAPPER/IO_SHIM/RL_CLKS/BUFG_CLK_A_EXT' is LOCed to site 'BUFGCE_X0Y135'. Using a LOC constraint to assign the placement of a Global Clock Buffer can result in sub-optimal placement results.
Resolution: Remove the LOC constraint and use the CLOCK_REGION constraint to assign a Global Clock Buffer to a CLOCK_REGION.
WARNING: [Constraints 18-4434] Global Clock Buffer 'WRAPPER/IO_SHIM/RL_CLKS/BUFG_CLK_A_INT' is LOCed to site 'BUFGCE_X0Y136'. Using a LOC constraint to assign the placement of a Global Clock Buffer can result in sub-optimal placement results.
Resolution: Remove the LOC constraint and use the CLOCK_REGION constraint to assign a Global Clock Buffer to a CLOCK_REGION.
WARNING: [Constraints 18-4434] Global Clock Buffer 'WRAPPER/RL/HOST_PCIE4C/inst/bufg_gt_sysclk' is LOCed to site 'BUFG_GT_X1Y78'. Using a LOC constraint to assign the placement of a Global Clock Buffer can result in sub-optimal placement results.
Resolution: Remove the LOC constraint and use the CLOCK_REGION constraint to assign a Global Clock Buffer to a CLOCK_REGION.
Parsing XDC File [/home/ubuntu/src/aws-fpga/hdk/cl/examples/top/build/checkpoints/top.2026_10_10-121021.post_synth/top_late.xdc] for cell 'WRAPPER/CL'
Finished Parsing XDC File [/home/ubuntu/src/aws-fpga/hdk/cl/examples/top/build/checkpoints/top.2026_10_10-121021.post_synth/top_late.xdc] for cell 'WRAPPER/CL'
INFO: [Designutils 20-5722] Start Reading Physical Databases.
Reading placement.
Read Netlist Cache: Time (s): cpu = 00:00:00 ; elapsed = 00:00:00 . Memory (MB): peak = 4282.988 ; gain = 0.000 ; free physical = 121245 ; free virtual = 133527
Reading placer database...
Read Device Cache: Time (s): cpu = 00:00:00.02 ; elapsed = 00:00:00.03 . Memory (MB): peak = 4290.824 ; gain = 7.836 ; free physical = 121237 ; free virtual = 133519
CRITICAL WARNING: [Constraints 18-4866] Site IOB_X0Y207 had a top level port PCIE_RP_PERSTN on sitetype net OUTBUF_O which was overwritten!
CRITICAL WARNING: [Constraints 18-4866] Site IOB_X0Y207 had a top level port PCIE_RP_PERSTN on sitetype net PULL_PAD which was overwritten!
CRITICAL WARNING: [Constraints 18-4866] Site IOB_X0Y207 had a top level port PCIE_RP_PERSTN on sitetype net IO which was overwritten!
CRITICAL WARNING: [Constraints 18-4866] Site IOB_X0Y181 had a top level port PCIE_EP_PERSTN on sitetype net OUTBUF_O which was overwritten!
CRITICAL WARNING: [Constraints 18-4866] Site IOB_X0Y181 had a top level port PCIE_EP_PERSTN on sitetype net PULL_PAD which was overwritten!
CRITICAL WARNING: [Constraints 18-4866] Site IOB_X0Y181 had a top level port PCIE_EP_PERSTN on sitetype net IO which was overwritten!
Read PlaceDB: Time (s): cpu = 00:00:00.01 ; elapsed = 00:00:00.01 . Memory (MB): peak = 4291.824 ; gain = 1.000 ; free physical = 121237 ; free virtual = 133519
Read PulsedLatchDB: Time (s): cpu = 00:00:00 ; elapsed = 00:00:00 . Memory (MB): peak = 4291.824 ; gain = 0.000 ; free physical = 121237 ; free virtual = 133519
Reading routing.
Read RouteStorage: Time (s): cpu = 00:00:00 ; elapsed = 00:00:00 . Memory (MB): peak = 4291.824 ; gain = 0.000 ; free physical = 121236 ; free virtual = 133518
Read Physdb Files: Time (s): cpu = 00:00:00.04 ; elapsed = 00:00:00.06 . Memory (MB): peak = 4291.824 ; gain = 8.836 ; free physical = 121236 ; free virtual = 133518
Restored from archive | CPU: 0.060000 secs | Memory: 0.004349 MB |
Finished XDEF File Restore: Time (s): cpu = 00:00:00.05 ; elapsed = 00:00:00.06 . Memory (MB): peak = 4291.824 ; gain = 8.836 ; free physical = 121236 ; free virtual = 133518
Netlist sorting complete. Time (s): cpu = 00:00:00.03 ; elapsed = 00:00:00.02 . Memory (MB): peak = 4334.723 ; gain = 0.000 ; free physical = 121188 ; free virtual = 133470
INFO: [Project 1-111] Unisim Transformation Summary:
A total of 110 instances were transformed.
DSP48E2 => DSP48E2 (DSP_ALU, DSP_A_B_DATA, DSP_C_DATA, DSP_MULTIPLIER, DSP_M_DATA, DSP_OUTPUT, DSP_PREADD, DSP_PREADD_DATA): 10 instances
IBUF => IBUF (IBUFCTRL, INBUF): 6 instances
IBUFDS => IBUFDS (DIFFINBUF, IBUFCTRL): 2 instances
IOBUF => IOBUF (IBUFCTRL, INBUF, OBUFT): 2 instances
IOBUFDS => IOBUFDS (DIFFINBUF, IBUFCTRL, INV, OBUFT(x2)): 18 instances
IOBUFE3 => IOBUFE3 (IBUFCTRL, INBUF, OBUFT_DCIEN): 72 instances

14 Infos, 121 Warnings, 6 Critical Warnings and 0 Errors encountered.
link_design completed successfully
link_design: Time (s): cpu = 00:00:56 ; elapsed = 00:00:56 . Memory (MB): peak = 4334.723 ; gain = 171.094 ; free physical = 121188 ; free virtual = 133470
## print "Writing post-link design checkpoint"

AWS FPGA: (12:16:13): Writing post-link design checkpoint

## write_checkpoint -force ${checkpoints_dir}/${CL}.${TAG}.post_link.dcp
INFO: [Timing 38-480] Writing timing data to binary archive.
Write ShapeDB Complete: Time (s): cpu = 00:00:00.04 ; elapsed = 00:00:00.01 . Memory (MB): peak = 4367.000 ; gain = 15.367 ; free physical = 121181 ; free virtual = 133471
Wrote PlaceDB: Time (s): cpu = 00:00:01 ; elapsed = 00:00:00.38 . Memory (MB): peak = 4382.492 ; gain = 30.859 ; free physical = 121145 ; free virtual = 133458
Wrote PulsedLatchDB: Time (s): cpu = 00:00:00 ; elapsed = 00:00:00 . Memory (MB): peak = 4382.492 ; gain = 0.000 ; free physical = 121143 ; free virtual = 133458
Writing XDEF routing.
Writing XDEF routing logical nets.
Writing XDEF routing special nets.
Wrote RouteStorage: Time (s): cpu = 00:00:00.46 ; elapsed = 00:00:00.1 . Memory (MB): peak = 4384.492 ; gain = 2.000 ; free physical = 121135 ; free virtual = 133455
Wrote Netlist Cache: Time (s): cpu = 00:00:00.04 ; elapsed = 00:00:00.01 . Memory (MB): peak = 4384.492 ; gain = 0.000 ; free physical = 121134 ; free virtual = 133455
Wrote Device Cache: Time (s): cpu = 00:00:00.03 ; elapsed = 00:00:00.01 . Memory (MB): peak = 4384.492 ; gain = 0.000 ; free physical = 121132 ; free virtual = 133455
Write Physdb Complete: Time (s): cpu = 00:00:02 ; elapsed = 00:00:00.52 . Memory (MB): peak = 4384.492 ; gain = 32.859 ; free physical = 121132 ; free virtual = 133455
INFO: [Common 17-1381] The checkpoint '/home/ubuntu/src/aws-fpga/hdk/cl/examples/top/build/checkpoints/top.2026_10_10-121021.post_link.dcp' has been generated.
## source $HDK_SHELL_DIR/build/scripts/aws_clock_properties.tcl
### proc proc_set_mmcm {mmcm_cell clkfbout_mult_f divclk_divide clkout0_divide_f {clkout1_divide 1} {clkout2_divide 1}} {
### set cell_name [get_cells -quiet $mmcm_cell]
### if {$cell_name != ""} {
### set_property CLKFBOUT_MULT_F $clkfbout_mult_f $cell_name
### set_property DIVCLK_DIVIDE $divclk_divide $cell_name
### set_property CLKOUT0_DIVIDE_F $clkout0_divide_f $cell_name
### set_property CLKOUT1_DIVIDE $clkout1_divide $cell_name
### set_property CLKOUT2_DIVIDE $clkout2_divide $cell_name
### } else {
### puts "\nCRITICAL WARNING: $mmcm_cell cell not found. Clock recipe for this MMCM not applied.\n"
### }
### }
### set RL_A0_MMCM "WRAPPER/IO_SHIM/RL_CLKS/MMCM_CLK_MAIN_A/inst/CLK_CORE_DRP_I/clk_inst/mmcme4_adv_inst"
### set GRP_A_MMCM "WRAPPER/CL/AWS_CLK_GEN/CLK_GRP_A_EN_I.CLK_MMCM_A_I/inst/CLK_CORE_DRP_I/clk_inst/mmcme4_adv_inst"
### set GRP_B_MMCM "WRAPPER/CL/AWS_CLK_GEN/CLK_GRP_B_EN_I.CLK_MMCM_B_I/inst/CLK_CORE_DRP_I/clk_inst/mmcme4_adv_inst"
### set GRP_C_MMCM "WRAPPER/CL/AWS_CLK_GEN/CLK_GRP_C_EN_I.CLK_MMCM_C_I/inst/CLK_CORE_DRP_I/clk_inst/mmcme4_adv_inst"
### set GRP_H_MMCM "WRAPPER/CL/AWS_CLK_GEN/CLK_HBM_EN_I.CLK_MMCM_HBM_I/inst/CLK_CORE_DRP_I/clk_inst/mmcme4_adv_inst"
### if {[string compare $clock_recipe_a "A1"] == 0} {
### #
### # clk_main_a0
### #
### set CLKFBOUT_MULT_F 9.5
### set DIVCLK_DIVIDE 1
### set CLKOUT0_DIVIDE_F 4.750
### proc_set_mmcm $RL_A0_MMCM $CLKFBOUT_MULT_F $DIVCLK_DIVIDE $CLKOUT0_DIVIDE_F
###
### #
### # clk_extra_a1, clk_extra_a2, clk_extra_a3
### #
### set CLKFBOUT_MULT_F 15
### set DIVCLK_DIVIDE 1
### set CLKOUT0_DIVIDE_F 12
### set CLKOUT1_DIVIDE 4
### set CLKOUT2_DIVIDE 3
### proc_set_mmcm $GRP_A_MMCM $CLKFBOUT_MULT_F $DIVCLK_DIVIDE $CLKOUT0_DIVIDE_F $CLKOUT1_DIVIDE $CLKOUT2_DIVIDE
###
### } elseif {[string compare $clock_recipe_a "A2"] == 0} {
### #
### # clk_main_a0
### #
### #NOT SUPPORTED# set CLKFBOUT_MULT_F 63.625
### #NOT SUPPORTED# set DIVCLK_DIVIDE 8
### #NOT SUPPORTED# set CLKOUT0_DIVIDE_F 63.625
### set CLKFBOUT_MULT_F 9.5
### set DIVCLK_DIVIDE 1
### set CLKOUT0_DIVIDE_F 4.750
### proc_set_mmcm $RL_A0_MMCM $CLKFBOUT_MULT_F $DIVCLK_DIVIDE $CLKOUT0_DIVIDE_F
###
### #
### # clk_extra_a1, clk_extra_a2, clk_extra_a3
### #
### set CLKFBOUT_MULT_F 12.500
### set DIVCLK_DIVIDE 1
### set CLKOUT0_DIVIDE_F 80
### set CLKOUT1_DIVIDE 10
### set CLKOUT2_DIVIDE 20
### proc_set_mmcm $GRP_A_MMCM $CLKFBOUT_MULT_F $DIVCLK_DIVIDE $CLKOUT0_DIVIDE_F $CLKOUT1_DIVIDE $CLKOUT2_DIVIDE
###
### } else { #A0
### #
### # clk_main_a0
### #
### #NOT SUPPORTED# set CLKFBOUT_MULT_F 9.625
### #NOT SUPPORTED# set DIVCLK_DIVIDE 1
### #NOT SUPPORTED# set CLKOUT0_DIVIDE_F 9.625
### set CLKFBOUT_MULT_F 9.5
### set DIVCLK_DIVIDE 1
### set CLKOUT0_DIVIDE_F 4.750
### proc_set_mmcm $RL_A0_MMCM $CLKFBOUT_MULT_F $DIVCLK_DIVIDE $CLKOUT0_DIVIDE_F
###
### #
### # clk_extra_a1, clk_extra_a2, clk_extra_a3
### #
### set CLKFBOUT_MULT_F 15
### set DIVCLK_DIVIDE 1
### set CLKOUT0_DIVIDE_F 24
### set CLKOUT1_DIVIDE 8
### set CLKOUT2_DIVIDE 6
### proc_set_mmcm $GRP_A_MMCM $CLKFBOUT_MULT_F $DIVCLK_DIVIDE $CLKOUT0_DIVIDE_F $CLKOUT1_DIVIDE $CLKOUT2_DIVIDE
### }

CRITICAL WARNING: WRAPPER/CL/AWS_CLK_GEN/CLK_GRP_A_EN_I.CLK_MMCM_A_I/inst/CLK_CORE_DRP_I/clk_inst/mmcme4_adv_inst cell not found. Clock recipe for this MMCM not applied.

### if {[string compare $clock_recipe_b "B1"] == 0} {
### set CLKFBOUT_MULT_F 11.875
### set DIVCLK_DIVIDE 1
### set CLKOUT0_DIVIDE_F 9.5
### set CLKOUT1_DIVIDE 19
### } elseif {[string compare $clock_recipe_b "B2"] == 0} {
### set CLKFBOUT_MULT_F 11.250
### set DIVCLK_DIVIDE 1
### set CLKOUT0_DIVIDE_F 2.5
### set CLKOUT1_DIVIDE 5
### } elseif {[string compare $clock_recipe_b "B3"] == 0} {
### set CLKFBOUT_MULT_F 11.875
### set DIVCLK_DIVIDE 1
### set CLKOUT0_DIVIDE_F 4.750
### set CLKOUT1_DIVIDE 19
### } elseif {[string compare $clock_recipe_b "B4"] == 0} {
### set CLKFBOUT_MULT_F 12
### set DIVCLK_DIVIDE 1
### set CLKOUT0_DIVIDE_F 4
### set CLKOUT1_DIVIDE 16
### } elseif {[string compare $clock_recipe_b "B5"] == 0} {
### set CLKFBOUT_MULT_F 12
### set DIVCLK_DIVIDE 1
### set CLKOUT0_DIVIDE_F 3
### set CLKOUT1_DIVIDE 12
### } else { #B0
### set CLKFBOUT_MULT_F 12.5
### set DIVCLK_DIVIDE 1
### set CLKOUT0_DIVIDE_F 5
### set CLKOUT1_DIVIDE 10
### }
### proc_set_mmcm $GRP_B_MMCM $CLKFBOUT_MULT_F $DIVCLK_DIVIDE $CLKOUT0_DIVIDE_F $CLKOUT1_DIVIDE

CRITICAL WARNING: WRAPPER/CL/AWS_CLK_GEN/CLK_GRP_B_EN_I.CLK_MMCM_B_I/inst/CLK_CORE_DRP_I/clk_inst/mmcme4_adv_inst cell not found. Clock recipe for this MMCM not applied.

### if {[string compare $clock_recipe_c "C1"] == 0} {
### set CLKFBOUT_MULT_F 12
### set DIVCLK_DIVIDE 1
### set CLKOUT0_DIVIDE_F 8
### set CLKOUT1_DIVIDE 6
### } elseif {[string compare $clock_recipe_c "C2"] == 0} {
### set CLKFBOUT_MULT_F 12
### set DIVCLK_DIVIDE 1
### set CLKOUT0_DIVIDE_F 16
### set CLKOUT1_DIVIDE 12
### } elseif {[string compare $clock_recipe_c "C3"] == 0} {
### set CLKFBOUT_MULT_F 8
### set DIVCLK_DIVIDE 1
### set CLKOUT0_DIVIDE_F 4
### set CLKOUT1_DIVIDE 3
### } else { #C0
### set CLKFBOUT_MULT_F 12
### set DIVCLK_DIVIDE 1
### set CLKOUT0_DIVIDE_F 4
### set CLKOUT1_DIVIDE 3
### }
### proc_set_mmcm $GRP_C_MMCM $CLKFBOUT_MULT_F $DIVCLK_DIVIDE $CLKOUT0_DIVIDE_F $CLKOUT1_DIVIDE

CRITICAL WARNING: WRAPPER/CL/AWS_CLK_GEN/CLK_GRP_C_EN_I.CLK_MMCM_C_I/inst/CLK_CORE_DRP_I/clk_inst/mmcme4_adv_inst cell not found. Clock recipe for this MMCM not applied.

### if {[string compare $clock_recipe_hbm "H1"] == 0} {
### set CLKFBOUT_MULT_F 11.875
### set DIVCLK_DIVIDE 1
### set CLKOUT0_DIVIDE_F 9.5
### } elseif {[string compare $clock_recipe_hbm "H2"] == 0} {
### set CLKFBOUT_MULT_F 11.250
### set DIVCLK_DIVIDE 1
### set CLKOUT0_DIVIDE_F 2.5
### } elseif {[string compare $clock_recipe_hbm "H3"] == 0} {
### set CLKFBOUT_MULT_F 12
### set DIVCLK_DIVIDE 1
### set CLKOUT0_DIVIDE_F 4
### } elseif {[string compare $clock_recipe_hbm "H4"] == 0} {
### set CLKFBOUT_MULT_F 12
### set DIVCLK_DIVIDE 1
### set CLKOUT0_DIVIDE_F 3
### } else { #H0
### set CLKFBOUT_MULT_F 12.5
### set DIVCLK_DIVIDE 1
### set CLKOUT0_DIVIDE_F 5
### }
### proc_set_mmcm $GRP_H_MMCM $CLKFBOUT_MULT_F $DIVCLK_DIVIDE $CLKOUT0_DIVIDE_F $CLKOUT1_DIVIDE

CRITICAL WARNING: WRAPPER/CL/AWS_CLK_GEN/CLK_HBM_EN_I.CLK_MMCM_HBM_I/inst/CLK_CORE_DRP_I/clk_inst/mmcme4_adv_inst cell not found. Clock recipe for this MMCM not applied.

### puts "INFO: aws_clock_properties.tcl successfully applied clock recipes to MMCMs"
INFO: aws_clock_properties.tcl successfully applied clock recipes to MMCMs
## read_xdc ${HDK_SHELL_DIR}/build/constraints/${SHELL_MODE}_level_1_fp_cl.xdc
Parsing XDC File [/home/ubuntu/src/aws-fpga/hdk/common/shell_stable/build/constraints/small_shell_level_1_fp_cl.xdc]
CRITICAL WARNING: [Vivado 12-795] Pblock 'pblock_CL' already exists. [/home/ubuntu/src/aws-fpga/hdk/common/shell_stable/build/constraints/small_shell_level_1_fp_cl.xdc:28]
Finished Parsing XDC File [/home/ubuntu/src/aws-fpga/hdk/common/shell_stable/build/constraints/small_shell_level_1_fp_cl.xdc]
read_xdc: Time (s): cpu = 00:01:39 ; elapsed = 00:01:40 . Memory (MB): peak = 4400.500 ; gain = 0.000 ; free physical = 121074 ; free virtual = 133368
## read_xdc ${constraints_dir}/${SHELL_MODE}_cl_pnr_user.xdc
Parsing XDC File [/home/ubuntu/src/aws-fpga/hdk/cl/examples/top/build/constraints/small_shell_cl_pnr_user.xdc]
Finished Parsing XDC File [/home/ubuntu/src/aws-fpga/hdk/cl/examples/top/build/constraints/small_shell_cl_pnr_user.xdc]
## source ${HDK_SHELL_DIR}/build/scripts/ddr_io_train.tcl
WARNING: [Vivado 12-180] No cells matched 'WRAPPER/CL/SH_DDR/genblk1.IS_DDR_PRESENT.DDR4_0'.
### set DDR_CELL [get_cells WRAPPER/CL/SH_DDR/genblk1.IS_DDR_PRESENT.DDR4_0]
### if {$DDR_CELL != ""} {
### set_property MIG_FLOORPLAN_MODE FULL [get_cells WRAPPER/CL/SH_DDR/genblk1.IS_DDR_PRESENT.DDR4_0]
### } else {
### print "Skipped ddr_io_train.tcl. No DDR Core in the design"
### }

AWS FPGA: (12:17:56): Skipped ddr_io_train.tcl. No DDR Core in the design

## print "Start optimizing customer design ${CL}"

AWS FPGA: (12:17:56): Start optimizing customer design top

## opt_design
Command: opt_design
Attempting to get a license for feature 'Implementation' and/or device 'xcvu47p'
INFO: [Common 17-349] Got license for feature 'Implementation' and/or device 'xcvu47p'
Running DRC as a precondition to command opt_design

Starting DRC Task
INFO: [DRC 23-27] Running DRC with 8 threads
INFO: [Project 1-461] DRC finished with 0 Errors
INFO: [Project 1-462] Please refer to the DRC report (report_drc) for more information.

Time (s): cpu = 00:00:07 ; elapsed = 00:00:05 . Memory (MB): peak = 4545.660 ; gain = 145.160 ; free physical = 120952 ; free virtual = 133256

Starting Cache Timing Information Task
Ending Cache Timing Information Task | Checksum: 1ef1b848d

Time (s): cpu = 00:00:00.57 ; elapsed = 00:00:00.19 . Memory (MB): peak = 4545.660 ; gain = 0.000 ; free physical = 120952 ; free virtual = 133256

Starting Logic Optimization Task

Phase 1 Initialization

Phase 1.1 Core Generation And Design Setup
Phase 1.1 Core Generation And Design Setup | Checksum: 1ef1b848d

Time (s): cpu = 00:00:00.51 ; elapsed = 00:00:00.49 . Memory (MB): peak = 4657.520 ; gain = 0.000 ; free physical = 120798 ; free virtual = 133103

Phase 1.2 Setup Constraints And Sort Netlist
Phase 1.2 Setup Constraints And Sort Netlist | Checksum: 1ef1b848d

Time (s): cpu = 00:00:00.58 ; elapsed = 00:00:00.55 . Memory (MB): peak = 4657.520 ; gain = 0.000 ; free physical = 120795 ; free virtual = 133100
Phase 1 Initialization | Checksum: 1ef1b848d

Time (s): cpu = 00:00:00.63 ; elapsed = 00:00:00.59 . Memory (MB): peak = 4657.520 ; gain = 0.000 ; free physical = 120789 ; free virtual = 133094

Phase 2 Timer Update And Timing Data Collection

Phase 2.1 Timer Update
Phase 2.1 Timer Update | Checksum: 1ef1b848d

Time (s): cpu = 00:00:01 ; elapsed = 00:00:00.85 . Memory (MB): peak = 4657.520 ; gain = 0.000 ; free physical = 120770 ; free virtual = 133074

Phase 2.2 Timing Data Collection
Phase 2.2 Timing Data Collection | Checksum: 1ef1b848d

Time (s): cpu = 00:00:01 ; elapsed = 00:00:00.92 . Memory (MB): peak = 4657.520 ; gain = 0.000 ; free physical = 120793 ; free virtual = 133097
Phase 2 Timer Update And Timing Data Collection | Checksum: 1ef1b848d

Time (s): cpu = 00:00:02 ; elapsed = 00:00:00.96 . Memory (MB): peak = 4657.520 ; gain = 0.000 ; free physical = 120793 ; free virtual = 133097

Phase 3 Retarget
INFO: [Opt 31-1834] Total Chains To Be Transformed Were: 0 AND Number of Transformed insts Created are: 0
INFO: [Opt 31-1566] Pulled 1 inverters resulting in an inversion of 9 pins
INFO: [Opt 31-138] Pushed 6 inverter(s) to 211 load pin(s).
INFO: [Opt 31-49] Retargeted 0 cell(s).
Phase 3 Retarget | Checksum: 2c4e16196

Time (s): cpu = 00:00:02 ; elapsed = 00:00:01 . Memory (MB): peak = 4657.520 ; gain = 0.000 ; free physical = 120793 ; free virtual = 133098
Retarget | Checksum: 2c4e16196
INFO: [Opt 31-389] Phase Retarget created 2 cells and removed 8 cells
INFO: [Opt 31-1021] In phase Retarget, 2223 netlist objects are constrained preventing optimization. Please run opt_design with -debug_log to get more detail.

Phase 4 Constant propagation
INFO: [Opt 31-138] Pushed 0 inverter(s) to 0 load pin(s).
Phase 4 Constant propagation | Checksum: 1e3165c25

Time (s): cpu = 00:00:02 ; elapsed = 00:00:02 . Memory (MB): peak = 4657.520 ; gain = 0.000 ; free physical = 120793 ; free virtual = 133098
Constant propagation | Checksum: 1e3165c25
INFO: [Opt 31-389] Phase Constant propagation created 10 cells and removed 12 cells
INFO: [Opt 31-1021] In phase Constant propagation, 5328 netlist objects are constrained preventing optimization. Please run opt_design with -debug_log to get more detail.

Phase 5 Sweep
Phase 5 Sweep | Checksum: 240aa80f4

Time (s): cpu = 00:00:03 ; elapsed = 00:00:02 . Memory (MB): peak = 4657.520 ; gain = 0.000 ; free physical = 120793 ; free virtual = 133098
Sweep | Checksum: 240aa80f4
INFO: [Opt 31-389] Phase Sweep created 0 cells and removed 121 cells
INFO: [Opt 31-1021] In phase Sweep, 80152 netlist objects are constrained preventing optimization. Please run opt_design with -debug_log to get more detail.

Phase 6 BUFG optimization
INFO: [Opt 31-1077] Phase BUFG optimization inserted 0 global clock buffer(s) for CLOCK_LOW_FANOUT.
Phase 6 BUFG optimization | Checksum: 240aa80f4

Time (s): cpu = 00:00:03 ; elapsed = 00:00:02 . Memory (MB): peak = 4657.520 ; gain = 0.000 ; free physical = 120793 ; free virtual = 133097
BUFG optimization | Checksum: 240aa80f4
INFO: [Opt 31-662] Phase BUFG optimization created 0 cells of which 0 are BUFGs and removed 0 cells.
INFO: [Opt 31-1021] In phase BUFG optimization, 27 netlist objects are constrained preventing optimization. Please run opt_design with -debug_log to get more detail.

Phase 7 Shift Register Optimization
INFO: [Opt 31-1064] SRL Remap converted 0 SRLs to 0 registers and converted 0 registers of register chains to 0 SRLs
Phase 7 Shift Register Optimization | Checksum: 240aa80f4

Time (s): cpu = 00:00:03 ; elapsed = 00:00:02 . Memory (MB): peak = 4657.520 ; gain = 0.000 ; free physical = 120793 ; free virtual = 133097
Shift Register Optimization | Checksum: 240aa80f4
INFO: [Opt 31-389] Phase Shift Register Optimization created 0 cells and removed 0 cells

Phase 8 Post Processing Netlist
Phase 8 Post Processing Netlist | Checksum: 240aa80f4

Time (s): cpu = 00:00:04 ; elapsed = 00:00:03 . Memory (MB): peak = 4657.520 ; gain = 0.000 ; free physical = 120793 ; free virtual = 133097
Post Processing Netlist | Checksum: 240aa80f4
INFO: [Opt 31-389] Phase Post Processing Netlist created 0 cells and removed 0 cells
INFO: [Opt 31-1021] In phase Post Processing Netlist, 3578 netlist objects are constrained preventing optimization. Please run opt_design with -debug_log to get more detail.

Phase 9 Finalization

Phase 9.1 Finalizing Design Cores and Updating Shapes
Phase 9.1 Finalizing Design Cores and Updating Shapes | Checksum: 18a9c40b0

Time (s): cpu = 00:00:04 ; elapsed = 00:00:03 . Memory (MB): peak = 4657.520 ; gain = 0.000 ; free physical = 120793 ; free virtual = 133097

Phase 9.2 Verifying Netlist Connectivity

Starting Connectivity Check Task

Time (s): cpu = 00:00:00.03 ; elapsed = 00:00:00.03 . Memory (MB): peak = 4657.520 ; gain = 0.000 ; free physical = 120793 ; free virtual = 133097
Phase 9.2 Verifying Netlist Connectivity | Checksum: 18a9c40b0

Time (s): cpu = 00:00:05 ; elapsed = 00:00:04 . Memory (MB): peak = 4657.520 ; gain = 0.000 ; free physical = 120793 ; free virtual = 133097
Phase 9 Finalization | Checksum: 18a9c40b0

Time (s): cpu = 00:00:05 ; elapsed = 00:00:04 . Memory (MB): peak = 4657.520 ; gain = 0.000 ; free physical = 120793 ; free virtual = 133097
Opt_design Change Summary
=========================

-------------------------------------------------------------------------------------------------------------------------
| Phase | #Cells created | #Cells Removed | #Constrained objects preventing optimizations |
-------------------------------------------------------------------------------------------------------------------------
| Retarget | 2 | 8 | 2223 |
| Constant propagation | 10 | 12 | 5328 |
| Sweep | 0 | 121 | 80152 |
| BUFG optimization | 0 | 0 | 27 |
| Shift Register Optimization | 0 | 0 | 0 |
| Post Processing Netlist | 0 | 0 | 3578 |
-------------------------------------------------------------------------------------------------------------------------

Ending Logic Optimization Task | Checksum: 18a9c40b0

Time (s): cpu = 00:00:05 ; elapsed = 00:00:04 . Memory (MB): peak = 4657.520 ; gain = 0.000 ; free physical = 120793 ; free virtual = 133097

Starting Power Optimization Task
INFO: [Pwropt 34-132] Skipping clock gating for clocks with a period < 2.00 ns.
INFO: [Pwropt 34-232] Skipping BRAM gating because all BRAMs are in high frequency (i.e. period < 3.12 ns) clock domains.
INFO: [Pwropt 34-162] WRITE_MODE attribute of 0 BRAM(s) out of a total of 2 has been updated to save power. Run report_power_opt to get a complete listing of the BRAMs updated.
Ending Power Optimization Task | Checksum: 18a9c40b0

Time (s): cpu = 00:00:00.32 ; elapsed = 00:00:01 . Memory (MB): peak = 4721.520 ; gain = 64.000 ; free physical = 120754 ; free virtual = 133062

Starting Final Cleanup Task
Ending Final Cleanup Task | Checksum: 18a9c40b0

Time (s): cpu = 00:00:00.05 ; elapsed = 00:00:00.04 . Memory (MB): peak = 4721.520 ; gain = 0.000 ; free physical = 120754 ; free virtual = 133062

Starting Netlist Obfuscation Task
Netlist sorting complete. Time (s): cpu = 00:00:00.02 ; elapsed = 00:00:00.02 . Memory (MB): peak = 4721.520 ; gain = 0.000 ; free physical = 120754 ; free virtual = 133062
Ending Netlist Obfuscation Task | Checksum: 18a9c40b0

Time (s): cpu = 00:00:00.06 ; elapsed = 00:00:00.05 . Memory (MB): peak = 4721.520 ; gain = 0.000 ; free physical = 120754 ; free virtual = 133062
INFO: [Common 17-83] Releasing license: Implementation
26 Infos, 0 Warnings, 0 Critical Warnings and 0 Errors encountered.
opt_design completed successfully
opt_design: Time (s): cpu = 00:00:14 ; elapsed = 00:00:12 . Memory (MB): peak = 4721.520 ; gain = 321.020 ; free physical = 120754 ; free virtual = 133062
## if {[llength [get_cells -quiet WRAPPER/CL/CL_HBM/HBM_PRESENT_EQ_1.HBM_WRAPPER_I/HBM_CORE_I/inst]] > 0} {
## puts "INFO: HBM found, setting DONT_TOUCH to 0"
## set_property DONT_TOUCH 0 [get_cells WRAPPER/CL/CL_HBM/HBM_PRESENT_EQ_1.HBM_WRAPPER_I/HBM_CORE_I/inst]
## }
## print "Writing post-opt design checkpoint and report"

AWS FPGA: (12:18:08): Writing post-opt design checkpoint and report

## write_checkpoint -force ${checkpoints_dir}/${CL}.${TAG}.post_opt.dcp
INFO: [Timing 38-480] Writing timing data to binary archive.
Write ShapeDB Complete: Time (s): cpu = 00:00:00.04 ; elapsed = 00:00:00.01 . Memory (MB): peak = 4729.523 ; gain = 0.000 ; free physical = 120748 ; free virtual = 133065
Wrote PlaceDB: Time (s): cpu = 00:00:01 ; elapsed = 00:00:00.38 . Memory (MB): peak = 4729.523 ; gain = 0.000 ; free physical = 120744 ; free virtual = 133081
Wrote PulsedLatchDB: Time (s): cpu = 00:00:00 ; elapsed = 00:00:00 . Memory (MB): peak = 4729.523 ; gain = 0.000 ; free physical = 120744 ; free virtual = 133081
Writing XDEF routing.
Writing XDEF routing logical nets.
Writing XDEF routing special nets.
Wrote RouteStorage: Time (s): cpu = 00:00:00.5 ; elapsed = 00:00:00.12 . Memory (MB): peak = 4729.523 ; gain = 0.000 ; free physical = 120739 ; free virtual = 133081
Wrote Netlist Cache: Time (s): cpu = 00:00:00.04 ; elapsed = 00:00:00.01 . Memory (MB): peak = 4729.523 ; gain = 0.000 ; free physical = 120738 ; free virtual = 133082
Wrote Device Cache: Time (s): cpu = 00:00:00.04 ; elapsed = 00:00:00.01 . Memory (MB): peak = 4729.523 ; gain = 0.000 ; free physical = 120737 ; free virtual = 133083
Write Physdb Complete: Time (s): cpu = 00:00:02 ; elapsed = 00:00:00.53 . Memory (MB): peak = 4729.523 ; gain = 0.000 ; free physical = 120737 ; free virtual = 133083
INFO: [Common 17-1381] The checkpoint '/home/ubuntu/src/aws-fpga/hdk/cl/examples/top/build/checkpoints/top.2026_10_10-121021.post_opt.dcp' has been generated.
## report_timing -delay_type max \
## -path_type full_clock_expanded \
## -max_paths 10 \
## -nworst 1 \
## -input_pins \
## -slice_pins \
## -sort_by group \
## -significant_digits 3 \
## -file ${reports_dir}/${CL}.${TAG}.post_opt_timing.rpt
INFO: [Timing 38-91] UpdateTimingParams: Speed grade: -2, Temperature grade: E, Delay Type: max.
INFO: [Timing 38-191] Multithreading enabled for timing update using a maximum of 8 CPUs
INFO: [Timing 38-35] Done setting XDC timing constraints.
INFO: [Timing 38-78] ReportTimingParams: -max_paths 10 -nworst 1 -delay_type max -sort_by group.
report_timing: Time (s): cpu = 00:00:24 ; elapsed = 00:00:45 . Memory (MB): peak = 5231.777 ; gain = 486.246 ; free physical = 120102 ; free virtual = 132555
## print "Start placing customer design ${CL}"

AWS FPGA: (12:18:56): Start placing customer design top

## place_design -directive $PLACE_DIRECT -no_bufg_opt
Command: place_design -directive SSI_SpreadLogic_high -no_bufg_opt
Attempting to get a license for feature 'Implementation' and/or device 'xcvu47p'
INFO: [Common 17-349] Got license for feature 'Implementation' and/or device 'xcvu47p'
INFO: [Common 17-83] Releasing license: Implementation
INFO: [DRC 23-27] Running DRC with 8 threads
INFO: [Vivado_Tcl 4-198] DRC finished with 0 Errors
INFO: [Vivado_Tcl 4-199] Please refer to the DRC report (report_drc) for more information.
INFO: [Vivado_Tcl 4-2302] The placer was invoked with the 'SSI_SpreadLogic_high' directive.
Running DRC as a precondition to command place_design
INFO: [DRC 23-27] Running DRC with 8 threads
INFO: [Vivado_Tcl 4-198] DRC finished with 0 Errors
INFO: [Vivado_Tcl 4-199] Please refer to the DRC report (report_drc) for more information.
INFO: [Place 30-611] Multithreading enabled for place_design using a maximum of 8 CPUs

Starting Placer Task

Phase 1 Placer Initialization

Phase 1.1 Placer Initialization Netlist Sorting
Netlist sorting complete. Time (s): cpu = 00:00:00.02 ; elapsed = 00:00:00.02 . Memory (MB): peak = 5263.793 ; gain = 0.000 ; free physical = 120083 ; free virtual = 132538
Phase 1.1 Placer Initialization Netlist Sorting | Checksum: 183453516

Time (s): cpu = 00:00:00.13 ; elapsed = 00:00:00.13 . Memory (MB): peak = 5263.793 ; gain = 0.000 ; free physical = 120083 ; free virtual = 132538
Netlist sorting complete. Time (s): cpu = 00:00:00.02 ; elapsed = 00:00:00.02 . Memory (MB): peak = 5263.793 ; gain = 0.000 ; free physical = 120083 ; free virtual = 132538
WARNING: [Constraints 18-5648] For reconfigurable module WRAPPER/CL, the top/bottom edges of its PBLOCK pblock_CL are aligned with clock regions. With this type of floorplan, it has limited routability at PBLOCK top/bottom edges due to routing containment requirement. The edge tiles (only listed 10) are CLEM_X112Y480 CLEL_R_X112Y480 CLEL_R_X113Y480 CLEM_X114Y480 CLEM_X115Y480 CLEL_R_X115Y480 CLEM_X117Y480 CLEL_R_X118Y480 CLEM_X119Y480 CLEM_X120Y480 : . Tool will infer PROHIBIT on those tiles to enhancement routability at the edges of PBLOCK. You may also make the PBLOCK not aligned to clock region at top/bottom edges as a solution. Please refer 'Design Consideration' in UG909 for guidelines.
INFO: [Constraints 18-12184] Site SLICE_X176Y480 is prohibited due to Sites belong to FSR edge tile CLEM_X112Y480 of Pblock pblock_CL
INFO: [Constraints 18-12184] Site SLICE_X177Y480 is prohibited due to Sites belong to FSR edge tile CLEL_R_X112Y480 of Pblock pblock_CL
INFO: [Constraints 18-12184] Site SLICE_X178Y480 is prohibited due to Sites belong to FSR edge tile CLEL_R_X113Y480 of Pblock pblock_CL
INFO: [Constraints 18-12184] Site SLICE_X179Y480 is prohibited due to Sites belong to FSR edge tile CLEM_X114Y480 of Pblock pblock_CL
INFO: [Constraints 18-12184] Site SLICE_X180Y480 is prohibited due to Sites belong to FSR edge tile CLEM_X115Y480 of Pblock pblock_CL
INFO: [Constraints 18-12184] Site SLICE_X181Y480 is prohibited due to Sites belong to FSR edge tile CLEL_R_X115Y480 of Pblock pblock_CL
INFO: [Constraints 18-12184] Site SLICE_X184Y480 is prohibited due to Sites belong to FSR edge tile CLEM_X117Y480 of Pblock pblock_CL
INFO: [Constraints 18-12184] Site SLICE_X185Y480 is prohibited due to Sites belong to FSR edge tile CLEL_R_X118Y480 of Pblock pblock_CL
INFO: [Constraints 18-12184] Site SLICE_X186Y480 is prohibited due to Sites belong to FSR edge tile CLEM_X119Y480 of Pblock pblock_CL
INFO: [Constraints 18-12184] Site SLICE_X187Y480 is prohibited due to Sites belong to FSR edge tile CLEM_X120Y480 of Pblock pblock_CL
INFO: [Constraints 18-12184] Site SLICE_X188Y480 is prohibited due to Sites belong to FSR edge tile CLEL_R_X120Y480 of Pblock pblock_CL
INFO: [Constraints 18-12184] Site SLICE_X189Y480 is prohibited due to Sites belong to FSR edge tile CLEL_L_X121Y480 of Pblock pblock_CL
INFO: [Constraints 18-12184] Site SLICE_X190Y480 is prohibited due to Sites belong to FSR edge tile CLEL_R_X121Y480 of Pblock pblock_CL
INFO: [Constraints 18-12184] Site SLICE_X191Y480 is prohibited due to Sites belong to FSR edge tile CLEM_X122Y480 of Pblock pblock_CL
INFO: [Constraints 18-12184] Site SLICE_X192Y480 is prohibited due to Sites belong to FSR edge tile CLEM_X123Y480 of Pblock pblock_CL
INFO: [Constraints 18-12184] Site SLICE_X193Y480 is prohibited due to Sites belong to FSR edge tile CLEL_R_X123Y480 of Pblock pblock_CL
INFO: [Constraints 18-12184] Site SLICE_X196Y480 is prohibited due to Sites belong to FSR edge tile CLEM_X125Y480 of Pblock pblock_CL
INFO: [Constraints 18-12184] Site SLICE_X197Y480 is prohibited due to Sites belong to FSR edge tile CLEM_X126Y480 of Pblock pblock_CL
INFO: [Constraints 18-12184] Site SLICE_X198Y480 is prohibited due to Sites belong to FSR edge tile CLEL_R_X126Y480 of Pblock pblock_CL
INFO: [Constraints 18-12184] Site SLICE_X199Y480 is prohibited due to Sites belong to FSR edge tile CLEL_L_X127Y480 of Pblock pblock_CL
INFO: [Constraints 18-12184] Site SLICE_X200Y480 is prohibited due to Sites belong to FSR edge tile CLEL_R_X127Y480 of Pblock pblock_CL
INFO: [Constraints 18-12184] Site SLICE_X201Y480 is prohibited due to Sites belong to FSR edge tile CLEM_X128Y480 of Pblock pblock_CL
INFO: [Constraints 18-12184] Site SLICE_X202Y480 is prohibited due to Sites belong to FSR edge tile CLEL_R_X128Y480 of Pblock pblock_CL
INFO: [Constraints 18-12184] Site SLICE_X203Y480 is prohibited due to Sites belong to FSR edge tile CLEL_L_X129Y480 of Pblock pblock_CL
INFO: [Constraints 18-12184] Site SLICE_X204Y480 is prohibited due to Sites belong to FSR edge tile CLEL_R_X129Y480 of Pblock pblock_CL
INFO: [Constraints 18-12184] Site SLICE_X205Y480 is prohibited due to Sites belong to FSR edge tile CLEM_X130Y480 of Pblock pblock_CL
INFO: [Constraints 18-12184] Site SLICE_X206Y480 is prohibited due to Sites belong to FSR edge tile CLEM_X131Y480 of Pblock pblock_CL
INFO: [Constraints 18-12184] Site SLICE_X207Y480 is prohibited due to Sites belong to FSR edge tile CLEL_R_X131Y480 of Pblock pblock_CL
INFO: [Constraints 18-12184] Site SLICE_X208Y480 is prohibited due to Sites belong to FSR edge tile CLEM_X132Y480 of Pblock pblock_CL
INFO: [Constraints 18-12184] Site SLICE_X209Y480 is prohibited due to Sites belong to FSR edge tile CLEL_R_X132Y480 of Pblock pblock_CL
INFO: [Constraints 18-12184] Site SLICE_X210Y480 is prohibited due to Sites belong to FSR edge tile CLEM_X133Y480 of Pblock pblock_CL
INFO: [Constraints 18-12184] Site SLICE_X211Y480 is prohibited due to Sites belong to FSR edge tile CLEL_R_X133Y480 of Pblock pblock_CL
INFO: [Constraints 18-12184] Site SLICE_X212Y480 is prohibited due to Sites belong to FSR edge tile CLEM_X134Y480 of Pblock pblock_CL
INFO: [Constraints 18-12184] Site SLICE_X213Y480 is prohibited due to Sites belong to FSR edge tile CLEL_R_X134Y480 of Pblock pblock_CL
INFO: [Constraints 18-12184] Site SLICE_X216Y480 is prohibited due to Sites belong to FSR edge tile CLEM_X136Y480 of Pblock pblock_CL
INFO: [Constraints 18-12184] Site SLICE_X217Y480 is prohibited due to Sites belong to FSR edge tile CLEM_X137Y480 of Pblock pblock_CL
INFO: [Constraints 18-12184] Site SLICE_X218Y480 is prohibited due to Sites belong to FSR edge tile CLEL_R_X137Y480 of Pblock pblock_CL
INFO: [Constraints 18-12184] Site SLICE_X219Y480 is prohibited due to Sites belong to FSR edge tile CLEL_R_X138Y480 of Pblock pblock_CL
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
INFO: [Constraints 18-12184] Site SLICE_X218Y119 is prohibited due to Sites belong to FSR edge tile CLEL_R_X137Y119 of Pblock pblock_CL
INFO: [Constraints 18-12184] Site SLICE_X219Y119 is prohibited due to Sites belong to FSR edge tile CLEL_R_X138Y119 of Pblock pblock_CL
INFO: [Constraints 18-12184] Site SLICE_X221Y119 is prohibited due to Sites belong to FSR edge tile CLEL_R_X140Y119 of Pblock pblock_CL
INFO: [Constraints 18-12184] Site SLICE_X222Y119 is prohibited due to Sites belong to FSR edge tile CLEM_R_X141Y119 of Pblock pblock_CL
INFO: [Constraints 18-12184] Site SLICE_X223Y119 is prohibited due to Sites belong to FSR edge tile CLEL_R_X141Y119 of Pblock pblock_CL
INFO: [Constraints 18-12184] Site SLICE_X224Y119 is prohibited due to Sites belong to FSR edge tile CLEL_R_X142Y119 of Pblock pblock_CL
INFO: [Constraints 18-12184] Site SLICE_X225Y119 is prohibited due to Sites belong to FSR edge tile CLEM_R_X143Y119 of Pblock pblock_CL
INFO: [Constraints 18-12184] Site SLICE_X226Y119 is prohibited due to Sites belong to FSR edge tile CLEL_R_X143Y119 of Pblock pblock_CL
INFO: [Constraints 18-12184] Site SLICE_X227Y119 is prohibited due to Sites belong to FSR edge tile CLEM_R_X144Y119 of Pblock pblock_CL
INFO: [Common 17-14] Message 'Constraints 18-12184' appears 100 times and further instances of the messages will be disabled. Use the Tcl command set_msg_config to change the current settings.

Phase 1.2 IO Placement/ Clock Placement/ Build Placer Device
Phase 1.2 IO Placement/ Clock Placement/ Build Placer Device | Checksum: 254747221

Time (s): cpu = 00:01:41 ; elapsed = 00:01:41 . Memory (MB): peak = 5263.793 ; gain = 0.000 ; free physical = 120099 ; free virtual = 132559

Phase 1.3 Build Placer Netlist Model
Phase 1.3 Build Placer Netlist Model | Checksum: 28f03de90

Time (s): cpu = 00:01:51 ; elapsed = 00:01:48 . Memory (MB): peak = 5660.641 ; gain = 396.848 ; free physical = 119656 ; free virtual = 132118

Phase 1.4 Constrain Clocks/Macros
Phase 1.4 Constrain Clocks/Macros | Checksum: 28f03de90

Time (s): cpu = 00:01:51 ; elapsed = 00:01:48 . Memory (MB): peak = 5660.641 ; gain = 396.848 ; free physical = 119656 ; free virtual = 132118
Phase 1 Placer Initialization | Checksum: 28f03de90

Time (s): cpu = 00:01:52 ; elapsed = 00:01:49 . Memory (MB): peak = 5660.641 ; gain = 396.848 ; free physical = 119656 ; free virtual = 132118

Phase 2 Global Placement

Phase 2.1 Floorplanning

Phase 2.1.1 Partition Driven Placement

Phase 2.1.1.1 PBP: Partition Driven Placement
Phase 2.1.1.1 PBP: Partition Driven Placement | Checksum: 3059ea8d1

Time (s): cpu = 00:01:56 ; elapsed = 00:01:51 . Memory (MB): peak = 5660.641 ; gain = 396.848 ; free physical = 119647 ; free virtual = 132111

Phase 2.1.1.2 PBP: Clock Region Placement
Phase 2.1.1.2 PBP: Clock Region Placement | Checksum: 264d1c467

Time (s): cpu = 00:02:06 ; elapsed = 00:02:02 . Memory (MB): peak = 5660.641 ; gain = 396.848 ; free physical = 119619 ; free virtual = 132083

Phase 2.1.1.3 PBP: Compute Congestion
Phase 2.1.1.3 PBP: Compute Congestion | Checksum: 264d1c467

Time (s): cpu = 00:02:27 ; elapsed = 00:02:31 . Memory (MB): peak = 6053.625 ; gain = 789.832 ; free physical = 118763 ; free virtual = 131655

Phase 2.1.1.4 PBP: UpdateTiming
Phase 2.1.1.4 PBP: UpdateTiming | Checksum: 2126ead93

Time (s): cpu = 00:02:28 ; elapsed = 00:02:31 . Memory (MB): peak = 6085.641 ; gain = 821.848 ; free physical = 118790 ; free virtual = 131682

Phase 2.1.1.5 PBP: Add part constraints
Phase 2.1.1.5 PBP: Add part constraints | Checksum: 2126ead93

Time (s): cpu = 00:02:28 ; elapsed = 00:02:31 . Memory (MB): peak = 6085.641 ; gain = 821.848 ; free physical = 118790 ; free virtual = 131682
Phase 2.1.1 Partition Driven Placement | Checksum: 2126ead93

Time (s): cpu = 00:02:28 ; elapsed = 00:02:31 . Memory (MB): peak = 6085.641 ; gain = 821.848 ; free physical = 118790 ; free virtual = 131682
Phase 2.1 Floorplanning | Checksum: 2bb21388b

Time (s): cpu = 00:02:28 ; elapsed = 00:02:31 . Memory (MB): peak = 6085.641 ; gain = 821.848 ; free physical = 118790 ; free virtual = 131682

Phase 2.2 Physical Synthesis After Floorplan
INFO: [Physopt 32-775] End 1 Pass. Optimized 0 net or cell. Created 0 new cell, deleted 0 existing cell and moved 0 existing cell
Netlist sorting complete. Time (s): cpu = 00:00:00.02 ; elapsed = 00:00:00.02 . Memory (MB): peak = 6085.641 ; gain = 0.000 ; free physical = 118789 ; free virtual = 131682

Summary of Physical Synthesis Optimizations
============================================

-----------------------------------------------------------------------------------------------------------------------------------------------
| Optimization | Added Cells | Removed Cells | Optimized Cells/Nets | Dont Touch | Iterations | Elapsed |
-----------------------------------------------------------------------------------------------------------------------------------------------
| PSIP Post Floorplan SLR Replication | 0 | 0 | 0 | 0 | 1 | 00:00:00 |
| Total | 0 | 0 | 0 | 0 | 1 | 00:00:00 |
-----------------------------------------------------------------------------------------------------------------------------------------------

Phase 2.2 Physical Synthesis After Floorplan | Checksum: 2bb21388b

Time (s): cpu = 00:02:28 ; elapsed = 00:02:32 . Memory (MB): peak = 6085.641 ; gain = 821.848 ; free physical = 118789 ; free virtual = 131682

Phase 2.3 Update Timing before SLR Path Opt
Phase 2.3 Update Timing before SLR Path Opt | Checksum: 26f6c9dea

Time (s): cpu = 00:02:28 ; elapsed = 00:02:32 . Memory (MB): peak = 6085.641 ; gain = 821.848 ; free physical = 118788 ; free virtual = 131682

Phase 2.4 Post-Processing in Floorplanning
Phase 2.4 Post-Processing in Floorplanning | Checksum: 2ba8913d6

Time (s): cpu = 00:02:28 ; elapsed = 00:02:32 . Memory (MB): peak = 6085.641 ; gain = 821.848 ; free physical = 118788 ; free virtual = 131682

Phase 2.5 Global Placement Core

Phase 2.5.1 UpdateTiming Before Physical Synthesis
Phase 2.5.1 UpdateTiming Before Physical Synthesis | Checksum: 2732e2808

Time (s): cpu = 00:05:06 ; elapsed = 00:03:33 . Memory (MB): peak = 6649.680 ; gain = 1385.887 ; free physical = 118263 ; free virtual = 131157

Phase 2.5.2 Physical Synthesis In Placer
INFO: [Physopt 32-1035] Found 41 LUTNM shape to break, 238 LUT instances to create LUTNM shape
INFO: [Physopt 32-1044] Break lutnm for timing: one critical 0, two critical 41, total 40, new lutff created 0
INFO: [Physopt 32-1138] End 1 Pass. Optimized 148 nets or LUTs. Breaked 40 LUTs, combined 108 existing LUTs and moved 0 existing LUT
INFO: [Physopt 32-1030] Pass 1. Identified 12 candidate driver sets for equivalent driver rewiring.
INFO: [Physopt 32-661] Optimized 0 net. Re-placed 0 instance.
INFO: [Physopt 32-775] End 1 Pass. Optimized 0 net or cell. Created 0 new cell, deleted 0 existing cell and moved 0 existing cell
INFO: [Physopt 32-65] No nets found for high-fanout optimization.
INFO: [Physopt 32-232] Optimized 0 net. Created 0 new instance.
INFO: [Physopt 32-775] End 1 Pass. Optimized 0 net or cell. Created 0 new cell, deleted 0 existing cell and moved 0 existing cell
INFO: [Physopt 32-456] No candidate cells for DSP register optimization found in the design.
INFO: [Physopt 32-775] End 2 Pass. Optimized 0 net or cell. Created 0 new cell, deleted 0 existing cell and moved 0 existing cell
INFO: [Physopt 32-1123] No candidate cells found for Shift Register to Pipeline optimization
INFO: [Physopt 32-775] End 2 Pass. Optimized 0 net or cell. Created 0 new cell, deleted 0 existing cell and moved 0 existing cell
INFO: [Physopt 32-1401] No candidate cells found for Shift Register optimization.
INFO: [Physopt 32-677] No candidate cells for Shift Register optimization found in the design
INFO: [Physopt 32-775] End 1 Pass. Optimized 0 net or cell. Created 0 new cell, deleted 0 existing cell and moved 0 existing cell
INFO: [Physopt 32-526] No candidate cells for BRAM register optimization found in the design
INFO: [Physopt 32-775] End 1 Pass. Optimized 0 net or cell. Created 0 new cell, deleted 0 existing cell and moved 0 existing cell
INFO: [Physopt 32-846] No candidate cells for URAM register optimization found in the design
INFO: [Physopt 32-775] End 1 Pass. Optimized 0 net or cell. Created 0 new cell, deleted 0 existing cell and moved 0 existing cell
INFO: [Physopt 32-846] No candidate cells for URAM register optimization found in the design
INFO: [Physopt 32-775] End 1 Pass. Optimized 0 net or cell. Created 0 new cell, deleted 0 existing cell and moved 0 existing cell
INFO: [Physopt 32-949] No candidate nets found for dynamic/static region interface net replication
INFO: [Physopt 32-775] End 1 Pass. Optimized 0 net or cell. Created 0 new cell, deleted 0 existing cell and moved 0 existing cell
Netlist sorting complete. Time (s): cpu = 00:00:00.02 ; elapsed = 00:00:00.02 . Memory (MB): peak = 6649.680 ; gain = 0.000 ; free physical = 118263 ; free virtual = 131157

Summary of Physical Synthesis Optimizations
============================================

-----------------------------------------------------------------------------------------------------------------------------------------------------------
| Optimization | Added Cells | Removed Cells | Optimized Cells/Nets | Dont Touch | Iterations | Elapsed |
-----------------------------------------------------------------------------------------------------------------------------------------------------------
| LUT Combining | 40 | 108 | 148 | 0 | 1 | 00:00:00 |
| Retime | 0 | 0 | 0 | 0 | 1 | 00:00:00 |
| Equivalent Driver Rewiring | 0 | 0 | 0 | 0 | 1 | 00:00:00 |
| Very High Fanout | 0 | 0 | 0 | 0 | 1 | 00:00:00 |
| DSP Register | 0 | 0 | 0 | 0 | 1 | 00:00:00 |
| Shift Register to Pipeline | 0 | 0 | 0 | 0 | 1 | 00:00:00 |
| Shift Register | 0 | 0 | 0 | 0 | 1 | 00:00:00 |
| BRAM Register | 0 | 0 | 0 | 0 | 1 | 00:00:00 |
| URAM Register | 0 | 0 | 0 | 0 | 1 | 00:00:00 |
| Dynamic/Static Region Interface Net Replication | 0 | 0 | 0 | 0 | 1 | 00:00:00 |
| Total | 40 | 108 | 148 | 0 | 10 | 00:00:01 |
-----------------------------------------------------------------------------------------------------------------------------------------------------------

Phase 2.5.2 Physical Synthesis In Placer | Checksum: 2e2286ec3

Time (s): cpu = 00:05:08 ; elapsed = 00:03:34 . Memory (MB): peak = 6649.680 ; gain = 1385.887 ; free physical = 118262 ; free virtual = 131157
Phase 2.5 Global Placement Core | Checksum: 2e76aed24

Time (s): cpu = 00:05:59 ; elapsed = 00:03:51 . Memory (MB): peak = 6649.680 ; gain = 1385.887 ; free physical = 118288 ; free virtual = 131182
Phase 2 Global Placement | Checksum: 2e76aed24

Time (s): cpu = 00:05:59 ; elapsed = 00:03:51 . Memory (MB): peak = 6649.680 ; gain = 1385.887 ; free physical = 118288 ; free virtual = 131182

Phase 3 Detail Placement

Phase 3.1 Commit Multi Column Macros
Phase 3.1 Commit Multi Column Macros | Checksum: 2daf734de

Time (s): cpu = 00:06:23 ; elapsed = 00:03:58 . Memory (MB): peak = 6649.680 ; gain = 1385.887 ; free physical = 118295 ; free virtual = 131190

Phase 3.2 Commit Most Macros & LUTRAMs
Phase 3.2 Commit Most Macros & LUTRAMs | Checksum: 2cec43a5e

Time (s): cpu = 00:06:24 ; elapsed = 00:03:59 . Memory (MB): peak = 6649.680 ; gain = 1385.887 ; free physical = 118295 ; free virtual = 131190

Phase 3.3 Small Shape DP

Phase 3.3.1 Small Shape Clustering
Phase 3.3.1 Small Shape Clustering | Checksum: 1f8c5f24b

Time (s): cpu = 00:06:54 ; elapsed = 00:04:09 . Memory (MB): peak = 6649.680 ; gain = 1385.887 ; free physical = 118271 ; free virtual = 131166

Phase 3.3.2 Slice Area Swap

Phase 3.3.2.1 Slice Area Swap Initial
Phase 3.3.2.1 Slice Area Swap Initial | Checksum: 220c2a719

Time (s): cpu = 00:06:55 ; elapsed = 00:04:10 . Memory (MB): peak = 6649.680 ; gain = 1385.887 ; free physical = 118311 ; free virtual = 131206
Phase 3.3.2 Slice Area Swap | Checksum: 1f58fb6f2

Time (s): cpu = 00:06:57 ; elapsed = 00:04:12 . Memory (MB): peak = 6649.680 ; gain = 1385.887 ; free physical = 118311 ; free virtual = 131206
Phase 3.3 Small Shape DP | Checksum: 303cd8cd3

Time (s): cpu = 00:06:58 ; elapsed = 00:04:12 . Memory (MB): peak = 6649.680 ; gain = 1385.887 ; free physical = 118311 ; free virtual = 131206

Phase 3.4 Re-assign LUT pins
Phase 3.4 Re-assign LUT pins | Checksum: 29b172b65

Time (s): cpu = 00:06:59 ; elapsed = 00:04:13 . Memory (MB): peak = 6649.680 ; gain = 1385.887 ; free physical = 118273 ; free virtual = 131169

Phase 3.5 Pipeline Register Optimization
Phase 3.5 Pipeline Register Optimization | Checksum: 29b172b65

Time (s): cpu = 00:07:00 ; elapsed = 00:04:13 . Memory (MB): peak = 6649.680 ; gain = 1385.887 ; free physical = 118302 ; free virtual = 131197

Phase 3.6 Fast Optimization
Phase 3.6 Fast Optimization | Checksum: 2cbee68e1

Time (s): cpu = 00:07:10 ; elapsed = 00:04:21 . Memory (MB): peak = 6649.680 ; gain = 1385.887 ; free physical = 118297 ; free virtual = 131192
Phase 3 Detail Placement | Checksum: 2cbee68e1

Time (s): cpu = 00:07:10 ; elapsed = 00:04:21 . Memory (MB): peak = 6649.680 ; gain = 1385.887 ; free physical = 118297 ; free virtual = 131192

Phase 4 Post Placement Optimization and Clean-Up

Phase 4.1 Post Commit Optimization
INFO: [Timing 38-35] Done setting XDC timing constraints.

Phase 4.1.1 Post Placement Optimization

Phase 4.1.1.1 BUFG Replication
INFO: [Place 46-63] BUFG replication identified 0 candidate nets: Replicated nets: 0, Replicated BUFGs: 0, Replicated BUFG Driver: 0, moved BUFGs: 0, Skipped due to Placement / Routing Conflict: 0, Skipped due to Timing: 0, Skipped due to constraints: 0
Phase 4.1.1.1 BUFG Replication | Checksum: 3793796f2

Time (s): cpu = 00:07:41 ; elapsed = 00:04:32 . Memory (MB): peak = 6649.680 ; gain = 1385.887 ; free physical = 118280 ; free virtual = 131175

Phase 4.1.1.2 Post Placement Timing Optimization
INFO: [Place 30-746] Post Placement Timing Summary WNS=0.138. For the most accurate timing information please run report_timing.
Phase 4.1.1.2 Post Placement Timing Optimization | Checksum: 2b86c8e5a

Time (s): cpu = 00:08:00 ; elapsed = 00:04:51 . Memory (MB): peak = 6649.680 ; gain = 1385.887 ; free physical = 118279 ; free virtual = 131174

Phase 4.1.1.3 Replication
INFO: [Place 46-19] Post Replication Timing Summary WNS=0.138. For the most accurate timing information please run report_timing.
Phase 4.1.1.3 Replication | Checksum: 2b86c8e5a

Time (s): cpu = 00:08:01 ; elapsed = 00:04:51 . Memory (MB): peak = 6649.680 ; gain = 1385.887 ; free physical = 118279 ; free virtual = 131174

Time (s): cpu = 00:08:01 ; elapsed = 00:04:51 . Memory (MB): peak = 6649.680 ; gain = 1385.887 ; free physical = 118279 ; free virtual = 131174
Phase 4.1 Post Commit Optimization | Checksum: 2b86c8e5a

Time (s): cpu = 00:08:01 ; elapsed = 00:04:52 . Memory (MB): peak = 6649.680 ; gain = 1385.887 ; free physical = 118279 ; free virtual = 131174
Netlist sorting complete. Time (s): cpu = 00:00:00.02 ; elapsed = 00:00:00.02 . Memory (MB): peak = 6730.895 ; gain = 0.000 ; free physical = 118171 ; free virtual = 131067

Phase 4.2 Post Placement Cleanup
Phase 4.2 Post Placement Cleanup | Checksum: 219679b44

Time (s): cpu = 00:08:43 ; elapsed = 00:05:17 . Memory (MB): peak = 6730.895 ; gain = 1467.102 ; free physical = 118199 ; free virtual = 131095

Phase 4.3 Placer Reporting

Phase 4.3.1 Print Estimated Congestion
INFO: [Place 30-612] Post-Placement Estimated Congestion
________________________________________________________________________
| | Global Congestion | Long Congestion | Short Congestion |
| Direction | Region Size | Region Size | Region Size |
|___________|___________________|___________________|___________________|
| North| 1x1| 1x1| 1x1|
|___________|___________________|___________________|___________________|
| South| 1x1| 1x1| 1x1|
|___________|___________________|___________________|___________________|
| East| 1x1| 1x1| 4x4|
|___________|___________________|___________________|___________________|
| West| 1x1| 1x1| 1x1|
|___________|___________________|___________________|___________________|

SLR0:
________________________________________________________________________
| | Global Congestion | Long Congestion | Short Congestion |
| Direction | Region Size | Region Size | Region Size |
|___________|___________________|___________________|___________________|
| North| 1x1| 1x1| 1x1|
|___________|___________________|___________________|___________________|
| South| 1x1| 1x1| 1x1|
|___________|___________________|___________________|___________________|
| East| 1x1| 1x1| 1x1|
|___________|___________________|___________________|___________________|
| West| 1x1| 1x1| 1x1|
|___________|___________________|___________________|___________________|

SLR1:
________________________________________________________________________
| | Global Congestion | Long Congestion | Short Congestion |
| Direction | Region Size | Region Size | Region Size |
|___________|___________________|___________________|___________________|
| North| 1x1| 1x1| 1x1|
|___________|___________________|___________________|___________________|
| South| 1x1| 1x1| 1x1|
|___________|___________________|___________________|___________________|
| East| 1x1| 1x1| 4x4|
|___________|___________________|___________________|___________________|
| West| 1x1| 1x1| 1x1|
|___________|___________________|___________________|___________________|

SLR2:
________________________________________________________________________
| | Global Congestion | Long Congestion | Short Congestion |
| Direction | Region Size | Region Size | Region Size |
|___________|___________________|___________________|___________________|
| North| 1x1| 1x1| 1x1|
|___________|___________________|___________________|___________________|
| South| 1x1| 1x1| 1x1|
|___________|___________________|___________________|___________________|
| East| 1x1| 1x1| 1x1|
|___________|___________________|___________________|___________________|
| West| 1x1| 1x1| 1x1|
|___________|___________________|___________________|___________________|

Phase 4.3.1 Print Estimated Congestion | Checksum: 219679b44

Time (s): cpu = 00:08:43 ; elapsed = 00:05:17 . Memory (MB): peak = 6730.895 ; gain = 1467.102 ; free physical = 118199 ; free virtual = 131095
Phase 4.3 Placer Reporting | Checksum: 219679b44

Time (s): cpu = 00:08:43 ; elapsed = 00:05:17 . Memory (MB): peak = 6730.895 ; gain = 1467.102 ; free physical = 118199 ; free virtual = 131095

Phase 4.4 Final Placement Cleanup
Netlist sorting complete. Time (s): cpu = 00:00:00.02 ; elapsed = 00:00:00.02 . Memory (MB): peak = 6730.895 ; gain = 0.000 ; free physical = 118199 ; free virtual = 131095

Time (s): cpu = 00:08:43 ; elapsed = 00:05:17 . Memory (MB): peak = 6730.895 ; gain = 1467.102 ; free physical = 118199 ; free virtual = 131095
Phase 4 Post Placement Optimization and Clean-Up | Checksum: 16623efdb

Time (s): cpu = 00:08:43 ; elapsed = 00:05:17 . Memory (MB): peak = 6730.895 ; gain = 1467.102 ; free physical = 118199 ; free virtual = 131095
Ending Placer Task | Checksum: 1127fa8de

Time (s): cpu = 00:08:43 ; elapsed = 00:05:17 . Memory (MB): peak = 6730.895 ; gain = 1467.102 ; free physical = 118199 ; free virtual = 131095
141 Infos, 1 Warnings, 0 Critical Warnings and 0 Errors encountered.
place_design completed successfully
place_design: Time (s): cpu = 00:08:56 ; elapsed = 00:05:24 . Memory (MB): peak = 6730.895 ; gain = 1499.117 ; free physical = 118199 ; free virtual = 131095
## print "Writing post-place design checkpoint and report"

AWS FPGA: (12:24:20): Writing post-place design checkpoint and report

## write_checkpoint -force ${checkpoints_dir}/${CL}.${TAG}.post_place.dcp
INFO: [Timing 38-480] Writing timing data to binary archive.
Write ShapeDB Complete: Time (s): cpu = 00:00:00.06 ; elapsed = 00:00:00.02 . Memory (MB): peak = 6730.895 ; gain = 0.000 ; free physical = 118195 ; free virtual = 131100
Wrote PlaceDB: Time (s): cpu = 00:00:03 ; elapsed = 00:00:00.86 . Memory (MB): peak = 6730.895 ; gain = 0.000 ; free physical = 118163 ; free virtual = 131108
Wrote PulsedLatchDB: Time (s): cpu = 00:00:00 ; elapsed = 00:00:00 . Memory (MB): peak = 6730.895 ; gain = 0.000 ; free physical = 118163 ; free virtual = 131108
Writing XDEF routing.
Writing XDEF routing logical nets.
Writing XDEF routing special nets.
Wrote RouteStorage: Time (s): cpu = 00:00:00.4 ; elapsed = 00:00:00.11 . Memory (MB): peak = 6730.895 ; gain = 0.000 ; free physical = 118162 ; free virtual = 131109
Wrote Netlist Cache: Time (s): cpu = 00:00:00.07 ; elapsed = 00:00:00.03 . Memory (MB): peak = 6730.895 ; gain = 0.000 ; free physical = 118159 ; free virtual = 131109
Wrote Device Cache: Time (s): cpu = 00:00:00.04 ; elapsed = 00:00:00.01 . Memory (MB): peak = 6730.895 ; gain = 0.000 ; free physical = 118157 ; free virtual = 131109
Write Physdb Complete: Time (s): cpu = 00:00:04 ; elapsed = 00:00:01 . Memory (MB): peak = 6730.895 ; gain = 0.000 ; free physical = 118157 ; free virtual = 131109
INFO: [Common 17-1381] The checkpoint '/home/ubuntu/src/aws-fpga/hdk/cl/examples/top/build/checkpoints/top.2026_10_10-121021.post_place.dcp' has been generated.
## report_timing -delay_type max \
## -path_type full_clock_expanded \
## -max_paths 10 \
## -nworst 1 \
## -input_pins \
## -slice_pins \
## -sort_by group \
## -significant_digits 3 \
## -file $reports_dir/${CL}.${TAG}.post_place_timing.rpt
INFO: [Timing 38-91] UpdateTimingParams: Speed grade: -2, Temperature grade: E, Delay Type: max.
INFO: [Timing 38-191] Multithreading enabled for timing update using a maximum of 8 CPUs
INFO: [Timing 38-78] ReportTimingParams: -max_paths 10 -nworst 1 -delay_type max -sort_by group.
## print "Start physical-optimizing customer design ${CL}"

AWS FPGA: (12:24:24): Start physical-optimizing customer design top

## phys_opt_design -directive $PHY_OPT_DIRECT
Command: phys_opt_design -directive AggressiveExplore
Attempting to get a license for feature 'Implementation' and/or device 'xcvu47p'
INFO: [Common 17-349] Got license for feature 'Implementation' and/or device 'xcvu47p'
INFO: [Vivado_Tcl 4-137] Directive used for phys_opt_design is: AggressiveExplore
INFO: [Vivado_Tcl 4-2280] Estimated Timing Summary | WNS= 0.138 | TNS= 0.000 | WHS= -3.125 |
INFO: [Vivado_Tcl 4-383] Design worst setup slack (WNS) is greater than or equal to 0.000 ns. All physical synthesis setup optimizations will be skipped.
INFO: [Vivado_Tcl 4-1435] PhysOpt_Tcl_Interface Runtime Before Starting Physical Synthesis Task | CPU: 0.62s | WALL: 0.21s
Netlist sorting complete. Time (s): cpu = 00:00:00.03 ; elapsed = 00:00:00.02 . Memory (MB): peak = 6730.895 ; gain = 0.000 ; free physical = 118188 ; free virtual = 131096

Starting Physical Synthesis Task

Phase 1 Physical Synthesis Initialization
INFO: [Physopt 32-245] Routed nets are present in the design. phys_opt_design will optimize unrouted part of the design.
INFO: [Physopt 32-721] Multithreading enabled for phys_opt_design using a maximum of 8 CPUs
INFO: [Physopt 32-619] Estimated Timing Summary | WNS=0.138 | TNS=0.000 |
Phase 1 Physical Synthesis Initialization | Checksum: 1667b2a64

Time (s): cpu = 00:01:40 ; elapsed = 00:01:37 . Memory (MB): peak = 6730.895 ; gain = 0.000 ; free physical = 118162 ; free virtual = 131071
INFO: [Physopt 32-245] Routed nets are present in the design. phys_opt_design will optimize unrouted part of the design.

Phase 2 Hold Fix Optimization
INFO: [Physopt 32-668] Estimated Timing Summary | WNS=0.138 | TNS=0.000 | WHS=-3.125 | THS=-32.141 |
INFO: [Physopt 32-45] Identified 7 candidate nets for hold slack optimization.
INFO: [Physopt 32-234] Optimized 2 nets. Inserted 0 new ZHOLD_DELAYs. Calibrated 0 existing ZHOLD_DELAYs. Inserted 2 buffers.

Netlist sorting complete. Time (s): cpu = 00:00:00.03 ; elapsed = 00:00:00.03 . Memory (MB): peak = 6730.895 ; gain = 0.000 ; free physical = 118161 ; free virtual = 131070
INFO: [Physopt 32-668] Estimated Timing Summary | WNS=0.138 | TNS=0.000 | WHS=-3.054 | THS=-23.871 |
Phase 2 Hold Fix Optimization | Checksum: 153147622

Time (s): cpu = 00:01:46 ; elapsed = 00:01:40 . Memory (MB): peak = 6730.895 ; gain = 0.000 ; free physical = 118161 ; free virtual = 131070
Netlist sorting complete. Time (s): cpu = 00:00:00.02 ; elapsed = 00:00:00.02 . Memory (MB): peak = 6730.895 ; gain = 0.000 ; free physical = 118161 ; free virtual = 131070
INFO: [Physopt 32-669] Post Physical Optimization Timing Summary | WNS=0.138 | TNS=0.000 | WHS=-3.054 | THS=-23.871 |

Summary of Physical Synthesis Optimizations
============================================

----------------------------------------------------------------------------------------------------------------------------------------------------------------------
| Optimization | WNS Gain (ns) | TNS Gain (ns) | Added Cells | Removed Cells | Optimized Cells/Nets | Dont Touch | Iterations | Elapsed |
----------------------------------------------------------------------------------------------------------------------------------------------------------------------
| Fanout | 0.000 | 0.000 | 0 | 0 | 0 | 0 | 0 | 00:00:00 |
| Single Cell Placement | 0.000 | 0.000 | 0 | 0 | 0 | 0 | 0 | 00:00:00 |
| Multi Cell Placement | 0.000 | 0.000 | 0 | 0 | 0 | 0 | 0 | 00:00:00 |
| Rewire | 0.000 | 0.000 | 0 | 0 | 0 | 0 | 0 | 00:00:00 |
| Critical Cell | 0.000 | 0.000 | 0 | 0 | 0 | 0 | 0 | 00:00:00 |
| SLR Crossing | 0.000 | 0.000 | 0 | 0 | 0 | 0 | 0 | 00:00:00 |
| DSP Register | 0.000 | 0.000 | 0 | 0 | 0 | 0 | 0 | 00:00:00 |
| BRAM Register | 0.000 | 0.000 | 0 | 0 | 0 | 0 | 0 | 00:00:00 |
| URAM Register | 0.000 | 0.000 | 0 | 0 | 0 | 0 | 0 | 00:00:00 |
| Shift Register | 0.000 | 0.000 | 0 | 0 | 0 | 0 | 0 | 00:00:00 |
| Critical Pin | 0.000 | 0.000 | 0 | 0 | 0 | 0 | 0 | 00:00:00 |
| Very High Fanout | 0.000 | 0.000 | 0 | 0 | 0 | 0 | 0 | 00:00:00 |
| Total | 0.000 | 0.000 | 0 | 0 | 0 | 0 | 0 | 00:00:00 |
----------------------------------------------------------------------------------------------------------------------------------------------------------------------

Summary of Hold Fix Optimizations
=================================

--------------------------------------------------------------------------------------------------------------------------------------------------------------
| Optimization | WHS Gain (ns) | THS Gain (ns) | Added LUTs | Added FFs | Optimized Nets | Dont Touch | Iterations | Elapsed |
--------------------------------------------------------------------------------------------------------------------------------------------------------------
| LUT1 and ZHOLD Insertion | 0.071 | 8.271 | 2 | 0 | 2 | 0 | 1 | 00:00:01 |
| Total | 0.071 | 8.271 | 2 | 0 | 2 | 0 | 1 | 00:00:01 |
--------------------------------------------------------------------------------------------------------------------------------------------------------------

Netlist sorting complete. Time (s): cpu = 00:00:00.02 ; elapsed = 00:00:00.02 . Memory (MB): peak = 6730.895 ; gain = 0.000 ; free physical = 118161 ; free virtual = 131070
Ending Physical Synthesis Task | Checksum: 11d301dab

Time (s): cpu = 00:01:46 ; elapsed = 00:01:41 . Memory (MB): peak = 6730.895 ; gain = 0.000 ; free physical = 118161 ; free virtual = 131070
INFO: [Common 17-83] Releasing license: Implementation
15 Infos, 0 Warnings, 0 Critical Warnings and 0 Errors encountered.
phys_opt_design completed successfully
phys_opt_design: Time (s): cpu = 00:01:47 ; elapsed = 00:01:41 . Memory (MB): peak = 6730.895 ; gain = 0.000 ; free physical = 118161 ; free virtual = 131070
## print "Writing post-phy_opt design checkpoint and report"

AWS FPGA: (12:26:05): Writing post-phy_opt design checkpoint and report

## write_checkpoint -force ${checkpoints_dir}/${CL}.${TAG}.post_phys_opt.dcp
INFO: [Timing 38-480] Writing timing data to binary archive.
Write ShapeDB Complete: Time (s): cpu = 00:00:00.11 ; elapsed = 00:00:00.02 . Memory (MB): peak = 6730.895 ; gain = 0.000 ; free physical = 118155 ; free virtual = 131075
Wrote PlaceDB: Time (s): cpu = 00:00:03 ; elapsed = 00:00:00.86 . Memory (MB): peak = 6730.895 ; gain = 0.000 ; free physical = 118134 ; free virtual = 131092
Wrote PulsedLatchDB: Time (s): cpu = 00:00:00 ; elapsed = 00:00:00 . Memory (MB): peak = 6730.895 ; gain = 0.000 ; free physical = 118134 ; free virtual = 131092
Writing XDEF routing.
Writing XDEF routing logical nets.
Writing XDEF routing special nets.
Wrote RouteStorage: Time (s): cpu = 00:00:00.38 ; elapsed = 00:00:00.12 . Memory (MB): peak = 6730.895 ; gain = 0.000 ; free physical = 118132 ; free virtual = 131092
Wrote Netlist Cache: Time (s): cpu = 00:00:00.08 ; elapsed = 00:00:00.02 . Memory (MB): peak = 6730.895 ; gain = 0.000 ; free physical = 118130 ; free virtual = 131091
Wrote Device Cache: Time (s): cpu = 00:00:00.04 ; elapsed = 00:00:00.02 . Memory (MB): peak = 6730.895 ; gain = 0.000 ; free physical = 118128 ; free virtual = 131091
Write Physdb Complete: Time (s): cpu = 00:00:04 ; elapsed = 00:00:01 . Memory (MB): peak = 6730.895 ; gain = 0.000 ; free physical = 118128 ; free virtual = 131092
INFO: [Common 17-1381] The checkpoint '/home/ubuntu/src/aws-fpga/hdk/cl/examples/top/build/checkpoints/top.2026_10_10-121021.post_phys_opt.dcp' has been generated.
## report_timing -delay_type max \
## -path_type full_clock_expanded \
## -max_paths 10 \
## -nworst 1 \
## -input_pins \
## -slice_pins \
## -sort_by group \
## -significant_digits 3 \
## -file $reports_dir/${CL}.${TAG}.post_phy_opt_timing.rpt
INFO: [Timing 38-91] UpdateTimingParams: Speed grade: -2, Temperature grade: E, Delay Type: max.
INFO: [Timing 38-191] Multithreading enabled for timing update using a maximum of 8 CPUs
INFO: [Timing 38-78] ReportTimingParams: -max_paths 10 -nworst 1 -delay_type max -sort_by group.
## print "Start routing customer design ${CL}"

AWS FPGA: (12:26:10): Start routing customer design top
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
