Niccc8/rvbl2-riscv-cpu-core/chipinventor/app/imem_app.v

// ============================================================================
// imem.v - Instruction/constant ROM. Combinational read: "Upon receiving the
// memory address to be accessed and a read signal (output enable), the 32-bit
// instruction that was in that position is received by the kernel" (Block
// Guide S4.2 - no cycle-latency language, unlike DMEM's S4.3).
//
// GENERATED FILE - do not hand-edit. Produced by
// chipinventor/scripts/gen_ci_imem.py from:
//   word    0..2792  0x00400000..0x00402BA0  lane.hex (2793 words)
//                                          application firmware
//
// The official firmware MUST stay at word 0: it is position-dependent, and
// derives its .bss base from the PC (auipc s0, 0xfc10 at 0x0040011C gives
// 0x10010000, which is DMEM_BASE). The supplementary program is
// position-independent and is placed above it.
//
// The *architectural* window is the full 4MB at 0x00400000 (Table 13), which
// address_decoder range-checks against. The ROM below covers only the words
// the images actually occupy; any address inside the 4MB window but past or
// between them falls to the `default` leg and reads back 0 rather than
// aliasing into a real word. That is the same guarantee the file-driven
// version's impl_sel comparison gave.
//
// WHY A CASE AND NOT $readmemh
// ----------------------------
// The platform has no filesystem to read a hex image from, so the image is
// unrolled into the source here. Everything else about this block - the oe_i
// gating, the zero-on-deselect, the word indexing - is unchanged, so the
// address_decoder contract this sits behind is identical either way.
//
// FOR THE OPENLANE / P&R RUN, PASTE blocks/imem_mock.v INSTEAD.
// ============================================================================
module imem (
    input  wire [31:0] address_i,    // full byte address (already imem_sel-gated by decoder)
    input  wire        oe_i,
    output reg  [31:0] data_o
);
    // Word index within the 4MB architectural window (22-bit byte address ->
    // 20-bit word index), exactly as the file-driven version computed it.
    wire [19:0] word_addr = address_i[21:2];

    // Two-level case: 64-word pages, then the word in the page. The logic is
    // the same ROM; the split only keeps the simulator from walking one
    // thousand-arm case on every fetch.
    always @(*) begin
        if (!oe_i) data_o = 32'b0;
        else begin
            case (word_addr[19:6])
                14'd0   : case (word_addr[5:0])   // words 0..63
                    6'd0 : data_o = 32'h0fc12117;
                    6'd1 : data_o = 32'h00010113;
                    6'd2 : data_o = 32'h00003297;
                    6'd3 : data_o = 32'hb7828293;
                    6'd4 : data_o = 32'h0fc10317;
                    6'd5 : data_o = 32'hff030313;
                    6'd6 : data_o = 32'h0fc10397;
                    6'd7 : data_o = 32'h00c38393;
                    6'd8 : data_o = 32'h00737c63;
                    6'd9 : data_o = 32'h0002ae03;
                    6'd10: data_o = 32'h01c32023;
                    6'd11: data_o = 32'h00428293;
                    6'd12: data_o = 32'h00430313;
                    6'd13: data_o = 32'hfedff06f;
                    6'd14: data_o = 32'h0fc10317;
                    6'd15: data_o = 32'hfec30313;
                    6'd16: data_o = 32'h0fc10397;
                    6'd17: data_o = 32'h15c38393;
                    6'd18: data_o = 32'h00737863;
                    6'd19: data_o = 32'h00032023;
                    6'd20: data_o = 32'h00430313;
                    6'd21: data_o = 32'hff5ff06f;
                    6'd22: data_o = 32'h401010ef;
                    6'd23: data_o = 32'h00000073;
                    6'd24: data_o = 32'h0000006f;
                    6'd25: data_o = 32'h00050613;
                    6'd26: data_o = 32'h04058263;
                    6'd27: data_o = 32'h00000513;
                    6'd28: data_o = 32'h01f00713;
                    6'd29: data_o = 32'h00000793;
                    6'd30: data_o = 32'h00100893;
                    6'd31: data_o = 32'hfff00813;
                    6'd32: data_o = 32'h00e656b3;
                    6'd33: data_o = 32'h0016f693;
                    6'd34: data_o = 32'h00179793;
                    6'd35: data_o = 32'h00f6e7b3;
                    6'd36: data_o = 32'h00e896b3;
                    6'd37: data_o = 32'hfff70713;
                    6'd38: data_o = 32'h00b7e663;
                    6'd39: data_o = 32'h40b787b3;
                    6'd40: data_o = 32'h00d56533;
                    6'd41: data_o = 32'hfd071ee3;
                    6'd42: data_o = 32'h00008067;
                    6'd43: data_o = 32'hfff00513;
                    6'd44: data_o = 32'h00008067;
                    6'd45: data_o = 32'h00050693;
                    6'd46: data_o = 32'h02058a63;
                    6'd47: data_o = 32'h01f00793;
                    6'd48: data_o = 32'h00000513;
                    6'd49: data_o = 32'hfff00613;
                    6'd50: data_o = 32'h00f6d733;
                    6'd51: data_o = 32'h00151513;
                    6'd52: data_o = 32'h00177713;
                    6'd53: data_o = 32'h00a76533;
                    6'd54: data_o = 32'hfff78793;
                    6'd55: data_o = 32'h00b56463;
                    6'd56: data_o = 32'h40b50533;
                    6'd57: data_o = 32'hfec792e3;
                    6'd58: data_o = 32'h00008067;
                    6'd59: data_o = 32'h00008067;
                    6'd60: data_o = 32'h06058863;
                    6'd61: data_o = 32'h41f55713;
                    6'd62: data_o = 32'h41f5d793;
                    6'd63: data_o = 32'h00a748b3;
                    default: data_o = 32'b0;
                endcase
                14'd1   : case (word_addr[5:0])   // words 64..127
                    6'd0 : data_o = 32'h00b7c633;
                    6'd1 : data_o = 32'h40e888b3;
                    6'd2 : data_o = 32'h40f60633;
                    6'd3 : data_o = 32'h00000813;
                    6'd4 : data_o = 32'h01f00713;
                    6'd5 : data_o = 32'h00000793;
                    6'd6 : data_o = 32'h00100e13;
                    6'd7 : data_o = 32'hfff00313;
                    6'd8 : data_o = 32'h00e8d6b3;
                    6'd9 : data_o = 32'h0016f693;
                    6'd10: data_o = 32'h00179793;
                    6'd11: data_o = 32'h00f6e7b3;
                    6'd12: data_o = 32'h00ee16b3;
                    6'd13: data_o = 32'hfff70713;
                    6'd14: data_o = 32'h00c7e663;
                    6'd15: data_o = 32'h40c787b3;
                    6'd16: data_o = 32'h00d86833;
                    6'd17: data_o = 32'hfc671ee3;
                    6'd18: data_o = 32'h00a5c5b3;
                    6'd19: data_o = 32'h00080513;
                    6'd20: data_o = 32'h0005c463;
                    6'd21: data_o = 32'h00008067;
                    6'd22: data_o = 32'h41000533;
                    6'd23: data_o = 32'h00008067;
                    6'd24: data_o = 32'hfff00513;
                    6'd25: data_o = 32'h00008067;
                    6'd26: data_o = 32'h00050893;
                    6'd27: data_o = 32'h04058863;
                    6'd28: data_o = 32'h41f5d713;
                    6'd29: data_o = 32'h41f55793;
                    6'd30: data_o = 32'h00b74633;
                    6'd31: data_o = 32'h00a7c833;
                    6'd32: data_o = 32'h40f80833;
                    6'd33: data_o = 32'h40e60633;
                    6'd34: data_o = 32'h00000793;
                    6'd35: data_o = 32'h01f00713;
                    6'd36: data_o = 32'hfff00593;
                    6'd37: data_o = 32'h00e856b3;
                    6'd38: data_o = 32'h00179793;
                    6'd39: data_o = 32'h0016f693;
                    6'd40: data_o = 32'h00f6e7b3;
                    6'd41: data_o = 32'hfff70713;
                    6'd42: data_o = 32'h00c7e463;
                    6'd43: data_o = 32'h40c787b3;
                    6'd44: data_o = 32'hfeb712e3;
                    6'd45: data_o = 32'h00078513;
                    6'd46: data_o = 32'h0008c463;
                    6'd47: data_o = 32'h00008067;
                    6'd48: data_o = 32'h40f00533;
                    6'd49: data_o = 32'h00008067;
                    6'd50: data_o = 32'hf1000737;
                    6'd51: data_o = 32'h00870713;
                    6'd52: data_o = 32'h00072783;
                    6'd53: data_o = 32'h0047f793;
                    6'd54: data_o = 32'hfe078ce3;
                    6'd55: data_o = 32'hf10007b7;
                    6'd56: data_o = 32'h00a7a023;
                    6'd57: data_o = 32'h00300793;
                    6'd58: data_o = 32'h00f72023;
                    6'd59: data_o = 32'h00008067;
                    6'd60: data_o = 32'hf10007b7;
                    6'd61: data_o = 32'h0087a703;
                    6'd62: data_o = 32'h00050693;
                    6'd63: data_o = 32'h00878793;
                    default: data_o = 32'b0;
                endcase
                14'd2   : case (word_addr[5:0])   // words 128..191
                    6'd0 : data_o = 32'h00277713;
                    6'd1 : data_o = 32'h00070e63;
                    6'd2 : data_o = 32'hf1000737;
                    6'd3 : data_o = 32'h00472603;
                    6'd4 : data_o = 32'h00100513;
                    6'd5 : data_o = 32'h00c68023;
                    6'd6 : data_o = 32'h0007a023;
                    6'd7 : data_o = 32'h00008067;
                    6'd8 : data_o = 32'h00000513;
                    6'd9 : data_o = 32'h00008067;
                    6'd10: data_o = 32'hf1000737;
                    6'd11: data_o = 32'h00870713;
                    6'd12: data_o = 32'h00072783;
                    6'd13: data_o = 32'h0027f793;
                    6'd14: data_o = 32'hfe078ce3;
                    6'd15: data_o = 32'hf10007b7;
                    6'd16: data_o = 32'h0047a503;
                    6'd17: data_o = 32'h00072023;
                    6'd18: data_o = 32'h0ff57513;
                    6'd19: data_o = 32'h00008067;
                    6'd20: data_o = 32'h00054683;
                    6'd21: data_o = 32'h02068a63;
                    6'd22: data_o = 32'hf1000737;
                    6'd23: data_o = 32'hf10005b7;
                    6'd24: data_o = 32'h00870713;
                    6'd25: data_o = 32'h00300613;
                    6'd26: data_o = 32'h00150513;
                    6'd27: data_o = 32'h00072783;
                    6'd28: data_o = 32'h0047f793;
                    6'd29: data_o = 32'hfe078ce3;
                    6'd30: data_o = 32'h00d5a023;
                    6'd31: data_o = 32'h00c72023;
                    6'd32: data_o = 32'h00054683;
                    6'd33: data_o = 32'hfe0692e3;
                    6'd34: data_o = 32'h00008067;
                    6'd35: data_o = 32'hf1000737;
                    6'd36: data_o = 32'h004035b7;
                    6'd37: data_o = 32'h01c00693;
                    6'd38: data_o = 32'hb6c58593;
                    6'd39: data_o = 32'hf1000337;
                    6'd40: data_o = 32'h00870713;
                    6'd41: data_o = 32'h00300893;
                    6'd42: data_o = 32'hffc00813;
                    6'd43: data_o = 32'h00d557b3;
                    6'd44: data_o = 32'h00f7f793;
                    6'd45: data_o = 32'h00f587b3;
                    6'd46: data_o = 32'h0007c603;
                    6'd47: data_o = 32'h00072783;
                    6'd48: data_o = 32'h0047f793;
                    6'd49: data_o = 32'hfe078ce3;
                    6'd50: data_o = 32'h00c32023;
                    6'd51: data_o = 32'h01172023;
                    6'd52: data_o = 32'hffc68693;
                    6'd53: data_o = 32'hfd069ce3;
                    6'd54: data_o = 32'h00008067;
                    6'd55: data_o = 32'hfd010113;
                    6'd56: data_o = 32'h02812423;
                    6'd57: data_o = 32'h03212023;
                    6'd58: data_o = 32'h01312e23;
                    6'd59: data_o = 32'h01512a23;
                    6'd60: data_o = 32'h02112623;
                    6'd61: data_o = 32'h02912223;
                    6'd62: data_o = 32'h01412c23;
                    6'd63: data_o = 32'h00050413;
                    default: data_o = 32'b0;
                endcase
                14'd3   : case (word_addr[5:0])   // words 192..255
                    6'd0 : data_o = 32'h00000913;
                    6'd1 : data_o = 32'h00410993;
                    6'd2 : data_o = 32'h00900a93;
                    6'd3 : data_o = 32'h00a00593;
                    6'd4 : data_o = 32'h00040513;
                    6'd5 : data_o = 32'h00000097;
                    6'd6 : data_o = 32'hda0080e7;
                    6'd7 : data_o = 32'h00190913;
                    6'd8 : data_o = 32'h03050793;
                    6'd9 : data_o = 32'h012984b3;
                    6'd10: data_o = 32'h00040513;
                    6'd11: data_o = 32'h00a00593;
                    6'd12: data_o = 32'hfef48fa3;
                    6'd13: data_o = 32'h00040a13;
                    6'd14: data_o = 32'h00000097;
                    6'd15: data_o = 32'hd2c080e7;
                    6'd16: data_o = 32'h00050413;
                    6'd17: data_o = 32'hfd4ae4e3;
                    6'd18: data_o = 32'hf1000737;
                    6'd19: data_o = 32'h00048693;
                    6'd20: data_o = 32'hf1000537;
                    6'd21: data_o = 32'h00870713;
                    6'd22: data_o = 32'h00300593;
                    6'd23: data_o = 32'hfff6c603;
                    6'd24: data_o = 32'h00072783;
                    6'd25: data_o = 32'h0047f793;
                    6'd26: data_o = 32'hfe078ce3;
                    6'd27: data_o = 32'h00c52023;
                    6'd28: data_o = 32'h00b72023;
                    6'd29: data_o = 32'hfff68693;
                    6'd30: data_o = 32'hfed992e3;
                    6'd31: data_o = 32'h02c12083;
                    6'd32: data_o = 32'h02812403;
                    6'd33: data_o = 32'h02412483;
                    6'd34: data_o = 32'h02012903;
                    6'd35: data_o = 32'h01c12983;
                    6'd36: data_o = 32'h01812a03;
                    6'd37: data_o = 32'h01412a83;
                    6'd38: data_o = 32'h03010113;
                    6'd39: data_o = 32'h00008067;
                    6'd40: data_o = 32'hf10006b7;
                    6'd41: data_o = 32'h0ff57713;
                    6'd42: data_o = 32'h00868693;
                    6'd43: data_o = 32'h0006a783;
                    6'd44: data_o = 32'h0047f793;
                    6'd45: data_o = 32'hfe078ce3;
                    6'd46: data_o = 32'hf10007b7;
                    6'd47: data_o = 32'h00e7a023;
                    6'd48: data_o = 32'hf1000737;
                    6'd49: data_o = 32'h00300793;
                    6'd50: data_o = 32'h00f6a023;
                    6'd51: data_o = 32'h00855513;
                    6'd52: data_o = 32'h00870713;
                    6'd53: data_o = 32'h00072783;
                    6'd54: data_o = 32'h0047f793;
                    6'd55: data_o = 32'hfe078ce3;
                    6'd56: data_o = 32'hf10007b7;
                    6'd57: data_o = 32'h00a7a023;
                    6'd58: data_o = 32'h00300793;
                    6'd59: data_o = 32'h00f72023;
                    6'd60: data_o = 32'h00008067;
                    6'd61: data_o = 32'hf1000737;
                    6'd62: data_o = 32'h00000693;
                    6'd63: data_o = 32'hf10008b7;
                    default: data_o = 32'b0;
                endcase
                14'd4   : case (word_addr[5:0])   // words 256..319
                    6'd0 : data_o = 32'h00870713;
                    6'd1 : data_o = 32'h00300813;
                    6'd2 : data_o = 32'h02000593;
                    6'd3 : data_o = 32'h00d55633;
                    6'd4 : data_o = 32'h00072783;
                    6'd5 : data_o = 32'h0047f793;
                    6'd6 : data_o = 32'hfe078ce3;
                    6'd7 : data_o = 32'h0ff67793;
                    6'd8 : data_o = 32'h00f8a023;
                    6'd9 : data_o = 32'h01072023;
                    6'd10: data_o = 32'h00868693;
                    6'd11: data_o = 32'hfeb690e3;
                    6'd12: data_o = 32'h00008067;
                    6'd13: data_o = 32'hf1000637;
                    6'd14: data_o = 32'h00860613;
                    6'd15: data_o = 32'h00062783;
                    6'd16: data_o = 32'h0027f793;
                    6'd17: data_o = 32'hfe078ce3;
                    6'd18: data_o = 32'hf10007b7;
                    6'd19: data_o = 32'h0047a683;
                    6'd20: data_o = 32'hf1000737;
                    6'd21: data_o = 32'h00062023;
                    6'd22: data_o = 32'h0ff6f693;
                    6'd23: data_o = 32'h00870713;
                    6'd24: data_o = 32'h00072783;
                    6'd25: data_o = 32'h0027f793;
                    6'd26: data_o = 32'hfe078ce3;
                    6'd27: data_o = 32'hf10007b7;
                    6'd28: data_o = 32'h0047a503;
                    6'd29: data_o = 32'h00072023;
                    6'd30: data_o = 32'h0ff57513;
                    6'd31: data_o = 32'h00851513;
                    6'd32: data_o = 32'h00d56533;
                    6'd33: data_o = 32'h01051513;
                    6'd34: data_o = 32'h01055513;
                    6'd35: data_o = 32'h00008067;
                    6'd36: data_o = 32'hf10006b7;
                    6'd37: data_o = 32'hf1000637;
                    6'd38: data_o = 32'h00000713;
                    6'd39: data_o = 32'h00000513;
                    6'd40: data_o = 32'h00868693;
                    6'd41: data_o = 32'h00460613;
                    6'd42: data_o = 32'h02000593;
                    6'd43: data_o = 32'h0006a783;
                    6'd44: data_o = 32'h0027f793;
                    6'd45: data_o = 32'hfe078ce3;
                    6'd46: data_o = 32'h00062783;
                    6'd47: data_o = 32'h0006a023;
                    6'd48: data_o = 32'h0ff7f793;
                    6'd49: data_o = 32'h00e797b3;
                    6'd50: data_o = 32'h00870713;
                    6'd51: data_o = 32'h00f56533;
                    6'd52: data_o = 32'hfcb71ee3;
                    6'd53: data_o = 32'h00008067;
                    6'd54: data_o = 32'h00050793;
                    6'd55: data_o = 32'h02060063;
                    6'd56: data_o = 32'h00c58633;
                    6'd57: data_o = 32'h00158593;
                    6'd58: data_o = 32'hfff5c703;
                    6'd59: data_o = 32'h80f707b3;
                    6'd60: data_o = 32'hfec59ae3;
                    6'd61: data_o = 32'h01079513;
                    6'd62: data_o = 32'h01055513;
                    6'd63: data_o = 32'h00008067;
                    default: data_o = 32'b0;
                endcase
                14'd5   : case (word_addr[5:0])   // words 320..383
                    6'd0 : data_o = 32'h00452683;
                    6'd1 : data_o = 32'h00c52783;
                    6'd2 : data_o = 32'h00852883;
                    6'd3 : data_o = 32'h00052303;
                    6'd4 : data_o = 32'h01b6d813;
                    6'd5 : data_o = 32'h0187d593;
                    6'd6 : data_o = 32'h00569713;
                    6'd7 : data_o = 32'h00879613;
                    6'd8 : data_o = 32'h006686b3;
                    6'd9 : data_o = 32'h011787b3;
                    6'd10: data_o = 32'h01076733;
                    6'd11: data_o = 32'h00b66633;
                    6'd12: data_o = 32'h00f64633;
                    6'd13: data_o = 32'h00d74733;
                    6'd14: data_o = 32'h01069593;
                    6'd15: data_o = 32'h0106d693;
                    6'd16: data_o = 32'h00f707b3;
                    6'd17: data_o = 32'h00d5e6b3;
                    6'd18: data_o = 32'h00d61813;
                    6'd19: data_o = 32'h00771593;
                    6'd20: data_o = 32'h01365893;
                    6'd21: data_o = 32'h01975713;
                    6'd22: data_o = 32'h00c686b3;
                    6'd23: data_o = 32'h00e5e733;
                    6'd24: data_o = 32'h01186633;
                    6'd25: data_o = 32'h01079593;
                    6'd26: data_o = 32'h0107d813;
                    6'd27: data_o = 32'h00d64633;
                    6'd28: data_o = 32'h00f747b3;
                    6'd29: data_o = 32'h0105e733;
                    6'd30: data_o = 32'h00d52023;
                    6'd31: data_o = 32'h00c52623;
                    6'd32: data_o = 32'h00f52223;
                    6'd33: data_o = 32'h00e52423;
                    6'd34: data_o = 32'h00008067;
                    6'd35: data_o = 32'h00062783;
                    6'd36: data_o = 32'h00c62703;
                    6'd37: data_o = 32'h00179793;
                    6'd38: data_o = 32'h00075463;
                    6'd39: data_o = 32'h0877c793;
                    6'd40: data_o = 32'h00f52023;
                    6'd41: data_o = 32'h00462703;
                    6'd42: data_o = 32'h00062683;
                    6'd43: data_o = 32'h00179793;
                    6'd44: data_o = 32'h00171713;
                    6'd45: data_o = 32'h01f6d693;
                    6'd46: data_o = 32'h00d76733;
                    6'd47: data_o = 32'h00e52223;
                    6'd48: data_o = 32'h00862703;
                    6'd49: data_o = 32'h00462683;
                    6'd50: data_o = 32'h00171713;
                    6'd51: data_o = 32'h01f6d693;
                    6'd52: data_o = 32'h00d76733;
                    6'd53: data_o = 32'h00e52423;
                    6'd54: data_o = 32'h00c62703;
                    6'd55: data_o = 32'h00862683;
                    6'd56: data_o = 32'h00171713;
                    6'd57: data_o = 32'h01f6d693;
                    6'd58: data_o = 32'h00d76733;
                    6'd59: data_o = 32'h00e52623;
                    6'd60: data_o = 32'h00075463;
                    6'd61: data_o = 32'h0877c793;
                    6'd62: data_o = 32'h00f5a023;
                    6'd63: data_o = 32'h00452783;
                    default: data_o = 32'b0;
                endcase
                14'd6   : case (word_addr[5:0])   // words 384..447
                    6'd0 : data_o = 32'h00052703;
                    6'd1 : data_o = 32'h00179793;
                    6'd2 : data_o = 32'h01f75713;
                    6'd3 : data_o = 32'h00e7e7b3;
                    6'd4 : data_o = 32'h00f5a223;
                    6'd5 : data_o = 32'h00852783;
                    6'd6 : data_o = 32'h00452703;
                    6'd7 : data_o = 32'h00179793;
                    6'd8 : data_o = 32'h01f75713;
                    6'd9 : data_o = 32'h00e7e7b3;
                    6'd10: data_o = 32'h00f5a423;
                    6'd11: data_o = 32'h00c52783;
                    6'd12: data_o = 32'h00852703;
                    6'd13: data_o = 32'h00179793;
                    6'd14: data_o = 32'h01f75713;
                    6'd15: data_o = 32'h00e7e7b3;
                    6'd16: data_o = 32'h00f5a623;
                    6'd17: data_o = 32'h00008067;
                    6'd18: data_o = 32'h00472e03;
                    6'd19: data_o = 32'h00872303;
                    6'd20: data_o = 32'h00c72883;
                    6'd21: data_o = 32'h00072703;
                    6'd22: data_o = 32'hfc010113;
                    6'd23: data_o = 32'h02812c23;
                    6'd24: data_o = 32'h02912a23;
                    6'd25: data_o = 32'h02112e23;
                    6'd26: data_o = 32'h03212823;
                    6'd27: data_o = 32'h03312623;
                    6'd28: data_o = 32'h03412423;
                    6'd29: data_o = 32'h03512223;
                    6'd30: data_o = 32'h00e12023;
                    6'd31: data_o = 32'h01c12223;
                    6'd32: data_o = 32'h00612423;
                    6'd33: data_o = 32'h01112623;
                    6'd34: data_o = 32'h00050493;
                    6'd35: data_o = 32'h00058413;
                    6'd36: data_o = 32'h10068663;
                    6'd37: data_o = 32'hfff68f93;
                    6'd38: data_o = 32'h004fdf93;
                    6'd39: data_o = 32'h220f8063;
                    6'd40: data_o = 32'h004f9f93;
                    6'd41: data_o = 32'h01f602b3;
                    6'd42: data_o = 32'h00010913;
                    6'd43: data_o = 32'h01010f13;
                    6'd44: data_o = 32'h00060713;
                    6'd45: data_o = 32'h00090313;
                    6'd46: data_o = 32'h00174883;
                    6'd47: data_o = 32'h00074e83;
                    6'd48: data_o = 32'h00274503;
                    6'd49: data_o = 32'h00374583;
                    6'd50: data_o = 32'h00889893;
                    6'd51: data_o = 32'h00032e03;
                    6'd52: data_o = 32'h01d8e8b3;
                    6'd53: data_o = 32'h01051513;
                    6'd54: data_o = 32'h01156533;
                    6'd55: data_o = 32'h01859593;
                    6'd56: data_o = 32'h00a5e5b3;
                    6'd57: data_o = 32'h00be45b3;
                    6'd58: data_o = 32'h00b32023;
                    6'd59: data_o = 32'h00430313;
                    6'd60: data_o = 32'h00470713;
                    6'd61: data_o = 32'hfc6f12e3;
                    6'd62: data_o = 32'h00012883;
                    6'd63: data_o = 32'h00412303;
                    default: data_o = 32'b0;
                endcase
                14'd7   : case (word_addr[5:0])   // words 448..511
                    6'd0 : data_o = 32'h00812e03;
                    6'd1 : data_o = 32'h00c12583;
                    6'd2 : data_o = 32'h00c00e93;
                    6'd3 : data_o = 32'h0185d393;
                    6'd4 : data_o = 32'h00531713;
                    6'd5 : data_o = 32'h01b35093;
                    6'd6 : data_o = 32'h00859513;
                    6'd7 : data_o = 32'h006888b3;
                    6'd8 : data_o = 32'h00be0e33;
                    6'd9 : data_o = 32'h00756533;
                    6'd10: data_o = 32'h00176733;
                    6'd11: data_o = 32'h01174733;
                    6'd12: data_o = 32'h01c54533;
                    6'd13: data_o = 32'h01089593;
                    6'd14: data_o = 32'h0108d893;
                    6'd15: data_o = 32'h01c703b3;
                    6'd16: data_o = 32'h0115e8b3;
                    6'd17: data_o = 32'h01355e13;
                    6'd18: data_o = 32'h00771313;
                    6'd19: data_o = 32'h00d51593;
                    6'd20: data_o = 32'h01975713;
                    6'd21: data_o = 32'h01c5e5b3;
                    6'd22: data_o = 32'h00e36333;
                    6'd23: data_o = 32'h00a888b3;
                    6'd24: data_o = 32'h01039713;
                    6'd25: data_o = 32'h0103de13;
                    6'd26: data_o = 32'hfffe8e93;
                    6'd27: data_o = 32'h0115c5b3;
                    6'd28: data_o = 32'h00734333;
                    6'd29: data_o = 32'h00ee6e33;
                    6'd30: data_o = 32'hf80e9ae3;
                    6'd31: data_o = 32'h01112023;
                    6'd32: data_o = 32'h00b12623;
                    6'd33: data_o = 32'h00612223;
                    6'd34: data_o = 32'h01c12423;
                    6'd35: data_o = 32'h01060613;
                    6'd36: data_o = 32'hf25610e3;
                    6'd37: data_o = 32'h41f68fb3;
                    6'd38: data_o = 32'h0100006f;
                    6'd39: data_o = 32'h00000f93;
                    6'd40: data_o = 32'h00010913;
                    6'd41: data_o = 32'h01010f13;
                    6'd42: data_o = 32'h000f0313;
                    6'd43: data_o = 32'h000f0513;
                    6'd44: data_o = 32'h00000713;
                    6'd45: data_o = 32'h01000e13;
                    6'd46: data_o = 32'h41f705b3;
                    6'd47: data_o = 32'h00e608b3;
                    6'd48: data_o = 32'h0015b593;
                    6'd49: data_o = 32'h01f77463;
                    6'd50: data_o = 32'h0008c583;
                    6'd51: data_o = 32'h00b50023;
                    6'd52: data_o = 32'h00170713;
                    6'd53: data_o = 32'h00150513;
                    6'd54: data_o = 32'hffc710e3;
                    6'd55: data_o = 32'h00068463;
                    6'd56: data_o = 32'h0cef8a63;
                    6'd57: data_o = 32'h00080a93;
                    6'd58: data_o = 32'h00090a13;
                    6'd59: data_o = 32'h010f0f13;
                    6'd60: data_o = 32'h00090793;
                    6'd61: data_o = 32'h00080613;
                    6'd62: data_o = 32'h00062683;
                    6'd63: data_o = 32'h00032583;
                    default: data_o = 32'b0;
                endcase
                14'd8   : case (word_addr[5:0])   // words 512..575
                    6'd0 : data_o = 32'h0007a703;
                    6'd1 : data_o = 32'h00430313;
                    6'd2 : data_o = 32'h00b6c6b3;
                    6'd3 : data_o = 32'h00d74733;
                    6'd4 : data_o = 32'h00e7a023;
                    6'd5 : data_o = 32'h00460613;
                    6'd6 : data_o = 32'h00478793;
                    6'd7 : data_o = 32'hfc6f1ee3;
                    6'd8 : data_o = 32'h00c00993;
                    6'd9 : data_o = 32'h00090513;
                    6'd10: data_o = 32'hfff98993;
                    6'd11: data_o = 32'h00000097;
                    6'd12: data_o = 32'hcd4080e7;
                    6'd13: data_o = 32'hfe0998e3;
                    6'd14: data_o = 32'h01010693;
                    6'd15: data_o = 32'h000a2783;
                    6'd16: data_o = 32'h000aa703;
                    6'd17: data_o = 32'h004a0a13;
                    6'd18: data_o = 32'h004a8a93;
                    6'd19: data_o = 32'h00e7c7b3;
                    6'd20: data_o = 32'hfefa2e23;
                    6'd21: data_o = 32'hff4694e3;
                    6'd22: data_o = 32'h01000613;
                    6'd23: data_o = 32'h02040a63;
                    6'd24: data_o = 32'hffc9f793;
                    6'd25: data_o = 32'h02078793;
                    6'd26: data_o = 32'h002787b3;
                    6'd27: data_o = 32'hfe07a783;
                    6'd28: data_o = 32'h0039f713;
                    6'd29: data_o = 32'h00371713;
                    6'd30: data_o = 32'h013486b3;
                    6'd31: data_o = 32'h00e7d7b3;
                    6'd32: data_o = 32'h00f68023;
                    6'd33: data_o = 32'h00198993;
                    6'd34: data_o = 32'h01340463;
                    6'd35: data_o = 32'hfcc99ae3;
                    6'd36: data_o = 32'h03c12083;
                    6'd37: data_o = 32'h03812403;
                    6'd38: data_o = 32'h03412483;
                    6'd39: data_o = 32'h03012903;
                    6'd40: data_o = 32'h02c12983;
                    6'd41: data_o = 32'h02812a03;
                    6'd42: data_o = 32'h02412a83;
                    6'd43: data_o = 32'h04010113;
                    6'd44: data_o = 32'h00008067;
                    6'd45: data_o = 32'h00078813;
                    6'd46: data_o = 32'hf2dff06f;
                    6'd47: data_o = 32'h00068f93;
                    6'd48: data_o = 32'h00010913;
                    6'd49: data_o = 32'h01010f13;
                    6'd50: data_o = 32'hee1ff06f;
                    6'd51: data_o = 32'h02060063;
                    6'd52: data_o = 32'h00c50633;
                    6'd53: data_o = 32'h00050793;
                    6'd54: data_o = 32'h0005c703;
                    6'd55: data_o = 32'h00178793;
                    6'd56: data_o = 32'h00158593;
                    6'd57: data_o = 32'hfee78fa3;
                    6'd58: data_o = 32'hfef618e3;
                    6'd59: data_o = 32'h00008067;
                    6'd60: data_o = 32'h02b56663;
                    6'd61: data_o = 32'hfff60793;
                    6'd62: data_o = 32'hfff00813;
                    6'd63: data_o = 32'h04060263;
                    default: data_o = 32'b0;
                endcase
                14'd9   : case (word_addr[5:0])   // words 576..639
                    6'd0 : data_o = 32'h00f58733;
                    6'd1 : data_o = 32'h00074683;
                    6'd2 : data_o = 32'h00f50733;
                    6'd3 : data_o = 32'hfff78793;
                    6'd4 : data_o = 32'h00d70023;
                    6'd5 : data_o = 32'hff0796e3;
                    6'd6 : data_o = 32'h00008067;
                    6'd7 : data_o = 32'hfe060ee3;
                    6'd8 : data_o = 32'h00c50633;
                    6'd9 : data_o = 32'h00050793;
                    6'd10: data_o = 32'h0005c703;
                    6'd11: data_o = 32'h00178793;
                    6'd12: data_o = 32'h00158593;
                    6'd13: data_o = 32'hfee78fa3;
                    6'd14: data_o = 32'hfec798e3;
                    6'd15: data_o = 32'h00008067;
                    6'd16: data_o = 32'h00008067;
                    6'd17: data_o = 32'h0ff5f593;
                    6'd18: data_o = 32'h00c50733;
                    6'd19: data_o = 32'h00050793;
                    6'd20: data_o = 32'h00060863;
                    6'd21: data_o = 32'h00178793;
                    6'd22: data_o = 32'hfeb78fa3;
                    6'd23: data_o = 32'hfef71ce3;
                    6'd24: data_o = 32'h00008067;
                    6'd25: data_o = 32'h02060663;
                    6'd26: data_o = 32'h00c50633;
                    6'd27: data_o = 32'h0080006f;
                    6'd28: data_o = 32'h02c50063;
                    6'd29: data_o = 32'h00054783;
                    6'd30: data_o = 32'h0005c703;
                    6'd31: data_o = 32'h00150513;
                    6'd32: data_o = 32'h00158593;
                    6'd33: data_o = 32'hfee786e3;
                    6'd34: data_o = 32'h40e78533;
                    6'd35: data_o = 32'h00008067;
                    6'd36: data_o = 32'h00000513;
                    6'd37: data_o = 32'h00008067;
                    6'd38: data_o = 32'h00452683;
                    6'd39: data_o = 32'h00852603;
                    6'd40: data_o = 32'h00052583;
                    6'd41: data_o = 32'h00369813;
                    6'd42: data_o = 32'h00d80833;
                    6'd43: data_o = 32'h00261793;
                    6'd44: data_o = 32'h00781713;
                    6'd45: data_o = 32'h00c787b3;
                    6'd46: data_o = 32'h41070733;
                    6'd47: data_o = 32'h00279793;
                    6'd48: data_o = 32'h00259813;
                    6'd49: data_o = 32'h00271713;
                    6'd50: data_o = 32'h40c787b3;
                    6'd51: data_o = 32'h00b80833;
                    6'd52: data_o = 32'h40d70733;
                    6'd53: data_o = 32'h00479793;
                    6'd54: data_o = 32'h00381813;
                    6'd55: data_o = 32'h00271713;
                    6'd56: data_o = 32'h40c787b3;
                    6'd57: data_o = 32'h00b80833;
                    6'd58: data_o = 32'h00d70733;
                    6'd59: data_o = 32'h00479793;
                    6'd60: data_o = 32'h40c787b3;
                    6'd61: data_o = 32'h00781813;
                    6'd62: data_o = 32'h00271713;
                    6'd63: data_o = 32'h40b80833;
                    default: data_o = 32'b0;
                endcase
                14'd10  : case (word_addr[5:0])   // words 640..703
                    6'd0 : data_o = 32'h40d70733;
                    6'd1 : data_o = 32'h00679893;
                    6'd2 : data_o = 32'h011787b3;
                    6'd3 : data_o = 32'h00281813;
                    6'd4 : data_o = 32'h00271713;
                    6'd5 : data_o = 32'h40b80833;
                    6'd6 : data_o = 32'h40d70733;
                    6'd7 : data_o = 32'h00579793;
                    6'd8 : data_o = 32'h40c787b3;
                    6'd9 : data_o = 32'h00581313;
                    6'd10: data_o = 32'h00671713;
                    6'd11: data_o = 32'h41030333;
                    6'd12: data_o = 32'h00d70733;
                    6'd13: data_o = 32'h00379813;
                    6'd14: data_o = 32'h010787b3;
                    6'd15: data_o = 32'h00471893;
                    6'd16: data_o = 32'h00831813;
                    6'd17: data_o = 32'h40680833;
                    6'd18: data_o = 32'h40e888b3;
                    6'd19: data_o = 32'h00379313;
                    6'd20: data_o = 32'h00481713;
                    6'd21: data_o = 32'h006787b3;
                    6'd22: data_o = 32'h00389813;
                    6'd23: data_o = 32'h00b70733;
                    6'd24: data_o = 32'h40d806b3;
                    6'd25: data_o = 32'h00279793;
                    6'd26: data_o = 32'h00d74733;
                    6'd27: data_o = 32'h00c787b3;
                    6'd28: data_o = 32'h00f74733;
                    6'd29: data_o = 32'h00871793;
                    6'd30: data_o = 32'h40e787b3;
                    6'd31: data_o = 32'h00479793;
                    6'd32: data_o = 32'h40e787b3;
                    6'd33: data_o = 32'h00279793;
                    6'd34: data_o = 32'h40e787b3;
                    6'd35: data_o = 32'h00479793;
                    6'd36: data_o = 32'h00e787b3;
                    6'd37: data_o = 32'h00379793;
                    6'd38: data_o = 32'h00e787b3;
                    6'd39: data_o = 32'h00279693;
                    6'd40: data_o = 32'h00d787b3;
                    6'd41: data_o = 32'h00279793;
                    6'd42: data_o = 32'h40e787b3;
                    6'd43: data_o = 32'h00479793;
                    6'd44: data_o = 32'h40e787b3;
                    6'd45: data_o = 32'h01a7d793;
                    6'd46: data_o = 32'hf10005b7;
                    6'd47: data_o = 32'hf1000f37;
                    6'd48: data_o = 32'h100106b7;
                    6'd49: data_o = 32'h10010337;
                    6'd50: data_o = 32'h00878e93;
                    6'd51: data_o = 32'h02468693;
                    6'd52: data_o = 32'h00858593;
                    6'd53: data_o = 32'h004f0f13;
                    6'd54: data_o = 32'h03f00293;
                    6'd55: data_o = 32'h19c30313;
                    6'd56: data_o = 32'h00100e13;
                    6'd57: data_o = 32'h0005a703;
                    6'd58: data_o = 32'h03f7f613;
                    6'd59: data_o = 32'h00277713;
                    6'd60: data_o = 32'h02070863;
                    6'd61: data_o = 32'h000f2f83;
                    6'd62: data_o = 32'h0005a023;
                    6'd63: data_o = 32'h0006a703;
                    default: data_o = 32'b0;
                endcase
                14'd11  : case (word_addr[5:0])   // words 704..767
                    6'd0 : data_o = 32'h0046a803;
                    6'd1 : data_o = 32'h03f77893;
                    6'd2 : data_o = 32'h41070833;
                    6'd3 : data_o = 32'h011308b3;
                    6'd4 : data_o = 32'h00170713;
                    6'd5 : data_o = 32'h0702e463;
                    6'd6 : data_o = 32'h00e6a023;
                    6'd7 : data_o = 32'h01f88023;
                    6'd8 : data_o = 32'h00c68733;
                    6'd9 : data_o = 32'h00c74703;
                    6'd10: data_o = 32'h00178793;
                    6'd11: data_o = 32'h00070663;
                    6'd12: data_o = 32'h01c70863;
                    6'd13: data_o = 32'hfbd798e3;
                    6'd14: data_o = 32'hfff00513;
                    6'd15: data_o = 32'h00008067;
                    6'd16: data_o = 32'h00161713;
                    6'd17: data_o = 32'h00c70733;
                    6'd18: data_o = 32'h00271713;
                    6'd19: data_o = 32'h00e30733;
                    6'd20: data_o = 32'h04072883;
                    6'd21: data_o = 32'h00052803;
                    6'd22: data_o = 32'hfd089ee3;
                    6'd23: data_o = 32'h04472883;
                    6'd24: data_o = 32'h00452803;
                    6'd25: data_o = 32'hfd0898e3;
                    6'd26: data_o = 32'h04872803;
                    6'd27: data_o = 32'h00852703;
                    6'd28: data_o = 32'hfce812e3;
                    6'd29: data_o = 32'h00060513;
                    6'd30: data_o = 32'h00008067;
                    6'd31: data_o = 32'h0086a703;
                    6'd32: data_o = 32'h00170713;
                    6'd33: data_o = 32'h00e6a423;
                    6'd34: data_o = 32'hf99ff06f;
                    6'd35: data_o = 32'h00452683;
                    6'd36: data_o = 32'h00852603;
                    6'd37: data_o = 32'h00052583;
                    6'd38: data_o = 32'h00369813;
                    6'd39: data_o = 32'h00d80833;
                    6'd40: data_o = 32'h00261793;
                    6'd41: data_o = 32'h00781713;
                    6'd42: data_o = 32'h00c787b3;
                    6'd43: data_o = 32'h41070733;
                    6'd44: data_o = 32'h00279793;
                    6'd45: data_o = 32'h00259813;
                    6'd46: data_o = 32'h00271713;
                    6'd47: data_o = 32'h40c787b3;
                    6'd48: data_o = 32'h00b80833;
                    6'd49: data_o = 32'h40d70733;
                    6'd50: data_o = 32'h00479793;
                    6'd51: data_o = 32'h00381813;
                    6'd52: data_o = 32'h00271713;
                    6'd53: data_o = 32'h40c787b3;
                    6'd54: data_o = 32'h00b80833;
                    6'd55: data_o = 32'h00d70733;
                    6'd56: data_o = 32'h00479793;
                    6'd57: data_o = 32'h40c787b3;
                    6'd58: data_o = 32'h00781813;
                    6'd59: data_o = 32'h00271713;
                    6'd60: data_o = 32'h40b80833;
                    6'd61: data_o = 32'h40d70733;
                    6'd62: data_o = 32'h00679893;
                    6'd63: data_o = 32'h011787b3;
                    default: data_o = 32'b0;
                endcase
                14'd12  : case (word_addr[5:0])   // words 768..831
                    6'd0 : data_o = 32'h00281813;
                    6'd1 : data_o = 32'h00271713;
                    6'd2 : data_o = 32'h40b80833;
                    6'd3 : data_o = 32'h40d70733;
                    6'd4 : data_o = 32'h00579793;
                    6'd5 : data_o = 32'h40c787b3;
                    6'd6 : data_o = 32'h00581313;
                    6'd7 : data_o = 32'h00671713;
                    6'd8 : data_o = 32'h41030333;
                    6'd9 : data_o = 32'h00d70733;
                    6'd10: data_o = 32'h00379813;
                    6'd11: data_o = 32'h010787b3;
                    6'd12: data_o = 32'h00471893;
                    6'd13: data_o = 32'h00831813;
                    6'd14: data_o = 32'h40680833;
                    6'd15: data_o = 32'h40e888b3;
                    6'd16: data_o = 32'h00379313;
                    6'd17: data_o = 32'h00481713;
                    6'd18: data_o = 32'h006787b3;
                    6'd19: data_o = 32'h00389813;
                    6'd20: data_o = 32'h40d806b3;
                    6'd21: data_o = 32'h00b70733;
                    6'd22: data_o = 32'h00279793;
                    6'd23: data_o = 32'h00d74733;
                    6'd24: data_o = 32'h00c787b3;
                    6'd25: data_o = 32'h00f74733;
                    6'd26: data_o = 32'h00871793;
                    6'd27: data_o = 32'h40e787b3;
                    6'd28: data_o = 32'h00479793;
                    6'd29: data_o = 32'h40e787b3;
                    6'd30: data_o = 32'h00279793;
                    6'd31: data_o = 32'h40e787b3;
                    6'd32: data_o = 32'h00479793;
                    6'd33: data_o = 32'h00e787b3;
                    6'd34: data_o = 32'h00379793;
                    6'd35: data_o = 32'h00e787b3;
                    6'd36: data_o = 32'h00279693;
                    6'd37: data_o = 32'h00d787b3;
                    6'd38: data_o = 32'h00279793;
                    6'd39: data_o = 32'h40e787b3;
                    6'd40: data_o = 32'h00479793;
                    6'd41: data_o = 32'h40e787b3;
                    6'd42: data_o = 32'h01a7d793;
                    6'd43: data_o = 32'hf10008b7;
                    6'd44: data_o = 32'hf1000eb7;
                    6'd45: data_o = 32'h100105b7;
                    6'd46: data_o = 32'h10010837;
                    6'd47: data_o = 32'h00878e13;
                    6'd48: data_o = 32'h02458593;
                    6'd49: data_o = 32'h00888893;
                    6'd50: data_o = 32'h004e8e93;
                    6'd51: data_o = 32'h03f00f13;
                    6'd52: data_o = 32'h19c80813;
                    6'd53: data_o = 32'h0008a703;
                    6'd54: data_o = 32'h03f7f693;
                    6'd55: data_o = 32'h00277713;
                    6'd56: data_o = 32'h02070863;
                    6'd57: data_o = 32'h000eaf83;
                    6'd58: data_o = 32'h0008a023;
                    6'd59: data_o = 32'h0005a703;
                    6'd60: data_o = 32'h0045a603;
                    6'd61: data_o = 32'h03f77313;
                    6'd62: data_o = 32'h40c70633;
                    6'd63: data_o = 32'h00680333;
                    default: data_o = 32'b0;
                endcase
                14'd13  : case (word_addr[5:0])   // words 832..895
                    6'd0 : data_o = 32'h00170713;
                    6'd1 : data_o = 32'h06cf6263;
                    6'd2 : data_o = 32'h00e5a023;
                    6'd3 : data_o = 32'h01f30023;
                    6'd4 : data_o = 32'h00d58633;
                    6'd5 : data_o = 32'h00269713;
                    6'd6 : data_o = 32'h04c64603;
                    6'd7 : data_o = 32'h00d70733;
                    6'd8 : data_o = 32'h00271713;
                    6'd9 : data_o = 32'h00e80733;
                    6'd10: data_o = 32'h00178793;
                    6'd11: data_o = 32'h00060a63;
                    6'd12: data_o = 32'h34072303;
                    6'd13: data_o = 32'h00052603;
                    6'd14: data_o = 32'h00c30863;
                    6'd15: data_o = 32'hf9c79ce3;
                    6'd16: data_o = 32'hfff00513;
                    6'd17: data_o = 32'h00008067;
                    6'd18: data_o = 32'h34472303;
                    6'd19: data_o = 32'h00452603;
                    6'd20: data_o = 32'hfec316e3;
                    6'd21: data_o = 32'h34872603;
                    6'd22: data_o = 32'h00852703;
                    6'd23: data_o = 32'hfee610e3;
                    6'd24: data_o = 32'h00068513;
                    6'd25: data_o = 32'h00008067;
                    6'd26: data_o = 32'h0085a703;
                    6'd27: data_o = 32'h00170713;
                    6'd28: data_o = 32'h00e5a423;
                    6'd29: data_o = 32'hf9dff06f;
                    6'd30: data_o = 32'h00452683;
                    6'd31: data_o = 32'h00852803;
                    6'd32: data_o = 32'h00052883;
                    6'd33: data_o = 32'h00369313;
                    6'd34: data_o = 32'h00d30333;
                    6'd35: data_o = 32'h00281793;
                    6'd36: data_o = 32'h00731713;
                    6'd37: data_o = 32'h010787b3;
                    6'd38: data_o = 32'h40670733;
                    6'd39: data_o = 32'h00279793;
                    6'd40: data_o = 32'h00289313;
                    6'd41: data_o = 32'h00271713;
                    6'd42: data_o = 32'h410787b3;
                    6'd43: data_o = 32'h01130333;
                    6'd44: data_o = 32'h40d70733;
                    6'd45: data_o = 32'h00479793;
                    6'd46: data_o = 32'h00331313;
                    6'd47: data_o = 32'h00271713;
                    6'd48: data_o = 32'h410787b3;
                    6'd49: data_o = 32'h01130333;
                    6'd50: data_o = 32'h00d70733;
                    6'd51: data_o = 32'h00479793;
                    6'd52: data_o = 32'h410787b3;
                    6'd53: data_o = 32'h00731313;
                    6'd54: data_o = 32'h00271713;
                    6'd55: data_o = 32'h41130333;
                    6'd56: data_o = 32'h40d70733;
                    6'd57: data_o = 32'h00679e13;
                    6'd58: data_o = 32'h01c787b3;
                    6'd59: data_o = 32'h00231313;
                    6'd60: data_o = 32'h00271713;
                    6'd61: data_o = 32'h41130333;
                    6'd62: data_o = 32'h40d70733;
                    6'd63: data_o = 32'h00579793;
                    default: data_o = 32'b0;
                endcase
                14'd14  : case (word_addr[5:0])   // words 896..959
                    6'd0 : data_o = 32'h410787b3;
                    6'd1 : data_o = 32'h00531e93;
                    6'd2 : data_o = 32'h00671713;
                    6'd3 : data_o = 32'h406e8eb3;
                    6'd4 : data_o = 32'h00d70733;
                    6'd5 : data_o = 32'h00379313;
                    6'd6 : data_o = 32'h006787b3;
                    6'd7 : data_o = 32'h00471e13;
                    6'd8 : data_o = 32'h008e9313;
                    6'd9 : data_o = 32'h41d30333;
                    6'd10: data_o = 32'h40ee0e33;
                    6'd11: data_o = 32'h00379e93;
                    6'd12: data_o = 32'h00431713;
                    6'd13: data_o = 32'h01d787b3;
                    6'd14: data_o = 32'h003e1313;
                    6'd15: data_o = 32'h40d306b3;
                    6'd16: data_o = 32'h01170733;
                    6'd17: data_o = 32'h00279793;
                    6'd18: data_o = 32'h00d74733;
                    6'd19: data_o = 32'h010787b3;
                    6'd20: data_o = 32'h00f74733;
                    6'd21: data_o = 32'h00871793;
                    6'd22: data_o = 32'h40e787b3;
                    6'd23: data_o = 32'h00479793;
                    6'd24: data_o = 32'h40e787b3;
                    6'd25: data_o = 32'h00279793;
                    6'd26: data_o = 32'h40e787b3;
                    6'd27: data_o = 32'h00479793;
                    6'd28: data_o = 32'h00e787b3;
                    6'd29: data_o = 32'h00379793;
                    6'd30: data_o = 32'h00e787b3;
                    6'd31: data_o = 32'h00279693;
                    6'd32: data_o = 32'h00d787b3;
                    6'd33: data_o = 32'h00279793;
                    6'd34: data_o = 32'h40e787b3;
                    6'd35: data_o = 32'h00479793;
                    6'd36: data_o = 32'h40e787b3;
                    6'd37: data_o = 32'hff010113;
                    6'd38: data_o = 32'h01a7d793;
                    6'd39: data_o = 32'hf1000e37;
                    6'd40: data_o = 32'hf10003b7;
                    6'd41: data_o = 32'h10010337;
                    6'd42: data_o = 32'h100108b7;
                    6'd43: data_o = 32'h00812623;
                    6'd44: data_o = 32'h00912423;
                    6'd45: data_o = 32'h01212223;
                    6'd46: data_o = 32'h00878293;
                    6'd47: data_o = 32'h00000e93;
                    6'd48: data_o = 32'h00000f93;
                    6'd49: data_o = 32'h00000f13;
                    6'd50: data_o = 32'h02430313;
                    6'd51: data_o = 32'h19c88893;
                    6'd52: data_o = 32'h008e0e13;
                    6'd53: data_o = 32'h00438393;
                    6'd54: data_o = 32'h03f00413;
                    6'd55: data_o = 32'h0180006f;
                    6'd56: data_o = 32'h41f706b3;
                    6'd57: data_o = 32'h0806c463;
                    6'd58: data_o = 32'h00178793;
                    6'd59: data_o = 32'h00100e93;
                    6'd60: data_o = 32'h08578863;
                    6'd61: data_o = 32'h000e2703;
                    6'd62: data_o = 32'h03f7f813;
                    6'd63: data_o = 32'h00277713;
                    default: data_o = 32'b0;
                endcase
                14'd15  : case (word_addr[5:0])   // words 960..1023
                    6'd0 : data_o = 32'h02070863;
                    6'd1 : data_o = 32'h0003a483;
                    6'd2 : data_o = 32'h000e2023;
                    6'd3 : data_o = 32'h00032703;
                    6'd4 : data_o = 32'h00432683;
                    6'd5 : data_o = 32'h40d706b3;
                    6'd6 : data_o = 32'h0cd46c63;
                    6'd7 : data_o = 32'h03f77693;
                    6'd8 : data_o = 32'h00d886b3;
                    6'd9 : data_o = 32'h00170713;
                    6'd10: data_o = 32'h00e32023;
                    6'd11: data_o = 32'h00968023;
                    6'd12: data_o = 32'h01030733;
                    6'd13: data_o = 32'h04c74703;
                    6'd14: data_o = 32'h0a070863;
                    6'd15: data_o = 32'h00281713;
                    6'd16: data_o = 32'h010706b3;
                    6'd17: data_o = 32'h00269693;
                    6'd18: data_o = 32'h00d886b3;
                    6'd19: data_o = 32'h3406a483;
                    6'd20: data_o = 32'h00052903;
                    6'd21: data_o = 32'h07248e63;
                    6'd22: data_o = 32'h01070733;
                    6'd23: data_o = 32'h00271713;
                    6'd24: data_o = 32'h00e88733;
                    6'd25: data_o = 32'h34c72703;
                    6'd26: data_o = 32'hf60e9ce3;
                    6'd27: data_o = 32'h00178793;
                    6'd28: data_o = 32'h00070f93;
                    6'd29: data_o = 32'h00080f13;
                    6'd30: data_o = 32'h00100e93;
                    6'd31: data_o = 32'hf6579ce3;
                    6'd32: data_o = 32'h002f1793;
                    6'd33: data_o = 32'h01e787b3;
                    6'd34: data_o = 32'h00279793;
                    6'd35: data_o = 32'h00f888b3;
                    6'd36: data_o = 32'h01e30333;
                    6'd37: data_o = 32'h00100793;
                    6'd38: data_o = 32'h04f30623;
                    6'd39: data_o = 32'h00052803;
                    6'd40: data_o = 32'h00452683;
                    6'd41: data_o = 32'h00852703;
                    6'd42: data_o = 32'h00c12403;
                    6'd43: data_o = 32'h3508a023;
                    6'd44: data_o = 32'h34d8a223;
                    6'd45: data_o = 32'h34e8a423;
                    6'd46: data_o = 32'h34b8a823;
                    6'd47: data_o = 32'h34c8a623;
                    6'd48: data_o = 32'h00812483;
                    6'd49: data_o = 32'h00412903;
                    6'd50: data_o = 32'h01010113;
                    6'd51: data_o = 32'h00008067;
                    6'd52: data_o = 32'h00452483;
                    6'd53: data_o = 32'h3446a903;
                    6'd54: data_o = 32'hf89910e3;
                    6'd55: data_o = 32'h3486a483;
                    6'd56: data_o = 32'h00852683;
                    6'd57: data_o = 32'hf6d49ae3;
                    6'd58: data_o = 32'h00080f13;
                    6'd59: data_o = 32'hf95ff06f;
                    6'd60: data_o = 32'h00832703;
                    6'd61: data_o = 32'h00170713;
                    6'd62: data_o = 32'h00e32423;
                    6'd63: data_o = 32'hf35ff06f;
                    default: data_o = 32'b0;
                endcase
                14'd16  : case (word_addr[5:0])   // words 1024..1087
                    6'd0 : data_o = 32'hf10007b7;
                    6'd1 : data_o = 32'h0087a703;
                    6'd2 : data_o = 32'h00878793;
                    6'd3 : data_o = 32'h00277713;
                    6'd4 : data_o = 32'h0c071463;
                    6'd5 : data_o = 32'h10010e37;
                    6'd6 : data_o = 32'h024e0e13;
                    6'd7 : data_o = 32'h08ce2603;
                    6'd8 : data_o = 32'h10060c63;
                    6'd9 : data_o = 32'h100118b7;
                    6'd10: data_o = 32'h19c88893;
                    6'd11: data_o = 32'h00052803;
                    6'd12: data_o = 32'h84088793;
                    6'd13: data_o = 32'h00000713;
                    6'd14: data_o = 32'h0100006f;
                    6'd15: data_o = 32'h00170713;
                    6'd16: data_o = 32'h01478793;
                    6'd17: data_o = 32'h04e60663;
                    6'd18: data_o = 32'h0007a683;
                    6'd19: data_o = 32'hff0698e3;
                    6'd20: data_o = 32'h0047a303;
                    6'd21: data_o = 32'h00452683;
                    6'd22: data_o = 32'hfed312e3;
                    6'd23: data_o = 32'h0087a303;
                    6'd24: data_o = 32'h00852683;
                    6'd25: data_o = 32'hfcd31ce3;
                    6'd26: data_o = 32'h00271793;
                    6'd27: data_o = 32'h00e787b3;
                    6'd28: data_o = 32'h00279793;
                    6'd29: data_o = 32'h00f888b3;
                    6'd30: data_o = 32'h84c8a783;
                    6'd31: data_o = 32'h8508a703;
                    6'd32: data_o = 32'h00178793;
                    6'd33: data_o = 32'h84f8a623;
                    6'd34: data_o = 32'h0ab76463;
                    6'd35: data_o = 32'h00008067;
                    6'd36: data_o = 32'h00400793;
                    6'd37: data_o = 32'h04f60063;
                    6'd38: data_o = 32'h00160713;
                    6'd39: data_o = 32'h00261793;
                    6'd40: data_o = 32'h00052683;
                    6'd41: data_o = 32'h00c787b3;
                    6'd42: data_o = 32'h00279793;
                    6'd43: data_o = 32'h00f888b3;
                    6'd44: data_o = 32'h84d8a023;
                    6'd45: data_o = 32'h00452783;
                    6'd46: data_o = 32'h08ee2623;
                    6'd47: data_o = 32'h00100713;
                    6'd48: data_o = 32'h84f8a223;
                    6'd49: data_o = 32'h00852783;
                    6'd50: data_o = 32'h84e8a623;
                    6'd51: data_o = 32'h84b8a823;
                    6'd52: data_o = 32'h84f8a423;
                    6'd53: data_o = 32'h00008067;
                    6'd54: data_o = 32'hf10006b7;
                    6'd55: data_o = 32'h10010e37;
                    6'd56: data_o = 32'h024e0e13;
                    6'd57: data_o = 32'h0046a803;
                    6'd58: data_o = 32'h0007a023;
                    6'd59: data_o = 32'h000e2783;
                    6'd60: data_o = 32'h004e2703;
                    6'd61: data_o = 32'h03f00613;
                    6'd62: data_o = 32'h40e78733;
                    6'd63: data_o = 32'h02e66263;
                    default: data_o = 32'b0;
                endcase
                14'd17  : case (word_addr[5:0])   // words 1088..1151
                    6'd0 : data_o = 32'h10010737;
                    6'd1 : data_o = 32'h03f7f693;
                    6'd2 : data_o = 32'h19c70713;
                    6'd3 : data_o = 32'h00178793;
                    6'd4 : data_o = 32'h00d70733;
                    6'd5 : data_o = 32'h00fe2023;
                    6'd6 : data_o = 32'h01070023;
                    6'd7 : data_o = 32'hf01ff06f;
                    6'd8 : data_o = 32'h008e2783;
                    6'd9 : data_o = 32'h00178793;
                    6'd10: data_o = 32'h00fe2423;
                    6'd11: data_o = 32'hef1ff06f;
                    6'd12: data_o = 32'h84b8a823;
                    6'd13: data_o = 32'h00008067;
                    6'd14: data_o = 32'h100118b7;
                    6'd15: data_o = 32'h00100713;
                    6'd16: data_o = 32'h19c88893;
                    6'd17: data_o = 32'hf59ff06f;
                    6'd18: data_o = 32'h0025d783;
                    6'd19: data_o = 32'h0005d703;
                    6'd20: data_o = 32'h01079793;
                    6'd21: data_o = 32'h00e7e7b3;
                    6'd22: data_o = 32'h00f52023;
                    6'd23: data_o = 32'h0065d783;
                    6'd24: data_o = 32'h0045d703;
                    6'd25: data_o = 32'h01079793;
                    6'd26: data_o = 32'h00e7e7b3;
                    6'd27: data_o = 32'h00f52223;
                    6'd28: data_o = 32'h00a5d783;
                    6'd29: data_o = 32'h0085d703;
                    6'd30: data_o = 32'h01079793;
                    6'd31: data_o = 32'h00e7e7b3;
                    6'd32: data_o = 32'h00f52423;
                    6'd33: data_o = 32'h00008067;
                    6'd34: data_o = 32'hf1000eb7;
                    6'd35: data_o = 32'h10010637;
                    6'd36: data_o = 32'h100118b7;
                    6'd37: data_o = 32'h00000793;
                    6'd38: data_o = 32'h02460613;
                    6'd39: data_o = 32'h19c88893;
                    6'd40: data_o = 32'h00300313;
                    6'd41: data_o = 32'h00800e13;
                    6'd42: data_o = 32'h008e8e93;
                    6'd43: data_o = 32'h09062683;
                    6'd44: data_o = 32'h00f50733;
                    6'd45: data_o = 32'h00074803;
                    6'd46: data_o = 32'h07f6f713;
                    6'd47: data_o = 32'h00168593;
                    6'd48: data_o = 32'h00e88733;
                    6'd49: data_o = 32'h08b62823;
                    6'd50: data_o = 32'h89070823;
                    6'd51: data_o = 32'h06678063;
                    6'd52: data_o = 32'h00178793;
                    6'd53: data_o = 32'hfdc79ce3;
                    6'd54: data_o = 32'hf10007b7;
                    6'd55: data_o = 32'h0087a703;
                    6'd56: data_o = 32'h00878793;
                    6'd57: data_o = 32'h00277713;
                    6'd58: data_o = 32'h06070e63;
                    6'd59: data_o = 32'hf1000737;
                    6'd60: data_o = 32'h00472503;
                    6'd61: data_o = 32'h0007a023;
                    6'd62: data_o = 32'h00062683;
                    6'd63: data_o = 32'h00462783;
                    default: data_o = 32'b0;
                endcase
                14'd18  : case (word_addr[5:0])   // words 1152..1215
                    6'd0 : data_o = 32'h03f00593;
                    6'd1 : data_o = 32'h40f687b3;
                    6'd2 : data_o = 32'h0af5e863;
                    6'd3 : data_o = 32'h100107b7;
                    6'd4 : data_o = 32'h03f6f713;
                    6'd5 : data_o = 32'h19c78793;
                    6'd6 : data_o = 32'h00168693;
                    6'd7 : data_o = 32'h00e787b3;
                    6'd8 : data_o = 32'h00d62023;
                    6'd9 : data_o = 32'h00a78023;
                    6'd10: data_o = 32'h00008067;
                    6'd11: data_o = 32'h000ea783;
                    6'd12: data_o = 32'hf1000737;
                    6'd13: data_o = 32'h07f5f593;
                    6'd14: data_o = 32'h0027f793;
                    6'd15: data_o = 32'h00470713;
                    6'd16: data_o = 32'h03f00813;
                    6'd17: data_o = 32'h00268693;
                    6'd18: data_o = 32'h00b885b3;
                    6'd19: data_o = 32'h00079e63;
                    6'd20: data_o = 32'h00454703;
                    6'd21: data_o = 32'h08d62823;
                    6'd22: data_o = 32'h00400793;
                    6'd23: data_o = 32'h88e58823;
                    6'd24: data_o = 32'hf71ff06f;
                    6'd25: data_o = 32'h00008067;
                    6'd26: data_o = 32'h00072f03;
                    6'd27: data_o = 32'h000ea023;
                    6'd28: data_o = 32'h00062783;
                    6'd29: data_o = 32'h00462683;
                    6'd30: data_o = 32'h03f7f593;
                    6'd31: data_o = 32'h40d786b3;
                    6'd32: data_o = 32'h00178713;
                    6'd33: data_o = 32'h100107b7;
                    6'd34: data_o = 32'h19c78793;
                    6'd35: data_o = 32'h00b787b3;
                    6'd36: data_o = 32'h00d86a63;
                    6'd37: data_o = 32'h01e78023;
                    6'd38: data_o = 32'h00e62023;
                    6'd39: data_o = 32'h00400793;
                    6'd40: data_o = 32'hf0dff06f;
                    6'd41: data_o = 32'h00862783;
                    6'd42: data_o = 32'h00178793;
                    6'd43: data_o = 32'h00f62423;
                    6'd44: data_o = 32'h00400793;
                    6'd45: data_o = 32'hef9ff06f;
                    6'd46: data_o = 32'h00862783;
                    6'd47: data_o = 32'h00178793;
                    6'd48: data_o = 32'h00f62423;
                    6'd49: data_o = 32'h00008067;
                    6'd50: data_o = 32'hfc010113;
                    6'd51: data_o = 32'h02812c23;
                    6'd52: data_o = 32'h10010437;
                    6'd53: data_o = 32'h02912a23;
                    6'd54: data_o = 32'h03312623;
                    6'd55: data_o = 32'h03412423;
                    6'd56: data_o = 32'h03512223;
                    6'd57: data_o = 32'h02440413;
                    6'd58: data_o = 32'hf10004b7;
                    6'd59: data_o = 32'h10010ab7;
                    6'd60: data_o = 32'h01000a37;
                    6'd61: data_o = 32'h000109b7;
                    6'd62: data_o = 32'h03212823;
                    6'd63: data_o = 32'h03612023;
                    default: data_o = 32'b0;
                endcase
                14'd19  : case (word_addr[5:0])   // words 1216..1279
                    6'd0 : data_o = 32'h02112e23;
                    6'd1 : data_o = 32'h01712e23;
                    6'd2 : data_o = 32'hfff50b13;
                    6'd3 : data_o = 32'h09440913;
                    6'd4 : data_o = 32'h00848493;
                    6'd5 : data_o = 32'h19ca8a93;
                    6'd6 : data_o = 32'hfffa0a13;
                    6'd7 : data_o = 32'hfff98993;
                    6'd8 : data_o = 32'h0100006f;
                    6'd9 : data_o = 32'hfffb0b13;
                    6'd10: data_o = 32'hfff00793;
                    6'd11: data_o = 32'h1cfb0663;
                    6'd12: data_o = 32'h0a442783;
                    6'd13: data_o = 32'h1c078263;
                    6'd14: data_o = 32'h00090513;
                    6'd15: data_o = 32'hfffff097;
                    6'd16: data_o = 32'h1c4080e7;
                    6'd17: data_o = 32'h0004a783;
                    6'd18: data_o = 32'h0027f793;
                    6'd19: data_o = 32'h02078c63;
                    6'd20: data_o = 32'hf10006b7;
                    6'd21: data_o = 32'h0046a583;
                    6'd22: data_o = 32'h0004a023;
                    6'd23: data_o = 32'h00042783;
                    6'd24: data_o = 32'h00442703;
                    6'd25: data_o = 32'h03f00613;
                    6'd26: data_o = 32'h40e78733;
                    6'd27: data_o = 32'h1ae66c63;
                    6'd28: data_o = 32'h03f7f713;
                    6'd29: data_o = 32'h00ea8733;
                    6'd30: data_o = 32'h00178793;
                    6'd31: data_o = 32'h00f42023;
                    6'd32: data_o = 32'h00b70023;
                    6'd33: data_o = 32'h0a442783;
                    6'd34: data_o = 32'hfff78793;
                    6'd35: data_o = 32'h0af42223;
                    6'd36: data_o = 32'hf8079ae3;
                    6'd37: data_o = 32'h0b842703;
                    6'd38: data_o = 32'h09042783;
                    6'd39: data_o = 32'h09442b83;
                    6'd40: data_o = 32'h0a842683;
                    6'd41: data_o = 32'h40e787b3;
                    6'd42: data_o = 32'h07800713;
                    6'd43: data_o = 32'h00dbcbb3;
                    6'd44: data_o = 32'h18f76a63;
                    6'd45: data_o = 32'h0c040513;
                    6'd46: data_o = 32'h00000097;
                    6'd47: data_o = 32'hdd0080e7;
                    6'd48: data_o = 32'h0004a783;
                    6'd49: data_o = 32'h0027f793;
                    6'd50: data_o = 32'h04078063;
                    6'd51: data_o = 32'hf1000737;
                    6'd52: data_o = 32'h00472583;
                    6'd53: data_o = 32'h0004a023;
                    6'd54: data_o = 32'h00042683;
                    6'd55: data_o = 32'h00442783;
                    6'd56: data_o = 32'h03f00613;
                    6'd57: data_o = 32'h40f687b3;
                    6'd58: data_o = 32'h16f66e63;
                    6'd59: data_o = 32'h100107b7;
                    6'd60: data_o = 32'h03f6f713;
                    6'd61: data_o = 32'h19c78793;
                    6'd62: data_o = 32'h00168693;
                    6'd63: data_o = 32'h00e787b3;
                    default: data_o = 32'b0;
                endcase
                14'd20  : case (word_addr[5:0])   // words 1280..1343
                    6'd0 : data_o = 32'h00d42023;
                    6'd1 : data_o = 32'h00b78023;
                    6'd2 : data_o = 32'h0c144783;
                    6'd3 : data_o = 32'h0ffbf693;
                    6'd4 : data_o = 32'h008bd713;
                    6'd5 : data_o = 32'h00869693;
                    6'd6 : data_o = 32'h0ff77713;
                    6'd7 : data_o = 32'h01071713;
                    6'd8 : data_o = 32'h00d7e7b3;
                    6'd9 : data_o = 32'h00e7e7b3;
                    6'd10: data_o = 32'h010bd713;
                    6'd11: data_o = 32'h01871713;
                    6'd12: data_o = 32'h0147f7b3;
                    6'd13: data_o = 32'h00e7e7b3;
                    6'd14: data_o = 32'h018bdb93;
                    6'd15: data_o = 32'h00f12023;
                    6'd16: data_o = 32'h01710223;
                    6'd17: data_o = 32'h04100793;
                    6'd18: data_o = 32'h81378633;
                    6'd19: data_o = 32'h00f10423;
                    6'd20: data_o = 32'h00010713;
                    6'd21: data_o = 32'h00910793;
                    6'd22: data_o = 32'h00e10593;
                    6'd23: data_o = 32'h00074683;
                    6'd24: data_o = 32'h00d78023;
                    6'd25: data_o = 32'h80c68633;
                    6'd26: data_o = 32'h00178793;
                    6'd27: data_o = 32'h00170713;
                    6'd28: data_o = 32'hfef596e3;
                    6'd29: data_o = 32'h00c11723;
                    6'd30: data_o = 32'h0004a783;
                    6'd31: data_o = 32'h0027f793;
                    6'd32: data_o = 32'h04078063;
                    6'd33: data_o = 32'hf1000737;
                    6'd34: data_o = 32'h00472583;
                    6'd35: data_o = 32'h0004a023;
                    6'd36: data_o = 32'h00042683;
                    6'd37: data_o = 32'h00442783;
                    6'd38: data_o = 32'h03f00613;
                    6'd39: data_o = 32'h40f687b3;
                    6'd40: data_o = 32'h0af66a63;
                    6'd41: data_o = 32'h100107b7;
                    6'd42: data_o = 32'h03f6f713;
                    6'd43: data_o = 32'h19c78793;
                    6'd44: data_o = 32'h00168693;
                    6'd45: data_o = 32'h00e787b3;
                    6'd46: data_o = 32'h00d42023;
                    6'd47: data_o = 32'h00b78023;
                    6'd48: data_o = 32'h09042783;
                    6'd49: data_o = 32'h0b842683;
                    6'd50: data_o = 32'h07800713;
                    6'd51: data_o = 32'h40d787b3;
                    6'd52: data_o = 32'h06f76263;
                    6'd53: data_o = 32'h00810513;
                    6'd54: data_o = 32'h00000097;
                    6'd55: data_o = 32'hcb0080e7;
                    6'd56: data_o = 32'h0c842783;
                    6'd57: data_o = 32'hfffb0b13;
                    6'd58: data_o = 32'h00178793;
                    6'd59: data_o = 32'h0cf42423;
                    6'd60: data_o = 32'hfff00793;
                    6'd61: data_o = 32'he2fb1ee3;
                    6'd62: data_o = 32'h03c12083;
                    6'd63: data_o = 32'h03812403;
                    default: data_o = 32'b0;
                endcase
                14'd21  : case (word_addr[5:0])   // words 1344..1407
                    6'd0 : data_o = 32'h03412483;
                    6'd1 : data_o = 32'h03012903;
                    6'd2 : data_o = 32'h02c12983;
                    6'd3 : data_o = 32'h02812a03;
                    6'd4 : data_o = 32'h02412a83;
                    6'd5 : data_o = 32'h02012b03;
                    6'd6 : data_o = 32'h01c12b83;
                    6'd7 : data_o = 32'h04010113;
                    6'd8 : data_o = 32'h00008067;
                    6'd9 : data_o = 32'h00842783;
                    6'd10: data_o = 32'h00178793;
                    6'd11: data_o = 32'h00f42423;
                    6'd12: data_o = 32'he55ff06f;
                    6'd13: data_o = 32'h0bc42783;
                    6'd14: data_o = 32'h00178793;
                    6'd15: data_o = 32'h0af42e23;
                    6'd16: data_o = 32'hfa1ff06f;
                    6'd17: data_o = 32'h0bc42783;
                    6'd18: data_o = 32'h00178793;
                    6'd19: data_o = 32'h0af42e23;
                    6'd20: data_o = 32'he71ff06f;
                    6'd21: data_o = 32'h00842783;
                    6'd22: data_o = 32'h00178793;
                    6'd23: data_o = 32'h00f42423;
                    6'd24: data_o = 32'hf61ff06f;
                    6'd25: data_o = 32'h00842783;
                    6'd26: data_o = 32'h00178793;
                    6'd27: data_o = 32'h00f42423;
                    6'd28: data_o = 32'he99ff06f;
                    6'd29: data_o = 32'hfe010113;
                    6'd30: data_o = 32'h00812c23;
                    6'd31: data_o = 32'h10010437;
                    6'd32: data_o = 32'h02440413;
                    6'd33: data_o = 32'h0cc42703;
                    6'd34: data_o = 32'h0ff5f593;
                    6'd35: data_o = 32'h00859593;
                    6'd36: data_o = 32'h0ff57513;
                    6'd37: data_o = 32'h00b567b3;
                    6'd38: data_o = 32'h00c00513;
                    6'd39: data_o = 32'h00f11023;
                    6'd40: data_o = 32'h00112e23;
                    6'd41: data_o = 32'h00e10123;
                    6'd42: data_o = 32'h000101a3;
                    6'd43: data_o = 32'h00010223;
                    6'd44: data_o = 32'h00000097;
                    6'd45: data_o = 32'hd18080e7;
                    6'd46: data_o = 32'h000106b7;
                    6'd47: data_o = 32'h04500793;
                    6'd48: data_o = 32'hfff68693;
                    6'd49: data_o = 32'h80d786b3;
                    6'd50: data_o = 32'h00f10423;
                    6'd51: data_o = 32'h00010713;
                    6'd52: data_o = 32'h00910793;
                    6'd53: data_o = 32'h00e10593;
                    6'd54: data_o = 32'h00074603;
                    6'd55: data_o = 32'h00c78023;
                    6'd56: data_o = 32'h80d606b3;
                    6'd57: data_o = 32'h00178793;
                    6'd58: data_o = 32'h00170713;
                    6'd59: data_o = 32'hfeb796e3;
                    6'd60: data_o = 32'h09042783;
                    6'd61: data_o = 32'h0b842603;
                    6'd62: data_o = 32'h00d11723;
                    6'd63: data_o = 32'h07800713;
                    default: data_o = 32'b0;
                endcase
                14'd22  : case (word_addr[5:0])   // words 1408..1471
                    6'd0 : data_o = 32'h40c787b3;
                    6'd1 : data_o = 32'h02f76463;
                    6'd2 : data_o = 32'h00810513;
                    6'd3 : data_o = 32'h00000097;
                    6'd4 : data_o = 32'hb7c080e7;
                    6'd5 : data_o = 32'h01c12083;
                    6'd6 : data_o = 32'h01812403;
                    6'd7 : data_o = 32'h100107b7;
                    6'd8 : data_o = 32'h0007a023;
                    6'd9 : data_o = 32'h02010113;
                    6'd10: data_o = 32'h00008067;
                    6'd11: data_o = 32'h0bc42783;
                    6'd12: data_o = 32'h01c12083;
                    6'd13: data_o = 32'h00178793;
                    6'd14: data_o = 32'h0af42e23;
                    6'd15: data_o = 32'h01812403;
                    6'd16: data_o = 32'h100107b7;
                    6'd17: data_o = 32'h0007a023;
                    6'd18: data_o = 32'h02010113;
                    6'd19: data_o = 32'h00008067;
                    6'd20: data_o = 32'hfe010113;
                    6'd21: data_o = 32'h00912a23;
                    6'd22: data_o = 32'h00050493;
                    6'd23: data_o = 32'h00c00513;
                    6'd24: data_o = 32'h00812c23;
                    6'd25: data_o = 32'h00112e23;
                    6'd26: data_o = 32'h00058413;
                    6'd27: data_o = 32'h00000097;
                    6'd28: data_o = 32'hc5c080e7;
                    6'd29: data_o = 32'h00010737;
                    6'd30: data_o = 32'hfff70713;
                    6'd31: data_o = 32'h80e48733;
                    6'd32: data_o = 32'h00040593;
                    6'd33: data_o = 32'h00910423;
                    6'd34: data_o = 32'h00910793;
                    6'd35: data_o = 32'h00540613;
                    6'd36: data_o = 32'h0005c683;
                    6'd37: data_o = 32'h00d78023;
                    6'd38: data_o = 32'h80e68733;
                    6'd39: data_o = 32'h00158593;
                    6'd40: data_o = 32'h00178793;
                    6'd41: data_o = 32'hfeb616e3;
                    6'd42: data_o = 32'h100107b7;
                    6'd43: data_o = 32'h02478793;
                    6'd44: data_o = 32'h0d07a683;
                    6'd45: data_o = 32'h00e11723;
                    6'd46: data_o = 32'h0a068063;
                    6'd47: data_o = 32'h10010737;
                    6'd48: data_o = 32'h00472703;
                    6'd49: data_o = 32'h00c15f83;
                    6'd50: data_o = 32'h0a87af03;
                    6'd51: data_o = 32'h0d47a583;
                    6'd52: data_o = 32'h0d87a503;
                    6'd53: data_o = 32'h0ac7ae83;
                    6'd54: data_o = 32'h01071713;
                    6'd55: data_o = 32'h01e5c5b3;
                    6'd56: data_o = 32'h01f76733;
                    6'd57: data_o = 32'h04000f37;
                    6'd58: data_o = 32'h01d54533;
                    6'd59: data_o = 32'h01e76733;
                    6'd60: data_o = 32'h00812803;
                    6'd61: data_o = 32'h00a74733;
                    6'd62: data_o = 32'h00c12503;
                    6'd63: data_o = 32'h0dc7a603;
                    default: data_o = 32'b0;
                endcase
                14'd23  : case (word_addr[5:0])   // words 1472..1535
                    6'd0 : data_o = 32'h0b07ae03;
                    6'd1 : data_o = 32'h0e07a683;
                    6'd2 : data_o = 32'h0b47a303;
                    6'd3 : data_o = 32'h0c87a883;
                    6'd4 : data_o = 32'h0d07a023;
                    6'd5 : data_o = 32'h0ca7a223;
                    6'd6 : data_o = 32'h01c12083;
                    6'd7 : data_o = 32'h01812403;
                    6'd8 : data_o = 32'h01c64633;
                    6'd9 : data_o = 32'h0066c6b3;
                    6'd10: data_o = 32'h08e7ac23;
                    6'd11: data_o = 32'h0105c5b3;
                    6'd12: data_o = 32'h01164633;
                    6'd13: data_o = 32'h0016c693;
                    6'd14: data_o = 32'h00c00713;
                    6'd15: data_o = 32'h08b7aa23;
                    6'd16: data_o = 32'h08c7ae23;
                    6'd17: data_o = 32'h0ad7a023;
                    6'd18: data_o = 32'h0ae7a223;
                    6'd19: data_o = 32'h01412483;
                    6'd20: data_o = 32'h02010113;
                    6'd21: data_o = 32'h00008067;
                    6'd22: data_o = 32'h0907a703;
                    6'd23: data_o = 32'h0b87a603;
                    6'd24: data_o = 32'h07800693;
                    6'd25: data_o = 32'h40c70733;
                    6'd26: data_o = 32'h02e6e263;
                    6'd27: data_o = 32'h00810513;
                    6'd28: data_o = 32'h00000097;
                    6'd29: data_o = 32'ha18080e7;
                    6'd30: data_o = 32'h01c12083;
                    6'd31: data_o = 32'h01812403;
                    6'd32: data_o = 32'h01412483;
                    6'd33: data_o = 32'h02010113;
                    6'd34: data_o = 32'h00008067;
                    6'd35: data_o = 32'h0bc7a703;
                    6'd36: data_o = 32'h01c12083;
                    6'd37: data_o = 32'h01812403;
                    6'd38: data_o = 32'h00170713;
                    6'd39: data_o = 32'h0ae7ae23;
                    6'd40: data_o = 32'h01412483;
                    6'd41: data_o = 32'h02010113;
                    6'd42: data_o = 32'h00008067;
                    6'd43: data_o = 32'hfb010113;
                    6'd44: data_o = 32'h04812423;
                    6'd45: data_o = 32'h10010437;
                    6'd46: data_o = 32'h02440413;
                    6'd47: data_o = 32'h0e442703;
                    6'd48: data_o = 32'h004037b7;
                    6'd49: data_o = 32'hb6878793;
                    6'd50: data_o = 32'h00e787b3;
                    6'd51: data_o = 32'h03512a23;
                    6'd52: data_o = 32'h0007ca83;
                    6'd53: data_o = 32'h08c42783;
                    6'd54: data_o = 32'h05212023;
                    6'd55: data_o = 32'h03712623;
                    6'd56: data_o = 32'h04112623;
                    6'd57: data_o = 32'h03312e23;
                    6'd58: data_o = 32'h03412c23;
                    6'd59: data_o = 32'h03612823;
                    6'd60: data_o = 32'h0e042623;
                    6'd61: data_o = 32'h0e042823;
                    6'd62: data_o = 32'h0e842903;
                    6'd63: data_o = 32'h000a8b93;
                    default: data_o = 32'b0;
                endcase
                14'd24  : case (word_addr[5:0])   // words 1536..1599
                    6'd0 : data_o = 32'h2e078a63;
                    6'd1 : data_o = 32'h04912223;
                    6'd2 : data_o = 32'h03812423;
                    6'd3 : data_o = 32'h100114b7;
                    6'd4 : data_o = 32'hf1000c37;
                    6'd5 : data_o = 32'hf1000b37;
                    6'd6 : data_o = 32'h100117b7;
                    6'd7 : data_o = 32'h100109b7;
                    6'd8 : data_o = 32'h10010a37;
                    6'd9 : data_o = 32'h03912223;
                    6'd10: data_o = 32'h03a12023;
                    6'd11: data_o = 32'h01b12e23;
                    6'd12: data_o = 32'h19c48493;
                    6'd13: data_o = 32'h9dc78d93;
                    6'd14: data_o = 32'h00000d13;
                    6'd15: data_o = 32'hfff00c93;
                    6'd16: data_o = 32'h008c0c13;
                    6'd17: data_o = 32'h004b0b13;
                    6'd18: data_o = 32'h19c98993;
                    6'd19: data_o = 32'h000a0a13;
                    6'd20: data_o = 32'h000c2783;
                    6'd21: data_o = 32'h0027f793;
                    6'd22: data_o = 32'h02078a63;
                    6'd23: data_o = 32'h000b2583;
                    6'd24: data_o = 32'h000c2023;
                    6'd25: data_o = 32'h00042783;
                    6'd26: data_o = 32'h00442603;
                    6'd27: data_o = 32'h03f00713;
                    6'd28: data_o = 32'h40c78633;
                    6'd29: data_o = 32'h1ac76c63;
                    6'd30: data_o = 32'h03f7f613;
                    6'd31: data_o = 32'h00c98633;
                    6'd32: data_o = 32'h00178793;
                    6'd33: data_o = 32'h00f42023;
                    6'd34: data_o = 32'h00b60023;
                    6'd35: data_o = 32'h000d8513;
                    6'd36: data_o = 32'hfffff097;
                    6'd37: data_o = 32'h2fc080e7;
                    6'd38: data_o = 32'h02054063;
                    6'd39: data_o = 32'h00251793;
                    6'd40: data_o = 32'h00a787b3;
                    6'd41: data_o = 32'h00279793;
                    6'd42: data_o = 32'h00f987b3;
                    6'd43: data_o = 32'h3507a583;
                    6'd44: data_o = 32'h004a2603;
                    6'd45: data_o = 32'h14c58c63;
                    6'd46: data_o = 32'h160cc663;
                    6'd47: data_o = 32'h002c9793;
                    6'd48: data_o = 32'h019787b3;
                    6'd49: data_o = 32'h00279793;
                    6'd50: data_o = 32'h00f487b3;
                    6'd51: data_o = 32'h00cda583;
                    6'd52: data_o = 32'h84c7a603;
                    6'd53: data_o = 32'h14b66863;
                    6'd54: data_o = 32'h1ec58c63;
                    6'd55: data_o = 32'h08c42783;
                    6'd56: data_o = 32'h001d0d13;
                    6'd57: data_o = 32'h014d8d93;
                    6'd58: data_o = 32'hf6fd64e3;
                    6'd59: data_o = 32'h14090863;
                    6'd60: data_o = 32'h04412483;
                    6'd61: data_o = 32'h02812c03;
                    6'd62: data_o = 32'h02412c83;
                    6'd63: data_o = 32'h02012d03;
                    default: data_o = 32'b0;
                endcase
                14'd25  : case (word_addr[5:0])   // words 1600..1663
                    6'd0 : data_o = 32'h01c12d83;
                    6'd1 : data_o = 32'h00000b93;
                    6'd2 : data_o = 32'h00000b13;
                    6'd3 : data_o = 32'h00000993;
                    6'd4 : data_o = 32'h00700793;
                    6'd5 : data_o = 32'h00600a13;
                    6'd6 : data_o = 32'h00000913;
                    6'd7 : data_o = 32'h10842683;
                    6'd8 : data_o = 32'hf1000737;
                    6'd9 : data_o = 32'h00870713;
                    6'd10: data_o = 32'h00168693;
                    6'd11: data_o = 32'h10d42423;
                    6'd12: data_o = 32'h00072683;
                    6'd13: data_o = 32'h0026f693;
                    6'd14: data_o = 32'h04068063;
                    6'd15: data_o = 32'hf1000637;
                    6'd16: data_o = 32'h00462503;
                    6'd17: data_o = 32'h00072023;
                    6'd18: data_o = 32'h00042703;
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
