Niccc8/rvbl2-riscv-cpu-core/(commit log)

2026-09-14 RVBL-2: multicycle RISC-V core, RTL through signed-off GDSII
    A 32-bit RISC-V core implementing RV32I + Zmmul + Xicrc (47 instructions),
    designed and verified as hierarchical RTL, entered on the ChipInventor block
    canvas, and taken through OpenLane to a clean Sky130 layout.
    The repository holds one processor expressed two ways, plus the checks that
    prove they are the same processor:
    rtl/ + tb/ reference design, 15 testbenches, 7,384 checks
    chipinventor/ the flattened canvas implementation and its exported netlist
    platform suite: 15,281 checks on the netlist the canvas produced
    lockstep equivalence: 410,400 cycle comparisons, 0 mismatches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
    [metrics.csv]
2026-09-14 Pin line endings so the shell scripts survive a clone on any platform
    Both verification suites and the OpenLane runners are shell scripts executed
    under WSL/Docker. A CRLF line ending there makes the interpreter line fail with
    a misleading "not found", and nothing in the repository guaranteed LF for a
    contributor whose git has core.autocrlf set differently.
    Adding .gitattributes changes no existing file: the index already held LF for
    every text file, confirmed with git add --renormalize, which staged nothing.
2026-09-14 Add the submission-archive builder, and ignore the archive itself
    The portal takes the source code as a ZIP of at most 20 MB. Building it by hand
    is easy to get wrong: the Guide's section 9 list has six items, two of which
    are easy to miss, and the GL netlist has to keep its results/final/verilog/gl
    path because section 9 names that folder explicitly.
    scripts/make_submission_zip.py builds it reproducibly and refuses to exit 0 if
    the result exceeds the limit. Current output is 10.73 MB -- top.gds is 48.7 MB
    raw but deflates to about 9.7 MB.
    The archive is gitignored rather than committed: it duplicates around 10 MB
    already in the tree, and a committed copy would go stale silently.
    Verified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
    [make_submission_zip.py]
2026-09-27 Add the GPIO and UART, and a peripheral region in the address decoder
    The Stage 3 hardware of Block Guide sections 1 and 2. The address decoder
    gains one peripheral region (0xF0000000-0xFFFFFFFF); each peripheral decodes
    its own 16 MB slot: the GPIO in slot 0, the UART in slot 1. Read data returns
    through a chain, so adding a peripheral changes no other block.
    - gpio.v: DATAOUT, DATAIN, DATADIR; every pin an input after reset; a
    two-flip-flop synchroniser on each input. tb_gpio: 42 checks.
    - uart.v: 8-N-1 at 115,200 bps, 263 cycles per bit from two parameters,
    mid-bit sampling (the far end's clock may be 3.5 % off); a byte and a
    software clear in the same cycle keep the byte. tb_uart: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
    [address_decoder.v, asm.py, check_ci_sync.py, gen_stage3_progs.py, gpio.v, tb_address_decoder.v, tb_ci_equiv.v, tb_core.v]
2026-09-27 Draw the Stage 3 design on ChipInventor as two projects
    The SoC project rvbl2_soc (21 blocks: the Stage 2 core, the data memory, the
    decoder, the GPIO and the UART, no pins) and the chip project top (the SoC as
    one block, the instruction memory, gpio_bits and 12 pins, 8 of them Inout
    Pins). One SoC serves every target, and a program goes in by pasting one
    imem block.
    - blocks/: gpio.v, uart.v, gpio_bits.v, and the updated decoder; ci_top.v
    mirrors both projects, and tb_mirror_equiv keeps it cycle-identical to the
    reference RTL.
    - export_stage3.v: the platform's own export. check_export.py compares it
    with ci_top.v as a graph, wire by wire, including each Inout Pin's C/D
    polarity, an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
2026-09-27 Add the official firmware testbench, with the organisers' Firmware Builder
    The organisers' GPIO and UART test firmware (main.s, firmware.txt) and their
    Firmware Builder, both copied unchanged from their Stage 3 repository. Their
    Makefile rebuilds firmware.txt from main.s byte for byte.
    - imem_official.v: the firmware.txt lines, verbatim, in the imem case.
    - tb_official_firmware.v: drives only the chip's pins. 0xA on P3-P0 must show
    on P7-P4 and 0x30 must echo, then all 16 pin values: 34 checks, on the
    canvas design, the platform's export and the ChipInventor simulator.
    - tb_wave_official.v: a 0.39 ms run with only the signals worth showing, for
    the platform's waveform viewer.
    - emu_co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
2026-09-27 Add LaneX, the MLFF edge controller: definition, firmware and validation
    The Stage 3 application (brief sections 4 to 6): the controller of one lane
    of a Multi-Lane Free Flow toll gantry. Tag reads and back-end frames arrive on
    the UART, vehicle presence and class on GPIO P3-P0; the chip decides each
    vehicle, sets P7-P4, and sends one 8-byte record sealed with a CRC-16 and,
    with a key loaded, a Chaskey-12 tag.
    - PROTOCOL.md: every frame, record, decision and timing rule.
    - firmware/: C, built to assembly and then with the organisers' Makefile;
    out/lane/ holds the delivered firmware (.s, .bin, .txt, .dmp). One loop
    that never waits; Xicrc for every CRC; Zmmul for the clone test.
    - testbe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
2026-09-27 Publish the demonstration page, the report figures, and the Stage 3 README
    - docs/demo/index.html: the LaneX replay page as one self-contained file, for
    GitHub Pages (https://niccc8.github.io/rvbl2-riscv-cpu-core/demo/). It
    replays the chip's own records, recomputes every CRC-16 and Chaskey-12 tag,
    and plays each ./emu line through the FPGA registers to the chip's pins.
    Built by application/replay/gen_lane_replay.py --standalone.
    - report-stage3/figures/: the report's screenshots and our architecture
    drawings of rvbl2_soc and top (SVG and PNG), which the report links to.
    - README.md: LaneX, the Submission Guide section 9 checklist, the brief step
    by step, where the organisers' th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
2026-09-29 Point to the application's assembly, and correct stale figures in the READMEs
    - README.md and application/firmware/README.md name the application in
    assembly, out/lane/asm/main.s, next to the binary, and the firmware README
    now explains how to read it: the function order, the Xicrc instructions as
    GCC writes them (.insn), the clone test's multiplies, and the peripheral
    base addresses.
    - The firmware README states the self-test's own figures (1,545
    instructions, SELFTEST PASS 82, and the 11 checks tb_selftest makes on its
    transcript), the measured worst-case byte wait (199 cycles, not "about
    250"), that the tag hash uses mul only where GCC keeps it, and that the
    build is repro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
2026-09-30 Add the video link, the colour-wired ChipInventor diagrams, and the source archive script
    The README links the video and describes the 8-page report and the source
    archive. scripts/make_stage3_zip.py builds the Stage 3 archive from the tracked
    files of this commit. The tag CRC is inverted with xor, not xori: 0xFFFF does
    not fit a 12-bit immediate.
    [make_stage3_zip.py]
2026-09-30 Keep only the Stage 2 report's figures on this branch, in report-stage2/
    The Stage 2 report and the Phase 2 guide stay on main; the README links
    the report there.
2026-10-10 Stage 4 ground truth: the AWS flow, the organisers' top.sv contract and emu's exact behaviour
    Replaces the Stage 3 AWS notes, with a table of every claim they got wrong.
2026-10-10 Stage 4 audit: findings by severity, priorities and the scope approved at GATE 1
2026-10-10 Stage 4 hand-off notes: state, decisions and next steps
2026-10-10 LaneX protocol v4: clock wrap, full-hotlist report, key lock, counter start, keyed identity
    The Stage 4 audit items approved at GATE 1 (B1, B2, C1, C2, C3, C5a), each in the
    golden model, PROTOCOL.md, the firmware and a directed test:
    - B1: the lane clock follows host time in serial-number arithmetic (RFC 1982), so it
    keeps running through the 32-bit wrap; dedup and sighting eviction use modular time.
    - B2: a hotlist add that finds no slot is reported as E reason 6.
    - C1: once loaded, the key is locked until reset; any later K is refused (E reason 7).
    - C2: K may carry a 32-bit counter start (20-byte payload), so records from before a
    reboot cannot be replayed.
    - C3: with a key loaded,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
2026-10-10 Stage 4: FPGA plan (approved at GATE 2), market research notes and the ROI model
2026-10-10 Stage 4: riscv.sv generator, pre-flight gate (system simulation with the organisers' emu.c, lint, synthesis, timing, mutants), runbook, market synthesis and pitch kit
2026-10-10 Arm the vehicle detector once the lane is seen empty; the AWS F2 build files
    emu releases pin 0 before its own -d and keeps the previous run's pin values, so
    for ~100 ms after reset the presence input floats. If Vivado resolves that to 1,
    the old firmware saw a phantom vehicle and 5 of the 12 emu lines failed. Now the
    pin levels at reset are the baseline: a vehicle already in the zone is not decided
    (its earlier reads are lost, so a record would only accuse it of having no tag),
    and a departure without an arrival is ignored. Model, PROTOCOL.md and firmware
    changed together.
    The emulator preview now plays emu's start-up window faithfully (reset released
    first, pin 0 undriven, stale pins, >=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
2026-10-10 Stage 4 verification: pre-flight GO on afa9698, full-fidelity emu system simulation 15/15
2026-10-10 Stage 4: build at 31.25 MHz (the ASIC's clock), 15.625 MHz kept as a backup; clean-up
    Clock: riscv.sv now divides clk_main_a0 by 8 with the MMCM (31.25 MHz, UART 271),
    the same operating point as the signed-off ASIC. Timing estimate on the synthesized
    netlist: 18.1 ns pessimistic / 11.4 ns typical against 32 ns. riscv_15mhz.sv (MMCM
    /16) and riscv_bufgce_div.sv are pre-verified backups; the pre-flight covers all three.
    sta_estimate.py gains a typical model; the verdict needs >= 25 % pessimistic slack.
    Clean-up: lane_model.py loses the generators for the archived F2 host tool and wrapper
    testbench (outputs unchanged); run_all.sh replaces its dead Stage 4 section with the
    pre-flight (RUN_STAG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
2026-10-10 Stage 4 clean-up: final docs (verification, runbook, state), evidence logs, MAX 10 prototype scope; ChipInventor export check knows the Stage 3 ROM
2026-10-10 Stage 4: full regression green on the final state (run_all 34/34, run_ci all checks, full-fidelity emu 15/15); demo page rebuilt with v4 transcripts
2026-10-10 Stage 4: AWS build result (afi-0732c3cb90c96019a): 0 errors, MMCM and PC readback accepted, WNS -0.112 ns only on the pin-synchroniser crossing
2026-10-10 Stage 4: LaneX runs on the AWS F2 FPGA - bring-up ladder and all 12 emu lines pass on the first build
2026-10-10 Stage 4: AWS F2 run screenshots with an index for the pitch slides (account number redacted; the recording stays local)
2026-10-10 Stage 4 state: point to the AWS run screenshots
2026-10-10 Stage 4: DE10-Lite desk-lane plan (Tier 1, with host-link fallbacks) and the Quartus Prime Lite setup guide
2026-10-10 Stage 4: DE10-Lite desk lane - the AWS chip and ROM on a MAX 10 with one ultrasonic sensor, lamps and the LaneX Live dashboard
    - gen_de10lite.py builds the chip with the AWS generator's own code (chip_modules, target de10lite:
    pad tri-state resolved in fabric, M9K byte-lane RAM), the board tables from lane_model.py, the
    Quartus project, the wiring card and the dashboard; the three AWS files regenerate byte-identical
    - lanex_board.v: HC-SR04 height sensing (car/lorry by height), tag-reader emulator, frame builder,
    one ordered channel into the chip, laptop link, tour mode (the 12 AWS emu lines -> PASS12),
    record decoder, displays, lamps, buzzer
    - Verified: check_board.py 623 checks (th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
2026-10-11 Stage 4: DE10-Lite after the first board test - steady tour, clearer decisions, hardened recovery, exhaustive simulation, lab brief
    - Tour: each line shown as latched, paced phases (tESt nn 0.5 s, its result and lamps 0.9 s);
    the flicker Nicholas saw (a 5 ms tESt flash between results) is gone and reproduced by the new
    real-speed test on the previous design
    - Decisions: word 1.5 s, then the fare 2.5 s; alarms blink lit-first; warm boots hold the picture
    until the chip's identity; a leaving vehicle's height stays until its decision
    - Recovery: sensor lost under a vehicle (1 s), chip watchdog (1.5 s, warm boot), KEY0 held 20 ms,
    the host's wait after an identify frame
    - check_board.py: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
2026-10-11 Stage 4: Grand Final pitch - native PowerPoint deck with generated 3D models and Morph, the script, and the demo-day guide
2026-10-11 Pitch: sharper barrier, detailed car and lorry resting on the road, script for five speakers
2026-10-12 Desk lane: a printed MLFF gantry for the HC-SR04 - one A1 plate, wedge-locked feet, cabinet tray, fit test, checked CAD and G-code
2026-10-12 Gantry: sensor pod rebuilt from the fit test (crystal across, chips to the ends, upright header), roomier tolerances, tray places from real outlines; all checks over 10 sensor variants
2026-10-12 Gantry: keep OrcaSlicer's log inside out/
2026-10-12 Gantry: close-up previews of the sensor pod and the cabinet tray
2026-10-14 DE10-Lite round 3: no phantom vehicles on a noisy sensor, a tone for passive buzzers, UC00C wiring
    Nicholas's bench (E5): an empty lane showed 1.6 cm "vehicles" and decided NO TAG
    over and over. The floor was the farthest reading seen, so one stray far echo
    made it ~16 mm too far. The lane now takes the median of three readings, learns
    the floor by agreement, arms only after it has seen that floor (a floor learnt
    too far can never make a vehicle, and is replaced within a second), and treats
    a farther-than-floor reading as a lost echo that neither starts nor ends anything.
    tb_board.v gains a noisy HC-SR04 (jitter, lost and stray echoes, misses,
    time-outs, spikes); on it the previous design m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
2026-10-15 Stage 4: the desk lane works on the board; leaner lane logic, docs brought up to date
    Nicholas's DE10-Lite now runs the whole desk lane: vehicle detection with the
    HC-SR04, the four lamps, the buzzer, and the USB-UART link to LaneX Live.
    The lane block names its lost-echo test once (beyond) instead of three times,
    and the tour player loses a port nothing read (in_line = !done): 15,372 LEs
    (70 fewer), setup slack +4.436 ns, hold +0.332 ns. Re-verified: full pass
    1,261, stress 286, real-speed 54 checks, 0 failed.
    README, 06 (round 3 board result), 07 (the sensor rules, the passive buzzer's
    tone pin), HANDOFF (a corrupted install path) brought up to date. The pitch
    material stays local: the r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
